atarijookie/cosmo2ex/ce_pico_fdd/readme.md

# CosmosEx pico - floppy drive version

- Raspberry Pi Pico 2 W, network over WiFi
- core 1 streams the floppy data (MFM) to the Atari and captures the written sectors, core 0 does WiFi / host
  communication - the WiFi chip and lwIP run in the background (IRQ) on core 0, core 1 is free for the floppy

## Compiling under Linux

- from the repo root: `firmware/build.sh ce_pico_fdd`, needs just docker - see firmware/README.md
- the result is firmware/out/ce_pico_fdd.uf2

## Compiling under Windows and Arduino env

- install https://github.com/earlephilhower/arduino-pico into Arduino boards via:
> Tools -> Board -> Boards Manager

(The firmware was developed using Raspberry Pi Pico Arduino core version 5.4.2)

- open ce_pico_fdd/ce_pico_fdd.ino

## Arduino env settings

(the Linux build uses the same settings, keep them in sync with FQBN_FDD in firmware/compile.sh)

- board: Raspberry Pi Pico 2W
- CPU architecture: ARM
- debug level: None
- debug port: Disabled (this is only for the debug of the arduino core; debug strings don't use it, see Notes)
- C++ exceptions: disabled
- flash size: 4MB (no FS)
- CPU speed: 150 MHz (the MFM stream and write capture dividers are calculated from the clock, so other speeds keep the timing)
- IP/Bluetooth stack: IPv4 Only
- optimize: Small (-Os) (standard)
- Operating system: None (with FreeRTOS lwIP would run in its own task, and the cores would be shared)
- Profiling: Disabled
- RTTI: Disabled
- Stack Protector: Disabled
- Upload method: Picoprobe/Debugprobe (CMSIS-DAP)
- USB stack: Pico SDK - not "No USB": the firmware doesn't use USB, but with "No USB" the WiFi connection to the host
  stalls (the host gets almost nothing from the device and drops it after 15 s of silence), cause not found yet
- WiFi region: Worldwide

## Front panel

- the display and buttons are on a separate front panel (ce_pico_display, RP2040-Zero), connected over UART on GP16
  (TX) / GP17 (RX) - see ce_pico_display/protocol.md; panel.cpp has the panel logic, panel_uart.cpp the PIO UART
- button on GP1 (to 3.3V through 1k, 4k7 pull-down - instead of the unused debug UART RX, the debug output on GP0
  stays): hold it for 1 s until it beeps and the LED goes light blue, then release it - the release starts the captive
  portal (WiFi setup), or leaves it without saving; a shorter press does nothing. A long press of enter on the front
  panel does the same right at the long press. Not while the portal is scanning the networks, it can't be left then
- browsing the images (image_browser.cpp): left / right on the front panel show the previous / next floppy image in the
  folder of the current one (wraps around at the ends), with its index (`< 123/3720 >`); enter inserts it, 15 s without
  a key goes back to the current image. Same list and order as the prev / next in the web UI: only .st / .msa / .stx, sorted
  case insensitive. The host (ce_cores/fdd/imagelist.cpp) sends the list in pages of 16 names, only after the device
  asks for it (with the panel attached), and sends the page again when images are added / deleted / renamed in the
  folder or the current image changes - the protocol is in image_browser.h. Not for the special images (no folder);
  without an image in the drive it browses FLOPPY_IMAGES_DIR (.env) - e.g. the images from
  atari-st-floppy-image-downloader.

## Built-in floppy

- until the first real image from the host is loaded completely (no WiFi settings yet, joining the WiFi, looking for /
  connecting to the host, loading the image, or the host has no image in the drive), the ST sees a built-in floppy:
  single sided 80 x 9, write protected (writes to it are dropped, never sent to the host)
- also again when the WiFi setup (captive portal) starts while the real image is shown - the host connection is closed
  for it anyway; after the setup the image is loaded again and the ST gets it as after the start
- its executable boot sector shows the device status on the ST, refreshed once a second, and keeps waiting for the
  real image until SPACE is pressed (other keys are ignored); while the WiFi setup runs, it tells how to open the setup
  page;
  A:\CE_FDD.TOS does the same when started from the desktop (e.g. when booting from a hard disk). Once the real image
  is loaded, they show 'The floppy image is ready. Reset your ST to boot from it.'
- the status is also a text file in the root, named after it: SETUP.TXT, NO_WIFI.TXT, WIFI.TXT, HOST.TXT, LOADING.TXT,
  NO_IMAGE.TXT - a disk change is signalled when the name changes, so the desktop shows the new one after Esc
- the boot code reads the status from track 0, sector 10 (outside of the file system, the BPB says 9 sectors per
  track): 'CE2XSTAT', status code, change counter, the text from offset 16
- the tracks are made on the device (builtin_image.cpp) into their own PSRAM area, so the real image is received into
  its usual area meanwhile and the switch happens only when it's complete; track 0 is made again on each status change
- it's made in setup(), before the main loop, which blocks for seconds while joining the WiFi - the ST reads the boot
  sector a few seconds after the power on; a disk change follows, so a ST that read the drive even earlier reads it again
- debug log: 'builtin floppy: ...' lines for the start, each status change and each new track 0; 'core 1: streaming the
  real image now' after the switch; BUILTIN in the floppy status line (FDD_STATUS_LOG)
- testing: BUILTIN_IMAGE_TEST 1 in defs.h shows all the statuses in a loop (sample values, 8 s each, then 8 s without the
  status sector) and never switches to the real image
- the disk content comes from builtin_floppy/: status.s (68000 code of the boot sector and CE_FDD.TOS) and
  make_builtin.py, which assembles it (m68k-atari-mint-as) and writes builtin_floppy_data.h (committed - Arduino can't
  run it) and builtin_floppy/builtin.st (the same disk with a sample status, for an emulator or mtools). Run
  `python3 builtin_floppy/make_builtin.py` after changing them

## Status LED (neopixel)

- LED2 (WS2812C-2020) on the same GP1 as the button, through the AND gate IC6 (74AHCT1G08, 3.3V -> 5V levels); the
  pin is the button input all the time and the PIO output only for the ~0.6 ms of a frame (neopixel_pio.cpp) - that
  works also while the button is held
- the same colors as ce_pico_hdd: orange during init, brighter with each step (setup, core 1 running, joining WiFi,
  looking for the host, connecting to it); green when connected with an image, dim white when connected without one;
  blue while the captive portal runs; light blue while the button is held long enough to release it
- red blinks on error, the count of blinks is the code, then a pause: 1 = PSRAM not working (halted), 2 = no WiFi
  settings and the WiFi setup failed to start (retried every 10 s), 3 = can't join the WiFi (keeps retrying)
- the color is sent only when it changes, on core 0 - nothing while it stays the same, so the floppy streaming
  (core 1) doesn't lose any cycles; after a button press it's sent once again, as the LED saw the press as a long H
- neopixel.cpp - the status and the colors (tested on the host)

## Beeper

- on GP27 (H = on), a buzzer with its own generator - the firmware only switches it on / off, it's on the FDD board
  (not on the front panel), so it works without a panel too
- a 100 us click on every head step (`BEEP_STEP_US` - started in the STEP ISR, only with the motor on, ended by a timer
  alarm on core 1, so a seek is a hum of separate clicks like a real drive, not one long tone), 50 ms when an image is loaded, 100 ms
  when the host connects, 200 ms on a long press of the button, 400 ms when the host is lost
- the click on head step can be switched off (`beepOnStep` in the settings, on by default): the checkbox on the WiFi
  setup page, or 'Beep on every floppy head step' on the floppy page of the web UI - see Device settings below
- beeper.cpp - core 1 owns the pin and ends all the beeps in its loop, core 0 only asks for them

## IKBD (keyboard + mouse)

- the board is in the keyboard -> ST path (SV1): KEYB_TX_ORIG (GP9, from the keyboard) and KEYB_TX (GP8, to the ST) on
  uart1, KEYB_RX (GP18, the ST's commands to the keyboard, only listened to) on a PIO receiver - all 7812 baud
- IKBD disabled, or no connection to the host: the uart IRQ passes the keyboard data straight to the ST (at most ~4 ms
  later), even while the main loop is busy (joining the WiFi, connecting)
- IKBD enabled (`ikbdEnabled` in the settings - on by default, the checkbox on the WiFi setup page, or on the IKBD page
  of the web UI - see Device settings below) and connected to the host's ikbd port: the keyboard data and the ST
  commands go to the host, tagged (0xBB / 0xAA, keep alive 0xEE once a second), what the host sends goes to the ST
- ikbd.cpp, the same protocol as ce_pico_hdd

## WiFi setup (captive portal)

- the FDD scans the WiFi networks, then starts an open AP `cosmo2ex` (192.168.42.1) - connect a phone or PC to it,
  the setup page opens by itself (every DNS name and URL leads to it), or open http://192.168.42.1
- the page has the WiFi name (with the scanned networks offered) and password; an empty password keeps the stored one
  for the same WiFi name, otherwise it means an open network; both max 31 chars, the password at least 8 (WPA2);
  and checkboxes for IKBD (keyboard and mouse via the host) and the beep on head step; with WiFi settings already stored, the page also has
  'Quit WiFi setup without saving' - back to normal operation with the stored settings
- Save stores them to EEPROM (the floppy streaming pauses for the flash write), then the FDD goes back to the normal
  mode and connects with them right away
- without a page request for 5 minutes, the portal ends with the old settings
- with no WiFi settings stored (first start), the portal starts by itself and stays - no timeout, and the long press
  doesn't leave it - until the settings are saved
- the Pico can't be an AP and a station at once - the host connection is down while the portal runs, core 1 keeps
  streaming the current image
- captive_portal.cpp - AP, DNS and web server (arduino-pico WiFi, DNSServer, WebServer); portal_form.cpp - the pages
  and the checks of the entered values (tested on the host)

## Device settings (IKBD, beep on step)

- stored on the device (EEPROM, `Settings_t` - the fields after `ikbdEnabled` get their defaults when stored by older
  firmware, see `SETTINGS_LAYOUT`), changed on the WiFi setup page or in the web UI
- the device reports them in every FW report (heartbeat, byte 12 of its data: DEV_SETTING_* flags), the host (ce_cores)
  stores them as FDD_IKBD_ENABLED / FDD_BEEP_ON_STEP in the device's settings - when they change on the device, and on
  connect (the device's settings are the truth then)
- the web UI writes those settings and asks the core to send them: ATN_DEVICE_SETTINGS (0x08) with the flags; changed
  while the device wasn't connected (FDD_SETTINGS_PENDING) - sent when it connects, the web UI wins then
- the device stores them only when they changed - the flash write pauses the floppy streaming for a moment

## LED color while running

- green by default, can be changed on the web Settings page (color + brightness) - global for all floppy devices
- the host sends it (ATN_LED_COLORS 0x09, R G B) after the FW report on each connect and when changed in the web UI
- stored in EEPROM (`Settings_t.ledRunning` + `ledCheck` - not matching on a new board / after older firmware: the
  default is used), only when it differs from the stored one

## Notes

- debug strings: debug() writes directly to uart0 on GP0 (TX0), 115200 baud. They're on by default, DEBUG_STRINGS 0 in
  defs.h turns them off. Once the 32 byte UART FIFO is full debug() waits (~87 us per char), so don't call it from IRQs
  or the floppy streaming
- crash / reset diagnostics (diag.cpp) on the same UART: at boot the boot count since power on and the reset reasons;
  on a hard fault (also a panic() without a debugger) the core, pc / lr and the fault status, then that core stops -
  find the pc in the .elf of the same build, e.g. arm-none-eabi-addr2line -f -C -e ce_pico_fdd.ino.elf <pc>
- the PIO headers (mfm_write.pio.h, neopixel.pio.h, uart_rx.pio.h) are generated by pioasm and committed, arduino
  doesn't run pioasm - after changing a .pio file, regenerate them with `firmware/pioasm.sh ce_pico_fdd`
- settings are stored with the EEPROM library (flash sector before the last one)
- connecting to WiFi and to the host blocks the core 0 main loop for a few seconds at most - core 1 (floppy) is not affected

## License

Open design, non-commercial license - see the License section of the [main README](../README.md#license).
