atarijookie/cosmo2ex/ce_pico_hdd/readme.md

# CosmosEx pico - HDD version (ACSI or SCSI)

- for the merged board devices/v40_pico_hdd - one PCB, assembled either as ACSI or as SCSI variant
- one firmware for both: on boot it reads the variant strap on GP26 (R125 pull-up = ACSI, R225 pull-down = SCSI)
- based on W6100-EVB-Pico (to simplify soldering)
- the older v40 boards (devices/v40_pico_acsi, devices/v40_pico_scsi) have a different pinout, they need ce_pico_hdd_acsi / ce_pico_hdd_scsi

## Status LED (neopixel)

- orange - initializing, brighter with each step: setup started, bus handling running, waiting for ethernet link + DHCP, got IP, looking for / connecting to host
- green (ACSI) / blue (SCSI) - connected to host, the color shows which variant the board runs
  - both colors (and brightness) can be changed on the web Settings page - global for all devices. The host sends them
    (CMD_LED_COLORS, ACSI R G B + SCSI R G B) after the ACSI config on each connect and when changed; the device stores
    them in EEPROM (TSettings.ledAcsi / ledScsi, own check byte - garbage = defaults) only when they differ
- red blinks - error, the count of blinks is the error code, then a longer pause:
  - 1 - ethernet chip not found (halted)
  - 2 - ethernet cable not connected (keeps retrying)
  - 3 - no IP from DHCP (keeps retrying)
  - 4 - PIO setup failed (halted)

The LED gets updated only between commands, when its color changes. ACSI sends the data on GP9
(IC6 gate held open by R151). SCSI sends it on OUT_LE1 (IC6.A) with OUT_LE2 (IC6.B) as the gate - the firmware never has both
H except for the LED update, so the bus activity doesn't get to the LED. On SCSI the device ignores the bus until it's
connected to the host (the Atari doesn't see the drive till then).

## Network for STinG

`sting_net.cpp` answers the HOSTMOD 7 (`HOSTMOD_RAW_NET`) ACSI / SCSI commands of the STinG driver `CE_ETH.STX` itself,
without the host. It sends / receives raw ethernet frames on W6100 socket 0 (MACRAW), with its own MAC address for STinG,
and does ARP for it. The other sockets (HDD, IKBD, UDP) keep working as before. Protocol and details: [ce_sting_stx_driver/README.md](../ce_sting_stx_driver/README.md).

The MiNTnet driver [CE_ETH.XIF](../ce_mintnet_xif_driver/README.md) uses the same commands in frame mode: whole ethernet frames, ARP is done by MiNT.

## Compiling under Linux

- from the repo root: `make firmware` (or `firmware/build.sh ce_pico_hdd`), needs just docker - see firmware/README.md
- the result is firmware/out/ce_pico_hdd.uf2

## Compiling under Windows and Arduino env

- install https://github.com/earlephilhower/arduino-pico into Arduino boards via:
> Tools -> Board -> Boards Manager

(The firmware was developed using Raspberry Pi Pico Arduino core version 5.4.2)

- symlink the (patched) Ethernet library from third_party/Ethernet into Arduino libraries dir:

> mklink /D "C:\Users\jookie\Documents\Arduino\libraries\Ethernet" "C:\!miro\hobby\github\cosmo2ex\third_party\Ethernet"

## Arduino env settings

(the Linux build uses the same settings, keep them in sync with FQBN in firmware/compile.sh)

- board: Raspberry Pi Pico
- debug level: None
- debug port: disabled
- C++ exceptions: disabled
- flash size: 2MB (no FS)
- CPU speed: 133 MHz
- IP/Bluetooth stack: IPv4 only
- optimize: Small (-Os)
- Operating system: None
- Profiling: Disabled
- RTTI: Disabled
- Stack protection: Disabled
- Upload method: Picoprobe / Debugprobe (CMSIS-DAP)
- USB stack: No USB

## License

Open design, non-commercial license - see the License section of the [main README](../README.md#license).
