atarijookie/cosmo2ex/devices/v40_pico_fdd/fdd_case.stp

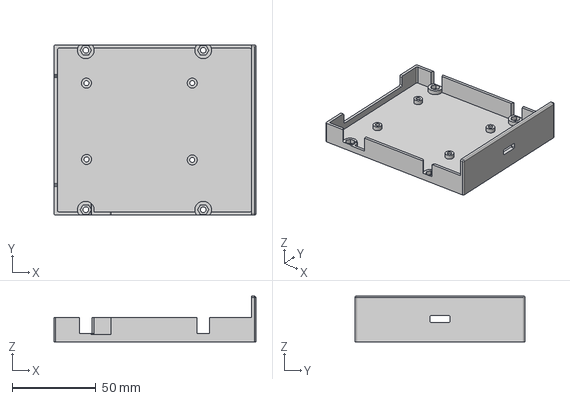
[picture p1: CAD file, 2026-11-12]
devices/v40_pico_fdd/fdd_case.stp
120.5 x 101.6 x 27.4 mm
