atarijookie/cosmo2ex/devices/v40_pico_hdd/hdd_case.stp

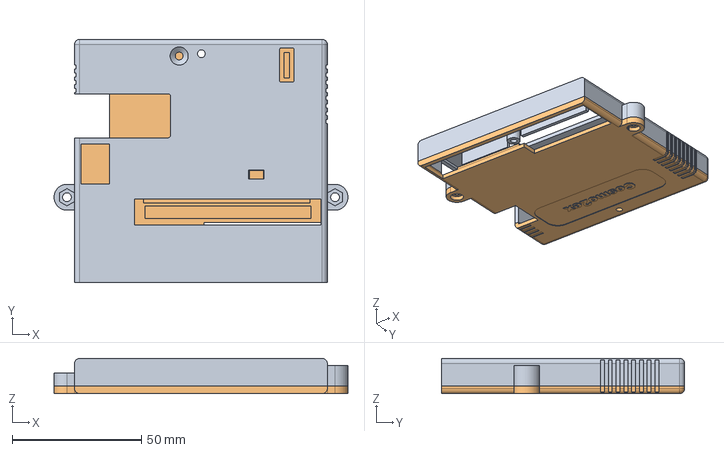
[picture p2: CAD file, 2026-11-12]
devices/v40_pico_hdd/hdd_case.stp
113.6 x 94.0 x 13.6 mm
