atarijookie/cosmo2ex/devices/v40_pico_hdd/hdd_case_back.stl

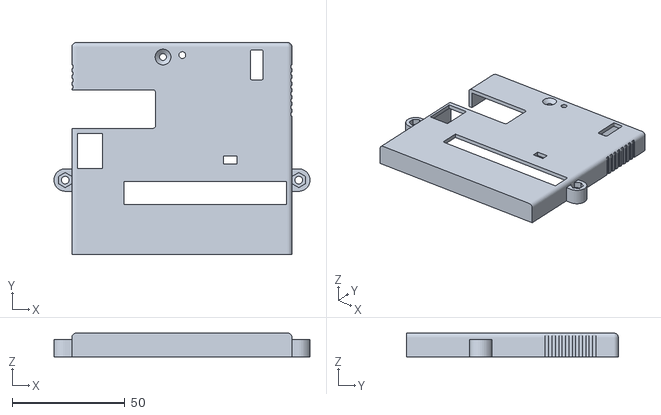
[picture p3: CAD file, 2026-11-12]
devices/v40_pico_hdd/hdd_case_back.stl
113.6 x 94.0 x 10.6
