atarijookie/cosmo2ex/devices/v40_pico_hdd/hdd_case_front.stl

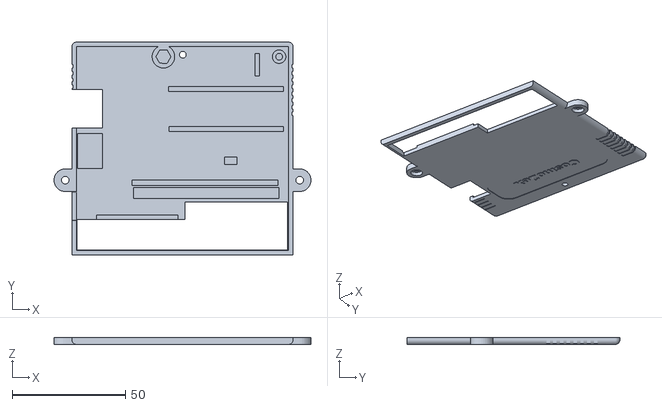
[picture p4: CAD file, 2026-11-12]
devices/v40_pico_hdd/hdd_case_front.stl
113.6 x 94.0 x 3.00
