atarijookie/cosmo2ex/(list of files, cad)

Other CAD files:
devices/v40_pico_fdd/fdd_case.f3d
devices/v40_pico_fdd/fdd_case.stl
devices/v40_pico_hdd/hdd_case.f3d
