atarijookie/cosmo2ex/devices/pico_display_hub75/rp2040zero_display_encoder.brd

## EAGLE design devices/pico_display_hub75/rp2040zero_display_encoder.brd (2026-11-10)

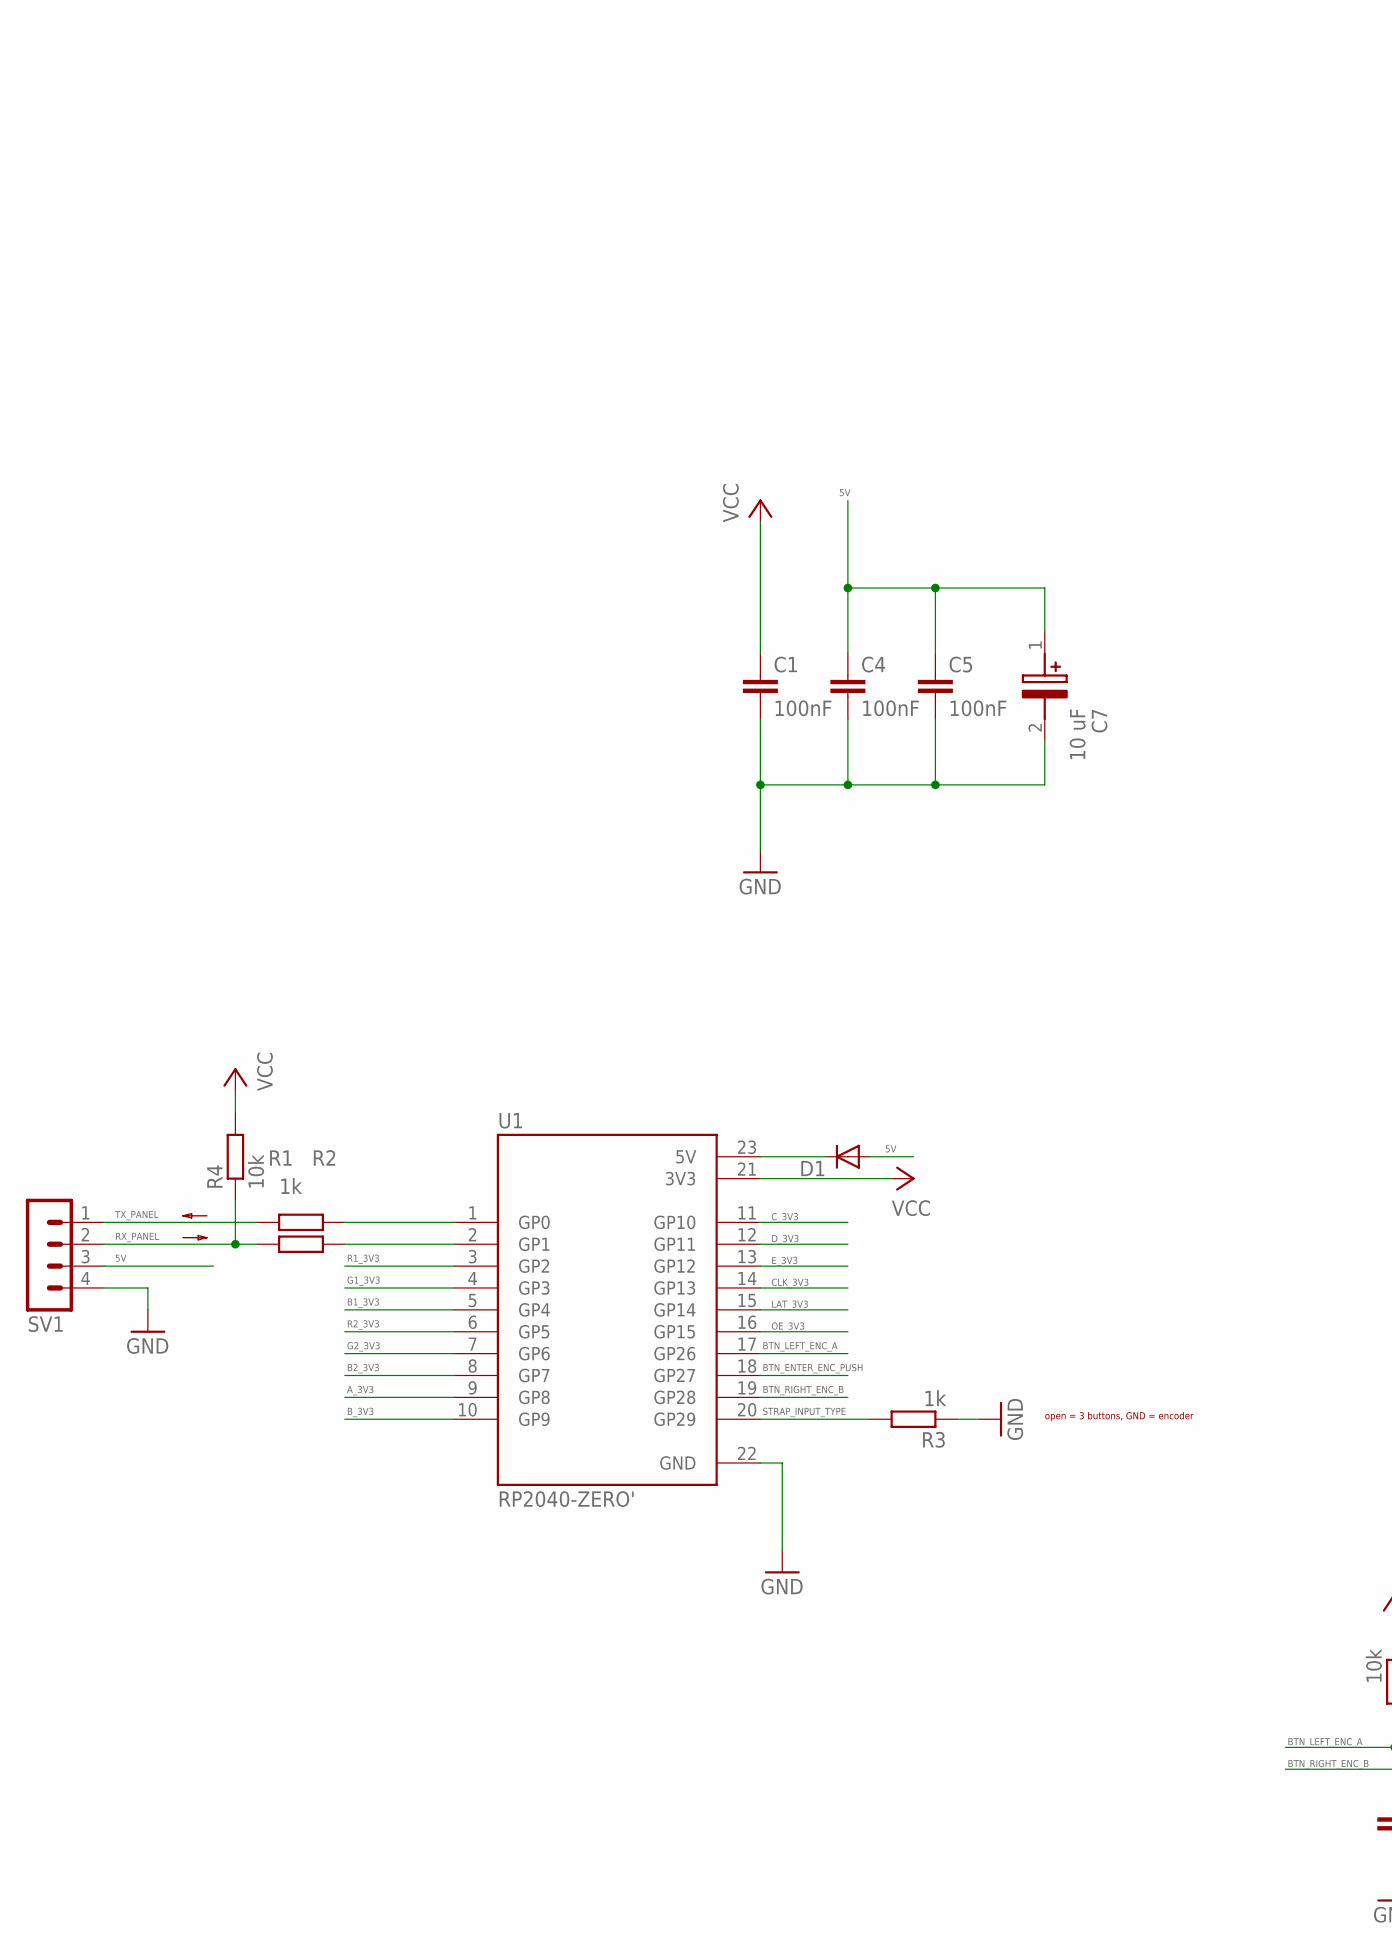
[picture p5: schematic rp2040zero_display_encoder.sch, part in row 1, column 1]

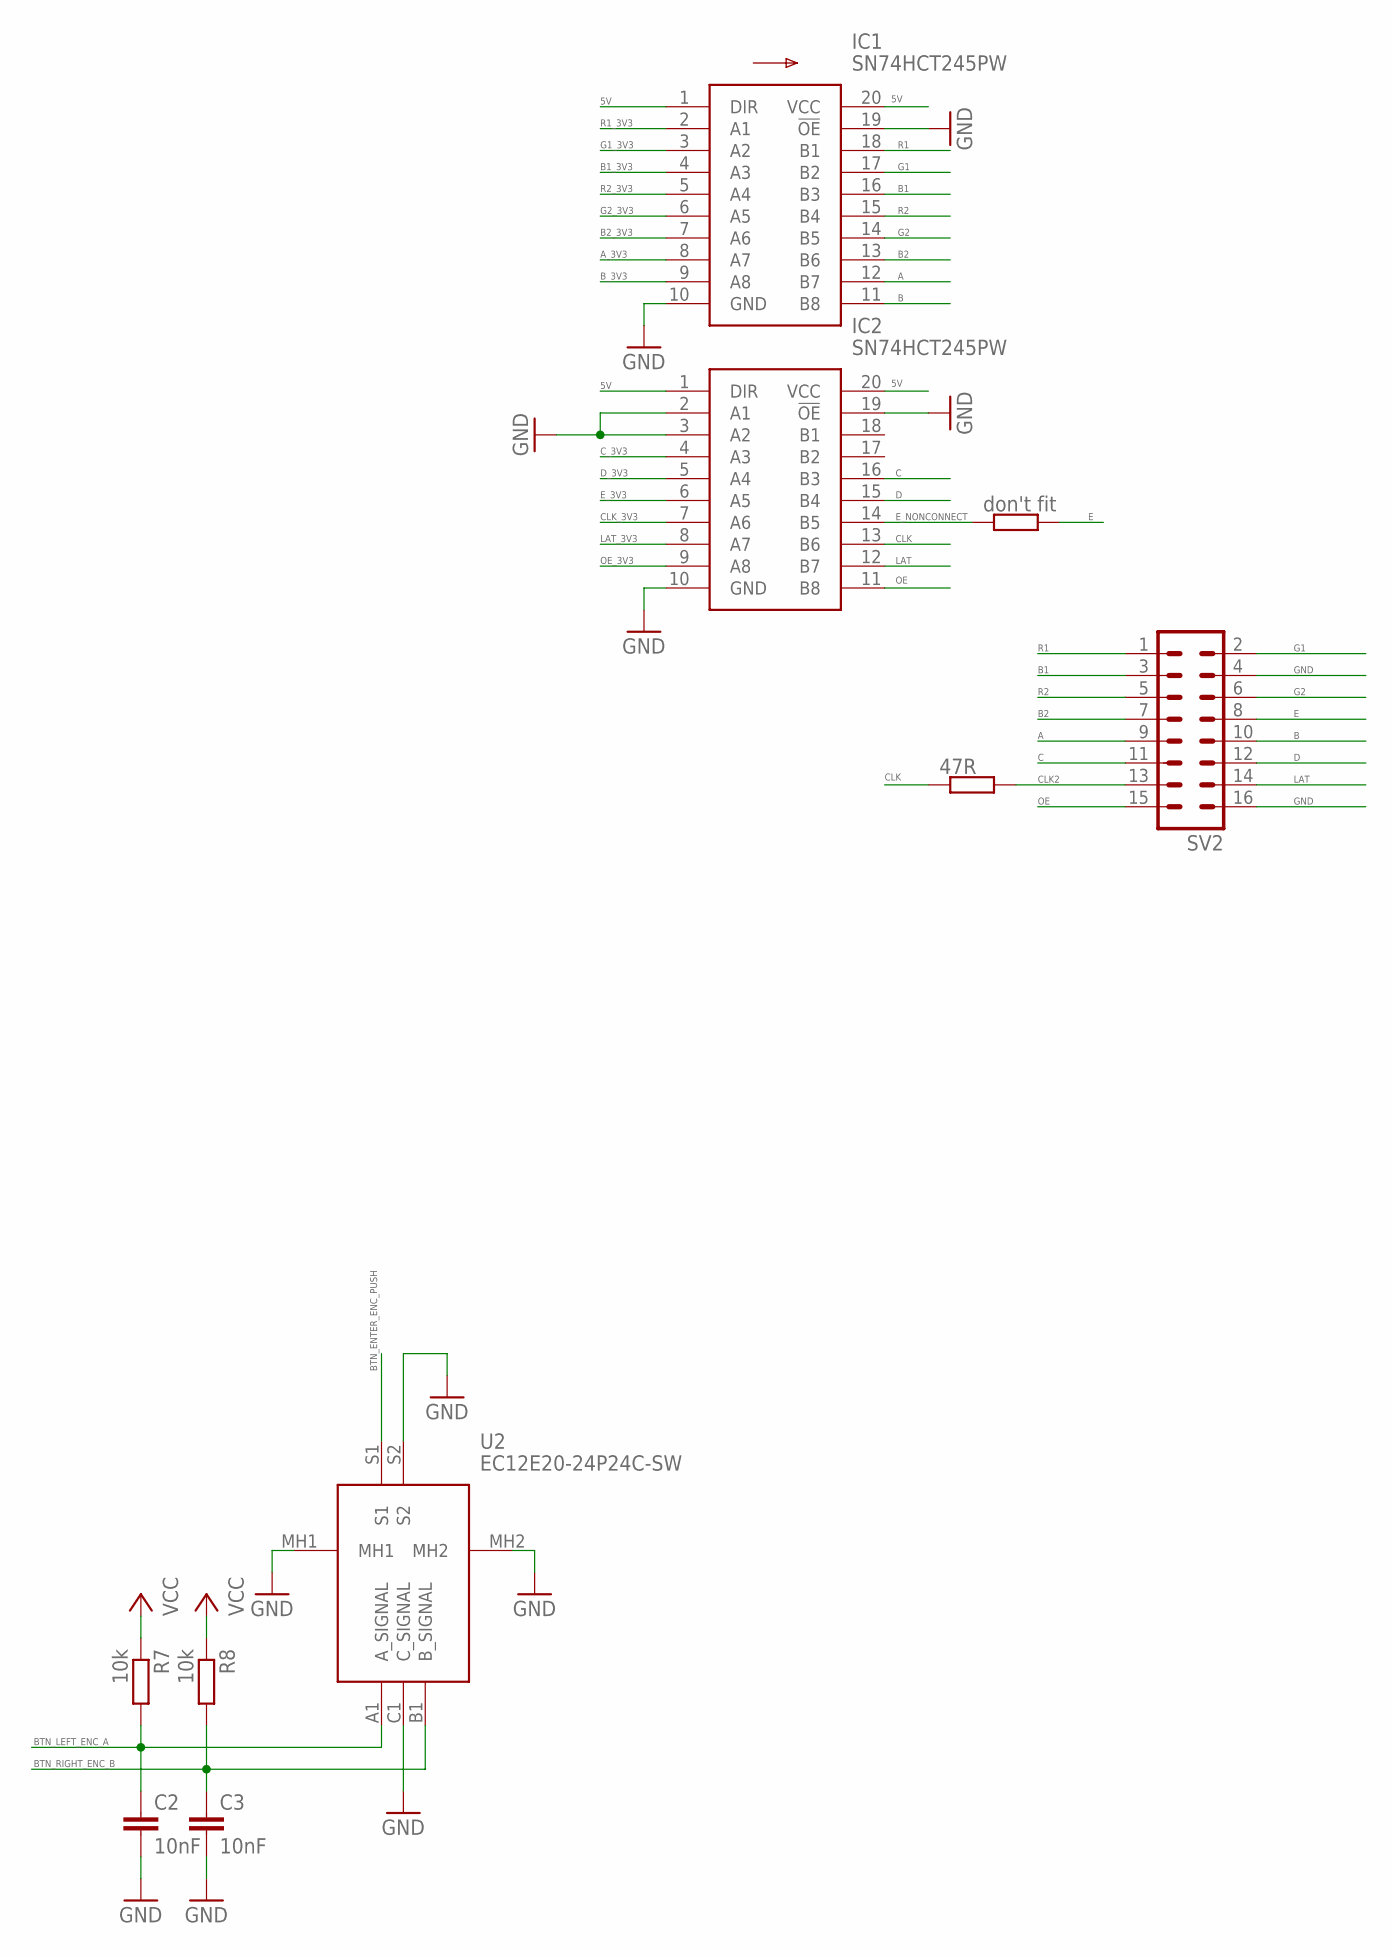
[picture p6: schematic rp2040zero_display_encoder.sch, part in row 1, column 2]

Parts:
C1, C4, C5: 100nF; C0603
C2, C3: 10nF; C0603
C7: 10 uF; CAPPM3528X210N
D1: SK110-DIO; DO214AC
IC1, IC2: SN74HCT245PW; SOP65P640X120-20N
R1, R2, R3: 1k; R0603
R4, R7, R8: 10k; R0603
R5: don't fit; R0603
R6: 47R; R0603
SV1: MA04-1
SV2: ML16
U1: RP2040-ZERO'; MODULE_RP2040-ZERO
U2: EC12E20-24P24C-SW; EC12E2024P24CSW

Connections:
5V: C4.1, C5.1, C7.1 (+), D1.A, IC1.1 (DIR), IC1.20 (VCC), IC2.1 (DIR), IC2.20 (VCC), SV1.3
A: IC1.12 (B7), SV2.9
A_3V3: IC1.8 (A7), U1.9 (GP8)
B: IC1.11 (B8), SV2.10
B1: IC1.16 (B3), SV2.3
B1_3V3: IC1.4 (A3), U1.5 (GP4)
B2: IC1.13 (B6), SV2.7
B2_3V3: IC1.7 (A6), U1.8 (GP7)
BTN_ENTER_ENC_PUSH: U1.18 (GP27), U2.S1
BTN_LEFT_ENC_A: C2.1, R7.2, U1.17 (GP26), U2.A1 (A_SIGNAL)
BTN_RIGHT_ENC_B: C3.1, R8.2, U1.19 (GP28), U2.B1 (B_SIGNAL)
B_3V3: IC1.9 (A8), U1.10 (GP9)
C: IC2.16 (B3), SV2.11
CLK: IC2.13 (B6), R6.1
CLK2: R6.2, SV2.13
CLK_3V3: IC2.7 (A6), U1.14 (GP13)
C_3V3: IC2.4 (A3), U1.11 (GP10)
D: IC2.15 (B4), SV2.12
D_3V3: IC2.5 (A4), U1.12 (GP11)
E: R5.2, SV2.8
E_3V3: IC2.6 (A5), U1.13 (GP12)
E_NONCONNECT: IC2.14 (B5), R5.1
G1: IC1.17 (B2), SV2.2
G1_3V3: IC1.3 (A2), U1.4 (GP3)
G2: IC1.14 (B5), SV2.6
G2_3V3: IC1.6 (A5), U1.7 (GP6)
GND: C1.2, C2.2, C3.2, C4.2, C5.2, C7.2 (-), IC1.10 (GND), IC1.19 (!OE), IC2.2 (A1), IC2.3 (A2), IC2.10 (GND), IC2.19 (!OE), R3.1, SV1.4, SV2.4, SV2.16, U1.22 (GND), U2.C1 (C_SIGNAL), U2.MH1, U2.MH2, U2.S2
LAT: IC2.12 (B7), SV2.14
LAT_3V3: IC2.8 (A7), U1.15 (GP14)
unnamed: R1.2, U1.1 (GP0)
unnamed: R2.2, U1.2 (GP1)
unnamed: D1.C, U1.23 (5V)
OE: IC2.11 (B8), SV2.15
OE_3V3: IC2.9 (A8), U1.16 (GP15)
R1: IC1.18 (B1), SV2.1
R1_3V3: IC1.2 (A1), U1.3 (GP2)
R2: IC1.15 (B4), SV2.5
R2_3V3: IC1.5 (A4), U1.6 (GP5)
RX_PANEL: R2.1, R4.1, SV1.2
STRAP_INPUT_TYPE: R3.2, U1.20 (GP29)
TX_PANEL: R1.1, SV1.1
VCC: C1.1, R4.2, R7.1, R8.1, U1.21 (3V3)

Notes on the sheet:
open = 3 buttons, GND = encoder

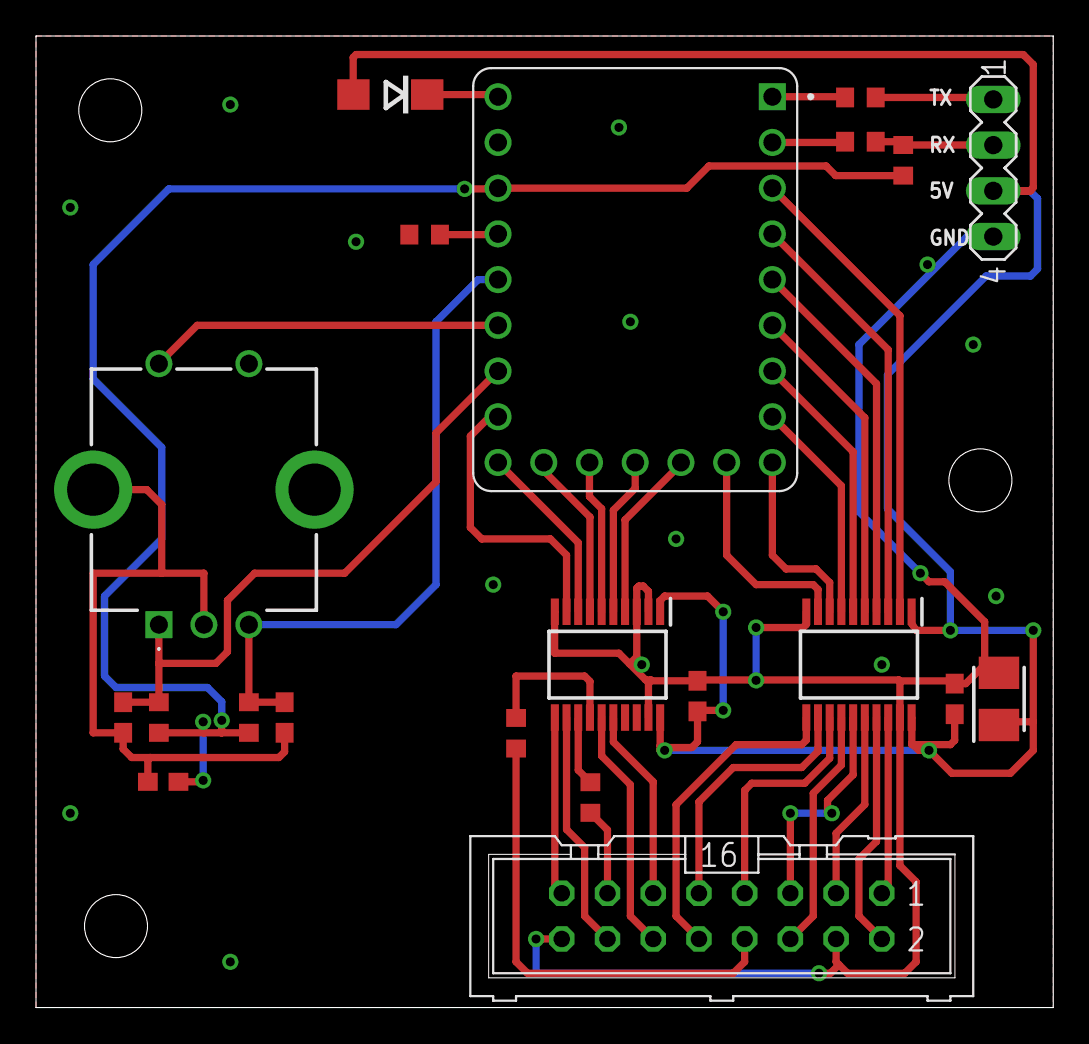
[picture p7: board rp2040zero_display_encoder.brd from above]

Board: 2 copper layers, 56.5 x 54.0 mm, 21 parts (0 on the bottom side), 42 nets.
