atarijookie/cosmo2ex/devices/v40_pico_hdd/ce_hdd_v40.brd

## EAGLE design devices/v40_pico_hdd/ce_hdd_v40.brd (2026-10-31)

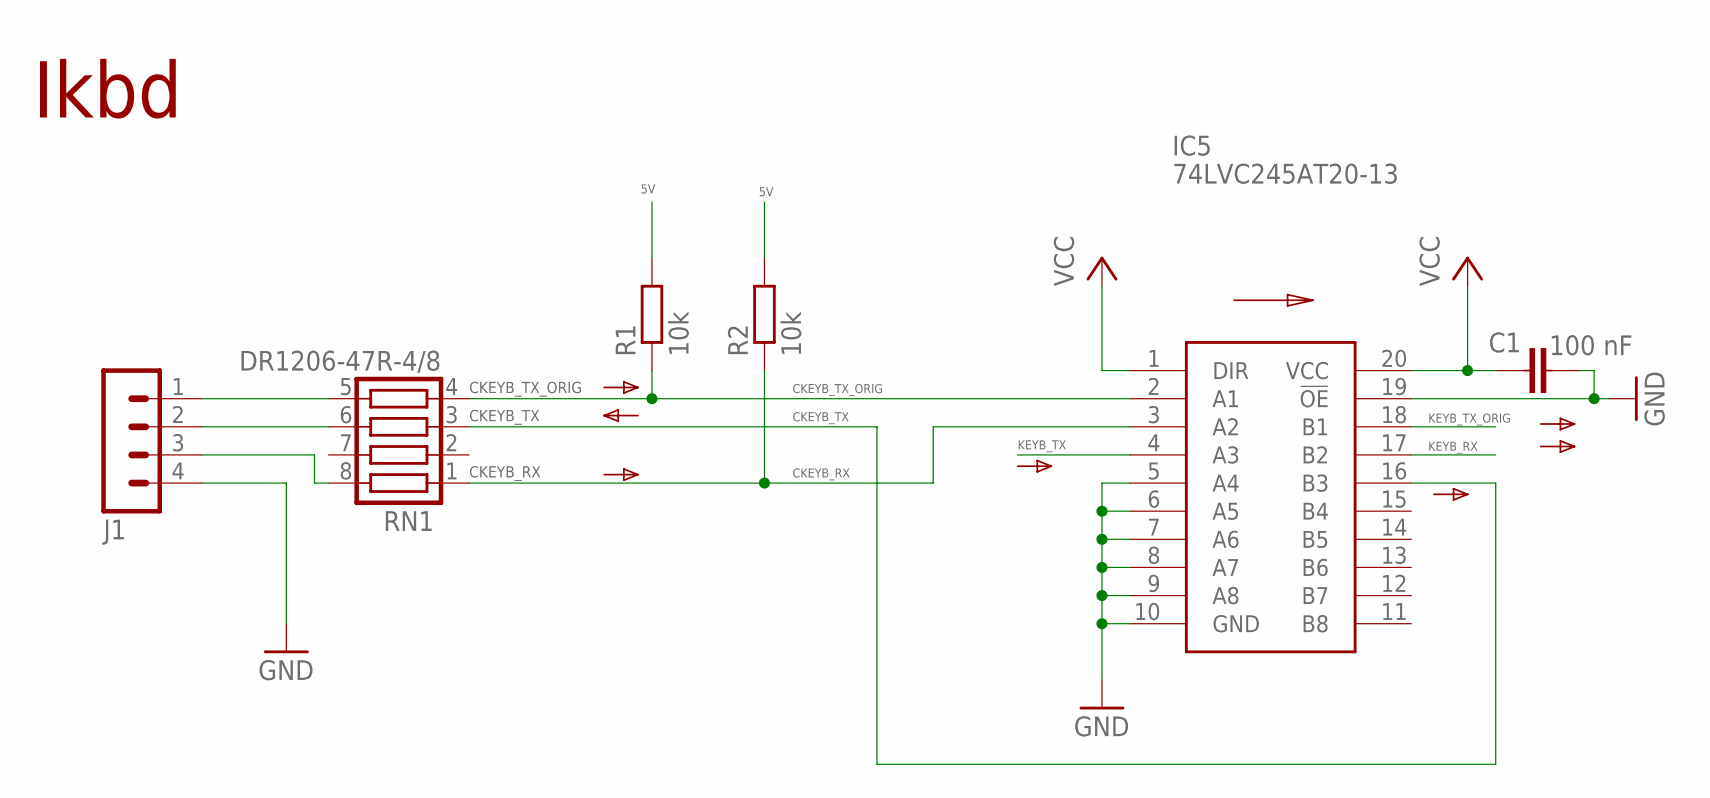
[picture p8: schematic ce_hdd_v40.sch, sheet 1, IKBD part]

Parts:
C1: 100 nF; C0603
IC5: 74LVC245AT20-13; SOP65P640X120-20N
J1: MA04-1
R1, R2: 10k; R0603
RN1: DR1206-47R-4/8; CTS742C083

Connections:
5V: R1.2, R2.2; also elsewhere on the board
CKEYB_RX: IC5.3 (A2), R2.1, RN1.1
CKEYB_TX: IC5.16 (B3), RN1.3
CKEYB_TX_ORIG: IC5.2 (A1), R1.1, RN1.4
GND: C1.1, IC5.5 (A4), IC5.6 (A5), IC5.7 (A6), IC5.8 (A7), IC5.9 (A8), IC5.10 (GND), IC5.19 (!OE), J1.4; also elsewhere on the board
KEYB_RX: IC5.17 (B2); also elsewhere on the board
KEYB_TX: IC5.4 (A3); also elsewhere on the board
KEYB_TX_ORIG: IC5.18 (B1); also elsewhere on the board
unnamed: J1.2, RN1.6
VCC: C1.2, IC5.1 (DIR), IC5.20 (VCC); also elsewhere on the board
ZKEYB_RX: J1.3, RN1.8
ZKEYB_TX_ORIG: J1.1, RN1.5

Notes on the sheet:
Ikbd

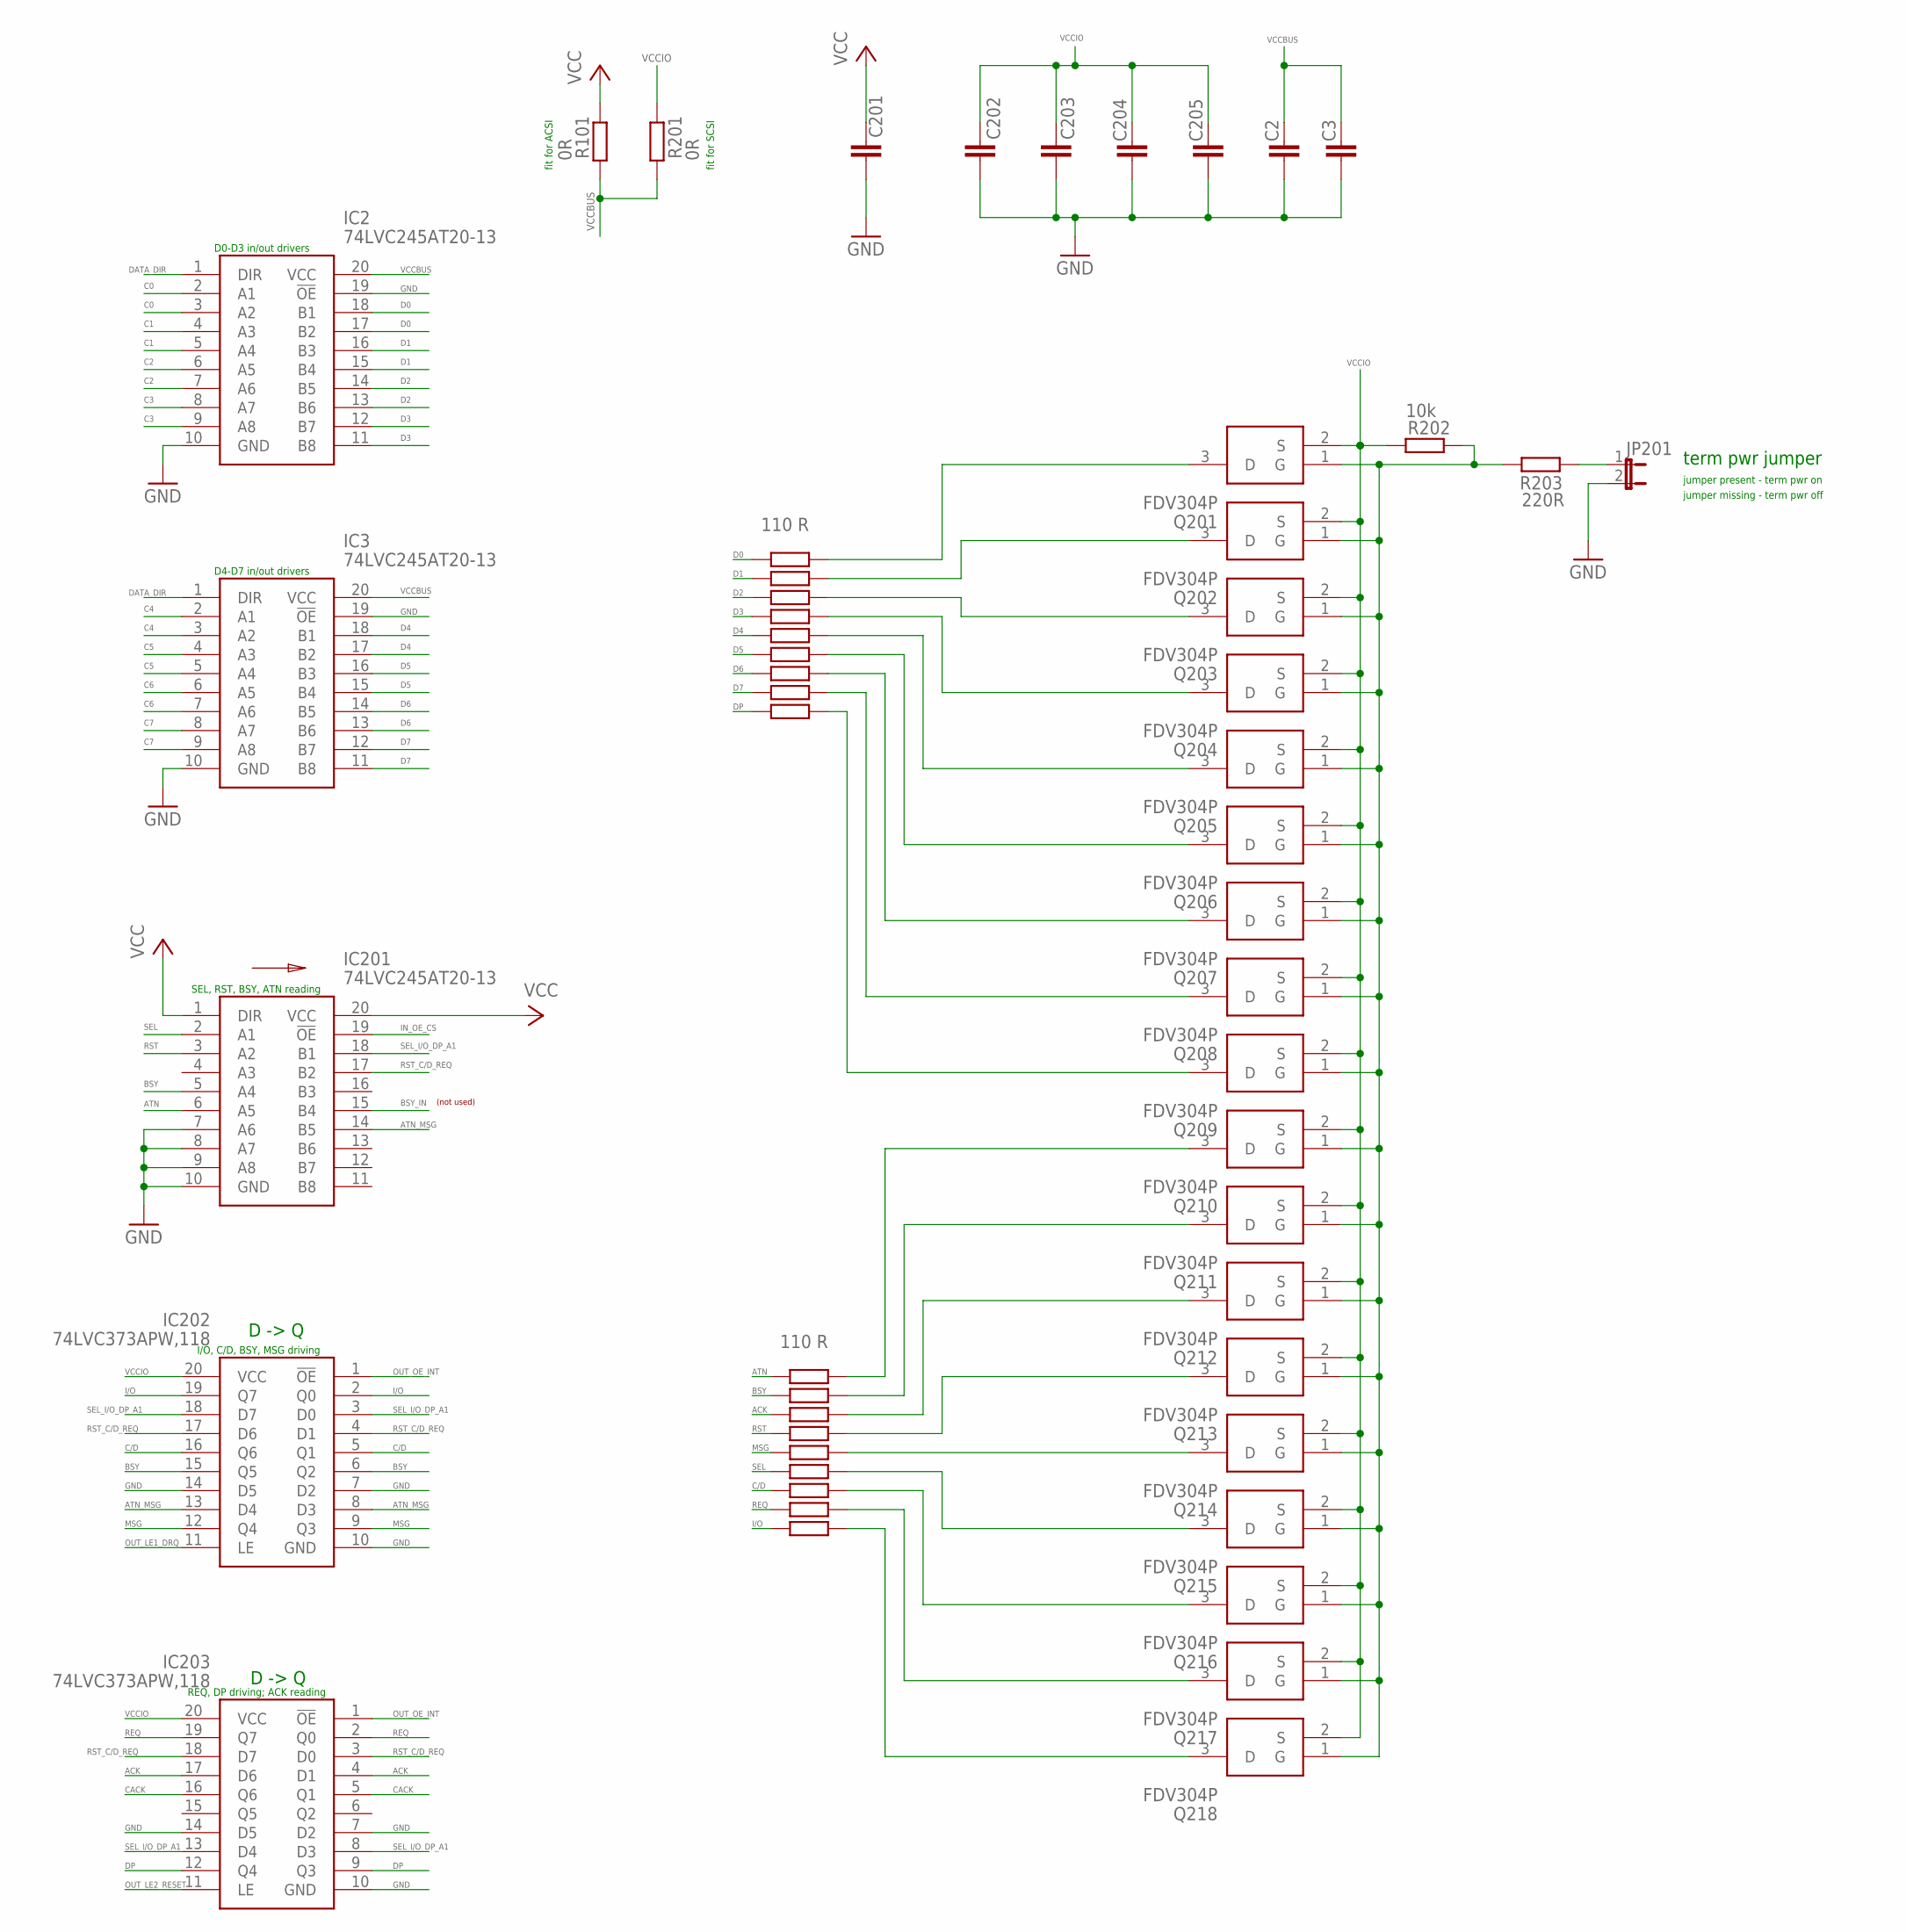
[picture p9: schematic ce_hdd_v40.sch, sheet 2, SCSI drivers and termination]

Parts:
C2, C3, C201, C202, C204, C205: 100 nF; C0603
C203: 1 uF; C0603
IC2, IC3, IC201: 74LVC245AT20-13; SOP65P640X120-20N
IC202, IC203: 74LVC373APW,118; SOP65P640X110-20N
JP201: JP1E; JP1
Q201, Q202, Q203, Q204, Q205, Q206, Q207, Q208, Q209, Q210, Q211, Q212, Q213, Q214, Q215, Q216, Q217, Q218: FDV304P; SOT95P237X112-3N
R101, R201: 0R; R0603
R202: 10k; R0603
R203: 220R; R0603
R204, R205, R206, R207, R208, R209, R210, R211, R212, R213, R214, R215, R216, R217, R218, R219, R220, R221: 110 R; R0603

Connections:
AAAA: Q201.3 (D), R204.1
ACK: IC203.4 (D1), IC203.17 (D6), R215.2; also elsewhere on the board
ATN: IC201.6 (A5), R213.2; also elsewhere on the board
ATN_MSG: IC201.14 (B5), IC202.8 (D3), IC202.13 (D4); also elsewhere on the board
BSY: IC201.5 (A4), IC202.6 (Q2), IC202.15 (Q5), R214.2; also elsewhere on the board
BSY_IN: IC201.15 (B4)
C0: IC2.2 (A1), IC2.3 (A2); also elsewhere on the board
C1: IC2.4 (A3), IC2.5 (A4); also elsewhere on the board
C2: IC2.6 (A5), IC2.7 (A6); also elsewhere on the board
C3: IC2.8 (A7), IC2.9 (A8); also elsewhere on the board
C4: IC3.2 (A1), IC3.3 (A2); also elsewhere on the board
C5: IC3.4 (A3), IC3.5 (A4); also elsewhere on the board
C6: IC3.6 (A5), IC3.7 (A6); also elsewhere on the board
C7: IC3.8 (A7), IC3.9 (A8); also elsewhere on the board
C/D: IC202.5 (Q1), IC202.16 (Q6), R219.2; also elsewhere on the board
CACK: IC203.5 (Q1), IC203.16 (Q6); also elsewhere on the board
D0: IC2.17 (B2), IC2.18 (B1), R204.2; also elsewhere on the board
D1: IC2.15 (B4), IC2.16 (B3), R205.2; also elsewhere on the board
D2: IC2.13 (B6), IC2.14 (B5), R206.2; also elsewhere on the board
D3: IC2.11 (B8), IC2.12 (B7), R207.2; also elsewhere on the board
D4: IC3.17 (B2), IC3.18 (B1), R208.2; also elsewhere on the board
D5: IC3.15 (B4), IC3.16 (B3), R209.2; also elsewhere on the board
D6: IC3.13 (B6), IC3.14 (B5), R210.2; also elsewhere on the board
D7: IC3.11 (B8), IC3.12 (B7), R211.2; also elsewhere on the board
DATA_DIR: IC2.1 (DIR), IC3.1 (DIR); also elsewhere on the board
DP: IC203.9 (Q3), IC203.12 (Q4), R212.2; also elsewhere on the board
GND: C2.2, C3.2, C201.2, C202.2, C203.2, C204.2, C205.2, IC2.10 (GND), IC2.19 (!OE), IC3.10 (GND), IC3.19 (!OE), IC201.7 (A6), IC201.8 (A7), IC201.9 (A8), IC201.10 (GND), IC202.7 (D2), IC202.10 (GND), IC202.14 (D5), IC203.7 (D2), IC203.10 (GND), IC203.14 (D5), JP201.2; also elsewhere on the board
I/O: IC202.2 (Q0), IC202.19 (Q7), R221.2; also elsewhere on the board
IN_OE_CS: IC201.19 (!OE); also elsewhere on the board
MSG: IC202.9 (Q3), IC202.12 (Q4), R217.2; also elsewhere on the board
unnamed: JP201.1, R203.2
unnamed: Q202.3 (D), R205.1
unnamed: Q203.3 (D), R206.1
unnamed: Q204.3 (D), R207.1
unnamed: Q205.3 (D), R208.1
unnamed: Q206.3 (D), R209.1
unnamed: Q207.3 (D), R210.1
unnamed: Q208.3 (D), R211.1
unnamed: Q209.3 (D), R212.1
unnamed: Q210.3 (D), R213.1
unnamed: Q211.3 (D), R214.1
unnamed: Q212.3 (D), R215.1
unnamed: Q213.3 (D), R216.1
unnamed: Q214.3 (D), R217.1
unnamed: Q215.3 (D), R218.1
unnamed: Q216.3 (D), R219.1
unnamed: Q217.3 (D), R220.1
unnamed: Q218.3 (D), R221.1
OUT_LE1_DRQ: IC202.11 (LE); also elsewhere on the board
OUT_LE2_RESET: IC203.11 (LE); also elsewhere on the board
OUT_OE_INT: IC202.1 (!OE), IC203.1 (!OE); also elsewhere on the board
REQ: IC203.2 (Q0), IC203.19 (Q7), R220.2; also elsewhere on the board
RST: IC201.3 (A2), R216.2; also elsewhere on the board
RST_C/D_REQ: IC201.17 (B2), IC202.4 (D1), IC202.17 (D6), IC203.3 (D0), IC203.18 (D7); also elsewhere on the board
SEL: IC201.2 (A1), R218.2; also elsewhere on the board
SEL_I/O_DP_A1: IC201.18 (B1), IC202.3 (D0), IC202.18 (D7), IC203.8 (D3), IC203.13 (D4); also elsewhere on the board
TP_ON: Q201.1 (G), Q202.1 (G), Q203.1 (G), Q204.1 (G), Q205.1 (G), Q206.1 (G), Q207.1 (G), Q208.1 (G), Q209.1 (G), Q210.1 (G), Q211.1 (G), Q212.1 (G), Q213.1 (G), Q214.1 (G), Q215.1 (G), Q216.1 (G), Q217.1 (G), Q218.1 (G), R202.2, R203.1
VCC: C201.1, IC201.1 (DIR), IC201.20 (VCC), R101.2; also elsewhere on the board
VCCBUS: C2.1, C3.1, IC2.20 (VCC), IC3.20 (VCC), R101.1, R201.1
VCCIO: C202.1, C203.1, C204.1, C205.1, IC202.20 (VCC), IC203.20 (VCC), Q201.2 (S), Q202.2 (S), Q203.2 (S), Q204.2 (S), Q205.2 (S), Q206.2 (S), Q207.2 (S), Q208.2 (S), Q209.2 (S), Q210.2 (S), Q211.2 (S), Q212.2 (S), Q213.2 (S), Q214.2 (S), Q215.2 (S), Q216.2 (S), Q217.2 (S), Q218.2 (S), R201.2, R202.1; also elsewhere on the board

Notes on the sheet:
D -> Q
term pwr jumper
jumper present - term pwr on
jumper missing - term pwr off
D0-D3 in/out drivers
D4-D7 in/out drivers
SEL, RST, BSY, ATN reading
I/O, C/D, BSY, MSG driving
REQ, DP driving; ACK reading
(not used)
fit for ACSI
fit for SCSI

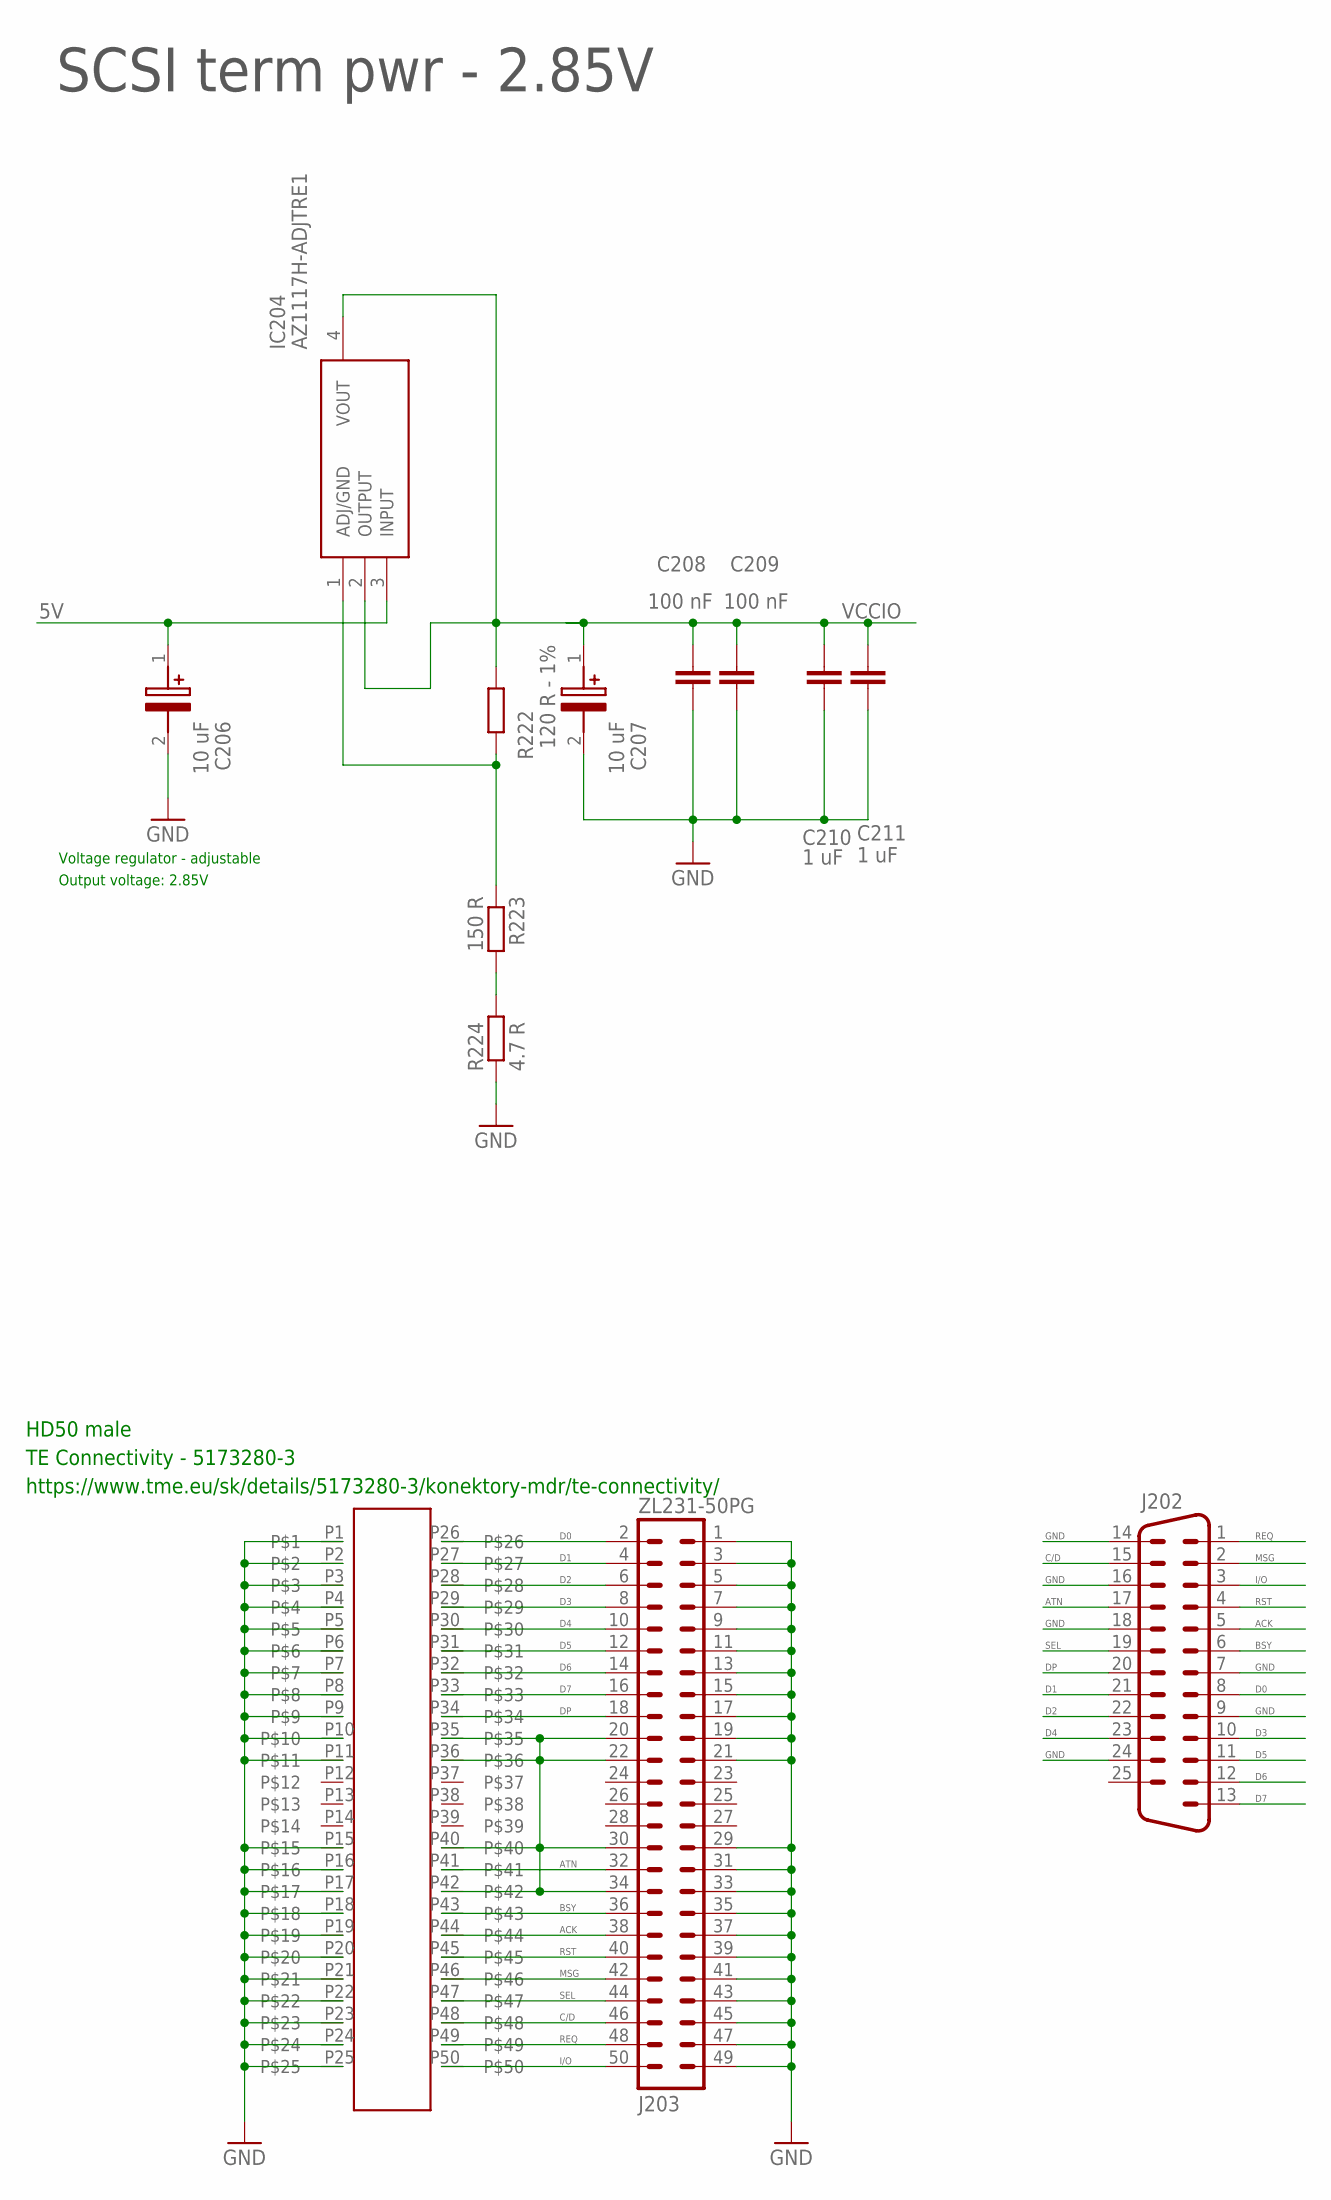
[picture p10: schematic ce_hdd_v40.sch, sheet 3, SCSI connectors]

Parts:
C206, C207: 10 uF; CAPPM3528X210N; MANUFACTURER_PART_NUMBER 293D106X9016B2TE3
C208, C209: 100 nF; C0603
C210, C211: 1 uF; C0603
IC204: AZ1117H-ADJTRE1; SOT230P700X185-4N
J201: TE Connectivity - 5173280-3; HD50_MALE
J202: M25V
J203: ZL231-50PG; ML50
R222: 120 R - 1%; R0603
R223: 150 R; R0603
R224: 4.7 R; R0603

Connections:
5V: C206.1 (+), IC204.3 (INPUT); also elsewhere on the board
ACK: J201.P44, J202.5, J203.38; also elsewhere on the board
ATN: J201.P41, J202.17, J203.32; also elsewhere on the board
BSY: J201.P43, J202.6, J203.36; also elsewhere on the board
C/D: J201.P48, J202.15, J203.46; also elsewhere on the board
D0: J201.P26, J202.8, J203.2; also elsewhere on the board
D1: J201.P27, J202.21, J203.4; also elsewhere on the board
D2: J201.P28, J202.22, J203.6; also elsewhere on the board
D3: J201.P29, J202.10, J203.8; also elsewhere on the board
D4: J201.P30, J202.23, J203.10; also elsewhere on the board
D5: J201.P31, J202.11, J203.12; also elsewhere on the board
D6: J201.P32, J202.12, J203.14; also elsewhere on the board
D7: J201.P33, J202.13, J203.16; also elsewhere on the board
DP: J201.P34, J202.20, J203.18; also elsewhere on the board
GND: C206.2 (-), C207.2 (-), C208.2, C209.2, C210.2, C211.2, J201.P1, J201.P2, J201.P3, J201.P4, J201.P5, J201.P6, J201.P7, J201.P8, J201.P9, J201.P10, J201.P11, J201.P15, J201.P16, J201.P17, J201.P18, J201.P19, J201.P20, J201.P21, J201.P22, J201.P23, J201.P24, J201.P25, J201.P35, J201.P36, J201.P40, J201.P42, J202.7, J202.9, J202.14, J202.16, J202.18, J202.24, J203.1, J203.3, J203.5, J203.7, J203.9, J203.11, J203.13, J203.15, J203.17, J203.19, J203.20, J203.21, J203.22, J203.29, J203.30, J203.31, J203.33, J203.34, J203.35, J203.37, J203.39, J203.41, J203.43, J203.45, J203.47, J203.49, R224.1; also elsewhere on the board
I/O: J201.P50, J202.3, J203.50; also elsewhere on the board
MSG: J201.P46, J202.2, J203.42; also elsewhere on the board
unnamed: R223.2, R224.2
unnamed: IC204.1 (ADJ/GND), R222.2, R223.1
REQ: J201.P49, J202.1, J203.48; also elsewhere on the board
RST: J201.P45, J202.4, J203.40; also elsewhere on the board
SEL: J201.P47, J202.19, J203.44; also elsewhere on the board
VCCIO: C207.1 (+), C208.1, C209.1, C210.1, C211.1, IC204.2 (OUTPUT), IC204.4 (VOUT), R222.1; also elsewhere on the board

Notes on the sheet:
Voltage regulator - adjustable
Output voltage: 2.85V
SCSI term pwr - 2.85V
HD50 male
TE Connectivity - 5173280-3
https://www.tme.eu/sk/details/5173280-3/konektory-mdr/te-connectivity/
