atarijookie/cosmo2ex/devices/v40_pico_hdd/ce_hdd_v40.brd

## EAGLE design devices/v40_pico_hdd/ce_hdd_v40.brd (continued)

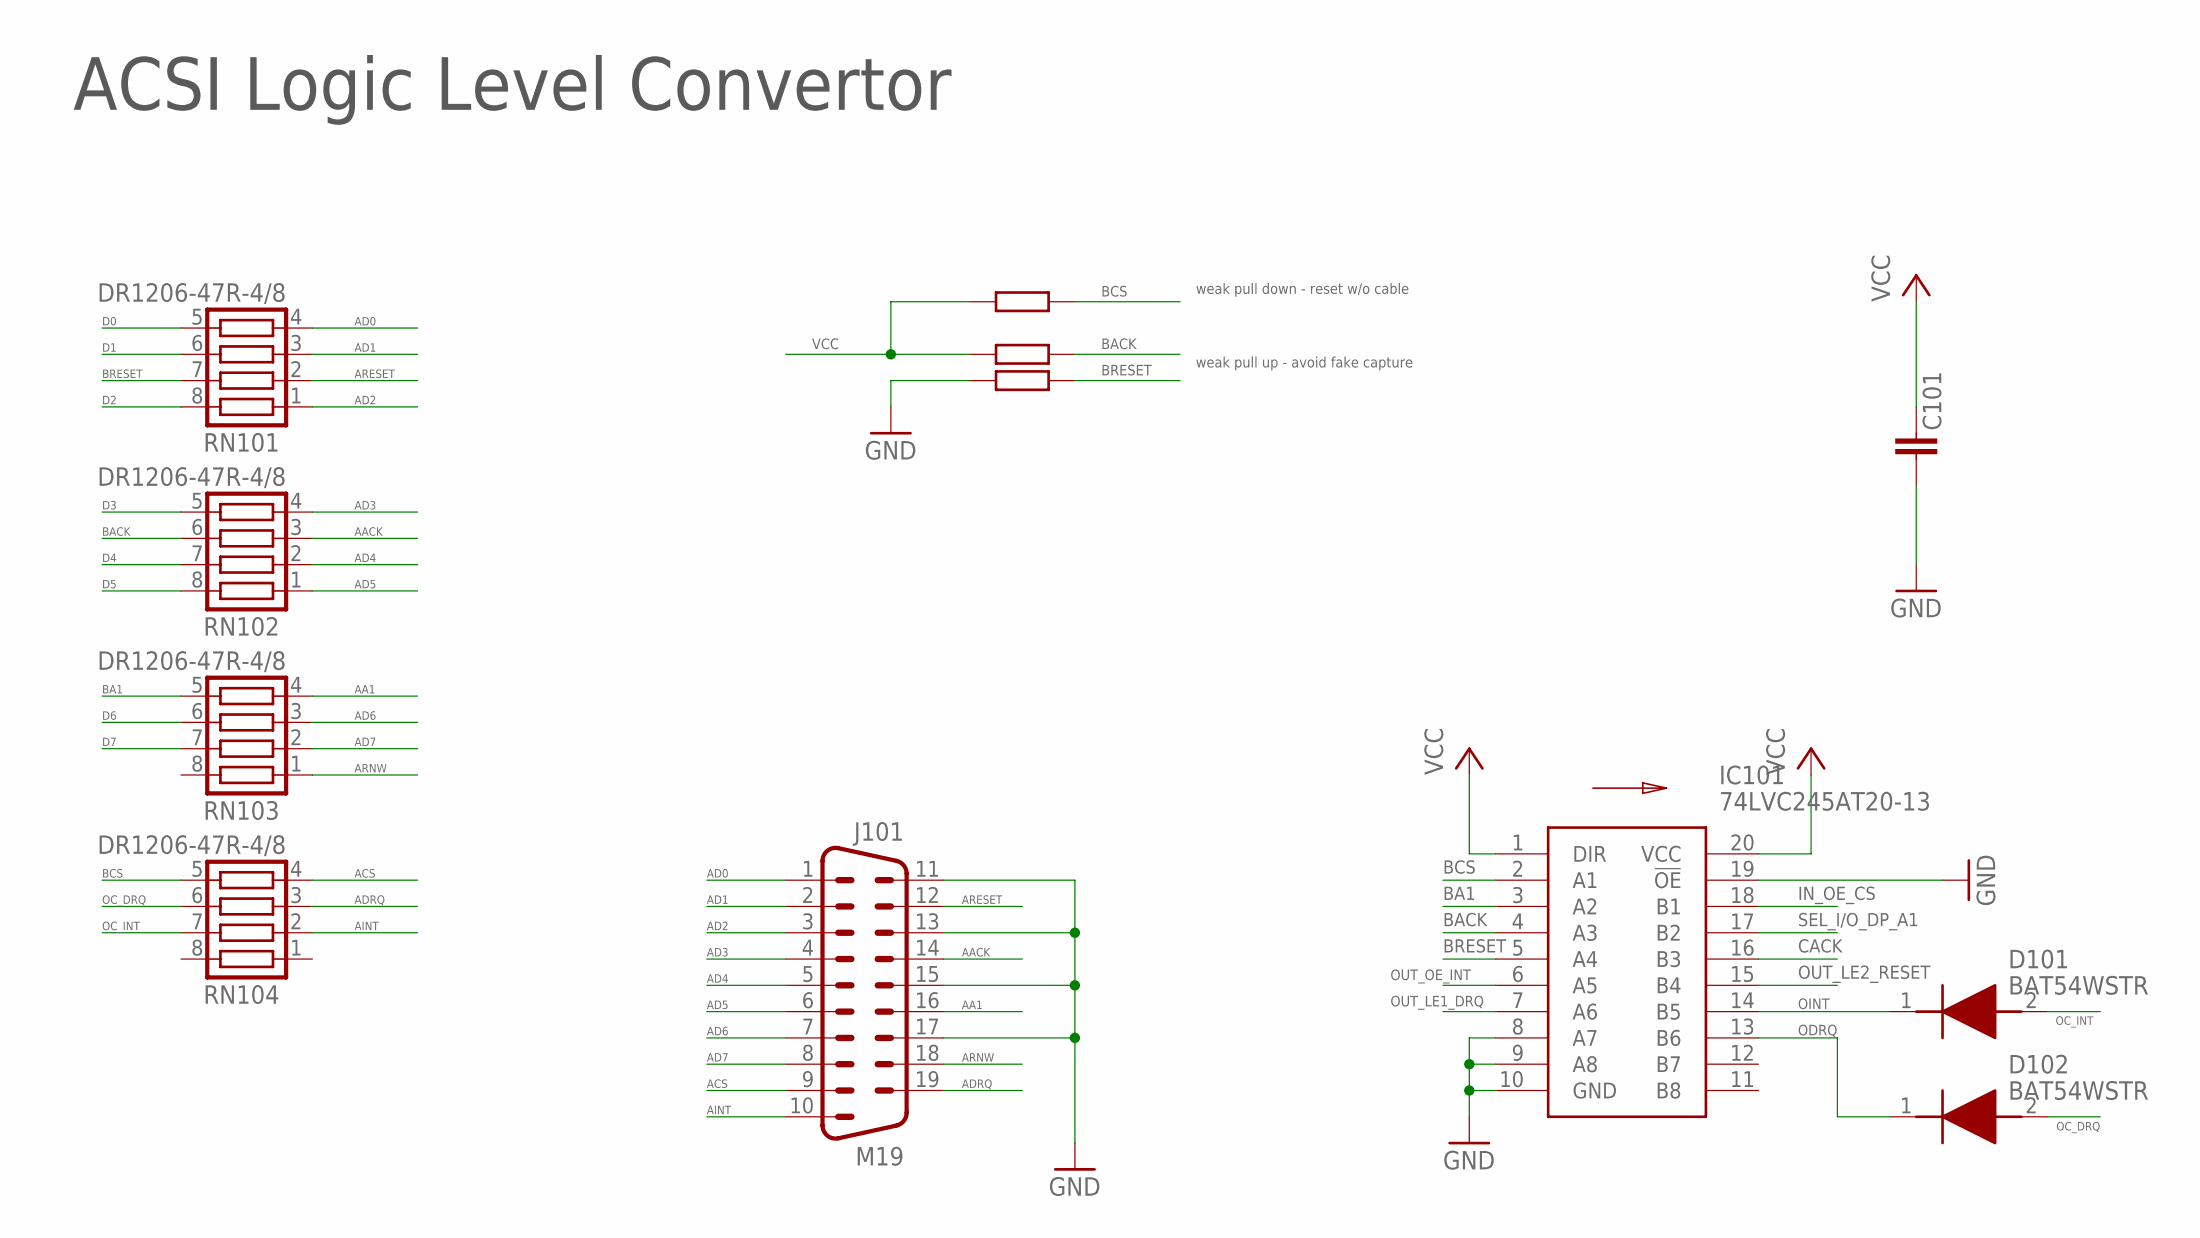
[picture p11: schematic ce_hdd_v40.sch, sheet 4, ACSI driver and connector]

Parts:
C101: 1 uF; C0603
D101: BAT54WSTR; SOD2613X100N
D102: BAT54WSTR; SOD2613X100N; MANUFACTURER_PART_NUMBER BAT54WSTR
IC101: 74LVC245AT20-13; SOP65P640X120-20N
J101: M19
R102, R103, R104: 10k; R0603
RN101, RN102, RN103, RN104: DR1206-47R-4/8; CTS742C083

Connections:
AA1: J101.16, RN103.4
AACK: J101.14, RN102.3
ACS: J101.9, RN104.4
AD0: J101.1, RN101.4
AD1: J101.2, RN101.3
AD2: J101.3, RN101.1
AD3: J101.4, RN102.4
AD4: J101.5, RN102.2
AD5: J101.6, RN102.1
AD6: J101.7, RN103.3
AD7: J101.8, RN103.2
ADRQ: J101.19, RN104.3
AINT: J101.10, RN104.2
ARESET: J101.12, RN101.2
ARNW: J101.18, RN103.1
BA1: IC101.3 (A2), RN103.5
BACK: IC101.4 (A3), R103.2, RN102.6
BCS: IC101.2 (A1), R102.2, RN104.5
BRESET: IC101.5 (A4), R104.2, RN101.7
CACK: IC101.16 (B3); also elsewhere on the board
D0: RN101.5; also elsewhere on the board
D1: RN101.6; also elsewhere on the board
D2: RN101.8; also elsewhere on the board
D3: RN102.5; also elsewhere on the board
D4: RN102.7; also elsewhere on the board
D5: RN102.8; also elsewhere on the board
D6: RN103.6; also elsewhere on the board
D7: RN103.7; also elsewhere on the board
GND: C101.2, IC101.8 (A7), IC101.9 (A8), IC101.10 (GND), IC101.19 (!OE), J101.11, J101.13, J101.15, J101.17, R104.1; also elsewhere on the board
IN_OE_CS: IC101.18 (B1); also elsewhere on the board
OC_DRQ: D102.2 (A), RN104.6
OC_INT: D101.2 (A), RN104.7
ODRQ: D102.1 (K), IC101.13 (B6)
OINT: D101.1 (K), IC101.14 (B5)
OUT_LE1_DRQ: IC101.7 (A6); also elsewhere on the board
OUT_LE2_RESET: IC101.15 (B4); also elsewhere on the board
OUT_OE_INT: IC101.6 (A5); also elsewhere on the board
SEL_I/O_DP_A1: IC101.17 (B2); also elsewhere on the board
VCC: C101.1, IC101.1 (DIR), IC101.20 (VCC), R102.1, R103.1; also elsewhere on the board

Notes on the sheet:
ACSI Logic Level Convertor
weak pull down - reset w/o cable
weak pull up - avoid fake capture

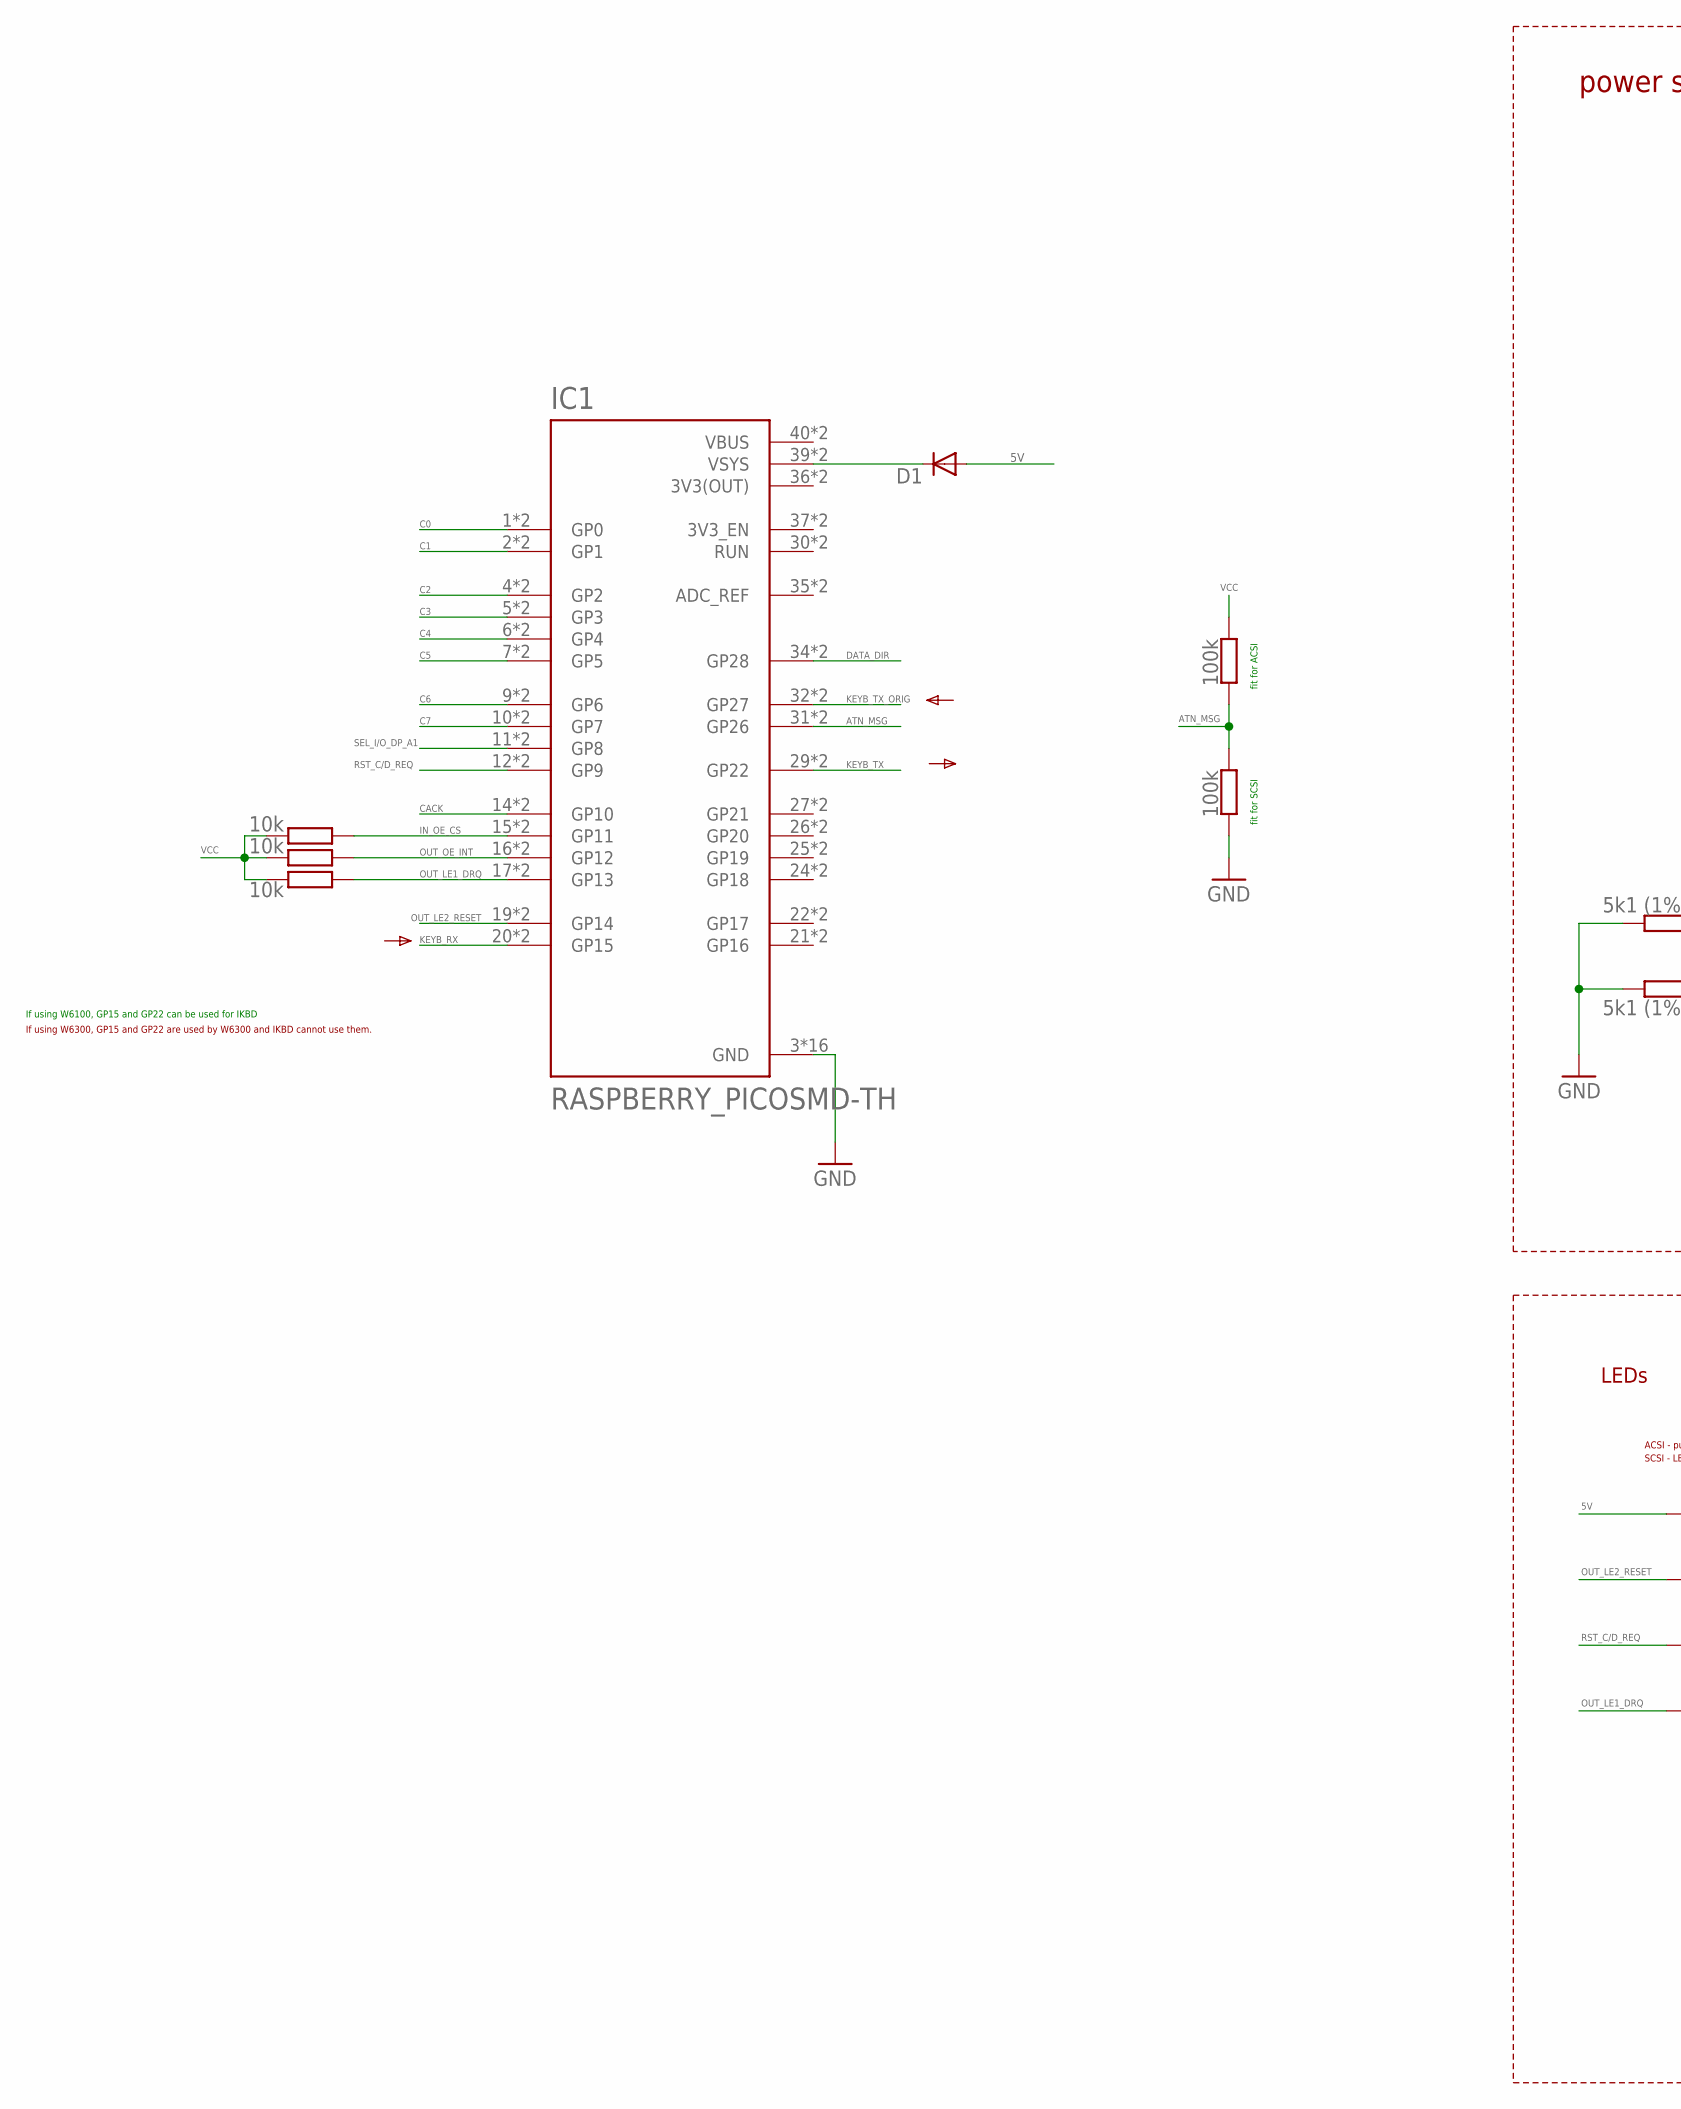
[picture p12: schematic ce_hdd_v40.sch, sheet 5, PICO, power, LEDs, part in row 1, column 1]

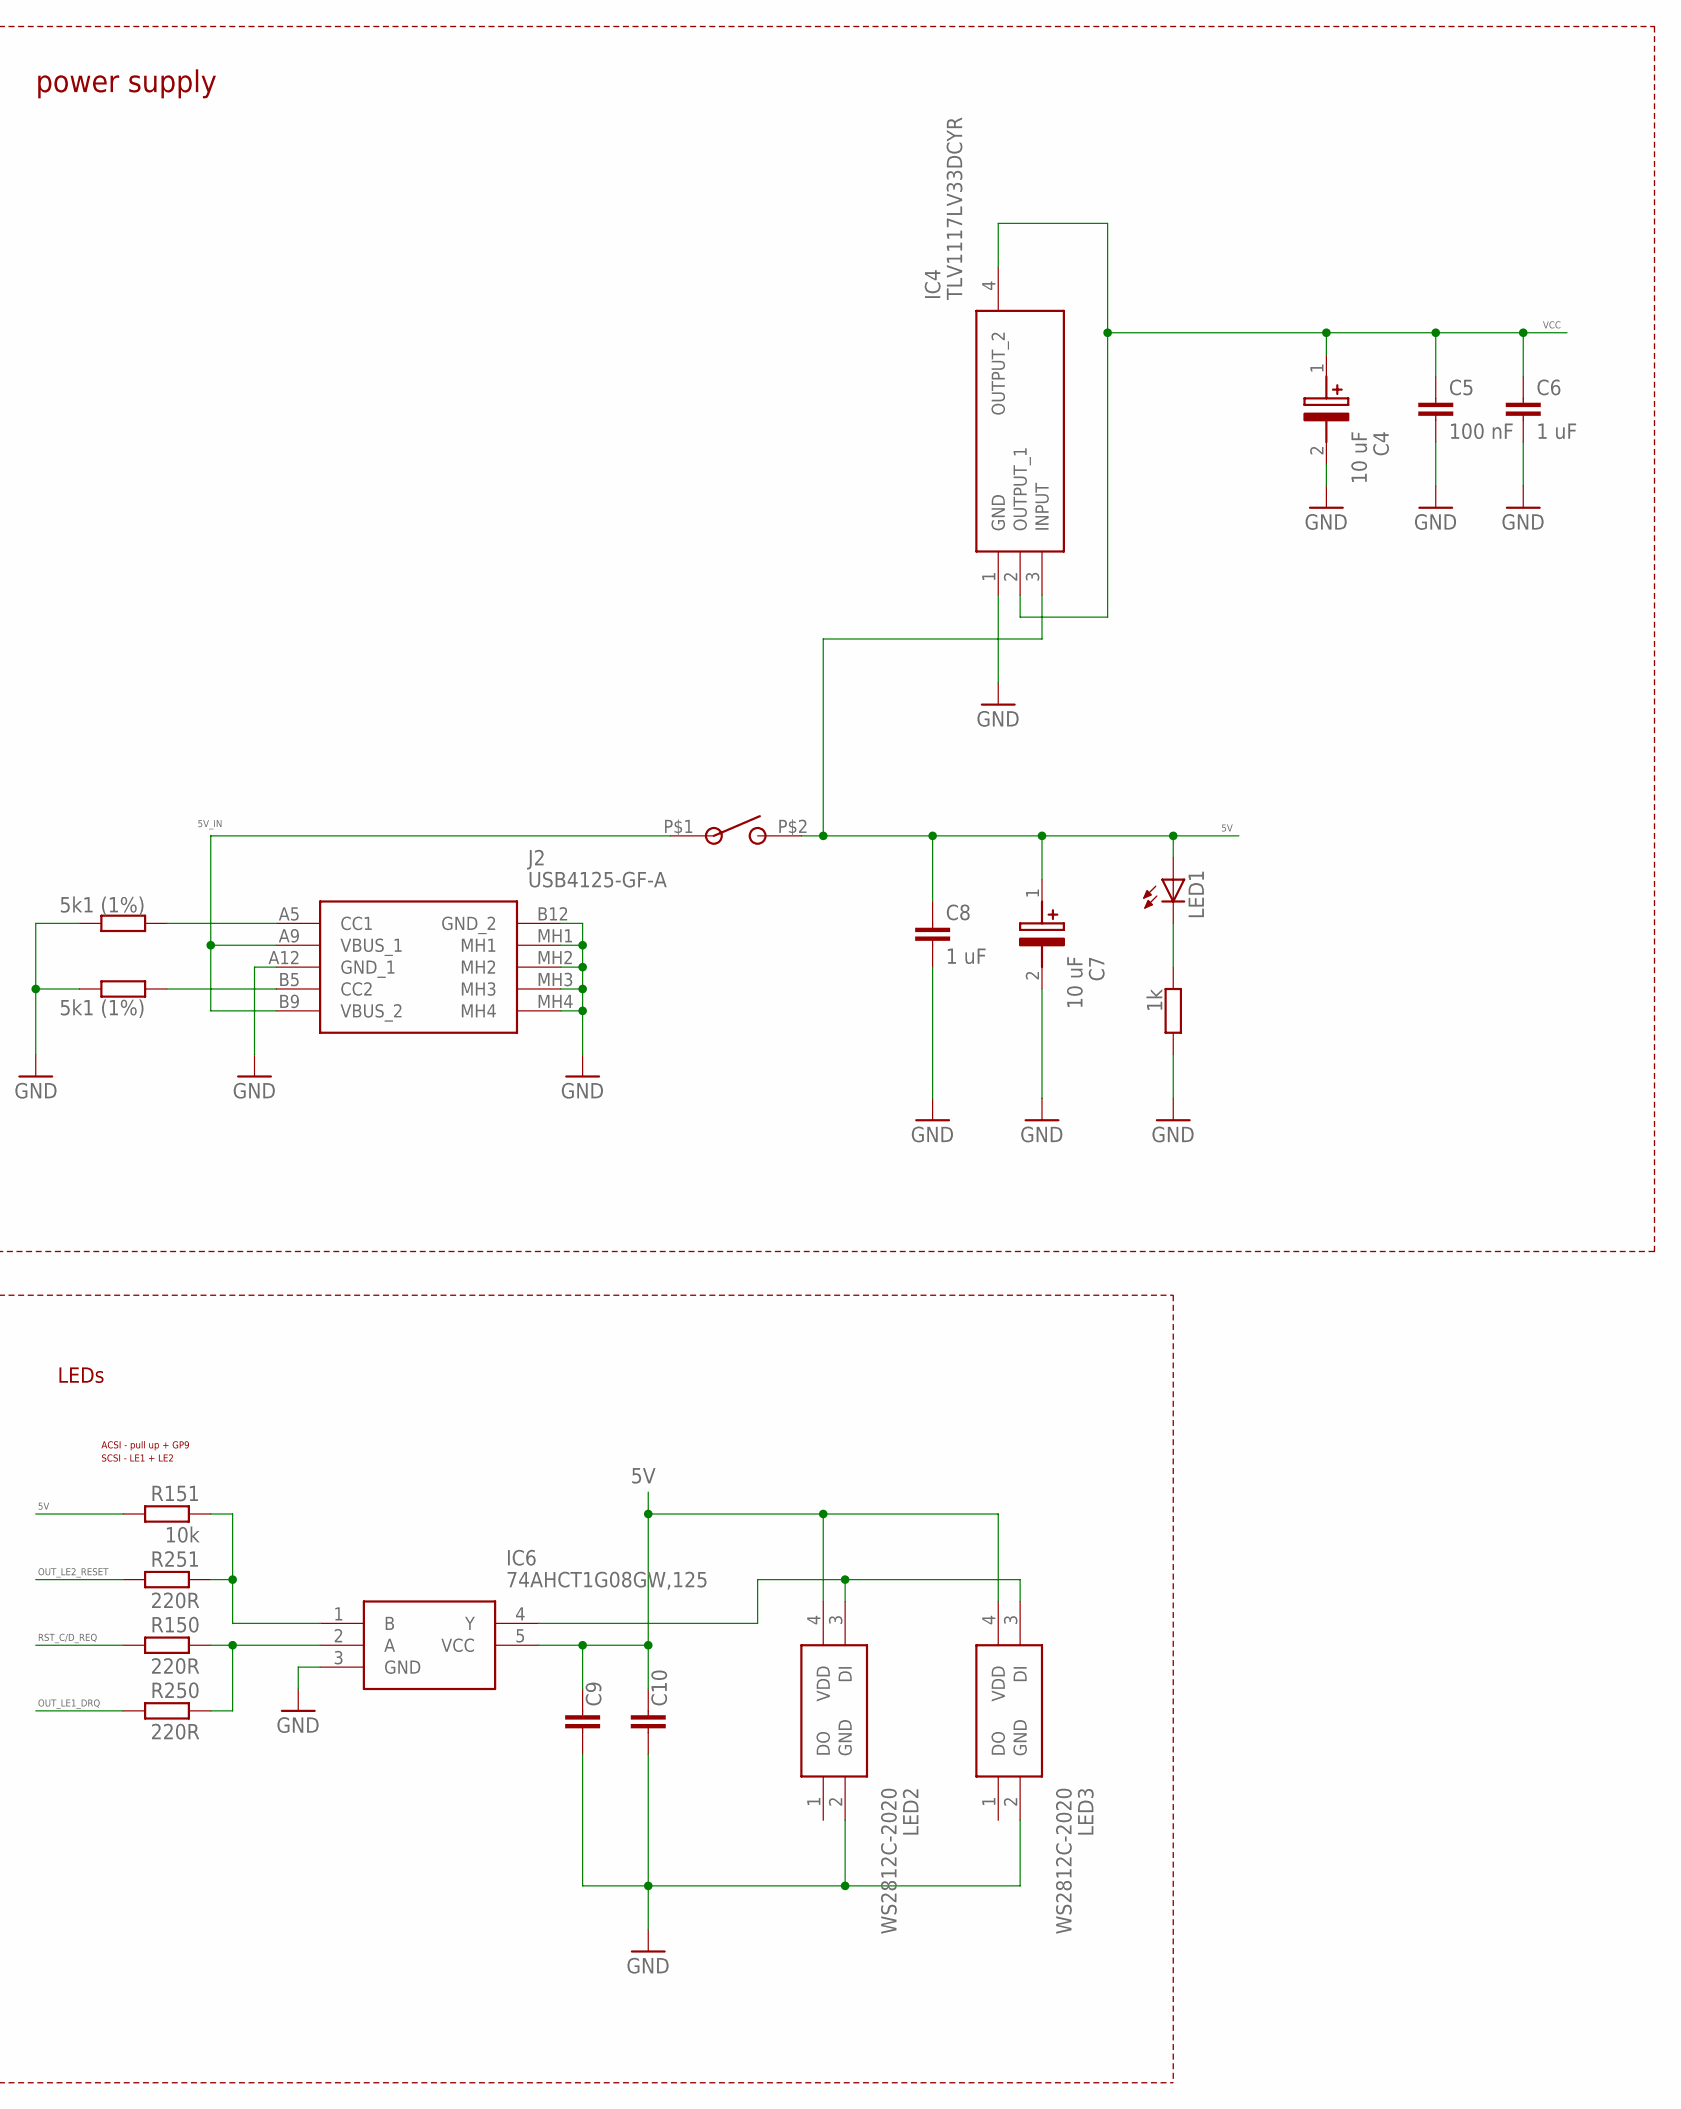
[picture p13: schematic ce_hdd_v40.sch, sheet 5, PICO, power, LEDs, part in row 1, column 2]

Parts:
C4: 10 uF; CAPPM3528X210N; MANUFACTURER_PART_NUMBER 293D106X9016B2TE3
C5, C9, C10: 100 nF; C0603
C6, C8: 1 uF; C0603
C7: 10 uF; CAPPM3528X210N
D1: SK110-DIO; DO214AC
IC1: RASPBERRY_PICOSMD-TH; PICO-PKG
IC4: TLV1117LV33DCYR; SOT230P700X180-4N
IC6: 74AHCT1G08GW,125; SOT65P212X110-5N
J2: USB4125-GF-A; USB4125GFA
LED1: LEDSML0603; SML0603
LED2: WS2812C-2020; WS2812C2020
LED3: WS2812C-2020; WS2812C2020; MANUFACTURER_PART_NUMBER WS2812C-2020
R3, R4: 5k1 (1%); R0603
R5: 1k; R0603
R6, R7, R8, R151: 10k; R0603
R125, R225: 100k; R0603
R150, R250, R251: 220R; R0603
SW1: SMSR-1; SMRS-1

Connections:
3V3(OUT): IC1.36 (3V3(OUT)), IC1.P$36 (3V3(OUT))
5V: C7.1 (+), C8.1, C9.1, C10.1, D1.A, IC4.3 (INPUT), IC6.5 (VCC), LED1.A, LED2.4 (VDD), LED3.4 (VDD), R151.2, SW1.P$2; also elsewhere on the board
5V_IN: J2.A9 (VBUS_1), J2.B9 (VBUS_2), SW1.P$1
ATN_MSG: IC1.31 (GP26), IC1.P$31 (GP26), R125.2, R225.1; also elsewhere on the board
C0: IC1.1 (GP0), IC1.P$1 (GP0); also elsewhere on the board
C1: IC1.2 (GP1), IC1.P$2 (GP1); also elsewhere on the board
C2: IC1.4 (GP2), IC1.P$4 (GP2); also elsewhere on the board
C3: IC1.5 (GP3), IC1.P$5 (GP3); also elsewhere on the board
C4: IC1.6 (GP4), IC1.P$6 (GP4); also elsewhere on the board
C5: IC1.7 (GP5), IC1.P$7 (GP5); also elsewhere on the board
C6: IC1.9 (GP6), IC1.P$9 (GP6); also elsewhere on the board
C7: IC1.10 (GP7), IC1.P$10 (GP7); also elsewhere on the board
CACK: IC1.14 (GP10), IC1.P$14 (GP10); also elsewhere on the board
DATA_DIR: IC1.34 (GP28), IC1.P$34 (GP28); also elsewhere on the board
GND: C4.2 (-), C5.2, C6.2, C7.2 (-), C8.2, C9.2, C10.2, IC1.3 (GND), IC1.8 (GND), IC1.13 (GND), IC1.18 (GND), IC1.23 (GND), IC1.28 (GND), IC1.33 (GND), IC1.38 (GND), IC1.P$3 (GND), IC1.P$8 (GND), IC1.P$13 (GND), IC1.P$18 (GND), IC1.P$23 (GND), IC1.P$28 (GND), IC1.P$33 (GND), IC1.P$38 (GND), IC4.1 (GND), IC6.3 (GND), J2.A12 (GND_1), J2.B12 (GND_2), J2.MH1, J2.MH2, J2.MH3, J2.MH4, LED2.2 (GND), LED3.2 (GND), R3.2, R4.2, R5.2, R225.2; also elsewhere on the board
IN_OE_CS: IC1.15 (GP11), IC1.P$15 (GP11), R6.2; also elsewhere on the board
KEYB_RX: IC1.20 (GP15), IC1.P$20 (GP15); also elsewhere on the board
KEYB_TX: IC1.29 (GP22), IC1.P$29 (GP22); also elsewhere on the board
KEYB_TX_ORIG: IC1.32 (GP27), IC1.P$32 (GP27); also elsewhere on the board
unnamed: J2.B5 (CC2), R4.1
unnamed: J2.A5 (CC1), R3.1
unnamed: IC6.2 (A), R150.1, R250.1
unnamed: IC6.1 (B), R151.1, R251.1
unnamed: LED1.C, R5.1
unnamed: IC6.4 (Y), LED2.3 (DI), LED3.3 (DI)
unnamed: D1.C, IC1.39 (VSYS), IC1.P$39 (VSYS)
OUT_LE1_DRQ: IC1.17 (GP13), IC1.P$17 (GP13), R8.2, R250.2; also elsewhere on the board
OUT_LE2_RESET: IC1.19 (GP14), IC1.P$19 (GP14), R251.2; also elsewhere on the board
OUT_OE_INT: IC1.16 (GP12), IC1.P$16 (GP12), R7.2; also elsewhere on the board
RST_C/D_REQ: IC1.12 (GP9), IC1.P$12 (GP9), R150.2; also elsewhere on the board
SEL_I/O_DP_A1: IC1.11 (GP8), IC1.P$11 (GP8); also elsewhere on the board
VBUS: IC1.40 (VBUS), IC1.P$40 (VBUS)
VCC: C4.1 (+), C5.1, C6.1, IC4.2 (OUTPUT_1), IC4.4 (OUTPUT_2), R6.1, R7.1, R8.1, R125.1; also elsewhere on the board

Notes on the sheet:
power supply
If using W6100, GP15 and GP22 can be used for IKBD
If using W6300, GP15 and GP22 are used by W6300 and IKBD cannot use them.
fit for ACSI
fit for SCSI
LEDs
ACSI - pull up + GP9
SCSI - LE1 + LE2

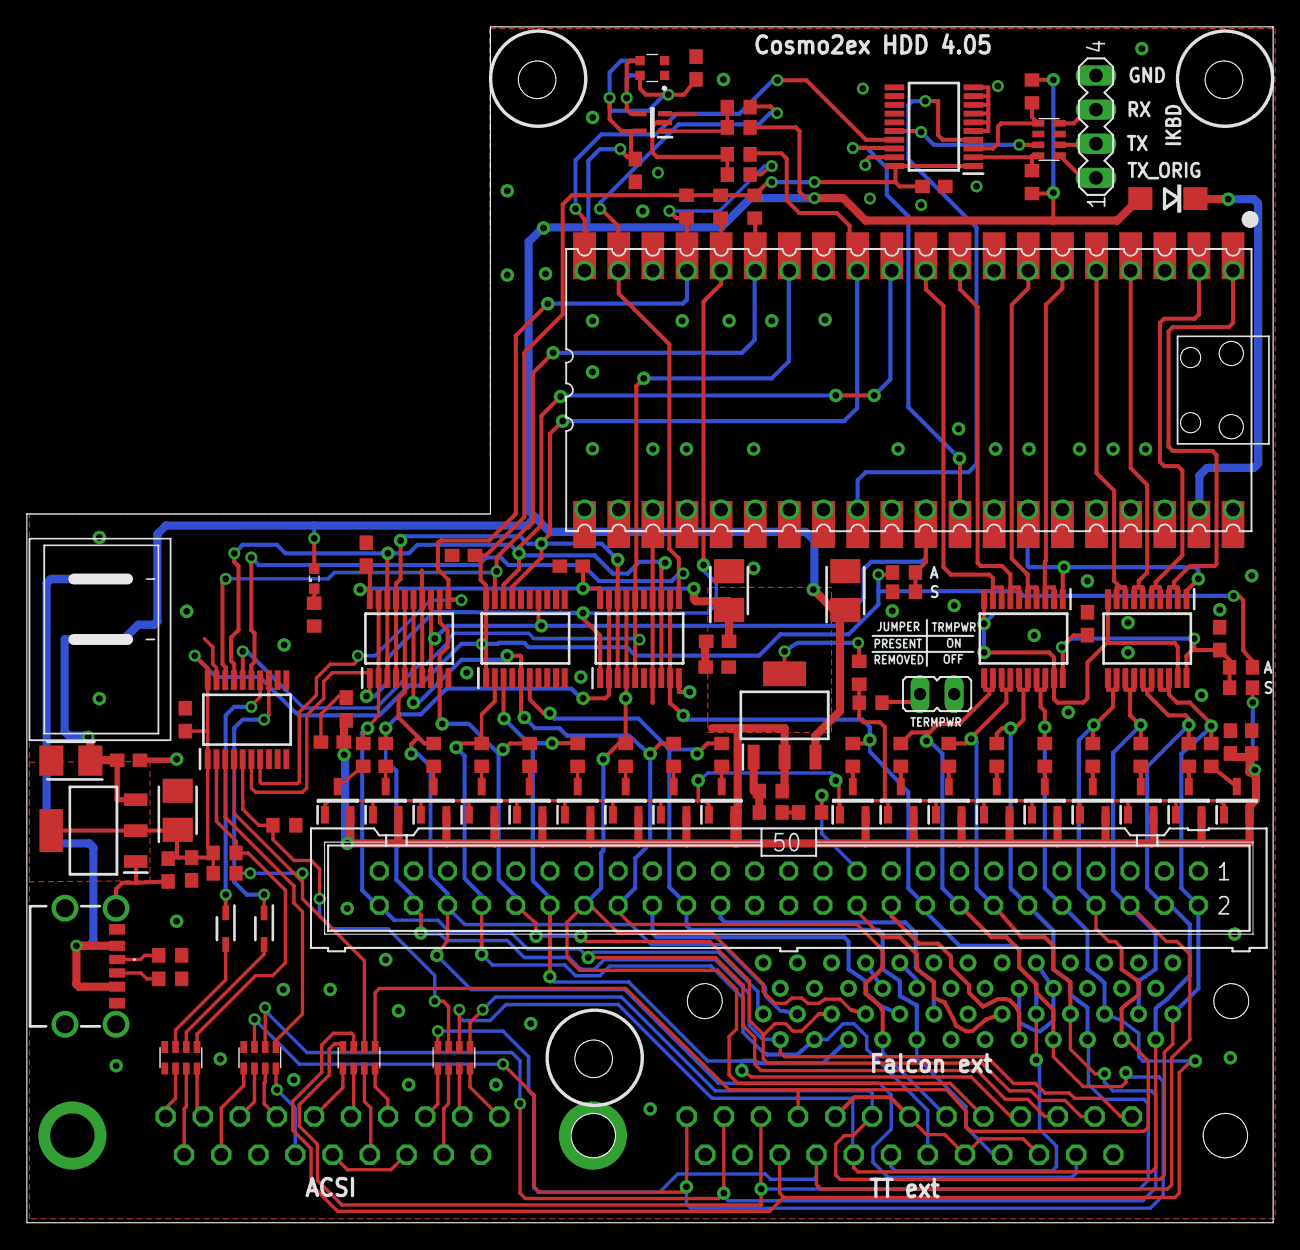
[picture p14: board ce_hdd_v40.brd from above]

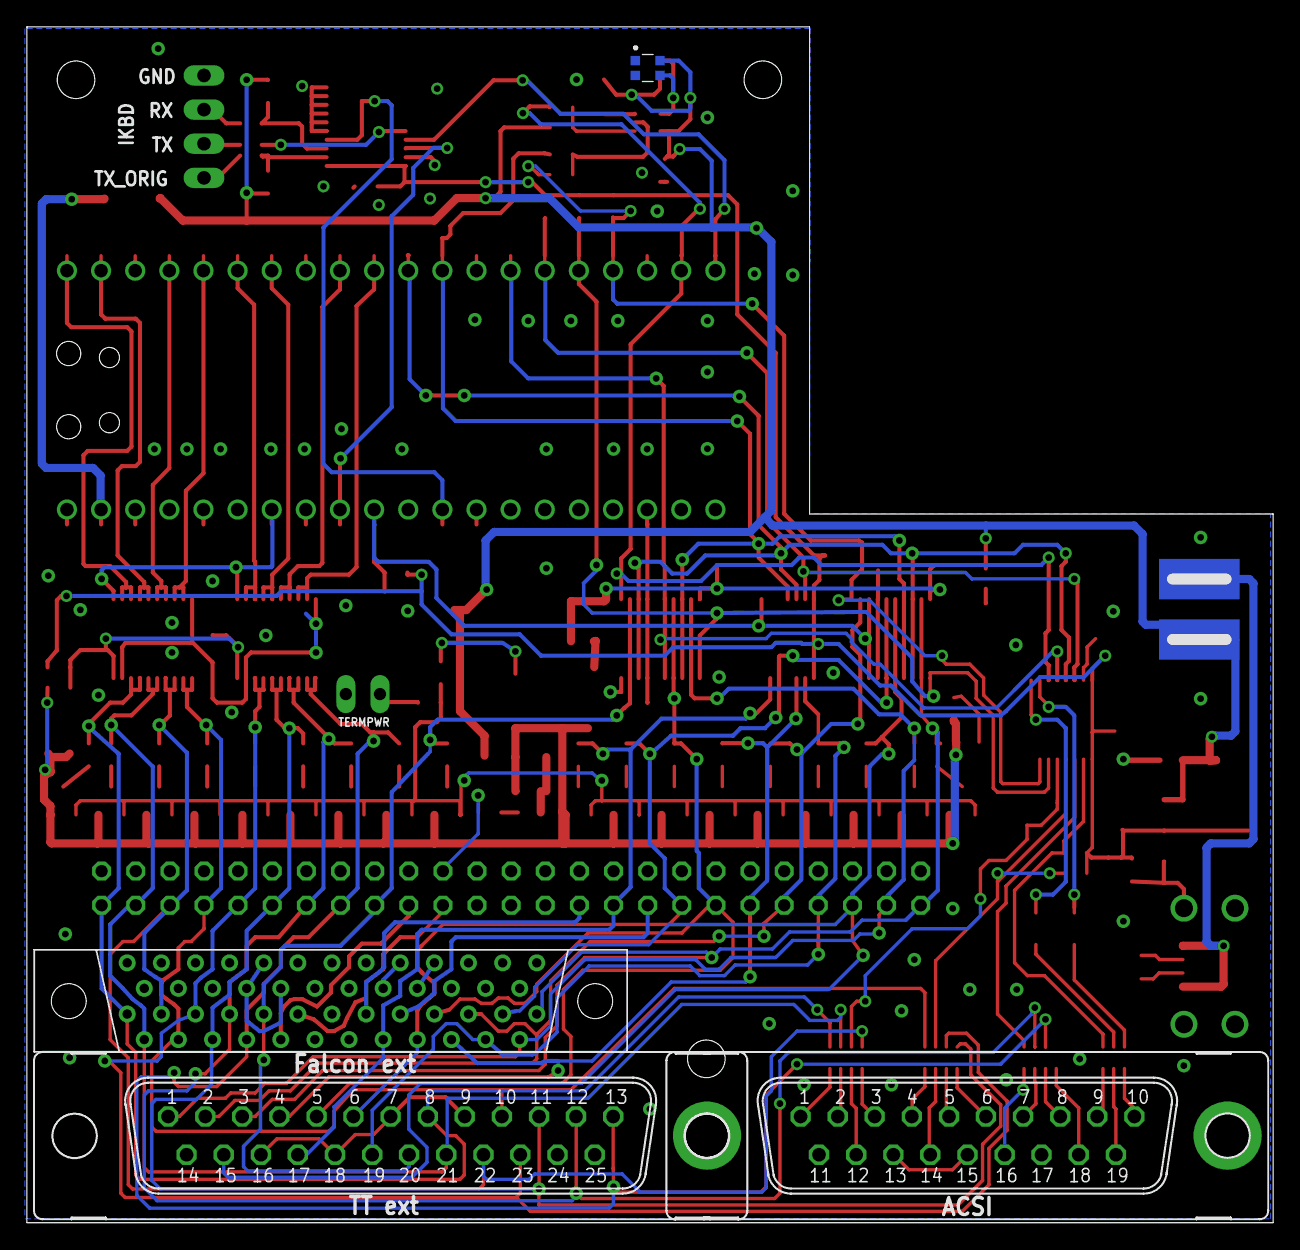
[picture p15: board ce_hdd_v40.brd from below]

Board: 2 copper layers, 92.8 x 89.0 mm, 112 parts (4 on the bottom side), 104 nets.
