atarijookie/cosmo2ex/devices/pico_display/rp2040zero_display_buttons.brd

## EAGLE design devices/pico_display/rp2040zero_display_buttons.brd (2026-10-30)

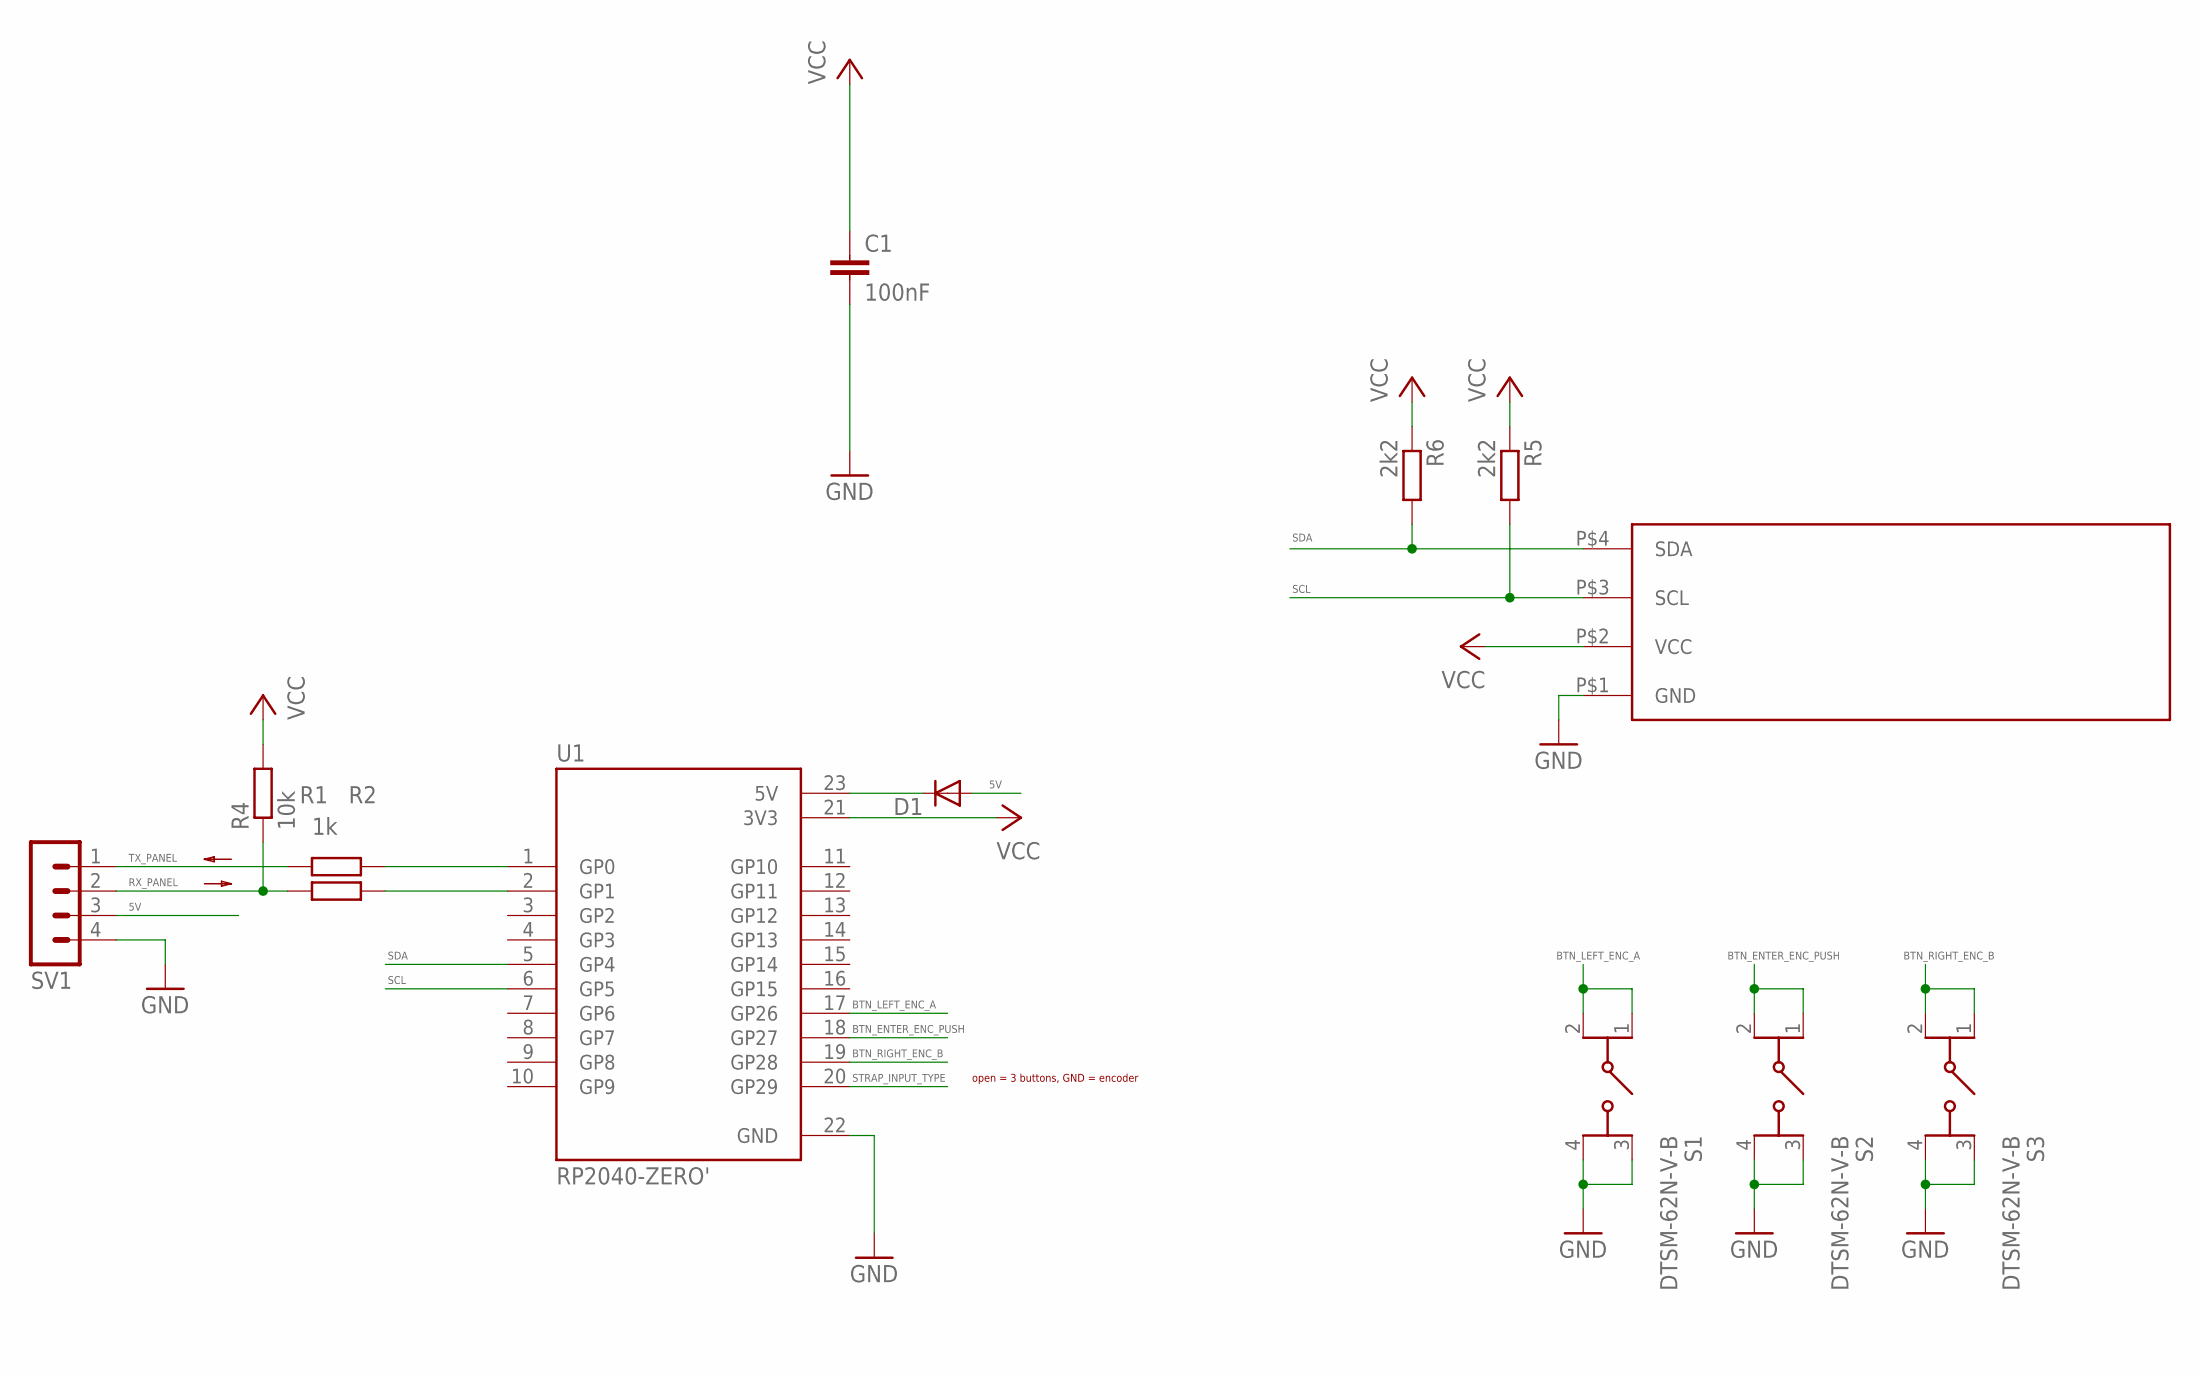
[picture p16: schematic rp2040zero_display_buttons.sch]

Parts:
C1: 100nF; C0603
D1: SK110-DIO; DO214AC
R1, R2: 1k; R0603
R4: 10k; R0603
R5, R6: 2k2; R0603
S1, S2, S3: DTSM-62N-V-B; DTSM62NVB
SV1: MA04-1
U1: RP2040-ZERO'; MODULE_RP2040-ZERO
U$1: OLED; SIP

Connections:
5V: D1.A, SV1.3
BTN_ENTER_ENC_PUSH: S2.1 (COM_1), S2.2 (COM_2), U1.18 (GP27)
BTN_LEFT_ENC_A: S1.1 (COM_1), S1.2 (COM_2), U1.17 (GP26)
BTN_RIGHT_ENC_B: S3.1 (COM_1), S3.2 (COM_2), U1.19 (GP28)
GND: C1.2, S1.3 (NO_1), S1.4 (NO_2), S2.3 (NO_1), S2.4 (NO_2), S3.3 (NO_1), S3.4 (NO_2), SV1.4, U1.22 (GND), U$1.P$1 (GND)
unnamed: R1.2, U1.1 (GP0)
unnamed: R2.2, U1.2 (GP1)
unnamed: D1.C, U1.23 (5V)
RX_PANEL: R2.1, R4.1, SV1.2
SCL: R5.2, U1.6 (GP5), U$1.P$3 (SCL)
SDA: R6.2, U1.5 (GP4), U$1.P$4 (SDA)
STRAP_INPUT_TYPE: U1.20 (GP29)
TX_PANEL: R1.1, SV1.1
VCC: C1.1, R4.2, R5.1, R6.1, U1.21 (3V3), U$1.P$2 (VCC)

Notes on the sheet:
open = 3 buttons, GND = encoder

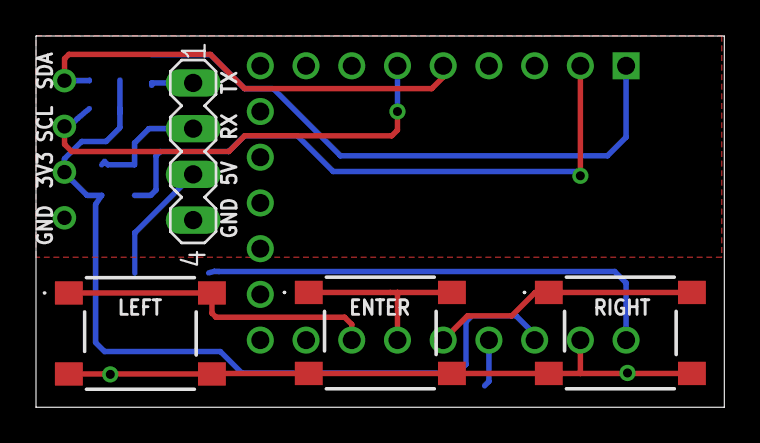
[picture p17: board rp2040zero_display_buttons.brd from above]

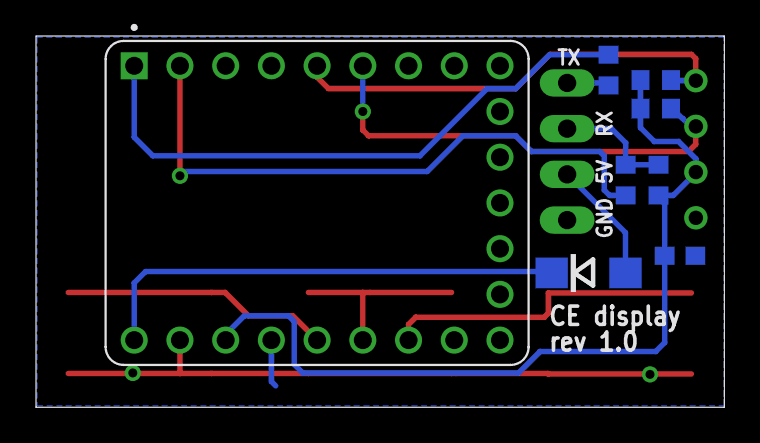
[picture p18: board rp2040zero_display_buttons.brd from below]

Board: 2 copper layers, 38.2 x 20.6 mm, 13 parts (8 on the bottom side), 13 nets.
