atarijookie/cosmo2ex/devices/v40_pico_fdd/ce_fdd_v40.brd

## EAGLE design devices/v40_pico_fdd/ce_fdd_v40.brd (2026-10-30)

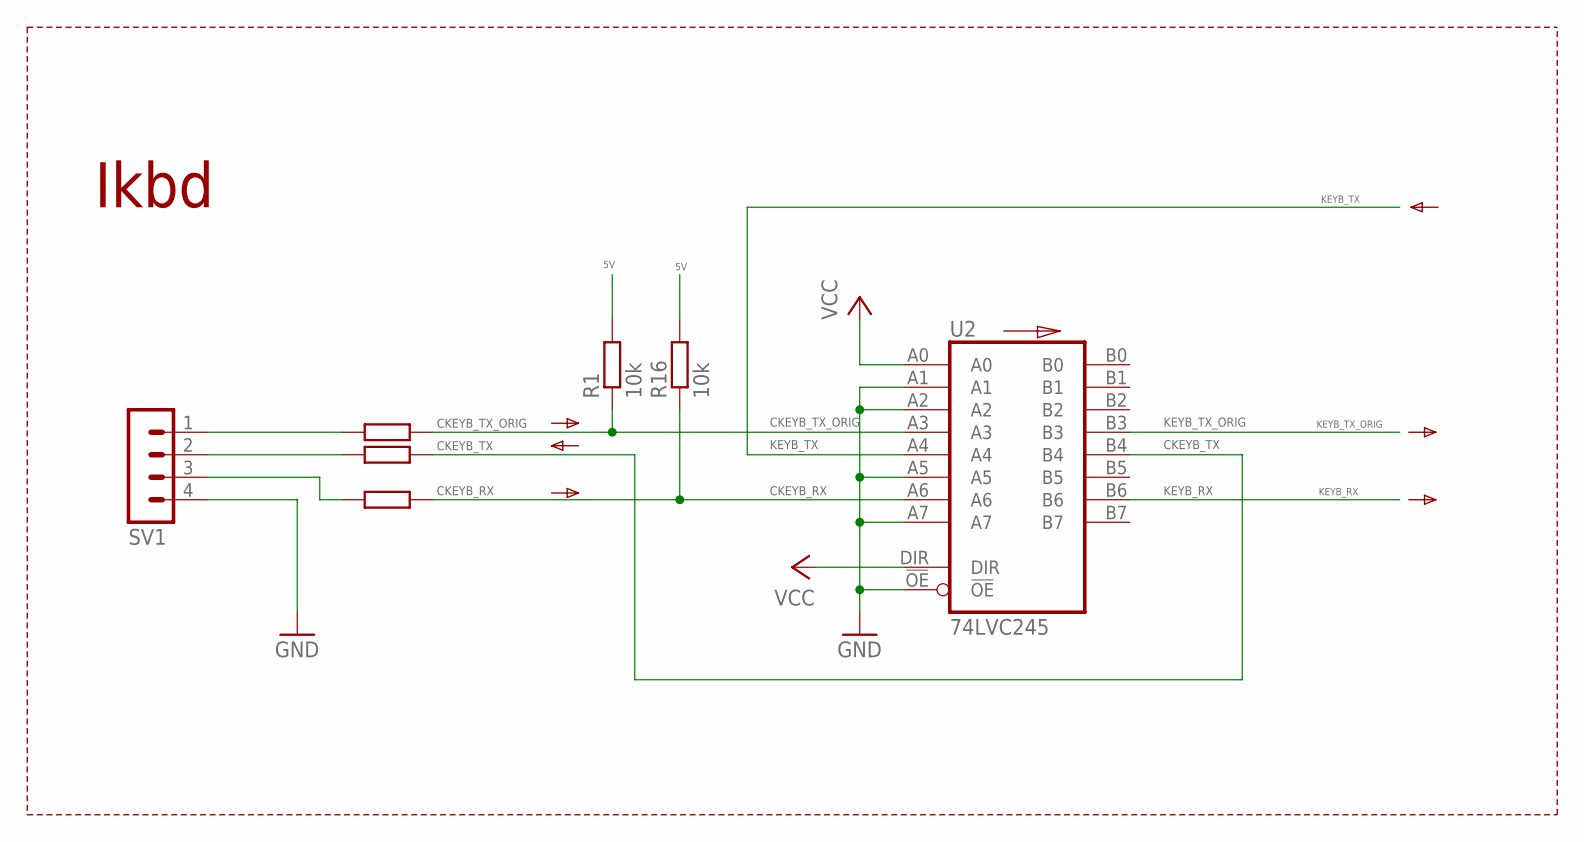
[picture p19: schematic ce_fdd_v40.sch, sheet 1, IKBD part]

Parts:
R1, R16: 10k; R0603
R25, R33, R34: 47R; R0603
SV1: MA04-1
U2: 74LVC245; 74LVC245_TSSOP20

Connections:
5V: R1.2, R16.2; also elsewhere on the board
CKEYB_RX: R16.1, R34.1, U2.A6
CKEYB_TX: R33.1, U2.B4
CKEYB_TX_ORIG: R1.1, R25.1, U2.A3
GND: SV1.4, U2.!OE, U2.A1, U2.A2, U2.A5, U2.A7, U2.GND; also elsewhere on the board
KEYB_RX: U2.B6; also elsewhere on the board
KEYB_TX: U2.A4; also elsewhere on the board
KEYB_TX_ORIG: U2.B3; also elsewhere on the board
unnamed: R33.2, SV1.2
VCC: U2.A0, U2.DIR, U2.VCC; also elsewhere on the board
ZKEYB_RX: R34.2, SV1.3
ZKEYB_TX_ORIG: R25.2, SV1.1

Notes on the sheet:
Ikbd
