atarijookie/cosmo2ex/devices/v40_pico_fdd/ce_fdd_v40.brd

## EAGLE design devices/v40_pico_fdd/ce_fdd_v40.brd (continued)

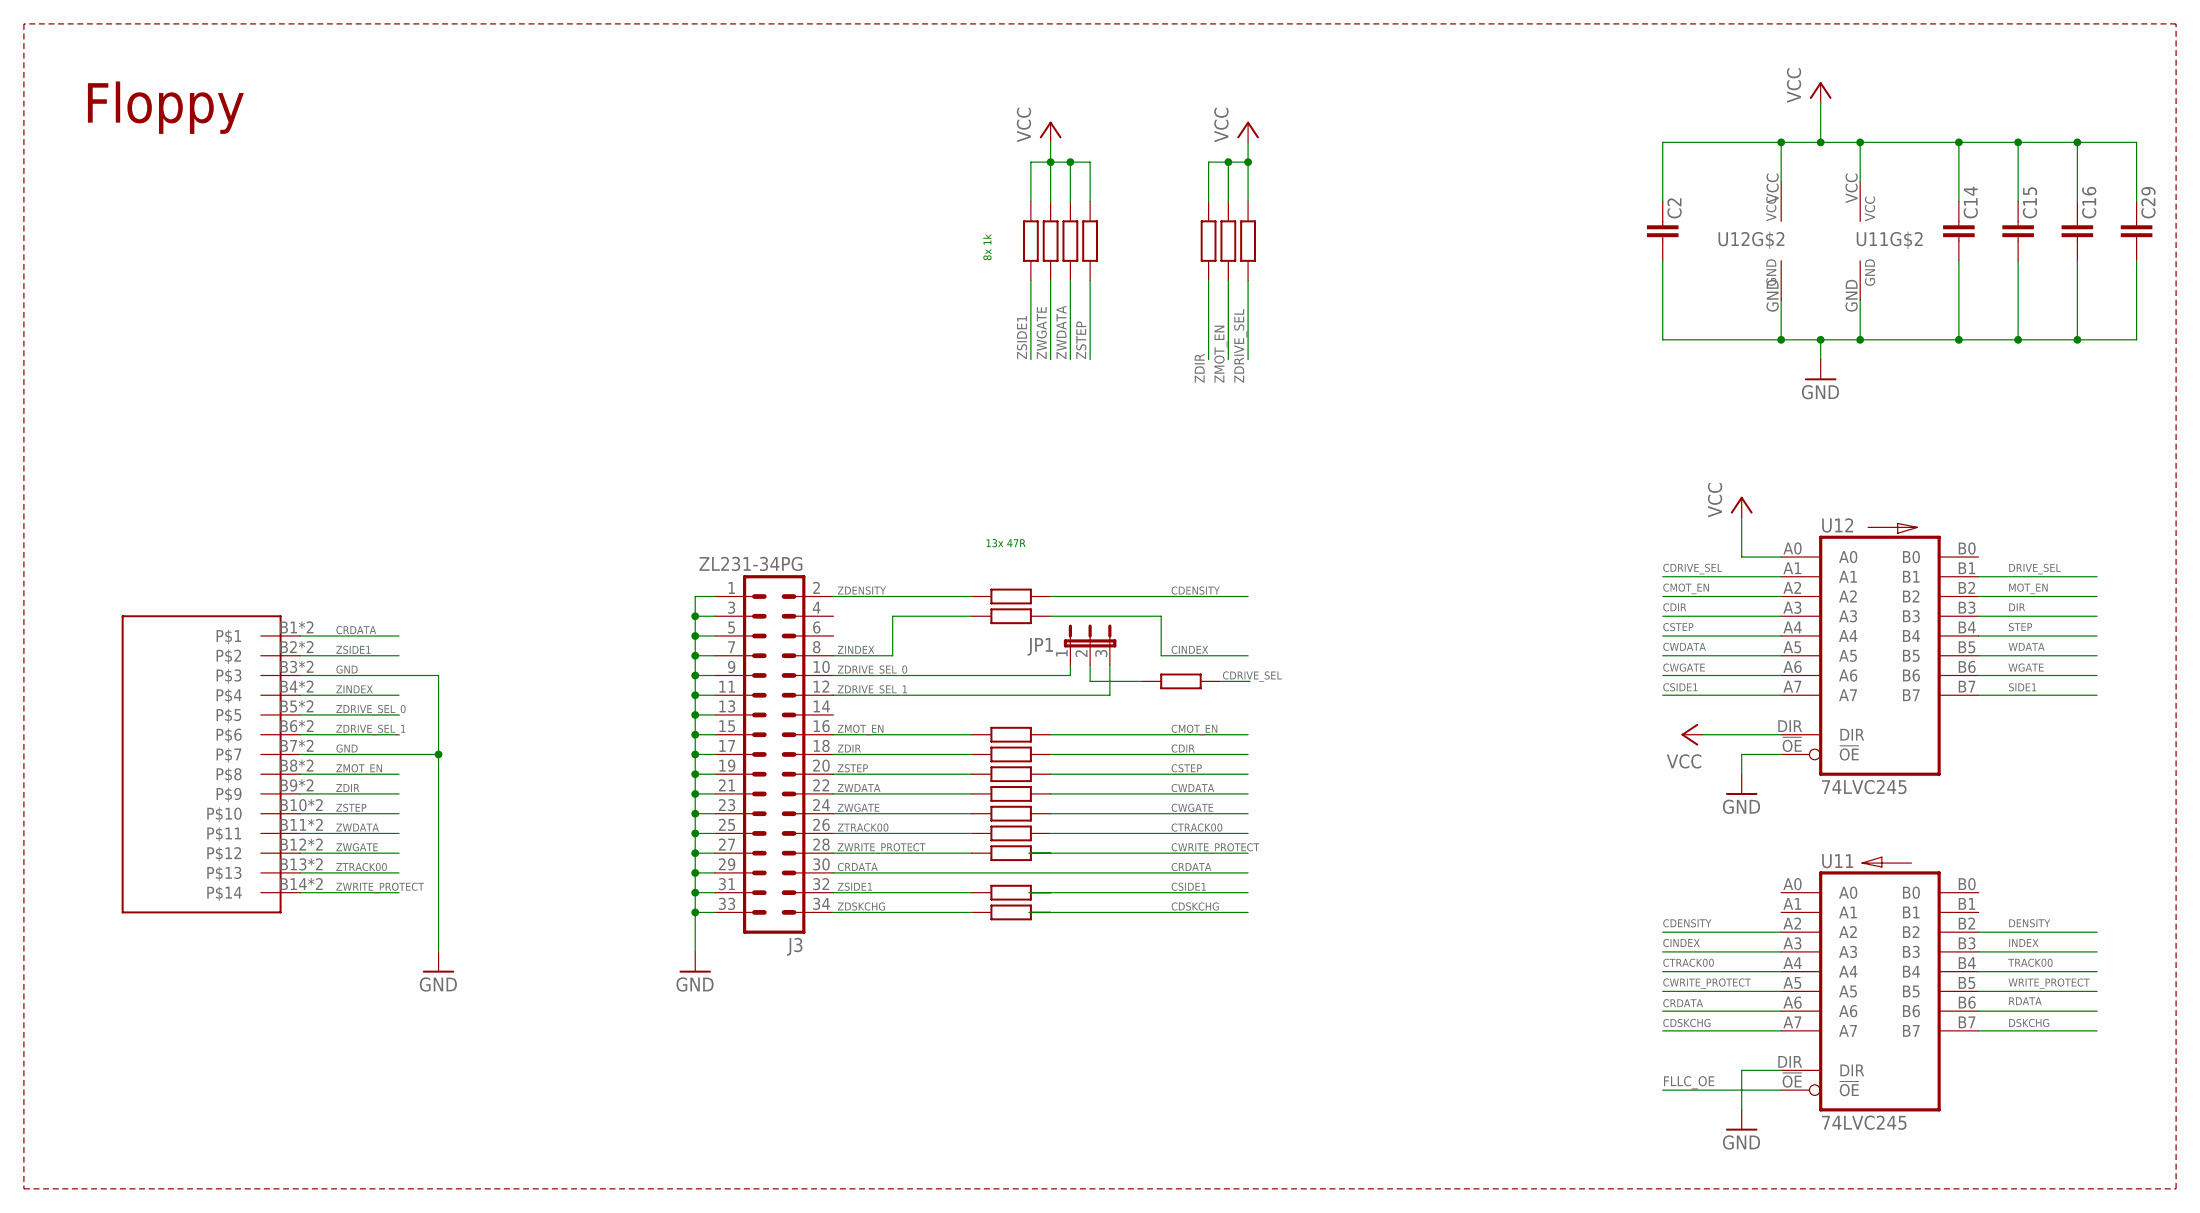
[picture p20: schematic ce_fdd_v40.sch, sheet 2, floppy part]

Parts:
C2, C14, C15, C16, C29: 100 nF; C0603
J3: ZL231-34PG; ML34
JP1: JP2E; JP2
R2, R3, R4, R6, R7, R8, R9, R10, R11, R12, R13, R15: 47R; R0603
R22, R23, R24, R26, R27, R28, R29: 1k; R0603
U11, U12: 74LVC245; 74LVC245_TSSOP20
U$1: DIN14

Connections:
CDENSITY: R2.1, U11.A2
CDIR: R7.1, U12.A3
CDRIVE_SEL: R4.1, U12.A1
CDSKCHG: R15.1, U11.A7
CINDEX: R3.1, U11.A3
CMOT_EN: R6.1, U12.A2
CRDATA: J3.30, U11.A6, U$1.B1, U$1.T1
CSIDE1: R13.1, U12.A7
CSTEP: R8.1, U12.A4
CTRACK00: R11.1, U11.A4
CWDATA: R9.1, U12.A5
CWGATE: R10.1, U12.A6
CWRITE_PROTECT: R12.1, U11.A5
DENSITY: U11.B2; also elsewhere on the board
DIR: U12.B3; also elsewhere on the board
DRIVE_SEL: U12.B1; also elsewhere on the board
DSKCHG: U11.B7; also elsewhere on the board
FLLC_OE: U11.!OE; also elsewhere on the board
GND: C2.2, C14.2, C15.2, C16.2, C29.2, J3.1, J3.3, J3.5, J3.7, J3.9, J3.11, J3.13, J3.15, J3.17, J3.19, J3.21, J3.23, J3.25, J3.27, J3.29, J3.31, J3.33, U11.DIR, U11.GND, U12.!OE, U12.GND, U$1.B3, U$1.B7, U$1.T3, U$1.T7; also elsewhere on the board
INDEX: U11.B3; also elsewhere on the board
MOT_EN: U12.B2; also elsewhere on the board
RDATA: U11.B6; also elsewhere on the board
SIDE1: U12.B7; also elsewhere on the board
STEP: U12.B4; also elsewhere on the board
TRACK00: U11.B4; also elsewhere on the board
VCC: C2.1, C14.1, C15.1, C16.1, C29.1, R22.1, R23.1, R24.1, R26.1, R27.1, R28.1, R29.1, U11.VCC, U12.A0, U12.DIR, U12.VCC; also elsewhere on the board
WDATA: U12.B5; also elsewhere on the board
WGATE: U12.B6; also elsewhere on the board
WRITE_PROTECT: U11.B5; also elsewhere on the board
ZDENSITY: J3.2, R2.2
ZDIR: J3.18, R7.2, R27.2, U$1.B9, U$1.T9
ZDRIVE_SEL: JP1.2, R4.2, R29.2
ZDRIVE_SEL_0: J3.10, JP1.1, U$1.B5, U$1.T5
ZDRIVE_SEL_1: J3.12, JP1.3, U$1.B6, U$1.T6
ZDSKCHG: J3.34, R15.2
ZINDEX: J3.8, R3.2, U$1.B4, U$1.T4
ZMOT_EN: J3.16, R6.2, R28.2, U$1.B8, U$1.T8
ZSIDE1: J3.32, R13.2, R22.2, U$1.B2, U$1.T2
ZSTEP: J3.20, R8.2, R26.2, U$1.B10, U$1.T10
ZTRACK00: J3.26, R11.2, U$1.B13, U$1.T13
ZWDATA: J3.22, R9.2, R24.2, U$1.B11, U$1.T11
ZWGATE: J3.24, R10.2, R23.2, U$1.B12, U$1.T12
ZWRITE_PROTECT: J3.28, R12.2, U$1.B14, U$1.T14

Notes on the sheet:
Floppy
13x 47R
8x 1k

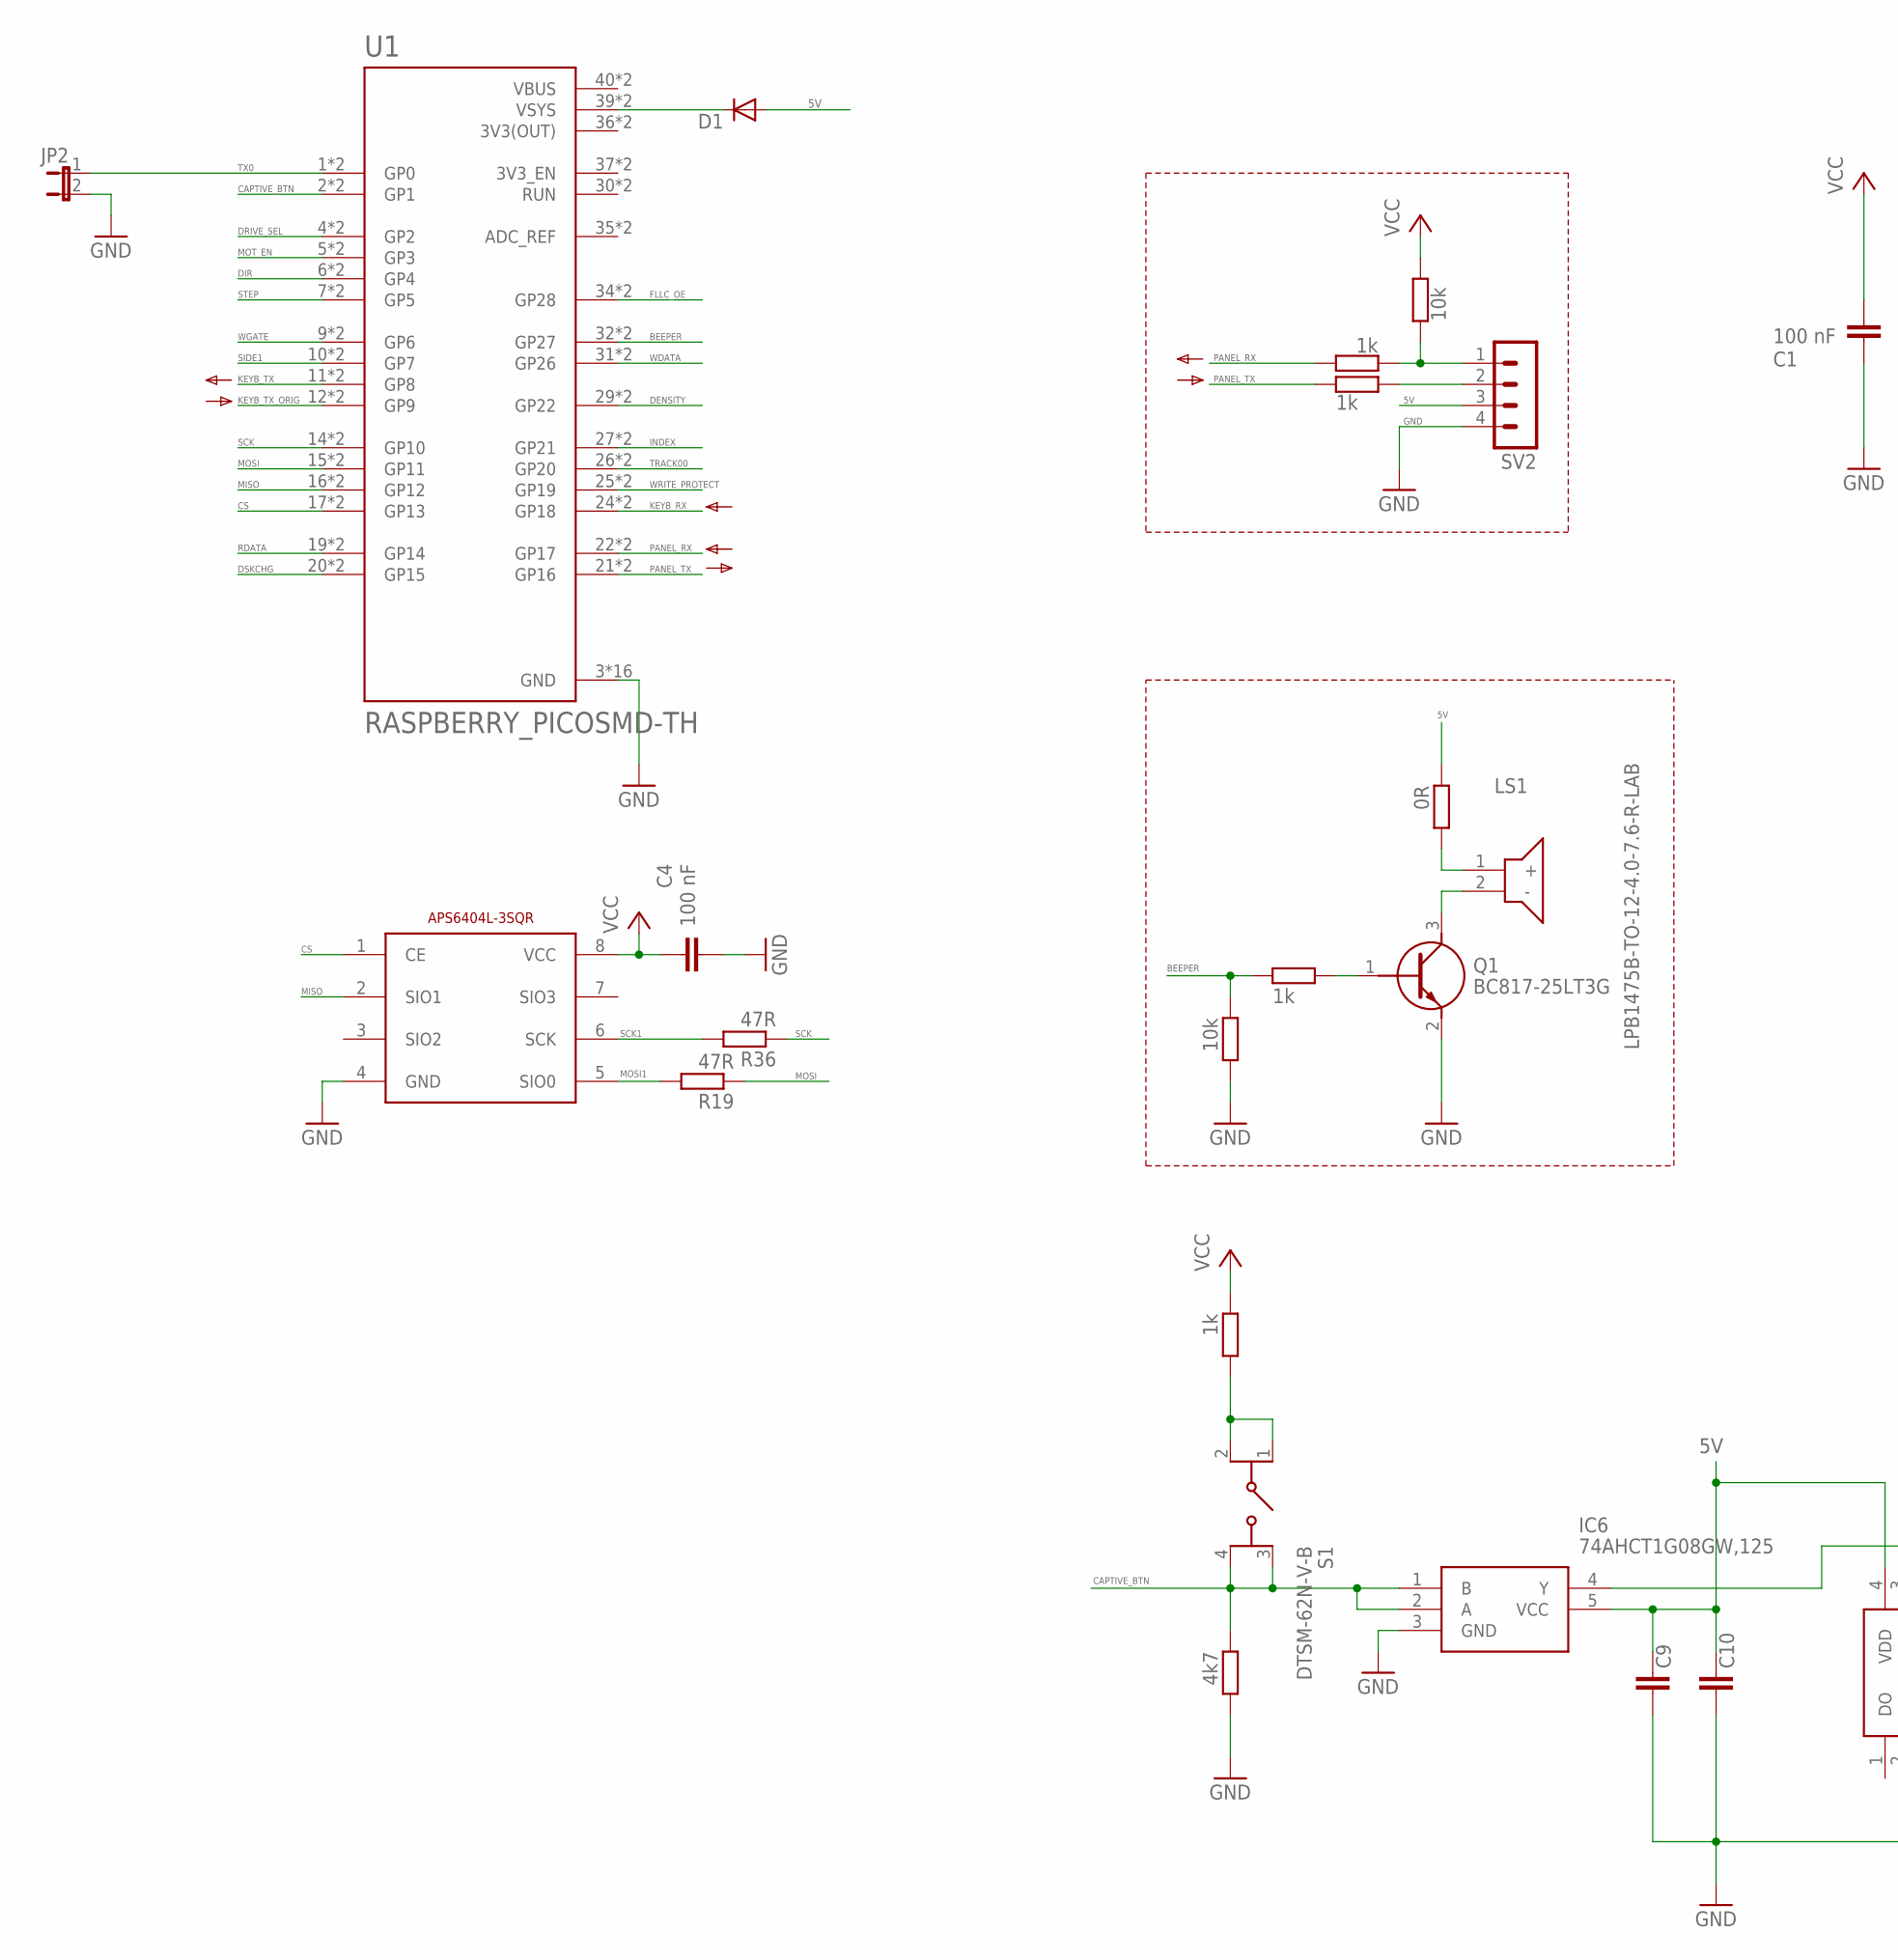
[picture p21: schematic ce_fdd_v40.sch, sheet 3, Front panel, power supply and RPi connection parts, part in row 1, column 1]

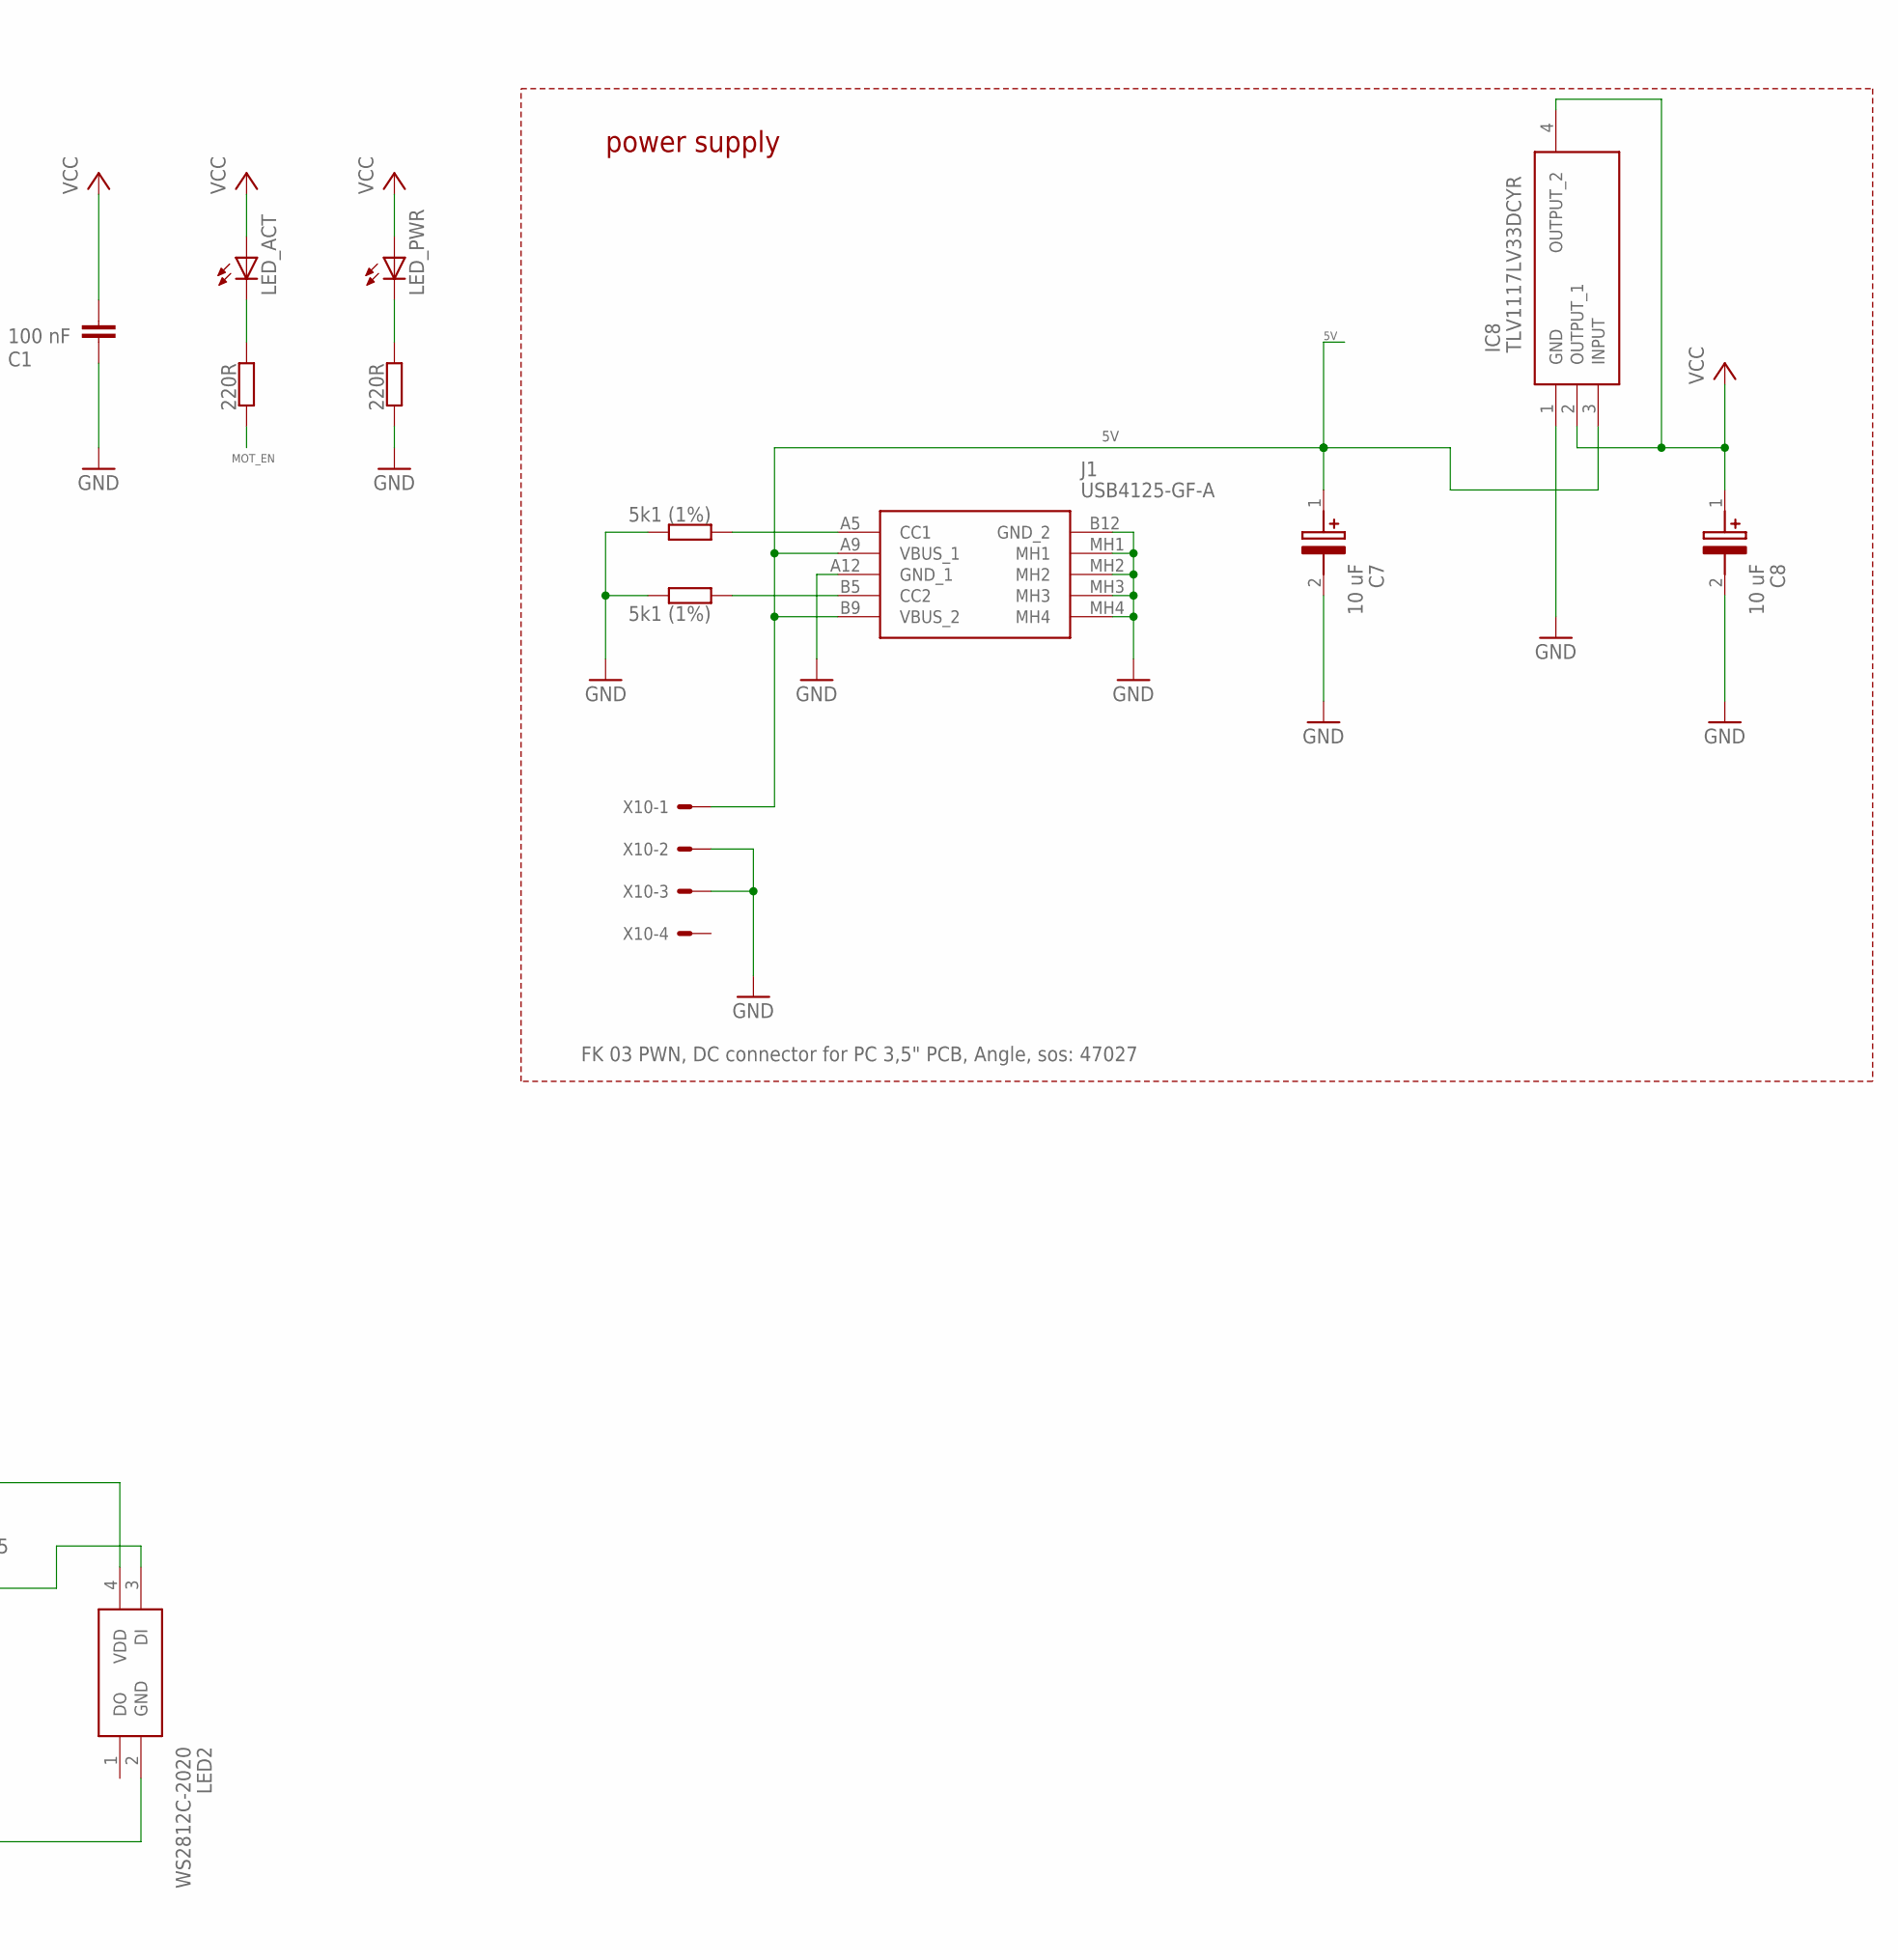
[picture p22: schematic ce_fdd_v40.sch, sheet 3, Front panel, power supply and RPi connection parts, part in row 1, column 2]

Parts:
C1, C4, C9, C10: 100 nF; C0603
C7, C8: 10 uF; CAPPM3528X210N
D1: SK110-DIO; DO214AC
IC6: 74AHCT1G08GW,125; SOT65P212X110-5N
IC8: TLV1117LV33DCYR; SOT230P700X180-4N
J1: USB4125-GF-A; USB4125GFA
JP2: JP1E; JP1
LED2: WS2812C-2020; WS2812C2020
LED_ACT: LEDSML0603; SML0603
LED_PWR: LEDSML0603; SML0603
LS1: LPB1475B-TO-12-4.0-7.6-R-LAB; LPB1475BTO124076RLAB
Q1: BC817-25LT3G; SOT96P237X111-3N
R5: 0R; R0603
R14, R17: 5k1 (1%); R0603
R18, R35: 220R; R0603
R19, R36: 47R; R0603
R20, R30, R32, R37: 1k; R0603
R21, R31: 10k; R0603
R38: 4k7; R0603
S1: DTSM-62N-V-B; DTSM62NVB
SV2: MA04-1
U1: RASPBERRY_PICOSMD-TH; PICO-PKG
U$2: APS6404L-3SQR; SOP-8L
X10: FK 03 PWN, DC connector for PC 3,5" PCB, Angle, s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; 7395-04

Connections:
3V3(OUT): U1.36 (3V3(OUT)), U1.P$36 (3V3(OUT))
5V: C7.1 (+), C9.1, C10.1, D1.A, IC6.5 (VCC), IC8.3 (INPUT), J1.A9 (VBUS_1), J1.B9 (VBUS_2), LED2.4 (VDD), R5.1, SV2.3, X10.1; also elsewhere on the board
BEEPER: R30.1, R31.1, U1.32 (GP27), U1.P$32 (GP27)
CAPTIVE_BTN: IC6.1 (B), IC6.2 (A), R38.1, S1.3 (NO_1), S1.4 (NO_2), U1.2 (GP1), U1.P$2 (GP1)
CS: U1.17 (GP13), U1.P$17 (GP13), U$2.1 (CE)
DENSITY: U1.29 (GP22), U1.P$29 (GP22); also elsewhere on the board
DIR: U1.6 (GP4), U1.P$6 (GP4); also elsewhere on the board
DRIVE_SEL: U1.4 (GP2), U1.P$4 (GP2); also elsewhere on the board
DSKCHG: U1.20 (GP15), U1.P$20 (GP15); also elsewhere on the board
FLLC_OE: U1.34 (GP28), U1.P$34 (GP28); also elsewhere on the board
GND: C1.2, C4.1, C7.2 (-), C8.2 (-), C9.2, C10.2, IC6.3 (GND), IC8.1 (GND), J1.A12 (GND_1), J1.B12 (GND_2), J1.MH1, J1.MH2, J1.MH3, J1.MH4, JP2.2, LED2.2 (GND), Q1.2 (E), R14.2, R17.2, R18.2, R31.2, R38.2, SV2.4, U1.3 (GND), U1.8 (GND), U1.13 (GND), U1.18 (GND), U1.23 (GND), U1.28 (GND), U1.33 (GND), U1.38 (GND), U1.P$3 (GND), U1.P$8 (GND), U1.P$13 (GND), U1.P$18 (GND), U1.P$23 (GND), U1.P$28 (GND), U1.P$33 (GND), U1.P$38 (GND), U$2.4 (GND), X10.2, X10.3; also elsewhere on the board
INDEX: U1.27 (GP21), U1.P$27 (GP21); also elsewhere on the board
KEYB_RX: U1.24 (GP18), U1.P$24 (GP18); also elsewhere on the board
KEYB_TX: U1.11 (GP8), U1.P$11 (GP8); also elsewhere on the board
KEYB_TX_ORIG: U1.12 (GP9), U1.P$12 (GP9); also elsewhere on the board
MISO: U1.16 (GP12), U1.P$16 (GP12), U$2.2 (SIO1)
MOSI: R19.1, U1.15 (GP11), U1.P$15 (GP11)
MOSI1: R19.2, U$2.5 (SIO0)
MOT_EN: R35.2, U1.5 (GP3), U1.P$5 (GP3); also elsewhere on the board
unnamed: J1.B5 (CC2), R14.1
unnamed: J1.A5 (CC1), R17.1
unnamed: Q1.1 (B), R30.2
unnamed: LS1.2 (-), Q1.3 (C)
unnamed: LED_ACT.C, R35.1
unnamed: LED_PWR.C, R18.1
unnamed: LS1.1 (+), R5.2
unnamed: R21.1, R32.1, SV2.1
unnamed: R37.2, SV2.2
unnamed: R20.2, S1.1 (COM_1), S1.2 (COM_2)
unnamed: IC6.4 (Y), LED2.3 (DI)
unnamed: D1.C, U1.39 (VSYS), U1.P$39 (VSYS)
PANEL_RX: R32.2, U1.22 (GP17), U1.P$22 (GP17)
PANEL_TX: R37.1, U1.21 (GP16), U1.P$21 (GP16)
RDATA: U1.19 (GP14), U1.P$19 (GP14); also elsewhere on the board
SCK: R36.1, U1.14 (GP10), U1.P$14 (GP10)
SCK1: R36.2, U$2.6 (SCK)
SIDE1: U1.10 (GP7), U1.P$10 (GP7); also elsewhere on the board
STEP: U1.7 (GP5), U1.P$7 (GP5); also elsewhere on the board
TRACK00: U1.26 (GP20), U1.P$26 (GP20); also elsewhere on the board
TX0: JP2.1, U1.1 (GP0), U1.P$1 (GP0)
VBUS: U1.40 (VBUS), U1.P$40 (VBUS)
VCC: C1.1, C4.2, C8.1 (+), IC8.2 (OUTPUT_1), IC8.4 (OUTPUT_2), LED_ACT.A, LED_PWR.A, R20.1, R21.2, U$2.8 (VCC); also elsewhere on the board
WDATA: U1.31 (GP26), U1.P$31 (GP26); also elsewhere on the board
WGATE: U1.9 (GP6), U1.P$9 (GP6); also elsewhere on the board
WRITE_PROTECT: U1.25 (GP19), U1.P$25 (GP19); also elsewhere on the board

Notes on the sheet:
power supply

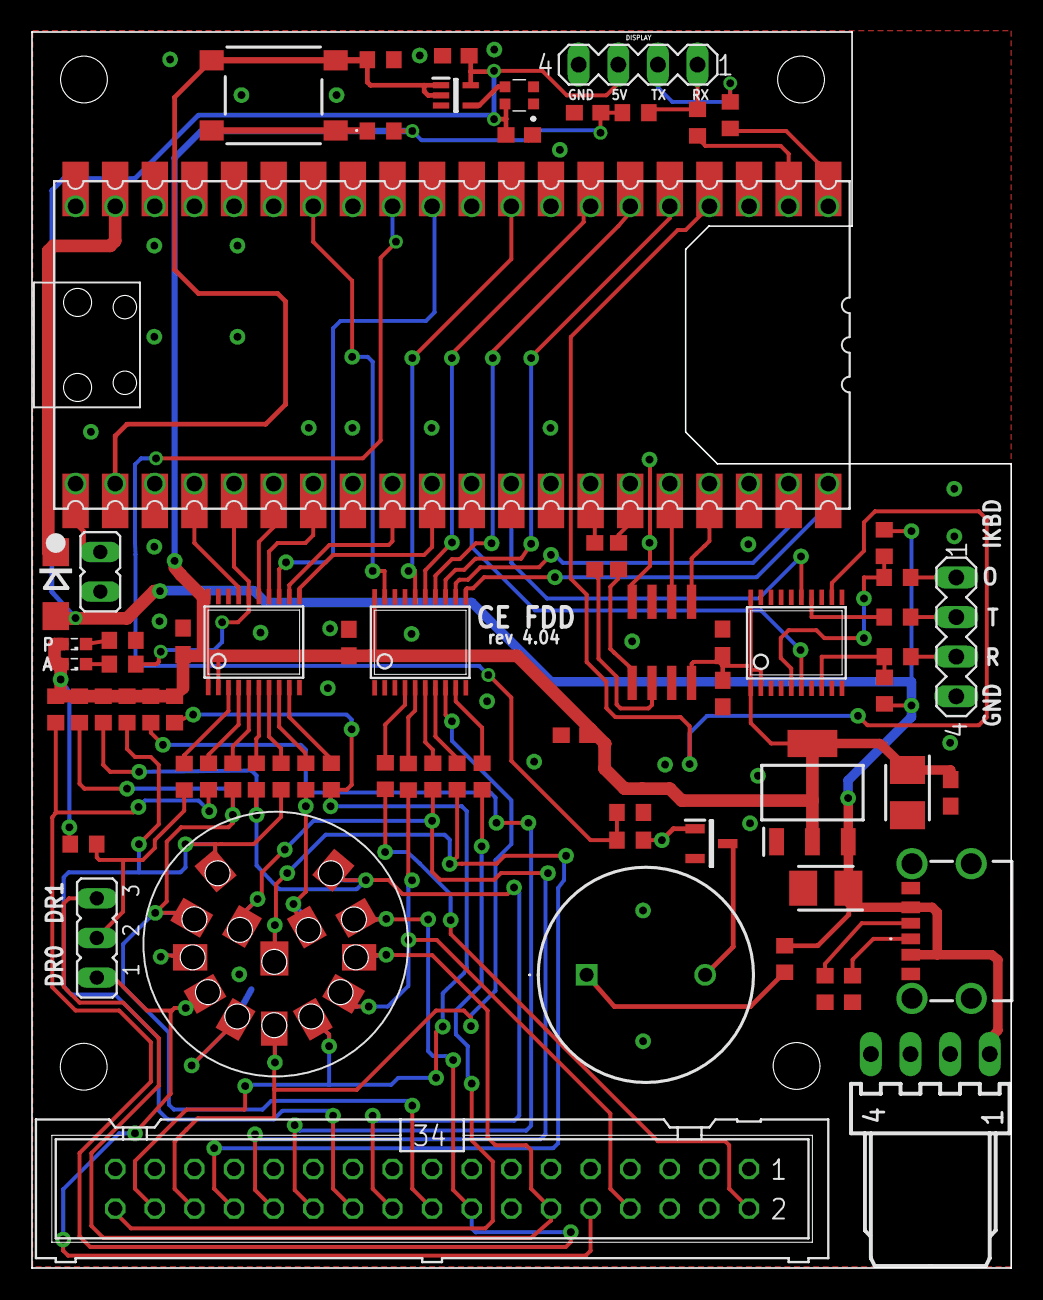
[picture p23: board ce_fdd_v40.brd from above]

Board: 2 copper layers, 62.8 x 79.2 mm, 71 parts (0 on the bottom side), 78 nets.
