atarijookie/cosmo2ex/devices/v40_pico_acsi/ce_acsi_v40.brd

## EAGLE design devices/v40_pico_acsi/ce_acsi_v40.brd (2026-10-16)

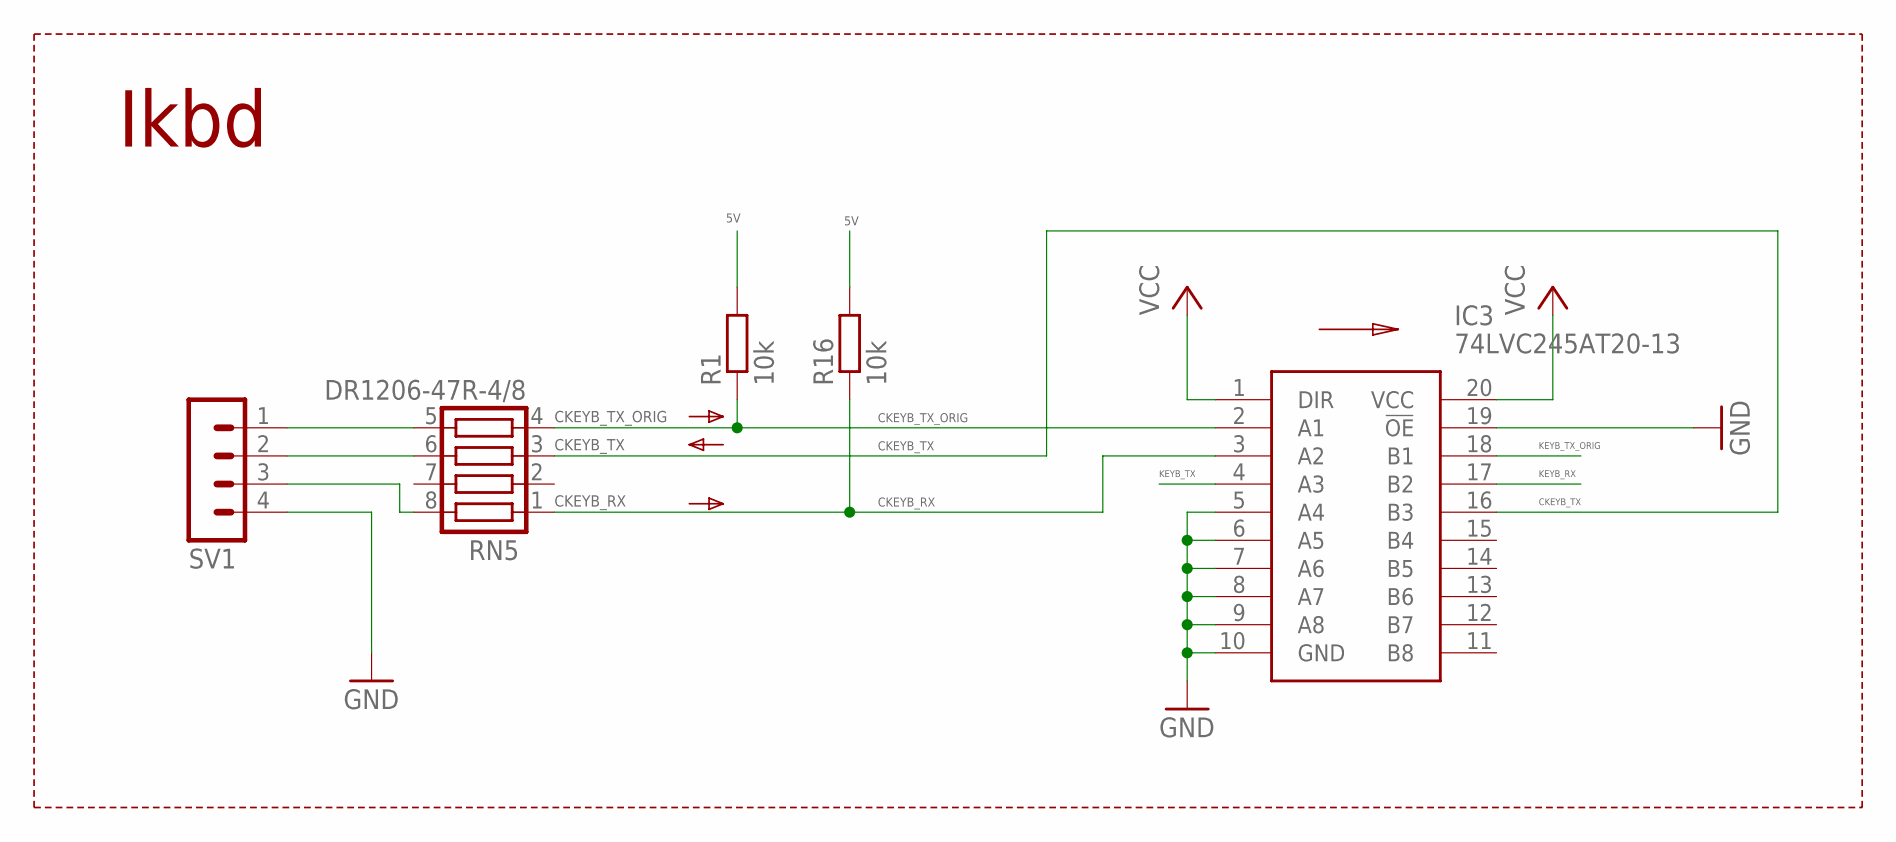
[picture p24: schematic ce_acsi_v40.sch, sheet 1, IKBD part]

Parts:
IC3: 74LVC245AT20-13; SOP65P640X120-20N
R1, R16: 10k; R0603
RN5: DR1206-47R-4/8; CTS742C083
SV1: MA04-1

Connections:
5V: R1.2, R16.2; also elsewhere on the board
CKEYB_RX: IC3.3 (A2), R16.1, RN5.1
CKEYB_TX: IC3.16 (B3), RN5.3
CKEYB_TX_ORIG: IC3.2 (A1), R1.1, RN5.4
GND: IC3.5 (A4), IC3.6 (A5), IC3.7 (A6), IC3.8 (A7), IC3.9 (A8), IC3.10 (GND), IC3.19 (!OE), SV1.4; also elsewhere on the board
KEYB_RX: IC3.17 (B2); also elsewhere on the board
KEYB_TX: IC3.4 (A3); also elsewhere on the board
KEYB_TX_ORIG: IC3.18 (B1); also elsewhere on the board
unnamed: RN5.6, SV1.2
VCC: IC3.1 (DIR), IC3.20 (VCC); also elsewhere on the board
ZKEYB_RX: RN5.8, SV1.3
ZKEYB_TX_ORIG: RN5.5, SV1.1

Notes on the sheet:
Ikbd
