atarijookie/cosmo2ex/devices/v40_pico_acsi/ce_acsi_v40.brd

## EAGLE design devices/v40_pico_acsi/ce_acsi_v40.brd (continued)

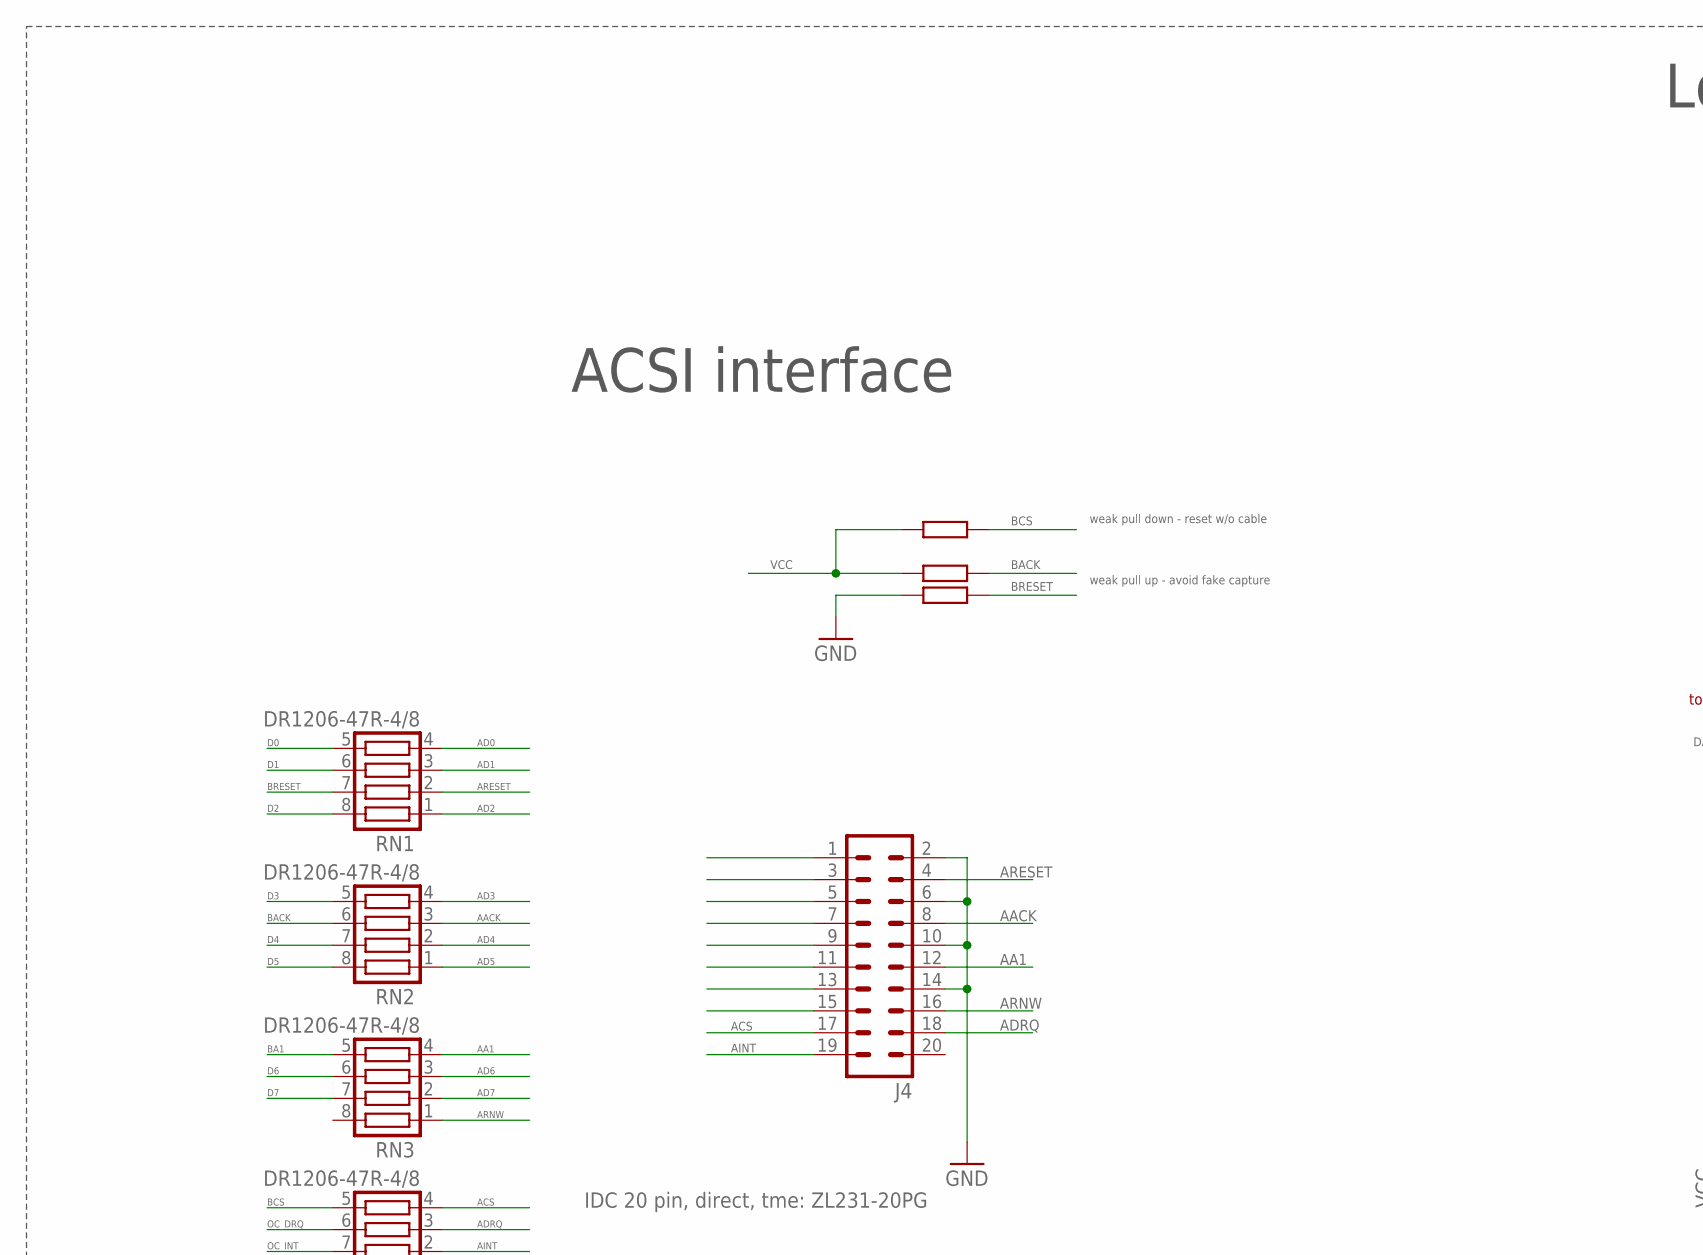
[picture p25: schematic ce_acsi_v40.sch, sheet 2, ACSI part, part in row 1, column 1]

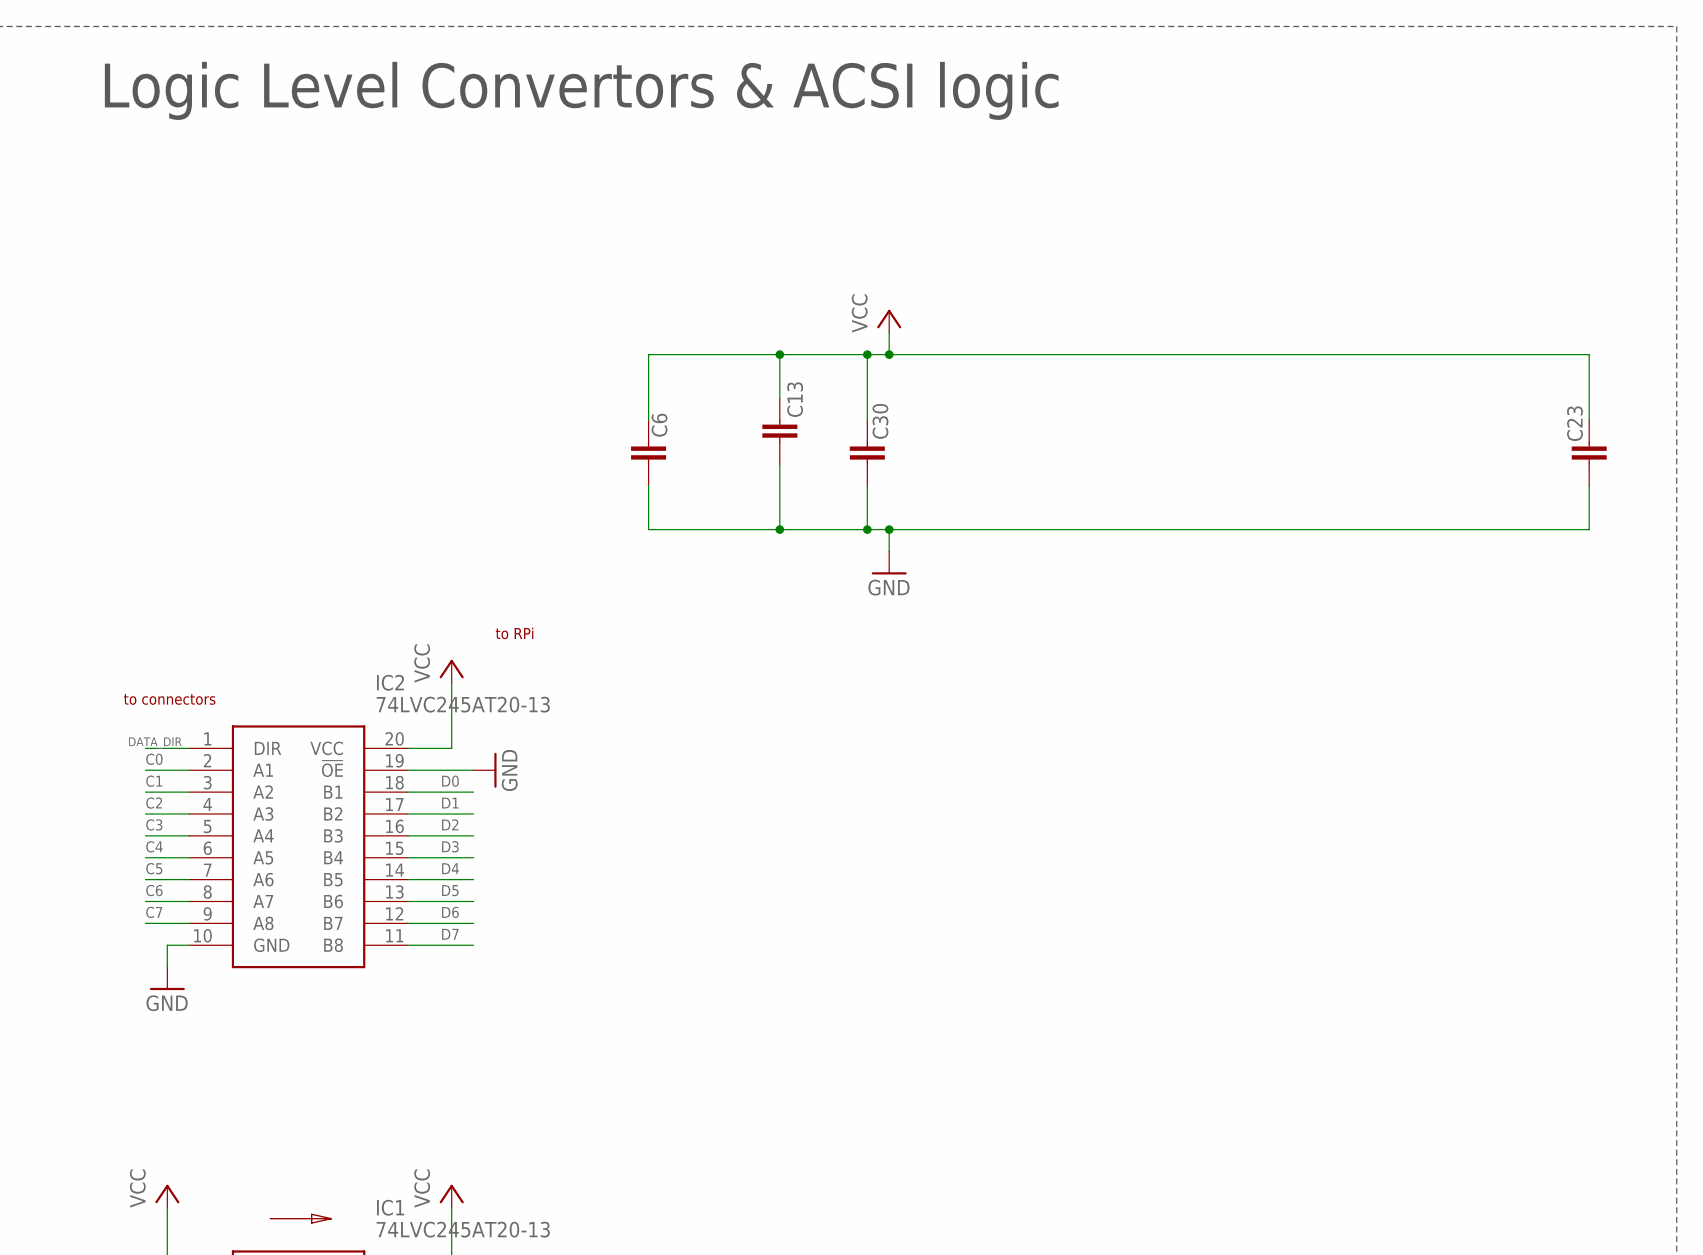
[picture p26: schematic ce_acsi_v40.sch, sheet 2, ACSI part, part in row 1, column 2]

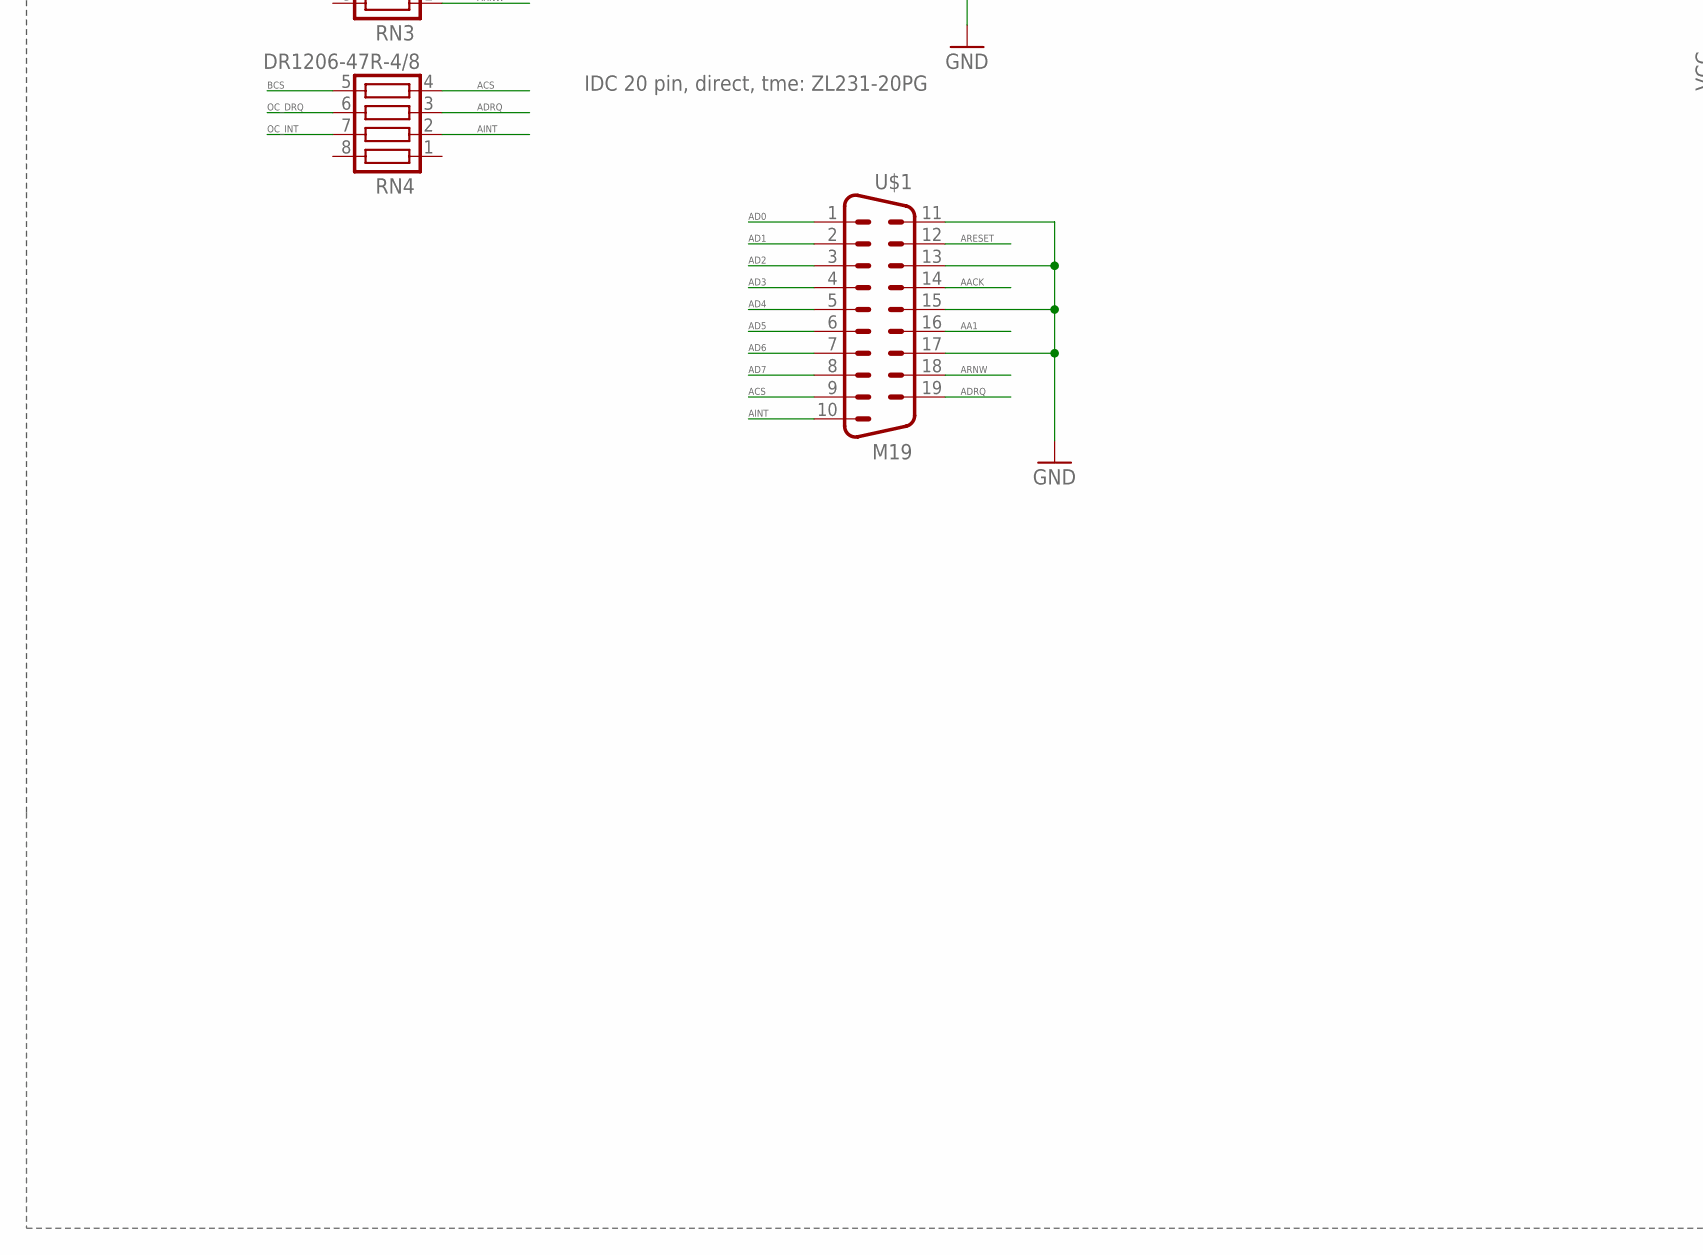
[picture p27: schematic ce_acsi_v40.sch, sheet 2, ACSI part, part in row 2, column 1]

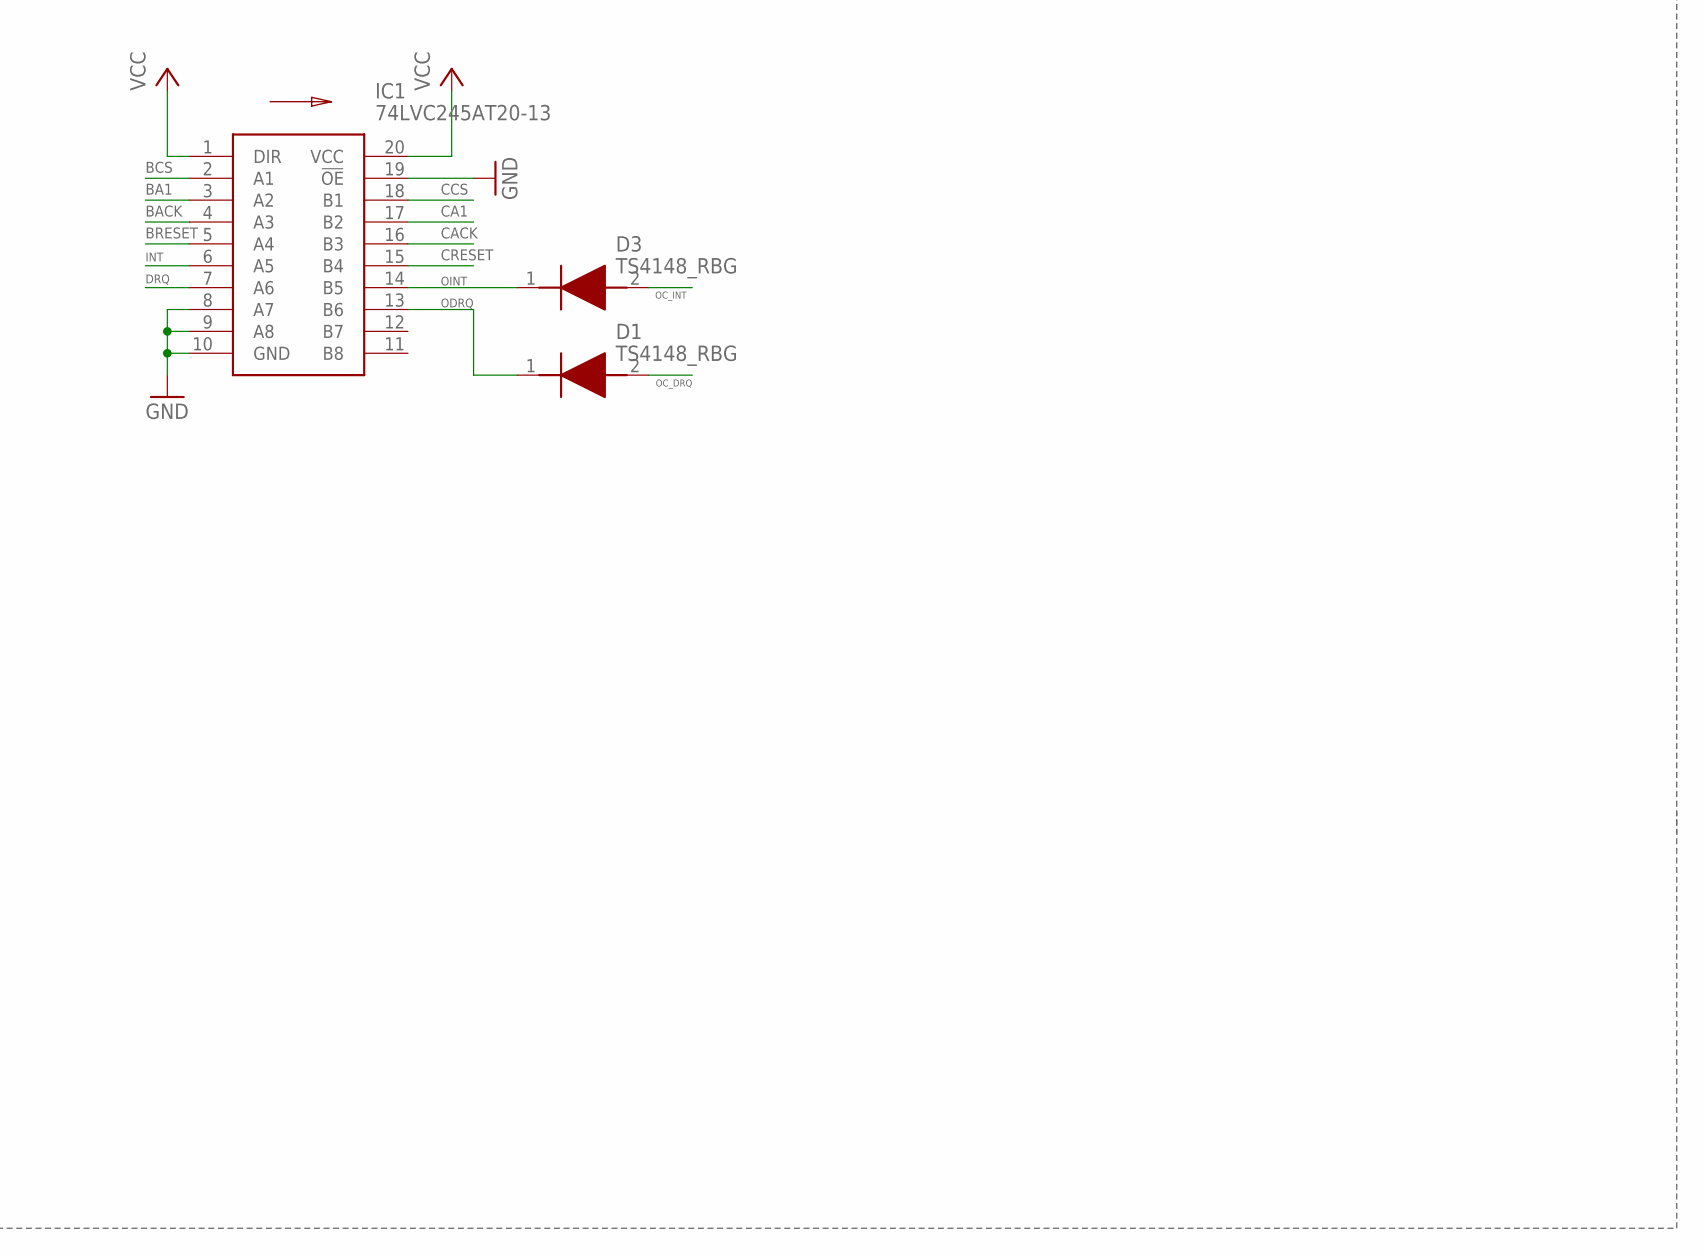
[picture p28: schematic ce_acsi_v40.sch, sheet 2, ACSI part, part in row 2, column 2]

Parts:
C6, C13, C23: 100 nF; C0603
C30: 1 uF; C0805
D1: TS4148_RBG; DIOC2012X85N; MANUFACTURER_PART_NUMBER TS4148 RBG
D3: TS4148_RBG; DIOC2012X85N
IC1, IC2: 74LVC245AT20-13; SOP65P640X120-20N
J4: IDC 20 pin, direct, tme: ZL231-20PG; ML20
R30, R31, R32: 10k; R0603
RN1, RN2, RN3, RN4: DR1206-47R-4/8; CTS742C083
U$1: M19

Connections:
AA1: J4.12, RN3.4, U$1.16
AACK: J4.8, RN2.3, U$1.14
ACS: J4.17, RN4.4, U$1.9
AD0: J4.1, RN1.4, U$1.1
AD1: J4.3, RN1.3, U$1.2
AD2: J4.5, RN1.1, U$1.3
AD3: J4.7, RN2.4, U$1.4
AD4: J4.9, RN2.2, U$1.5
AD5: J4.11, RN2.1, U$1.6
AD6: J4.13, RN3.3, U$1.7
AD7: J4.15, RN3.2, U$1.8
ADRQ: J4.18, RN4.3, U$1.19
AINT: J4.19, RN4.2, U$1.10
ARESET: J4.4, RN1.2, U$1.12
ARNW: J4.16, RN3.1, U$1.18
BA1: IC1.3 (A2), RN3.5
BACK: IC1.4 (A3), R31.2, RN2.6
BCS: IC1.2 (A1), R32.2, RN4.5
BRESET: IC1.5 (A4), R30.2, RN1.7
C0: IC2.2 (A1); also elsewhere on the board
C1: IC2.3 (A2); also elsewhere on the board
C2: IC2.4 (A3); also elsewhere on the board
C3: IC2.5 (A4); also elsewhere on the board
C4: IC2.6 (A5); also elsewhere on the board
C5: IC2.7 (A6); also elsewhere on the board
C6: IC2.8 (A7); also elsewhere on the board
C7: IC2.9 (A8); also elsewhere on the board
CA1: IC1.17 (B2); also elsewhere on the board
CACK: IC1.16 (B3); also elsewhere on the board
CCS: IC1.18 (B1); also elsewhere on the board
CRESET: IC1.15 (B4); also elsewhere on the board
D0: IC2.18 (B1), RN1.5
D1: IC2.17 (B2), RN1.6
D2: IC2.16 (B3), RN1.8
D3: IC2.15 (B4), RN2.5
D4: IC2.14 (B5), RN2.7
D5: IC2.13 (B6), RN2.8
D6: IC2.12 (B7), RN3.6
D7: IC2.11 (B8), RN3.7
DATA_DIR: IC2.1 (DIR); also elsewhere on the board
DRQ: IC1.7 (A6); also elsewhere on the board
GND: C6.2, C13.2, C23.2, C30.2, IC1.8 (A7), IC1.9 (A8), IC1.10 (GND), IC1.19 (!OE), IC2.10 (GND), IC2.19 (!OE), J4.2, J4.6, J4.10, J4.14, R30.1, U$1.11, U$1.13, U$1.15, U$1.17; also elsewhere on the board
INT: IC1.6 (A5); also elsewhere on the board
OC_DRQ: D1.2 (A), RN4.6
OC_INT: D3.2 (A), RN4.7
ODRQ: D1.1 (K), IC1.13 (B6)
OINT: D3.1 (K), IC1.14 (B5)
VCC: C6.1, C13.1, C23.1, C30.1, IC1.1 (DIR), IC1.20 (VCC), IC2.20 (VCC), R31.1, R32.1; also elsewhere on the board

Notes on the sheet:
ACSI interface
to connectors
to RPi
Logic Level Convertors & ACSI logic
weak pull down - reset w/o cable
weak pull up - avoid fake capture

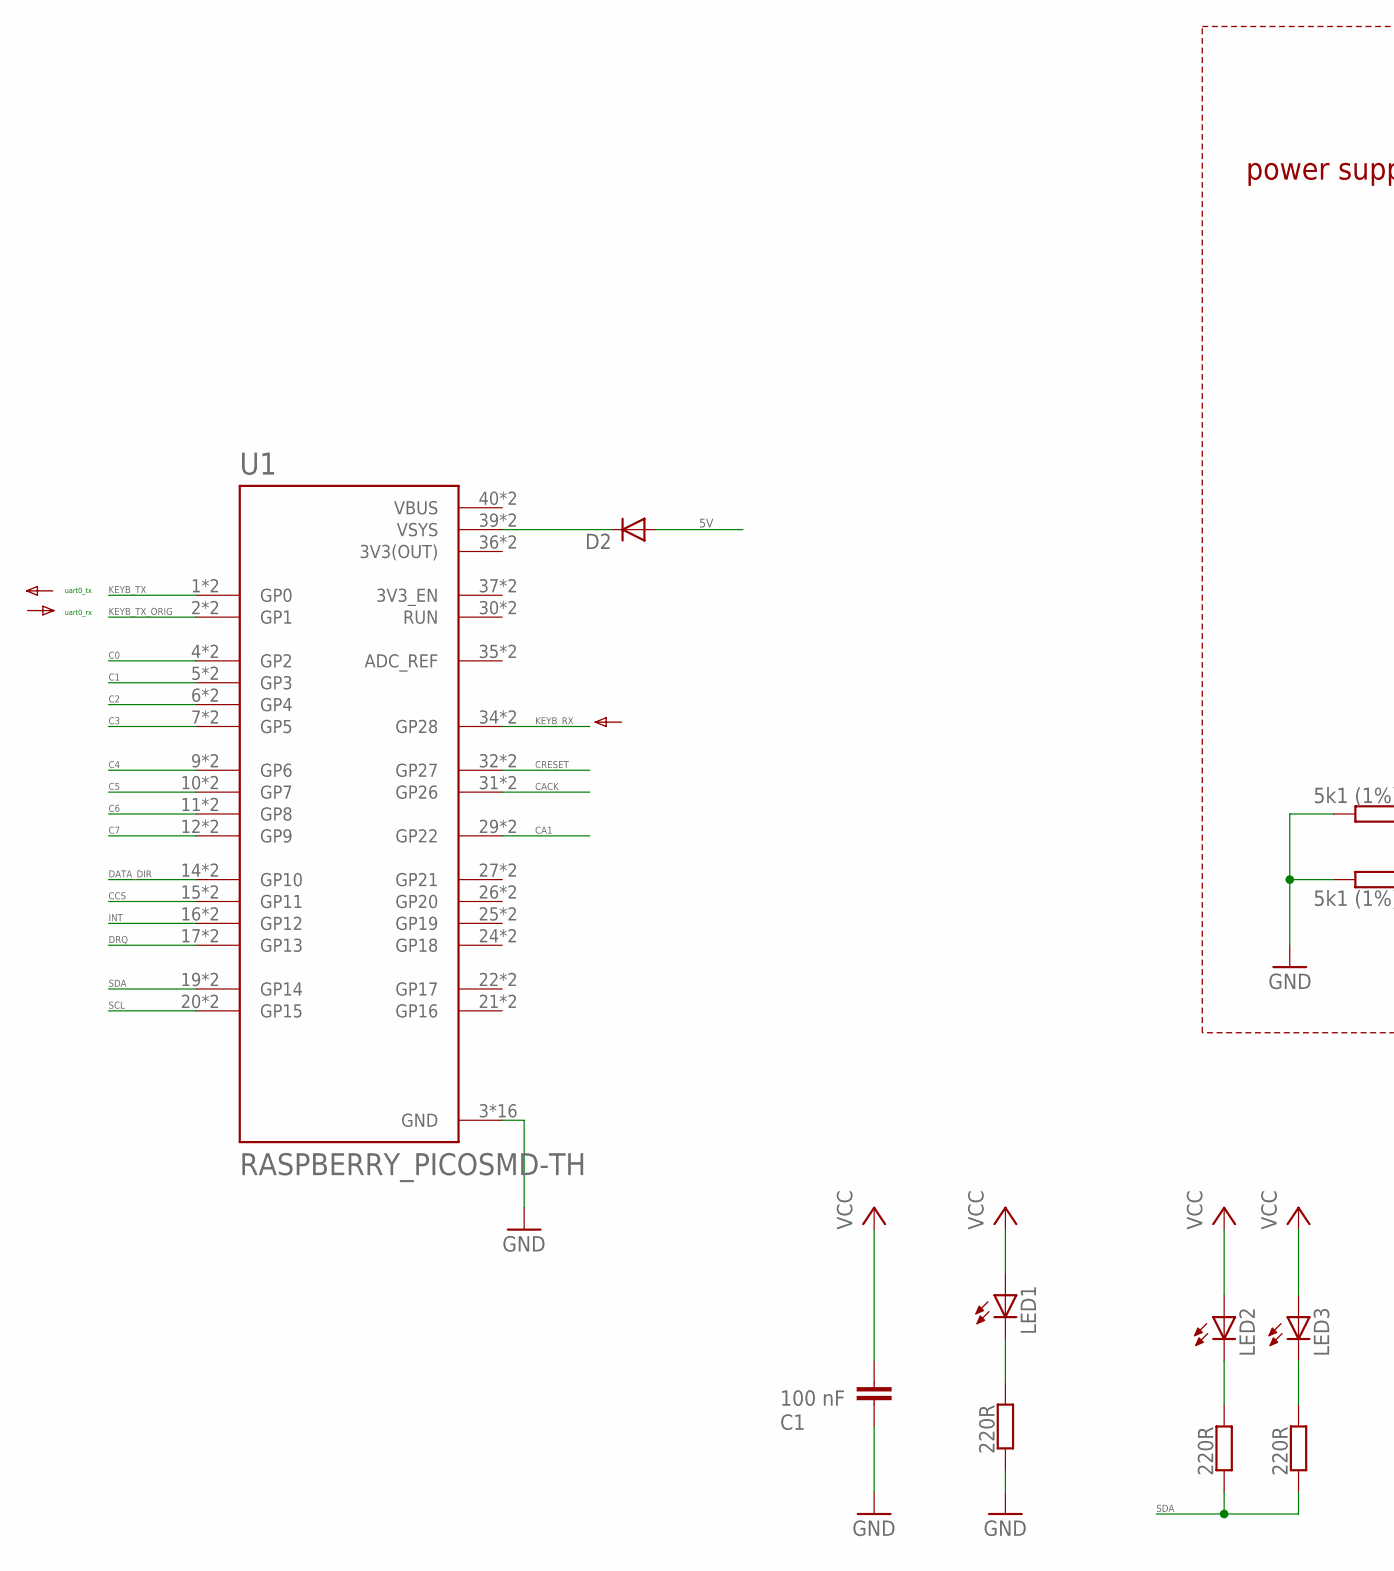
[picture p29: schematic ce_acsi_v40.sch, sheet 3, Front panel, power supply and RPi connection parts, part in row 1, column 1]

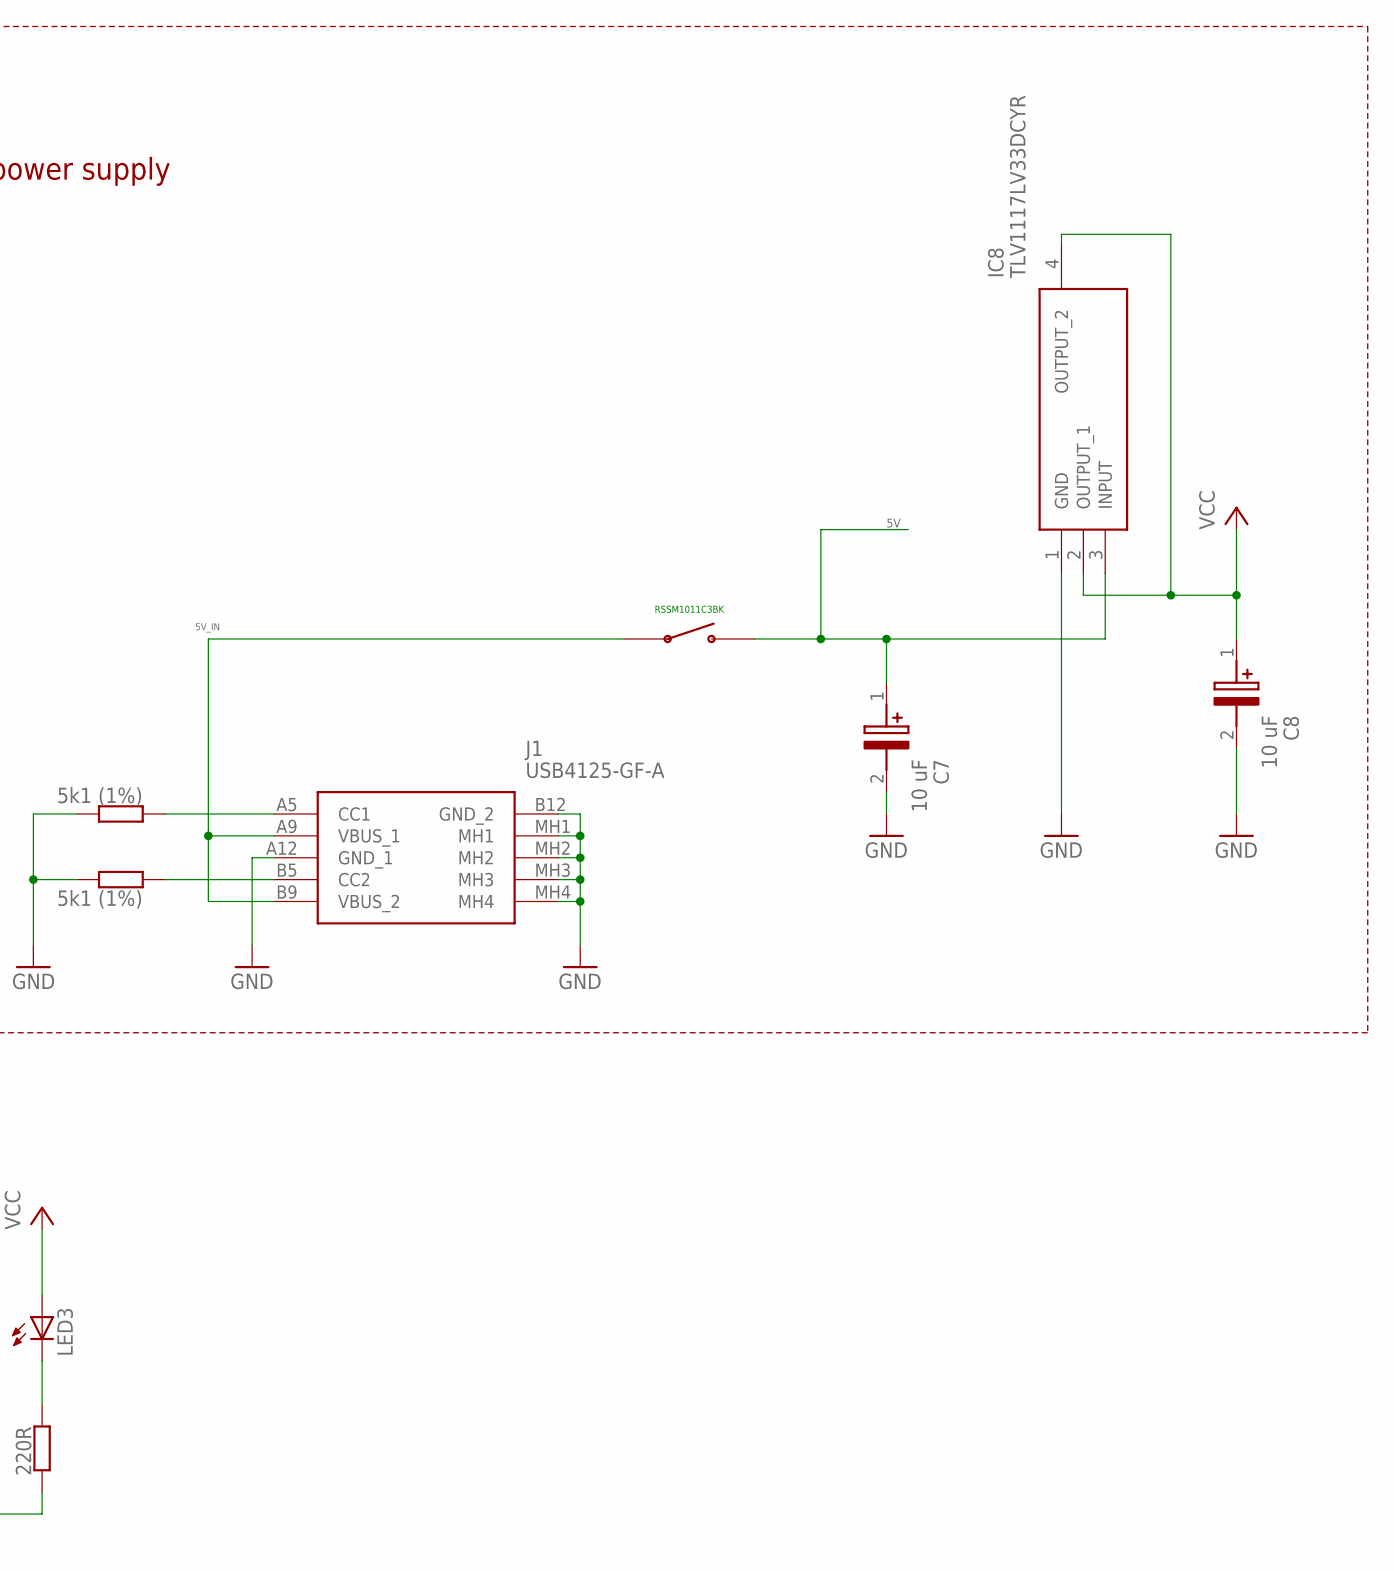
[picture p30: schematic ce_acsi_v40.sch, sheet 3, Front panel, power supply and RPi connection parts, part in row 1, column 2]

Parts:
C1: 100 nF; C0603
C7, C8: 10 uF; CAPPM3528X210N
D2: SK110-DIO; DO214AC
IC8: TLV1117LV33DCYR; SOT230P700X180-4N
J1: USB4125-GF-A; USB4125GFA
LED1, LED2, LED3: LEDSML0603; SML0603
R2, R3, R18: 220R; R0603
R14, R17: 5k1 (1%); R0603
U1: RASPBERRY_PICOSMD-TH; PICO-PKG
U$2: RSSM1011C3BK

Connections:
3V3(OUT): U1.36 (3V3(OUT)), U1.P$36 (3V3(OUT))
5V: C7.1 (+), D2.A, IC8.3 (INPUT), U$2.P$2; also elsewhere on the board
5V_IN: J1.A9 (VBUS_1), J1.B9 (VBUS_2), U$2.P$1
C0: U1.4 (GP2), U1.P$4 (GP2); also elsewhere on the board
C1: U1.5 (GP3), U1.P$5 (GP3); also elsewhere on the board
C2: U1.6 (GP4), U1.P$6 (GP4); also elsewhere on the board
C3: U1.7 (GP5), U1.P$7 (GP5); also elsewhere on the board
C4: U1.9 (GP6), U1.P$9 (GP6); also elsewhere on the board
C5: U1.10 (GP7), U1.P$10 (GP7); also elsewhere on the board
C6: U1.11 (GP8), U1.P$11 (GP8); also elsewhere on the board
C7: U1.12 (GP9), U1.P$12 (GP9); also elsewhere on the board
CA1: U1.29 (GP22), U1.P$29 (GP22); also elsewhere on the board
CACK: U1.31 (GP26), U1.P$31 (GP26); also elsewhere on the board
CCS: U1.15 (GP11), U1.P$15 (GP11); also elsewhere on the board
CRESET: U1.32 (GP27), U1.P$32 (GP27); also elsewhere on the board
DATA_DIR: U1.14 (GP10), U1.P$14 (GP10); also elsewhere on the board
DRQ: U1.17 (GP13), U1.P$17 (GP13); also elsewhere on the board
GND: C1.2, C7.2 (-), C8.2 (-), IC8.1 (GND), J1.A12 (GND_1), J1.B12 (GND_2), J1.MH1, J1.MH2, J1.MH3, J1.MH4, R14.2, R17.2, R18.2, U1.3 (GND), U1.8 (GND), U1.13 (GND), U1.18 (GND), U1.23 (GND), U1.28 (GND), U1.33 (GND), U1.38 (GND), U1.P$3 (GND), U1.P$8 (GND), U1.P$13 (GND), U1.P$18 (GND), U1.P$23 (GND), U1.P$28 (GND), U1.P$33 (GND), U1.P$38 (GND); also elsewhere on the board
INT: U1.16 (GP12), U1.P$16 (GP12); also elsewhere on the board
KEYB_RX: U1.34 (GP28), U1.P$34 (GP28); also elsewhere on the board
KEYB_TX: U1.1 (GP0), U1.P$1 (GP0); also elsewhere on the board
KEYB_TX_ORIG: U1.2 (GP1), U1.P$2 (GP1); also elsewhere on the board
unnamed: J1.B5 (CC2), R14.1
unnamed: J1.A5 (CC1), R17.1
unnamed: LED2.C, R2.1
unnamed: LED3.C, R3.1
unnamed: LED1.C, R18.1
unnamed: D2.C, U1.39 (VSYS), U1.P$39 (VSYS)
SCL: U1.20 (GP15), U1.P$20 (GP15)
SDA: R2.2, R3.2, U1.19 (GP14), U1.P$19 (GP14)
VBUS: U1.40 (VBUS), U1.P$40 (VBUS)
VCC: C1.1, C8.1 (+), IC8.2 (OUTPUT_1), IC8.4 (OUTPUT_2), LED1.A, LED2.A, LED3.A; also elsewhere on the board

Notes on the sheet:
power supply
uart0_rx
uart0_tx
RSSM1011C3BK

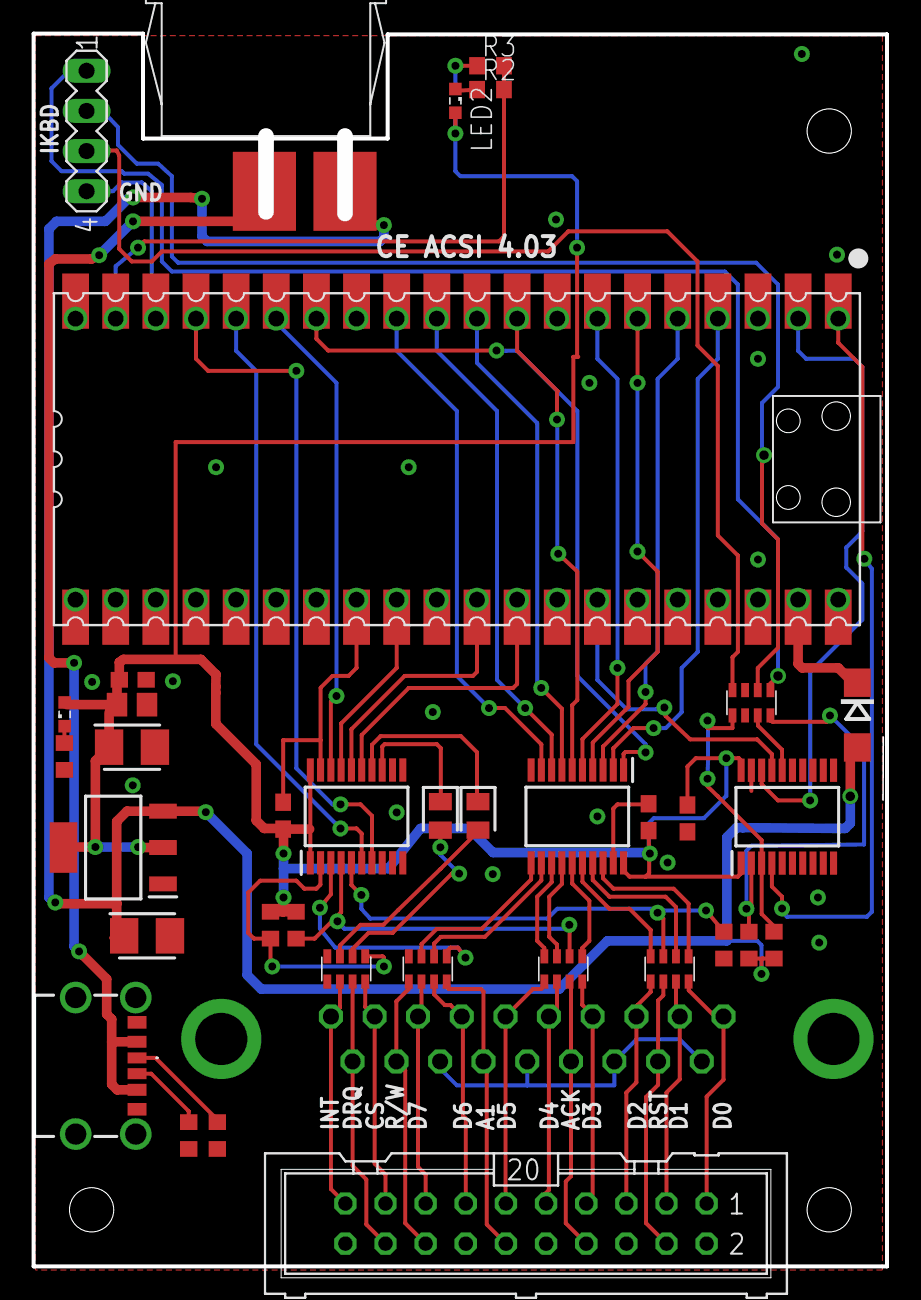
[picture p31: board ce_acsi_v40.brd from above]

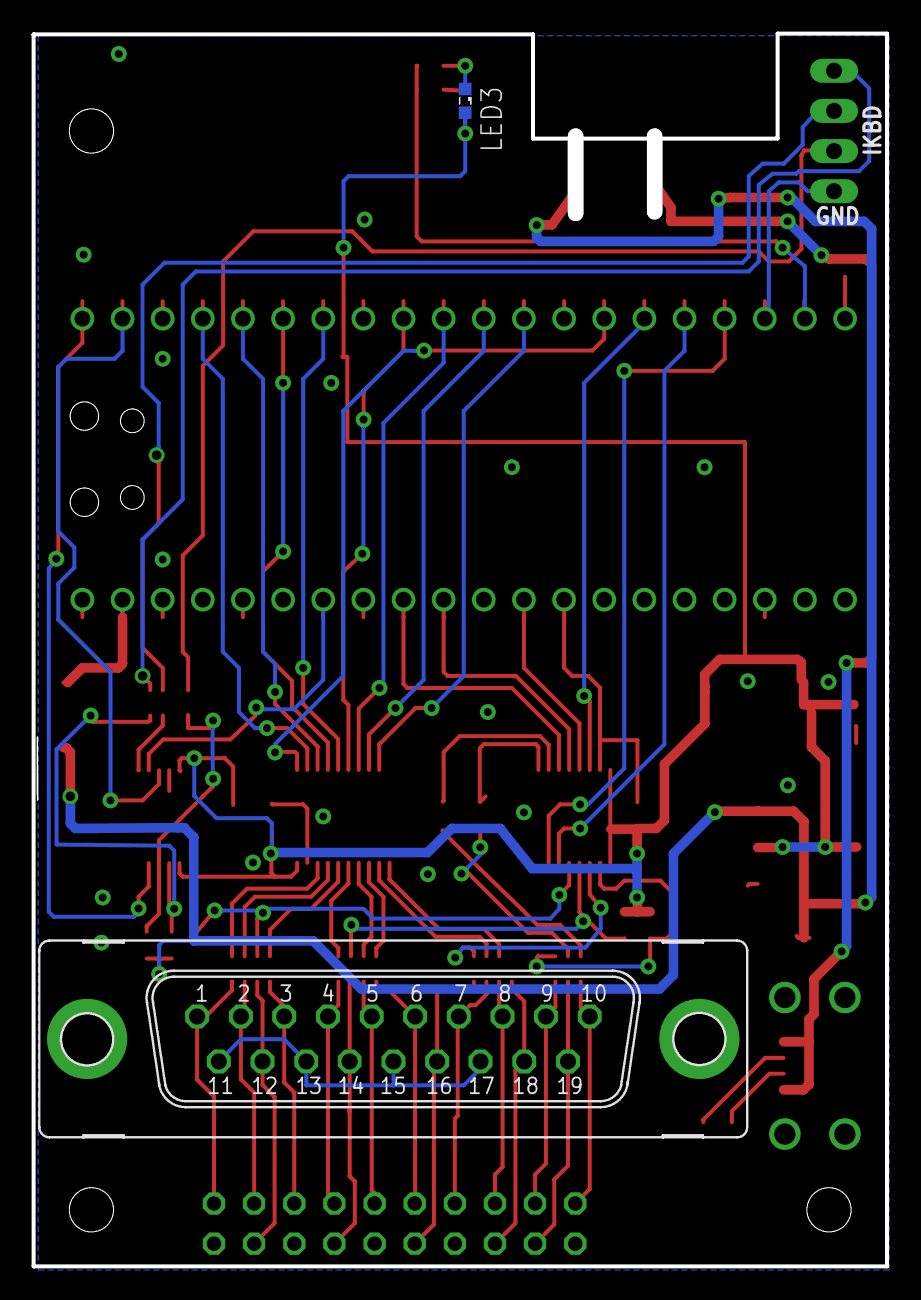
[picture p32: board ce_acsi_v40.brd from below]

Board: 2 copper layers, 54.0 x 78.0 mm, 38 parts (2 on the bottom side), 69 nets.
