atarijookie/cosmo2ex/devices/v40_pico_scsi/ce_scsi_v40.brd

## EAGLE design devices/v40_pico_scsi/ce_scsi_v40.brd (2026-10-16)

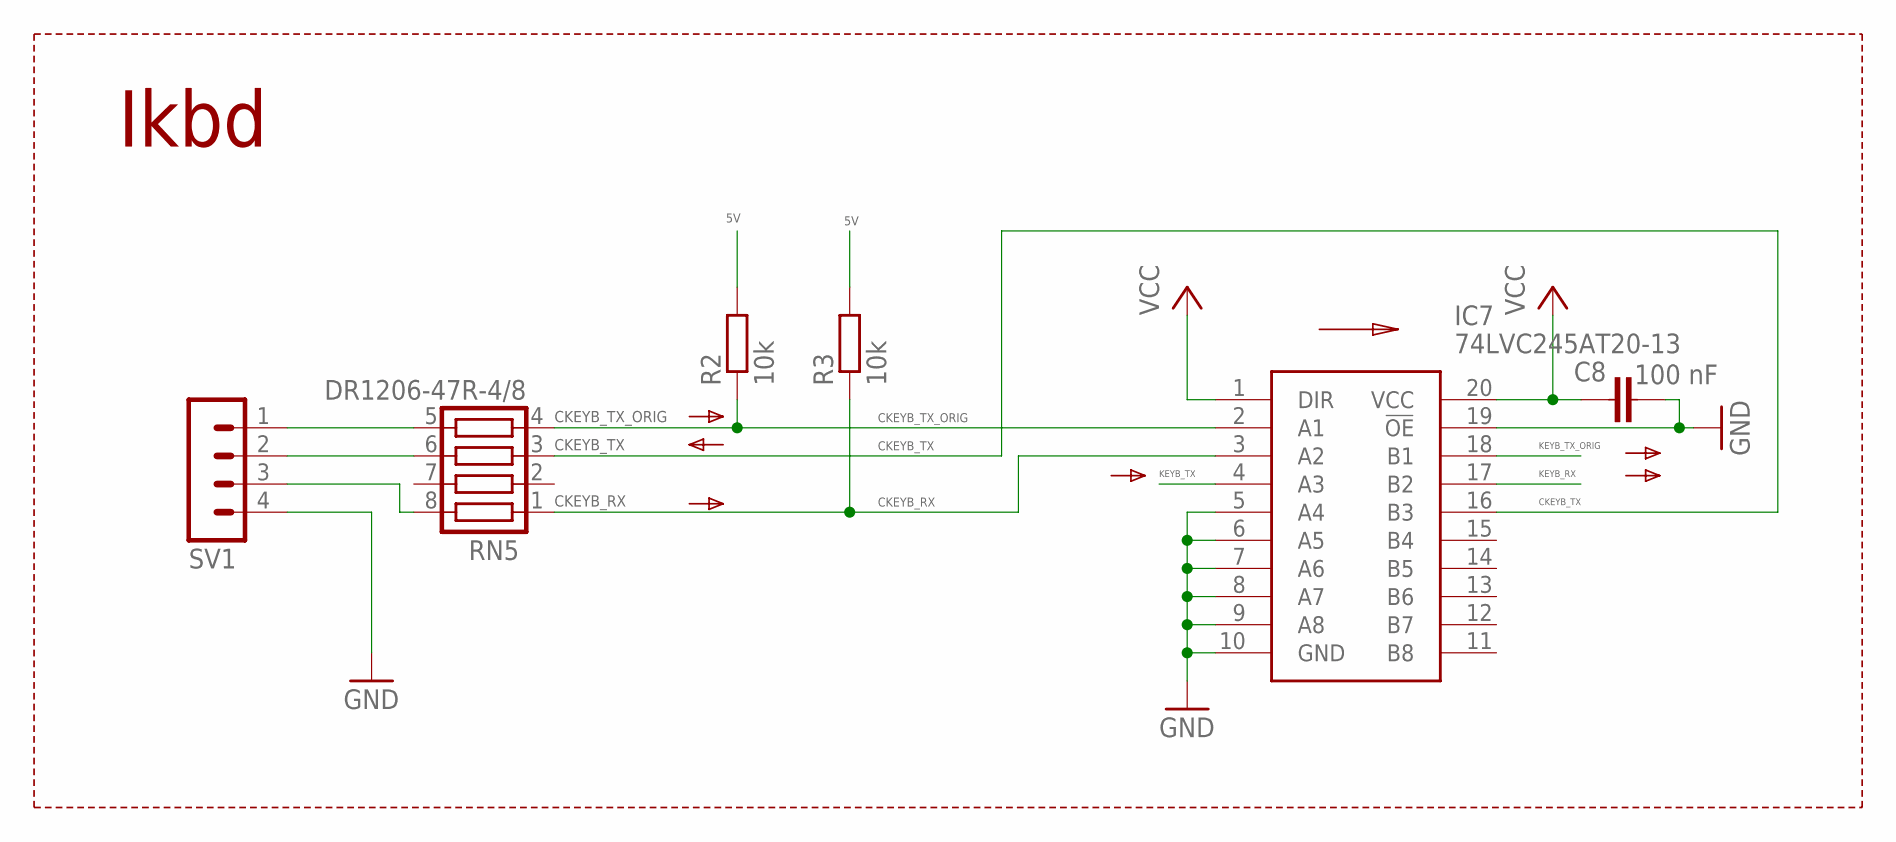
[picture p33: schematic ce_scsi_v40.sch, sheet 1, IKBD part]

Parts:
C8: 100 nF; C0603
IC7: 74LVC245AT20-13; SOP65P640X120-20N
R2, R3: 10k; R0603
RN5: DR1206-47R-4/8; CTS742C083
SV1: MA04-1

Connections:
5V: R2.2, R3.2; also elsewhere on the board
CKEYB_RX: IC7.3 (A2), R3.1, RN5.1
CKEYB_TX: IC7.16 (B3), RN5.3
CKEYB_TX_ORIG: IC7.2 (A1), R2.1, RN5.4
GND: C8.1, IC7.5 (A4), IC7.6 (A5), IC7.7 (A6), IC7.8 (A7), IC7.9 (A8), IC7.10 (GND), IC7.19 (!OE), SV1.4; also elsewhere on the board
KEYB_RX: IC7.17 (B2); also elsewhere on the board
KEYB_TX: IC7.4 (A3); also elsewhere on the board
KEYB_TX_ORIG: IC7.18 (B1); also elsewhere on the board
unnamed: RN5.6, SV1.2
VCC: C8.2, IC7.1 (DIR), IC7.20 (VCC); also elsewhere on the board
ZKEYB_RX: RN5.8, SV1.3
ZKEYB_TX_ORIG: RN5.5, SV1.1

Notes on the sheet:
Ikbd
