atarijookie/cosmo2ex/devices/v40_pico_scsi/ce_scsi_v40.brd

## EAGLE design devices/v40_pico_scsi/ce_scsi_v40.brd (continued)

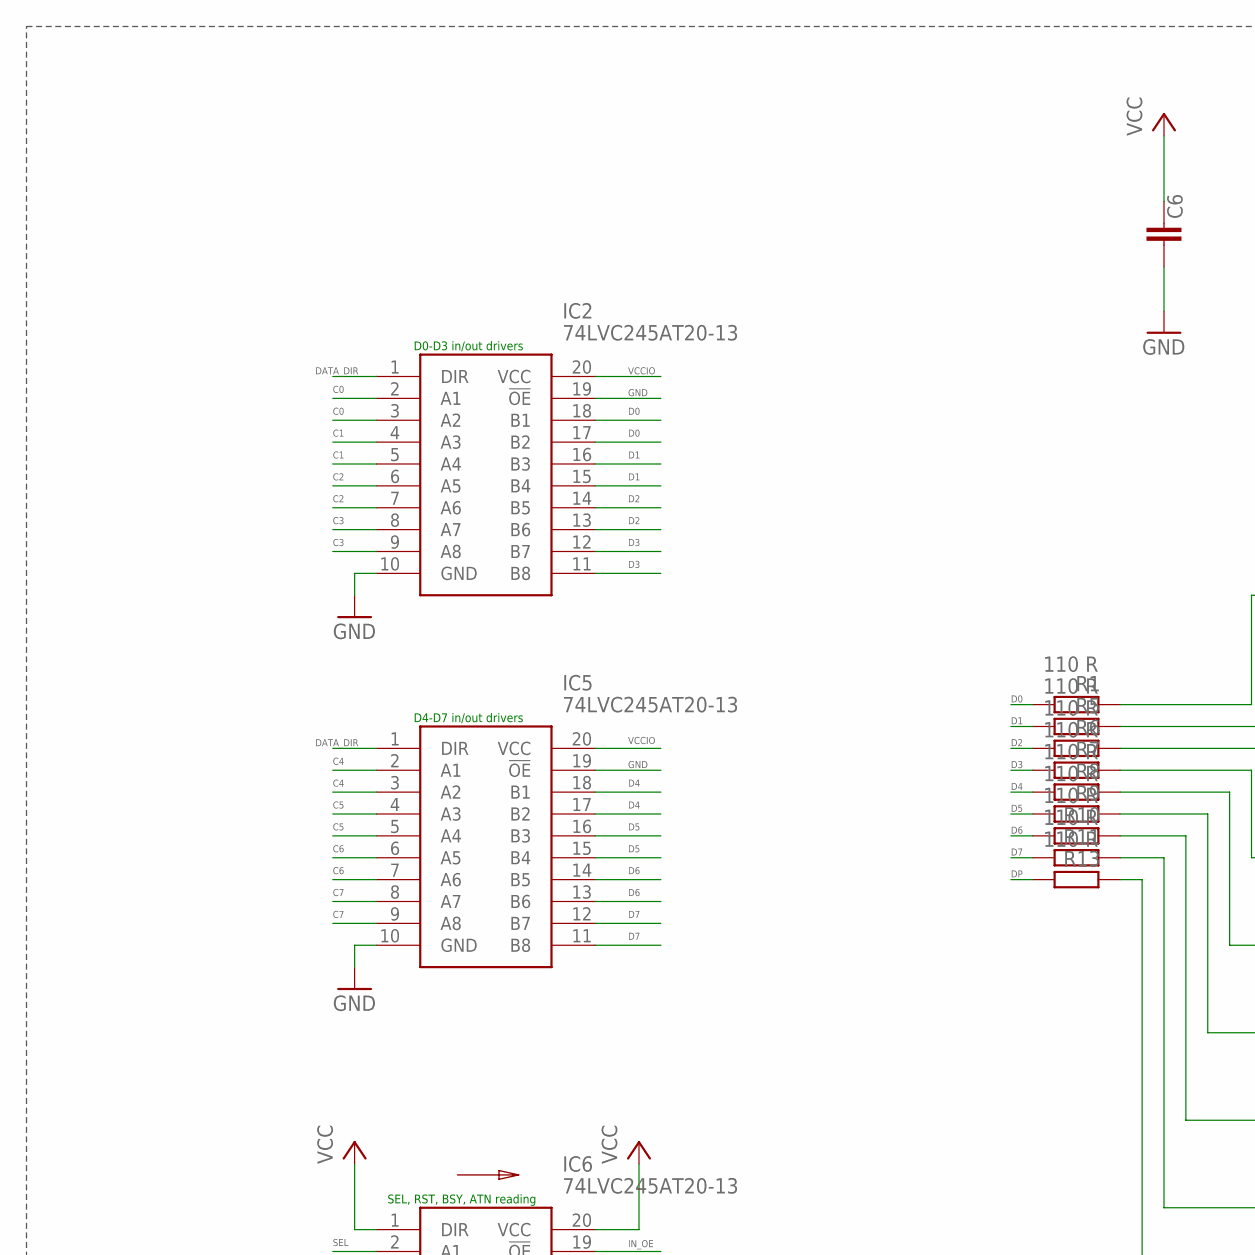
[picture p34: schematic ce_scsi_v40.sch, sheet 2, SCSI drivers, part in row 1, column 1]

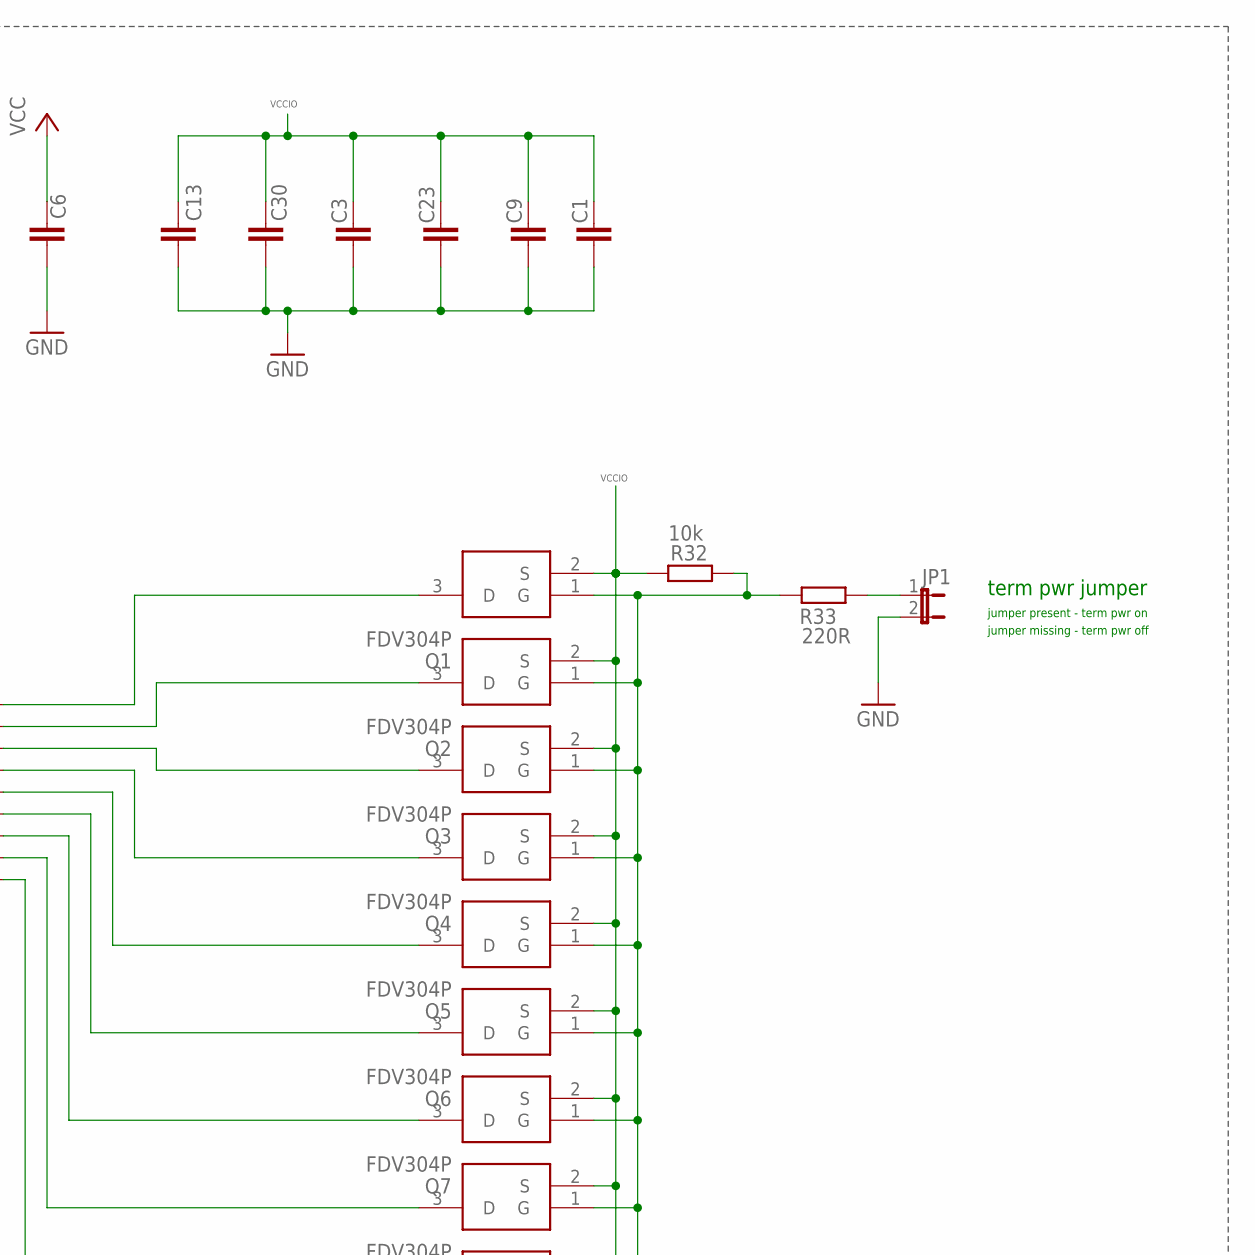
[picture p35: schematic ce_scsi_v40.sch, sheet 2, SCSI drivers, part in row 1, column 2]

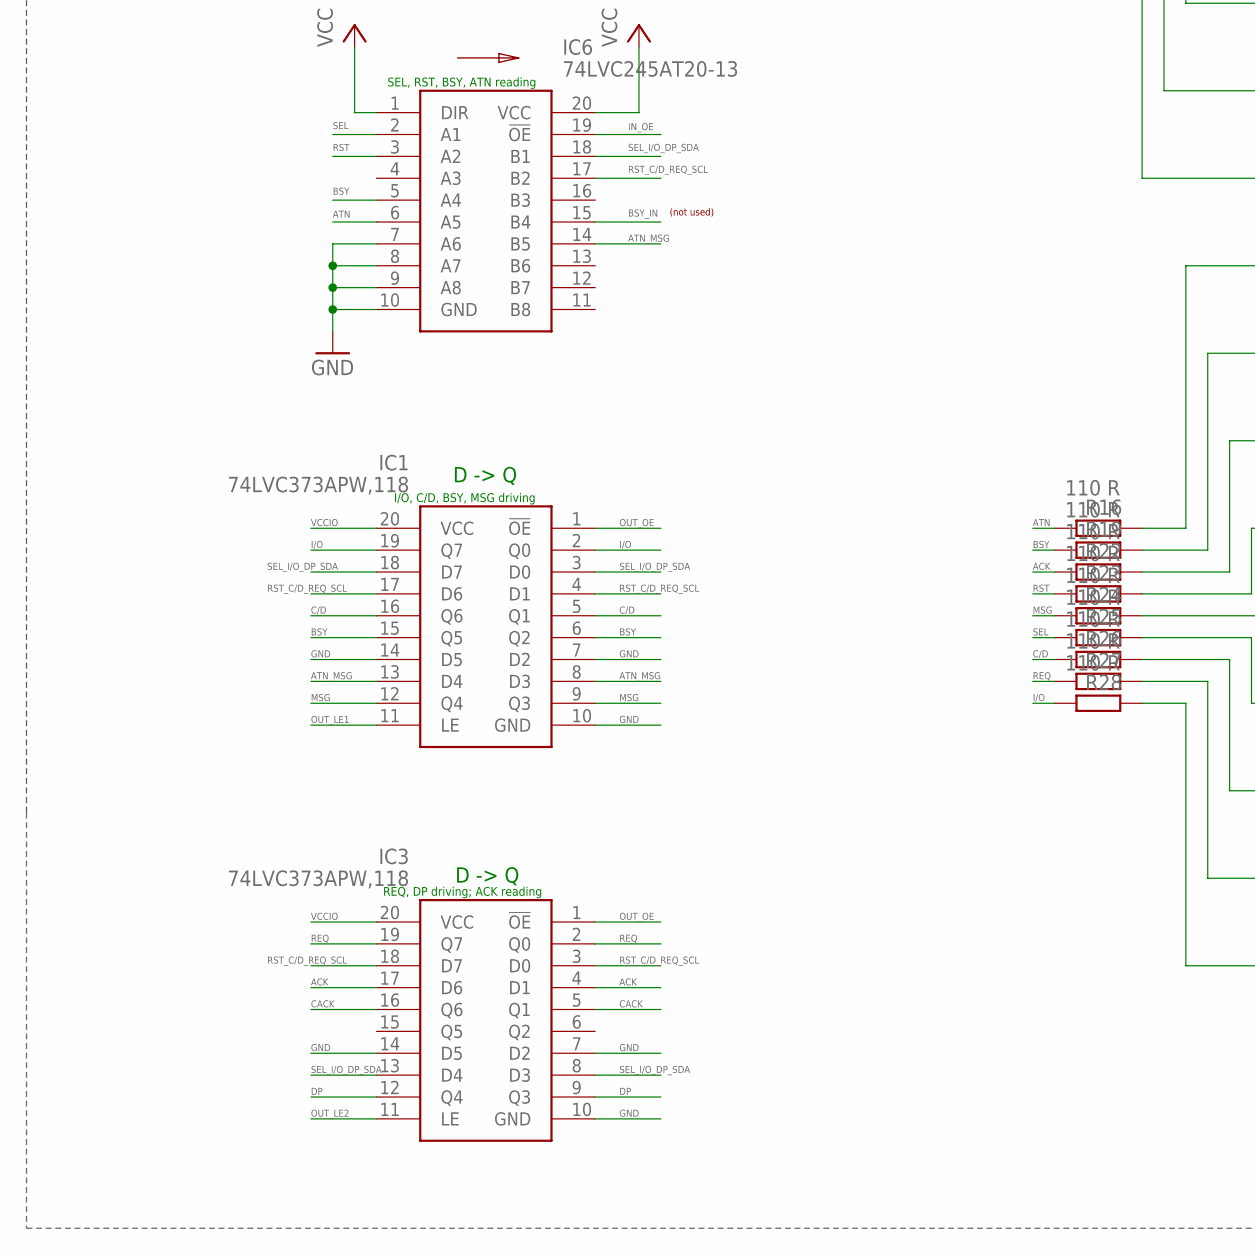
[picture p36: schematic ce_scsi_v40.sch, sheet 2, SCSI drivers, part in row 2, column 1]

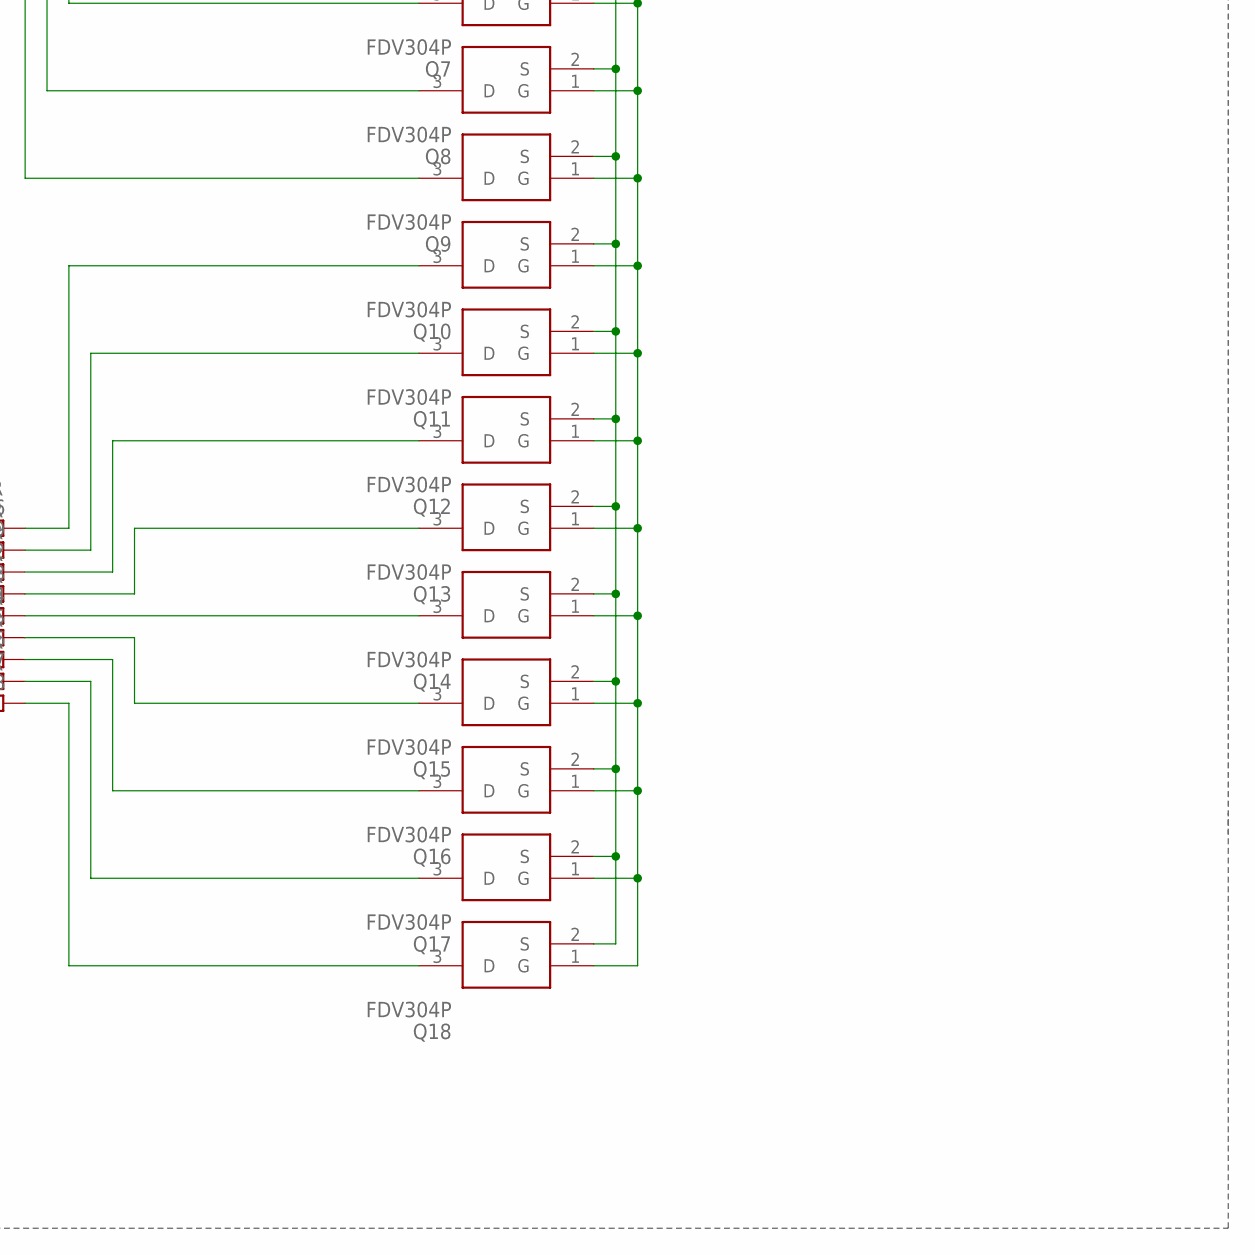
[picture p37: schematic ce_scsi_v40.sch, sheet 2, SCSI drivers, part in row 2, column 2]

Parts:
C1, C3, C6, C9, C13, C23: 100 nF; C0603
C30: 1 uF; C0805
IC1, IC3: 74LVC373APW,118; SOP65P640X110-20N
IC2, IC5, IC6: 74LVC245AT20-13; SOP65P640X120-20N
JP1: JP1E; JP1
Q1, Q2, Q3, Q4, Q5, Q6, Q7, Q8, Q9, Q10, Q11, Q12, Q13, Q14, Q15, Q16, Q17, Q18: FDV304P; SOT95P237X112-3N
R1, R5, R6, R7, R8, R9, R10, R11, R13, R16, R19, R22, R23, R24, R25, R26, R27, R28: 110 R; R0603
R32: 10k; R0603
R33: 220R; R0603

Connections:
AAAA: Q1.3 (D), R1.1
ACK: IC3.4 (D1), IC3.17 (D6), R22.2; also elsewhere on the board
ATN: IC6.6 (A5), R16.2; also elsewhere on the board
ATN_MSG: IC1.8 (D3), IC1.13 (D4), IC6.14 (B5); also elsewhere on the board
BSY: IC1.6 (Q2), IC1.15 (Q5), IC6.5 (A4), R19.2; also elsewhere on the board
BSY_IN: IC6.15 (B4)
C0: IC2.2 (A1), IC2.3 (A2); also elsewhere on the board
C1: IC2.4 (A3), IC2.5 (A4); also elsewhere on the board
C2: IC2.6 (A5), IC2.7 (A6); also elsewhere on the board
C3: IC2.8 (A7), IC2.9 (A8); also elsewhere on the board
C4: IC5.2 (A1), IC5.3 (A2); also elsewhere on the board
C5: IC5.4 (A3), IC5.5 (A4); also elsewhere on the board
C6: IC5.6 (A5), IC5.7 (A6); also elsewhere on the board
C7: IC5.8 (A7), IC5.9 (A8); also elsewhere on the board
C/D: IC1.5 (Q1), IC1.16 (Q6), R26.2; also elsewhere on the board
CACK: IC3.5 (Q1), IC3.16 (Q6); also elsewhere on the board
D0: IC2.17 (B2), IC2.18 (B1), R1.2; also elsewhere on the board
D1: IC2.15 (B4), IC2.16 (B3), R5.2; also elsewhere on the board
D2: IC2.13 (B6), IC2.14 (B5), R6.2; also elsewhere on the board
D3: IC2.11 (B8), IC2.12 (B7), R7.2; also elsewhere on the board
D4: IC5.17 (B2), IC5.18 (B1), R8.2; also elsewhere on the board
D5: IC5.15 (B4), IC5.16 (B3), R9.2; also elsewhere on the board
D6: IC5.13 (B6), IC5.14 (B5), R10.2; also elsewhere on the board
D7: IC5.11 (B8), IC5.12 (B7), R11.2; also elsewhere on the board
DATA_DIR: IC2.1 (DIR), IC5.1 (DIR); also elsewhere on the board
DP: IC3.9 (Q3), IC3.12 (Q4), R13.2; also elsewhere on the board
GND: C1.2, C3.2, C6.2, C9.2, C13.2, C23.2, C30.2, IC1.7 (D2), IC1.10 (GND), IC1.14 (D5), IC2.10 (GND), IC2.19 (!OE), IC3.7 (D2), IC3.10 (GND), IC3.14 (D5), IC5.10 (GND), IC5.19 (!OE), IC6.7 (A6), IC6.8 (A7), IC6.9 (A8), IC6.10 (GND), JP1.2; also elsewhere on the board
I/O: IC1.2 (Q0), IC1.19 (Q7), R28.2; also elsewhere on the board
IN_OE: IC6.19 (!OE); also elsewhere on the board
MSG: IC1.9 (Q3), IC1.12 (Q4), R24.2; also elsewhere on the board
unnamed: JP1.1, R33.2
unnamed: Q2.3 (D), R5.1
unnamed: Q3.3 (D), R6.1
unnamed: Q4.3 (D), R7.1
unnamed: Q5.3 (D), R8.1
unnamed: Q6.3 (D), R9.1
unnamed: Q7.3 (D), R10.1
unnamed: Q8.3 (D), R11.1
unnamed: Q9.3 (D), R13.1
unnamed: Q10.3 (D), R16.1
unnamed: Q11.3 (D), R19.1
unnamed: Q12.3 (D), R22.1
unnamed: Q13.3 (D), R23.1
unnamed: Q14.3 (D), R24.1
unnamed: Q15.3 (D), R25.1
unnamed: Q16.3 (D), R26.1
unnamed: Q17.3 (D), R27.1
unnamed: Q18.3 (D), R28.1
OUT_LE1: IC1.11 (LE); also elsewhere on the board
OUT_LE2: IC3.11 (LE); also elsewhere on the board
OUT_OE: IC1.1 (!OE), IC3.1 (!OE); also elsewhere on the board
REQ: IC3.2 (Q0), IC3.19 (Q7), R27.2; also elsewhere on the board
RST: IC6.3 (A2), R23.2; also elsewhere on the board
RST_C/D_REQ_SCL: IC1.4 (D1), IC1.17 (D6), IC3.3 (D0), IC3.18 (D7), IC6.17 (B2); also elsewhere on the board
SEL: IC6.2 (A1), R25.2; also elsewhere on the board
SEL_I/O_DP_SDA: IC1.3 (D0), IC1.18 (D7), IC3.8 (D3), IC3.13 (D4), IC6.18 (B1); also elsewhere on the board
TP_ON: Q1.1 (G), Q2.1 (G), Q3.1 (G), Q4.1 (G), Q5.1 (G), Q6.1 (G), Q7.1 (G), Q8.1 (G), Q9.1 (G), Q10.1 (G), Q11.1 (G), Q12.1 (G), Q13.1 (G), Q14.1 (G), Q15.1 (G), Q16.1 (G), Q17.1 (G), Q18.1 (G), R32.2, R33.1
VCC: C6.1, IC6.1 (DIR), IC6.20 (VCC); also elsewhere on the board
VCCIO: C1.1, C3.1, C9.1, C13.1, C23.1, C30.1, IC1.20 (VCC), IC2.20 (VCC), IC3.20 (VCC), IC5.20 (VCC), Q1.2 (S), Q2.2 (S), Q3.2 (S), Q4.2 (S), Q5.2 (S), Q6.2 (S), Q7.2 (S), Q8.2 (S), Q9.2 (S), Q10.2 (S), Q11.2 (S), Q12.2 (S), Q13.2 (S), Q14.2 (S), Q15.2 (S), Q16.2 (S), Q17.2 (S), Q18.2 (S), R32.1; also elsewhere on the board

Notes on the sheet:
D -> Q
term pwr jumper
jumper present - term pwr on
jumper missing - term pwr off
D0-D3 in/out drivers
D4-D7 in/out drivers
SEL, RST, BSY, ATN reading
I/O, C/D, BSY, MSG driving
REQ, DP driving; ACK reading
(not used)

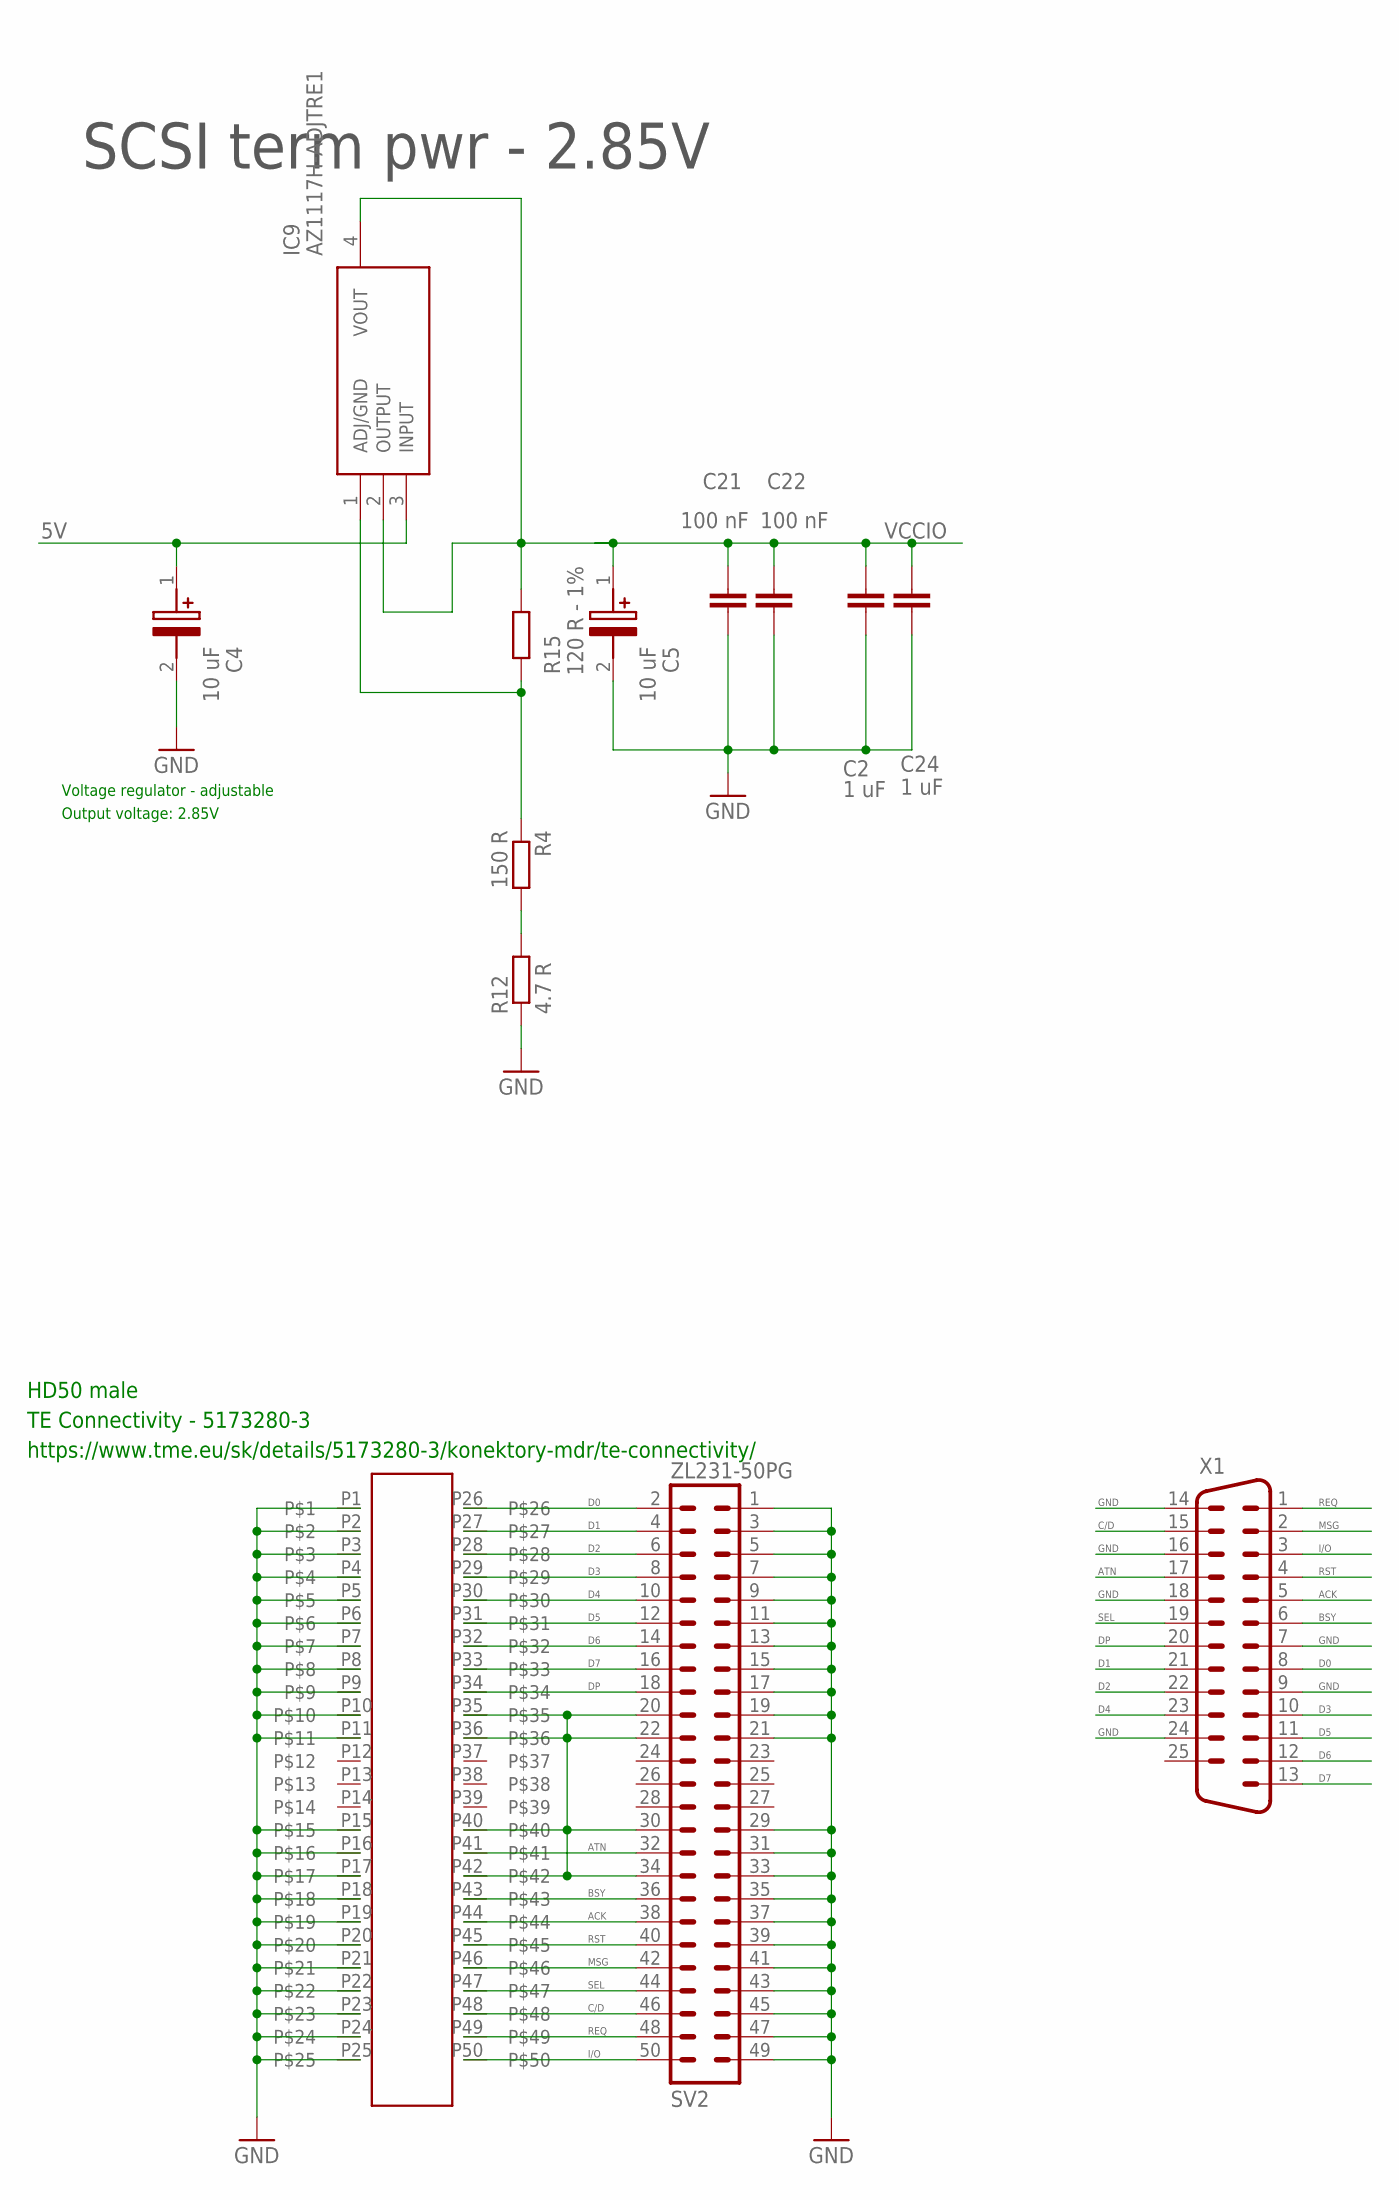
[picture p38: schematic ce_scsi_v40.sch, sheet 3, SCSI connectors]

Parts:
C2, C24: 1 uF; C0805
C4, C5: 10 uF; CAPPM3528X210N; MANUFACTURER_PART_NUMBER 293D106X9016B2TE3
C21, C22: 100 nF; C0603
IC9: AZ1117H-ADJTRE1; SOT230P700X185-4N
R4: 150 R; R0603
R12: 4.7 R; R0603
R15: 120 R - 1%; R0603
SV2: ZL231-50PG; ML50
U$2: TE Connectivity - 5173280-3; HD50_MALE
X1: M25V

Connections:
5V: C4.1 (+), IC9.3 (INPUT); also elsewhere on the board
ACK: SV2.38, U$2.P44, X1.5; also elsewhere on the board
ATN: SV2.32, U$2.P41, X1.17; also elsewhere on the board
BSY: SV2.36, U$2.P43, X1.6; also elsewhere on the board
C/D: SV2.46, U$2.P48, X1.15; also elsewhere on the board
D0: SV2.2, U$2.P26, X1.8; also elsewhere on the board
D1: SV2.4, U$2.P27, X1.21; also elsewhere on the board
D2: SV2.6, U$2.P28, X1.22; also elsewhere on the board
D3: SV2.8, U$2.P29, X1.10; also elsewhere on the board
D4: SV2.10, U$2.P30, X1.23; also elsewhere on the board
D5: SV2.12, U$2.P31, X1.11; also elsewhere on the board
D6: SV2.14, U$2.P32, X1.12; also elsewhere on the board
D7: SV2.16, U$2.P33, X1.13; also elsewhere on the board
DP: SV2.18, U$2.P34, X1.20; also elsewhere on the board
GND: C2.2, C4.2 (-), C5.2 (-), C21.2, C22.2, C24.2, R12.1, SV2.1, SV2.3, SV2.5, SV2.7, SV2.9, SV2.11, SV2.13, SV2.15, SV2.17, SV2.19, SV2.20, SV2.21, SV2.22, SV2.29, SV2.30, SV2.31, SV2.33, SV2.34, SV2.35, SV2.37, SV2.39, SV2.41, SV2.43, SV2.45, SV2.47, SV2.49, U$2.P1, U$2.P2, U$2.P3, U$2.P4, U$2.P5, U$2.P6, U$2.P7, U$2.P8, U$2.P9, U$2.P10, U$2.P11, U$2.P15, U$2.P16, U$2.P17, U$2.P18, U$2.P19, U$2.P20, U$2.P21, U$2.P22, U$2.P23, U$2.P24, U$2.P25, U$2.P35, U$2.P36, U$2.P40, U$2.P42, X1.7, X1.9, X1.14, X1.16, X1.18, X1.24; also elsewhere on the board
I/O: SV2.50, U$2.P50, X1.3; also elsewhere on the board
MSG: SV2.42, U$2.P46, X1.2; also elsewhere on the board
unnamed: R4.2, R12.2
unnamed: IC9.1 (ADJ/GND), R4.1, R15.2
REQ: SV2.48, U$2.P49, X1.1; also elsewhere on the board
RST: SV2.40, U$2.P45, X1.4; also elsewhere on the board
SEL: SV2.44, U$2.P47, X1.19; also elsewhere on the board
VCCIO: C2.1, C5.1 (+), C21.1, C22.1, C24.1, IC9.2 (OUTPUT), IC9.4 (VOUT), R15.1; also elsewhere on the board

Notes on the sheet:
Voltage regulator - adjustable
Output voltage: 2.85V
SCSI term pwr - 2.85V
HD50 male
TE Connectivity - 5173280-3
https://www.tme.eu/sk/details/5173280-3/konektory-mdr/te-connectivity/
