atarijookie/cosmo2ex/devices/v40_pico_scsi/ce_scsi_v40.brd

## EAGLE design devices/v40_pico_scsi/ce_scsi_v40.brd (continued)

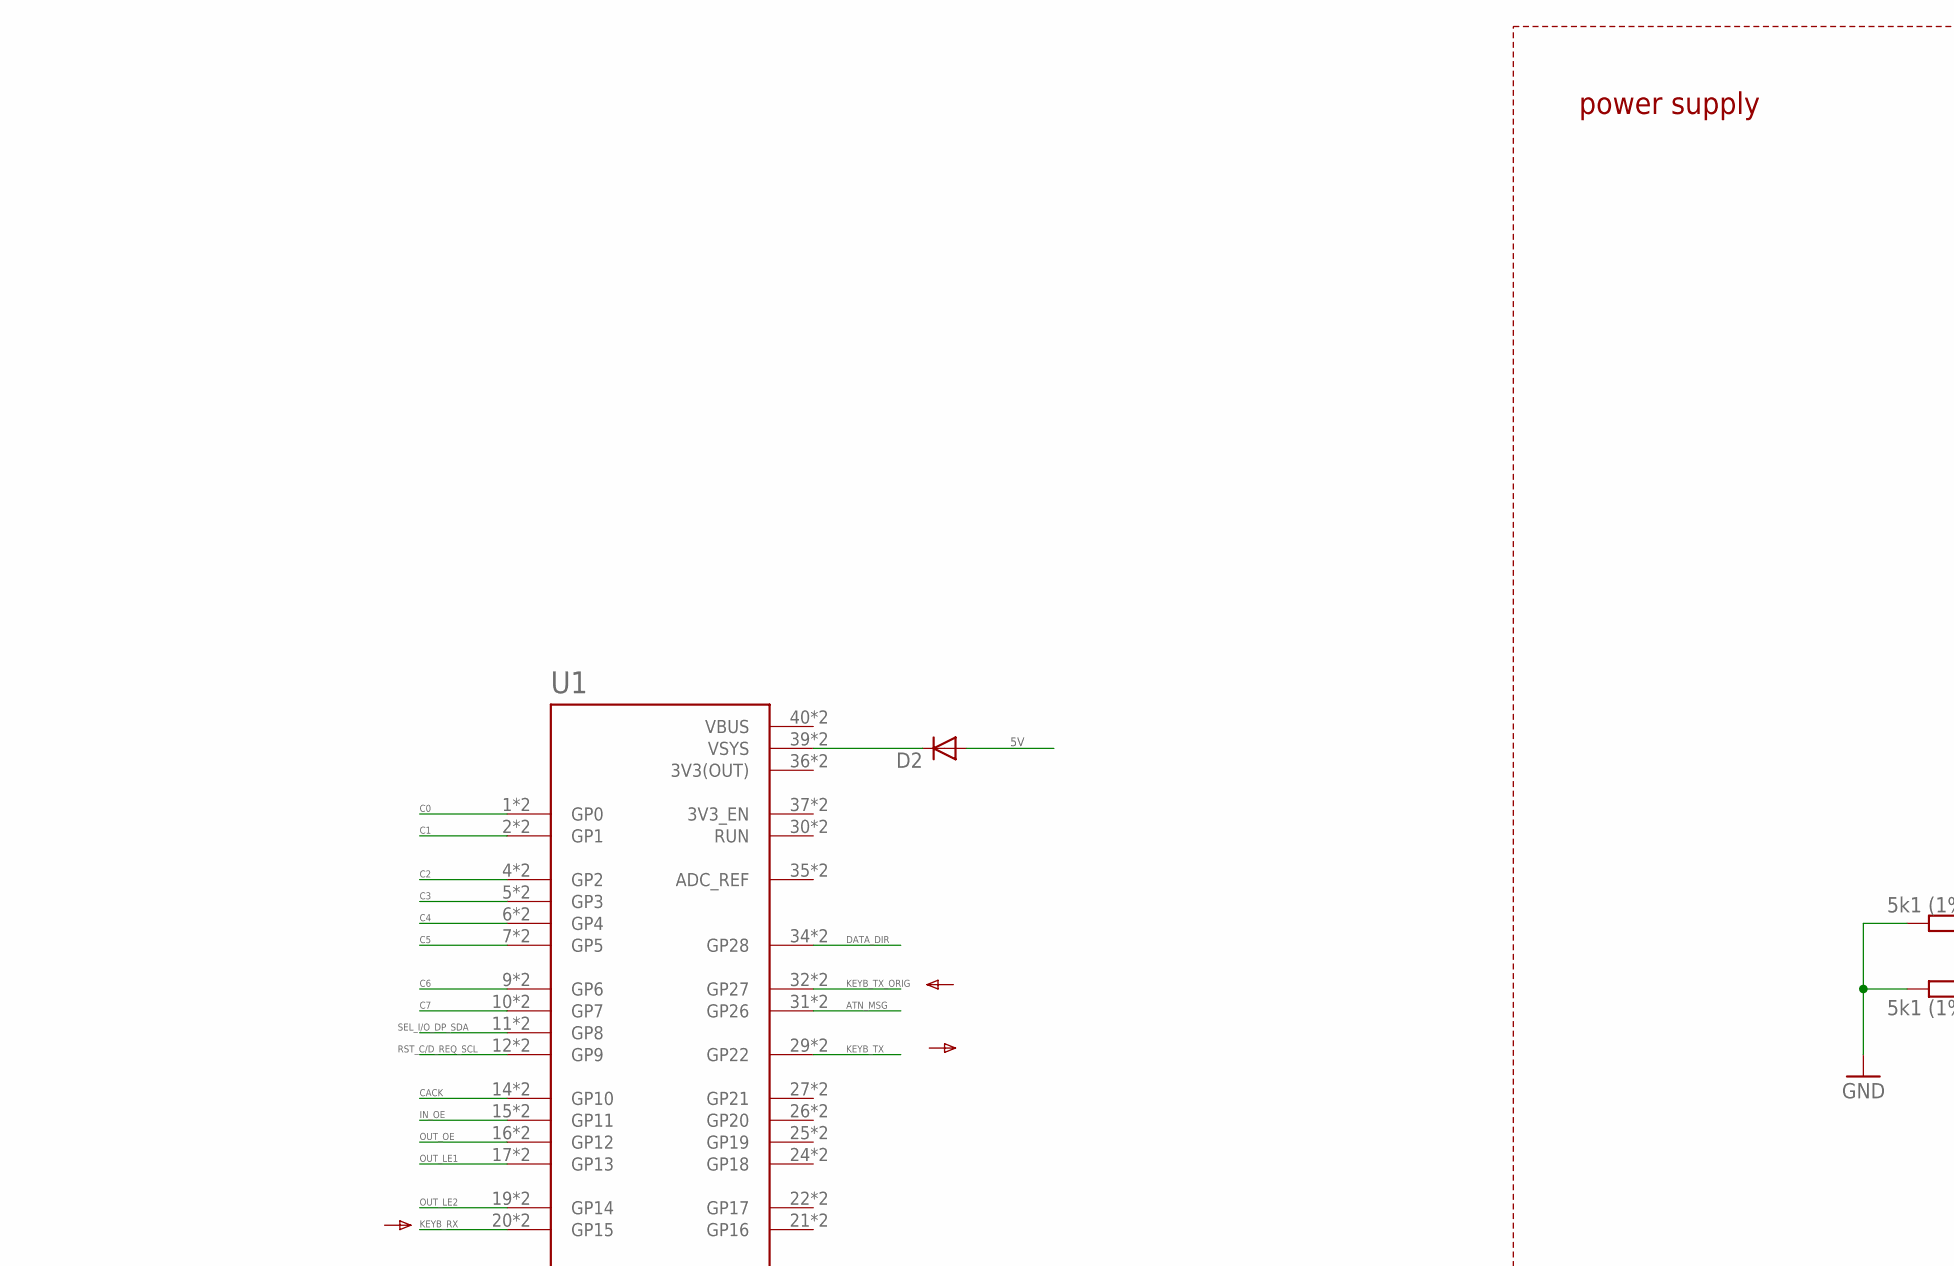
[picture p39: schematic ce_scsi_v40.sch, sheet 4, Front panel, power supply and RPi connection parts, part in row 1, column 1]

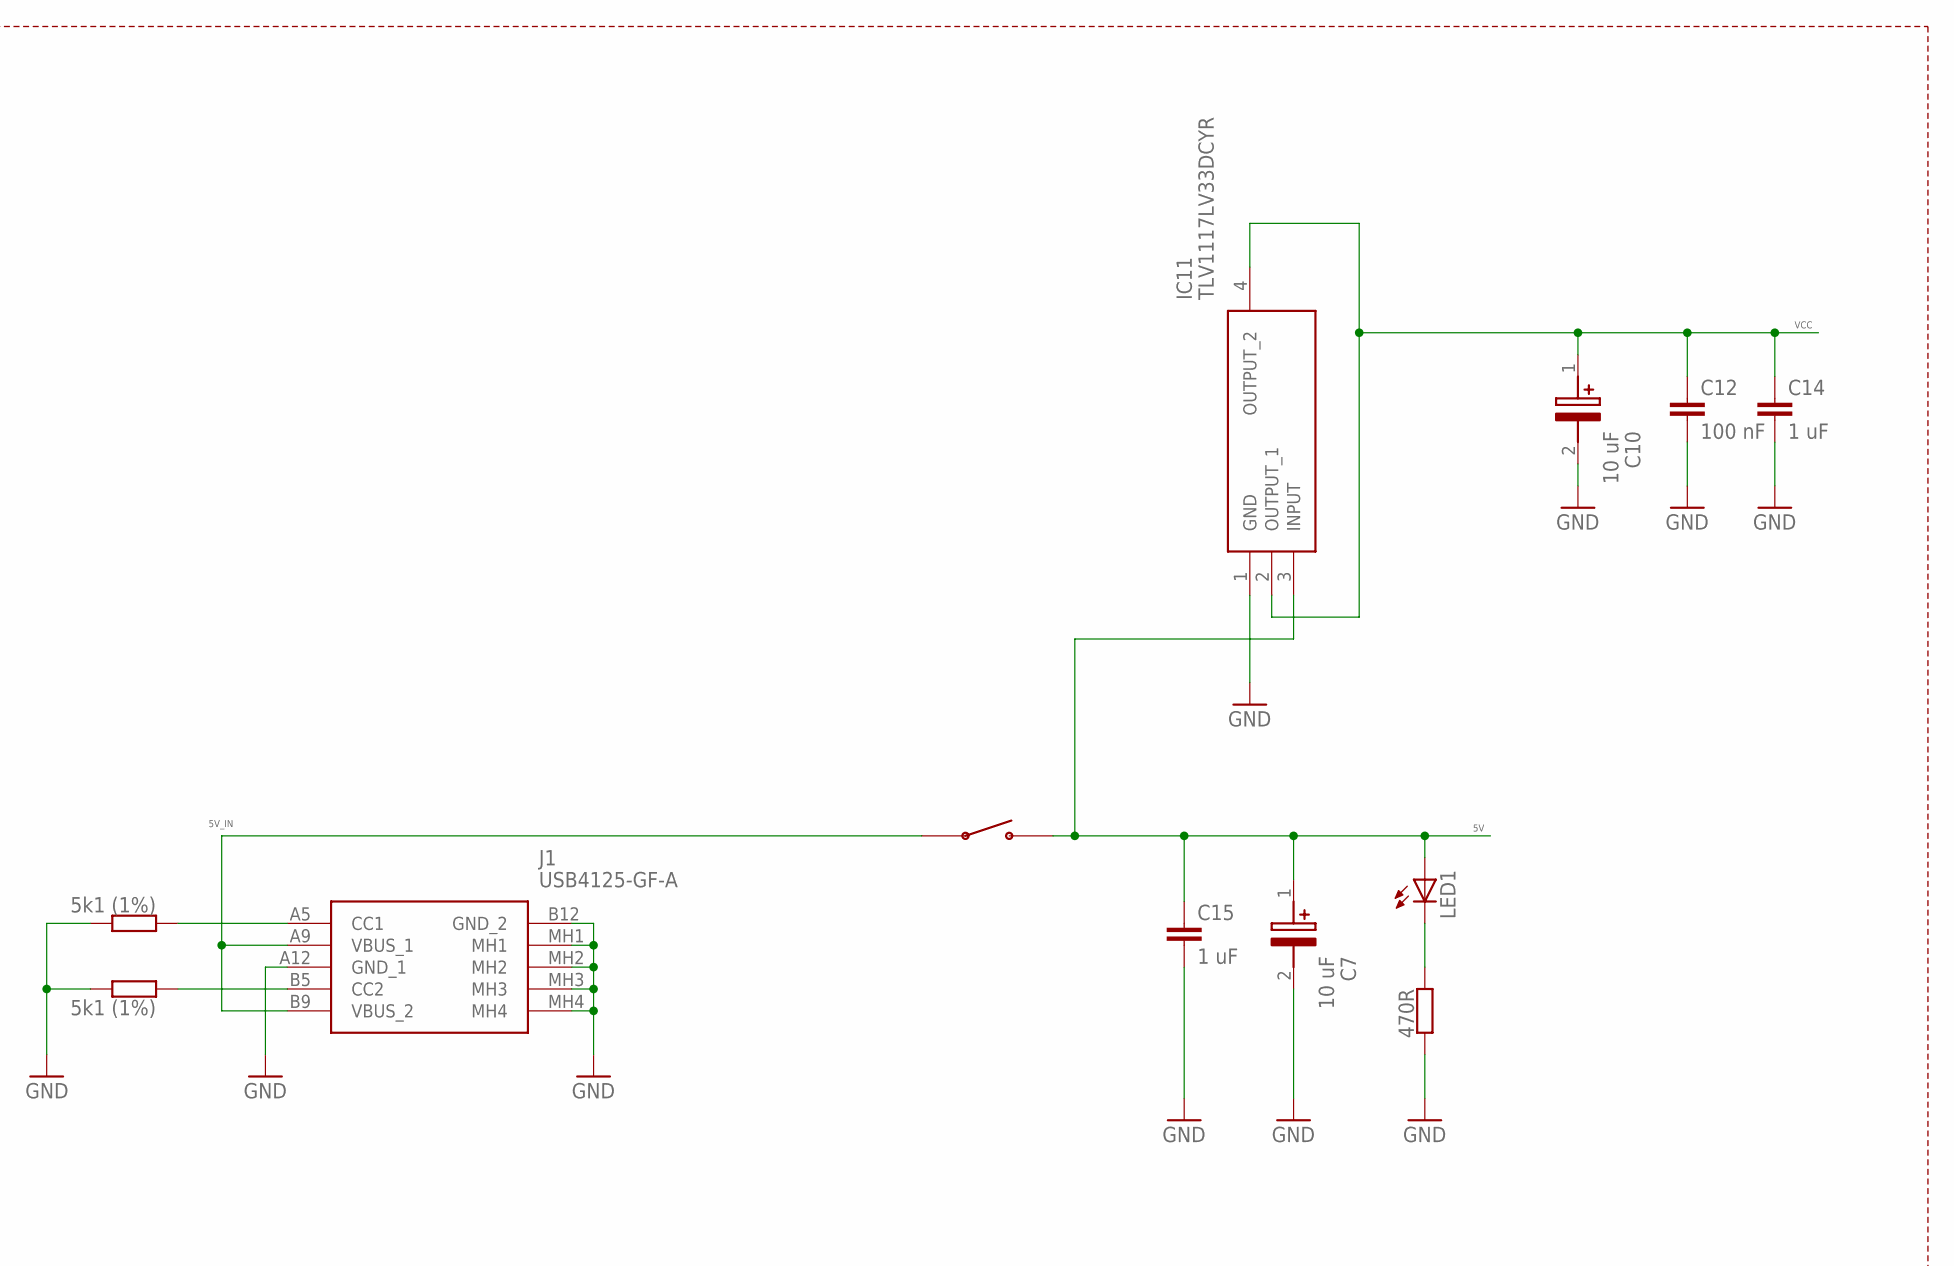
[picture p40: schematic ce_scsi_v40.sch, sheet 4, Front panel, power supply and RPi connection parts, part in row 1, column 2]

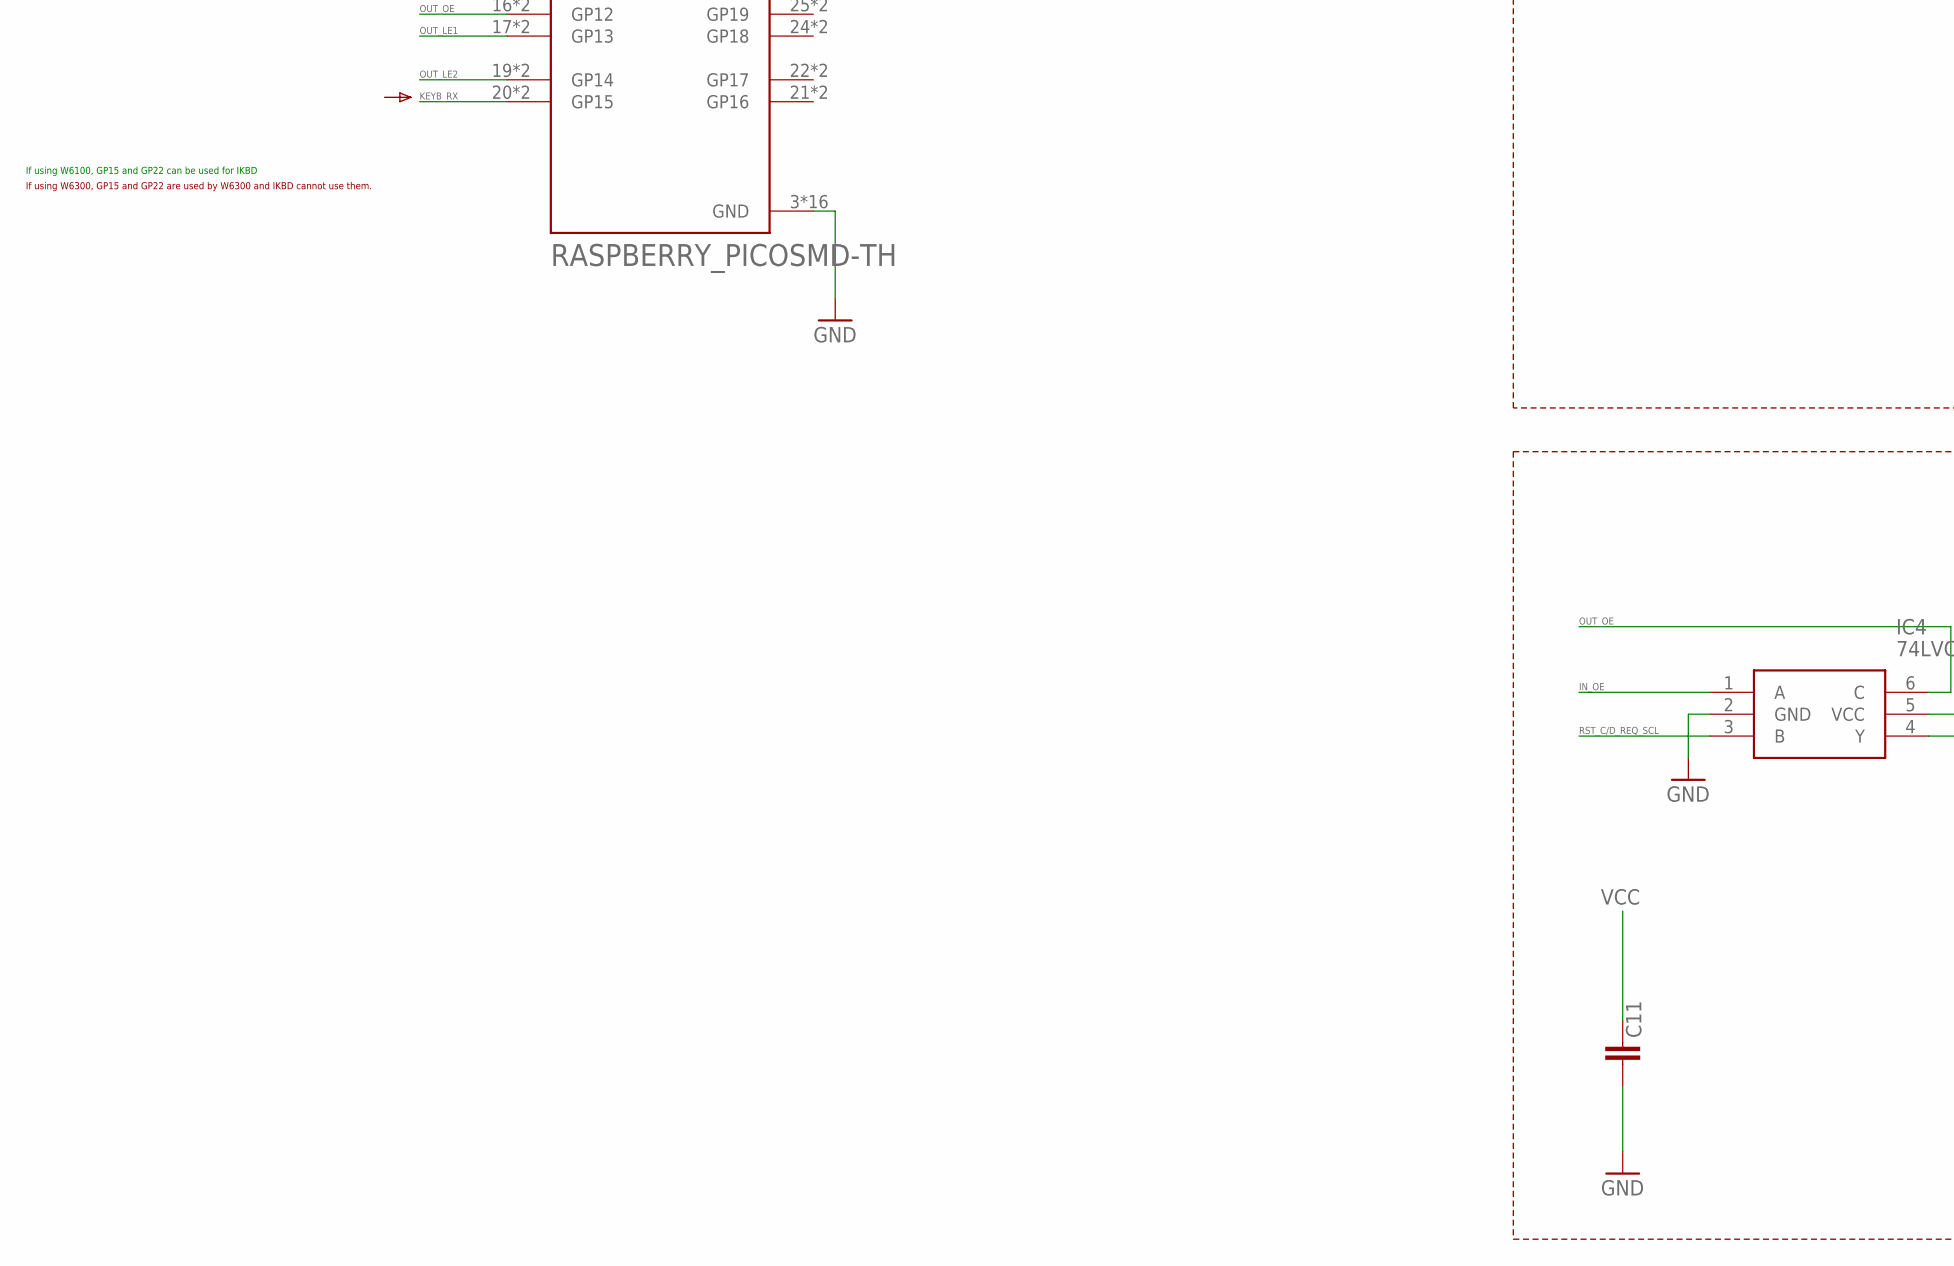
[picture p41: schematic ce_scsi_v40.sch, sheet 4, Front panel, power supply and RPi connection parts, part in row 2, column 1]

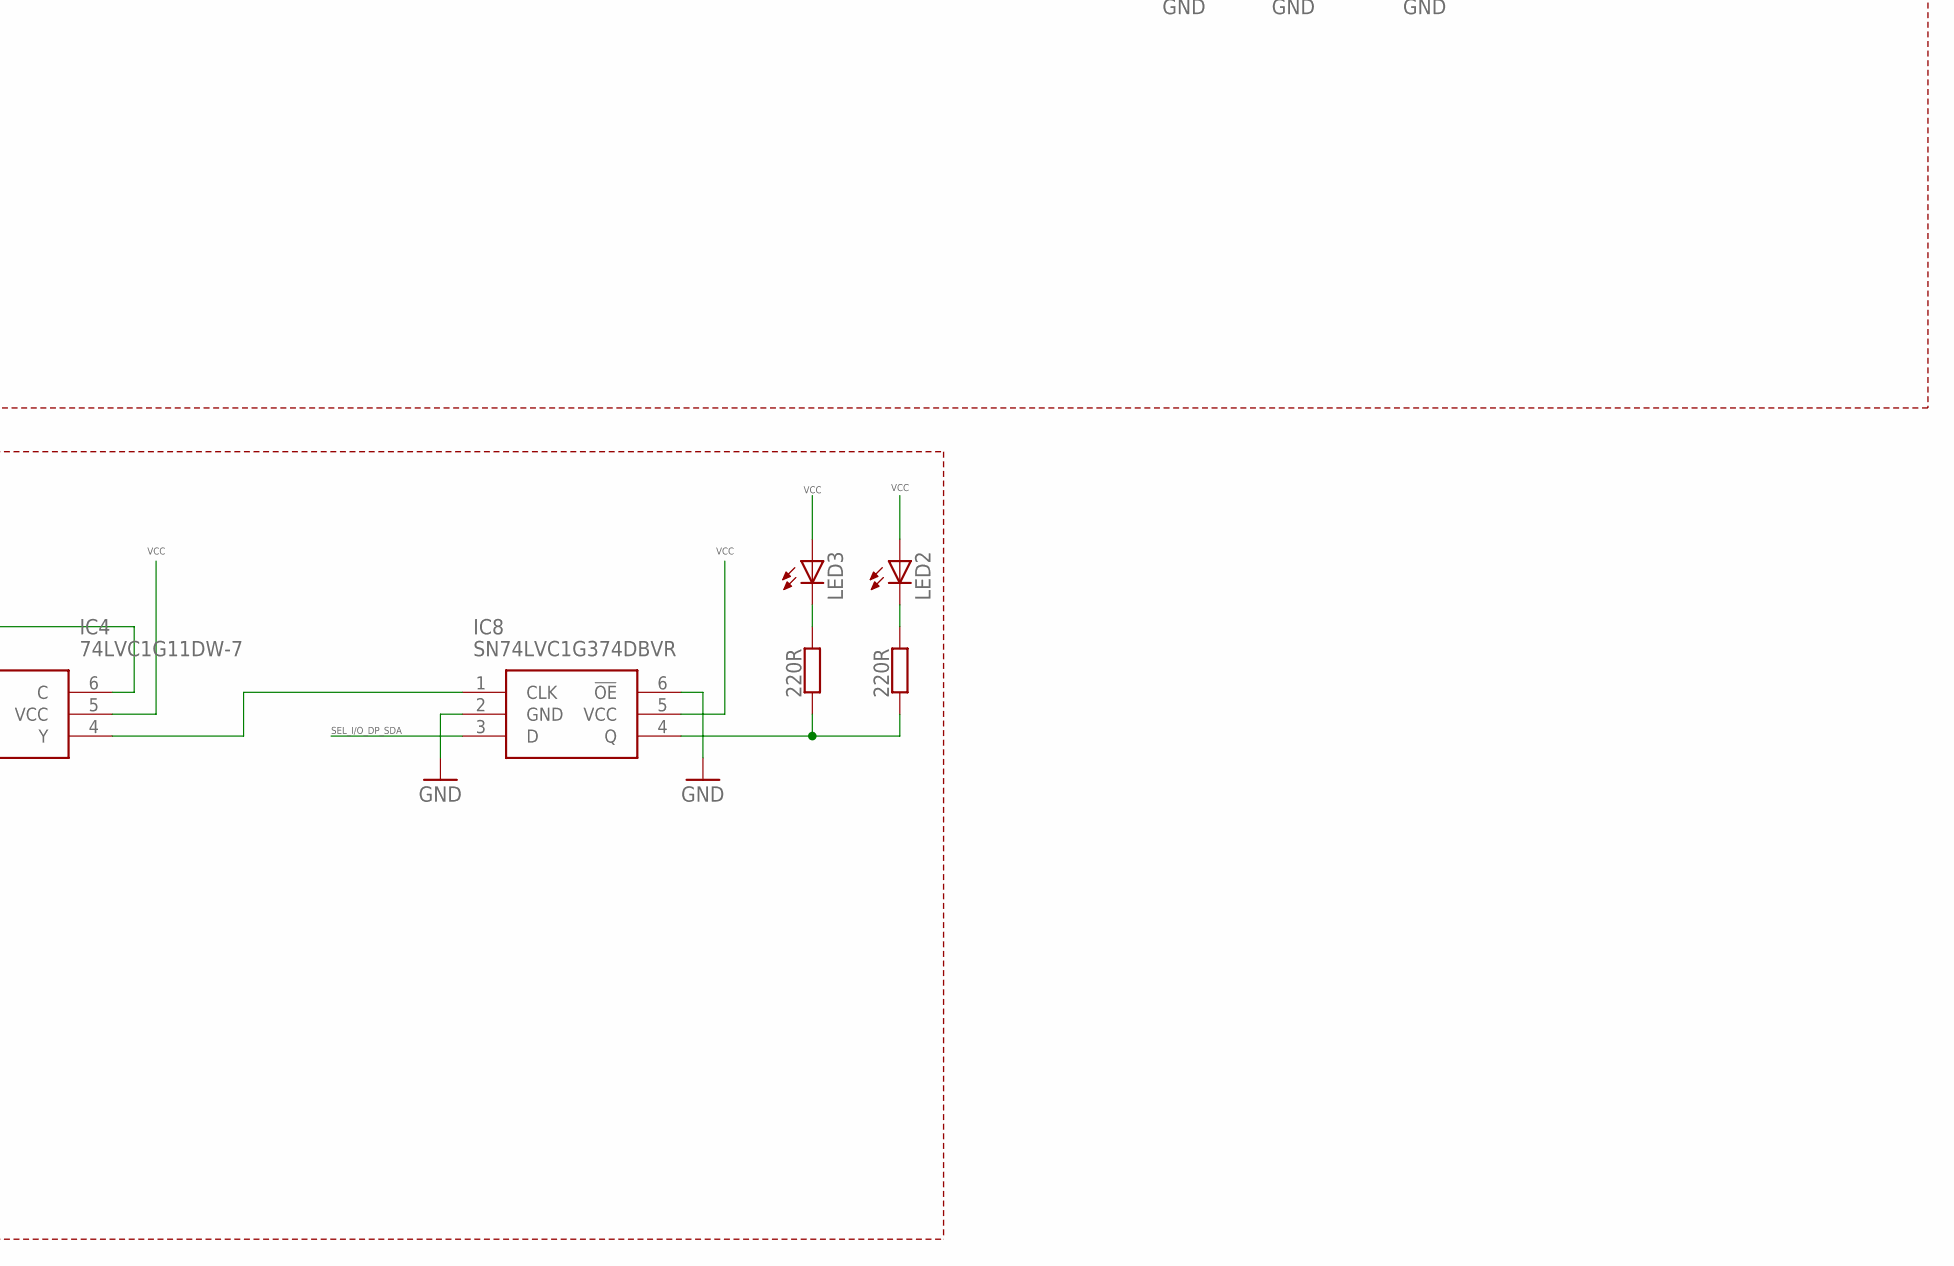
[picture p42: schematic ce_scsi_v40.sch, sheet 4, Front panel, power supply and RPi connection parts, part in row 2, column 2]

Parts:
C7: 10 uF; CAPPM3528X210N
C10: 10 uF; CAPPM3528X210N; MANUFACTURER_PART_NUMBER 293D106X9016B2TE3
C11, C12: 100 nF; C0603
C14, C15: 1 uF; C0805
D2: SK110-DIO; DO214AC
IC4: 74LVC1G11DW-7; SOT65P210X110-6N
IC8: SN74LVC1G374DBVR; SOT95P280X145-6N
IC11: TLV1117LV33DCYR; SOT230P700X180-4N
J1: USB4125-GF-A; USB4125GFA
LED1, LED2, LED3: LEDSML0603; SML0603
R14, R17: 5k1 (1%); R0603
R18: 470R; R0603
R20, R21: 220R; R0603
U1: RASPBERRY_PICOSMD-TH; PICO-PKG
U$1: RSSM1011C3BK

Connections:
3V3(OUT): U1.36 (3V3(OUT)), U1.P$36 (3V3(OUT))
5V: C7.1 (+), C15.1, D2.A, IC11.3 (INPUT), LED1.A, U$1.P$2; also elsewhere on the board
5V_IN: J1.A9 (VBUS_1), J1.B9 (VBUS_2), U$1.P$1
ATN_MSG: U1.31 (GP26), U1.P$31 (GP26); also elsewhere on the board
C0: U1.1 (GP0), U1.P$1 (GP0); also elsewhere on the board
C1: U1.2 (GP1), U1.P$2 (GP1); also elsewhere on the board
C2: U1.4 (GP2), U1.P$4 (GP2); also elsewhere on the board
C3: U1.5 (GP3), U1.P$5 (GP3); also elsewhere on the board
C4: U1.6 (GP4), U1.P$6 (GP4); also elsewhere on the board
C5: U1.7 (GP5), U1.P$7 (GP5); also elsewhere on the board
C6: U1.9 (GP6), U1.P$9 (GP6); also elsewhere on the board
C7: U1.10 (GP7), U1.P$10 (GP7); also elsewhere on the board
CACK: U1.14 (GP10), U1.P$14 (GP10); also elsewhere on the board
DATA_DIR: U1.34 (GP28), U1.P$34 (GP28); also elsewhere on the board
GND: C7.2 (-), C10.2 (-), C11.2, C12.2, C14.2, C15.2, IC4.2 (GND), IC8.2 (GND), IC8.6 (!OE), IC11.1 (GND), J1.A12 (GND_1), J1.B12 (GND_2), J1.MH1, J1.MH2, J1.MH3, J1.MH4, R14.2, R17.2, R18.2, U1.3 (GND), U1.8 (GND), U1.13 (GND), U1.18 (GND), U1.23 (GND), U1.28 (GND), U1.33 (GND), U1.38 (GND), U1.P$3 (GND), U1.P$8 (GND), U1.P$13 (GND), U1.P$18 (GND), U1.P$23 (GND), U1.P$28 (GND), U1.P$33 (GND), U1.P$38 (GND); also elsewhere on the board
IN_OE: IC4.1 (A), U1.15 (GP11), U1.P$15 (GP11); also elsewhere on the board
KEYB_RX: U1.20 (GP15), U1.P$20 (GP15); also elsewhere on the board
KEYB_TX: U1.29 (GP22), U1.P$29 (GP22); also elsewhere on the board
KEYB_TX_ORIG: U1.32 (GP27), U1.P$32 (GP27); also elsewhere on the board
unnamed: J1.B5 (CC2), R14.1
unnamed: J1.A5 (CC1), R17.1
unnamed: IC4.4 (Y), IC8.1 (CLK)
unnamed: IC8.4 (Q), R20.2, R21.2
unnamed: LED1.C, R18.1
unnamed: LED2.C, R20.1
unnamed: LED3.C, R21.1
unnamed: D2.C, U1.39 (VSYS), U1.P$39 (VSYS)
OUT_LE1: U1.17 (GP13), U1.P$17 (GP13); also elsewhere on the board
OUT_LE2: U1.19 (GP14), U1.P$19 (GP14); also elsewhere on the board
OUT_OE: IC4.6 (C), U1.16 (GP12), U1.P$16 (GP12); also elsewhere on the board
RST_C/D_REQ_SCL: IC4.3 (B), U1.12 (GP9), U1.P$12 (GP9); also elsewhere on the board
SEL_I/O_DP_SDA: IC8.3 (D), U1.11 (GP8), U1.P$11 (GP8); also elsewhere on the board
VBUS: U1.40 (VBUS), U1.P$40 (VBUS)
VCC: C10.1 (+), C11.1, C12.1, C14.1, IC4.5 (VCC), IC8.5 (VCC), IC11.2 (OUTPUT_1), IC11.4 (OUTPUT_2), LED2.A, LED3.A; also elsewhere on the board

Notes on the sheet:
power supply
If using W6100, GP15 and GP22 can be used for IKBD
If using W6300, GP15 and GP22 are used by W6300 and IKBD cannot use them.

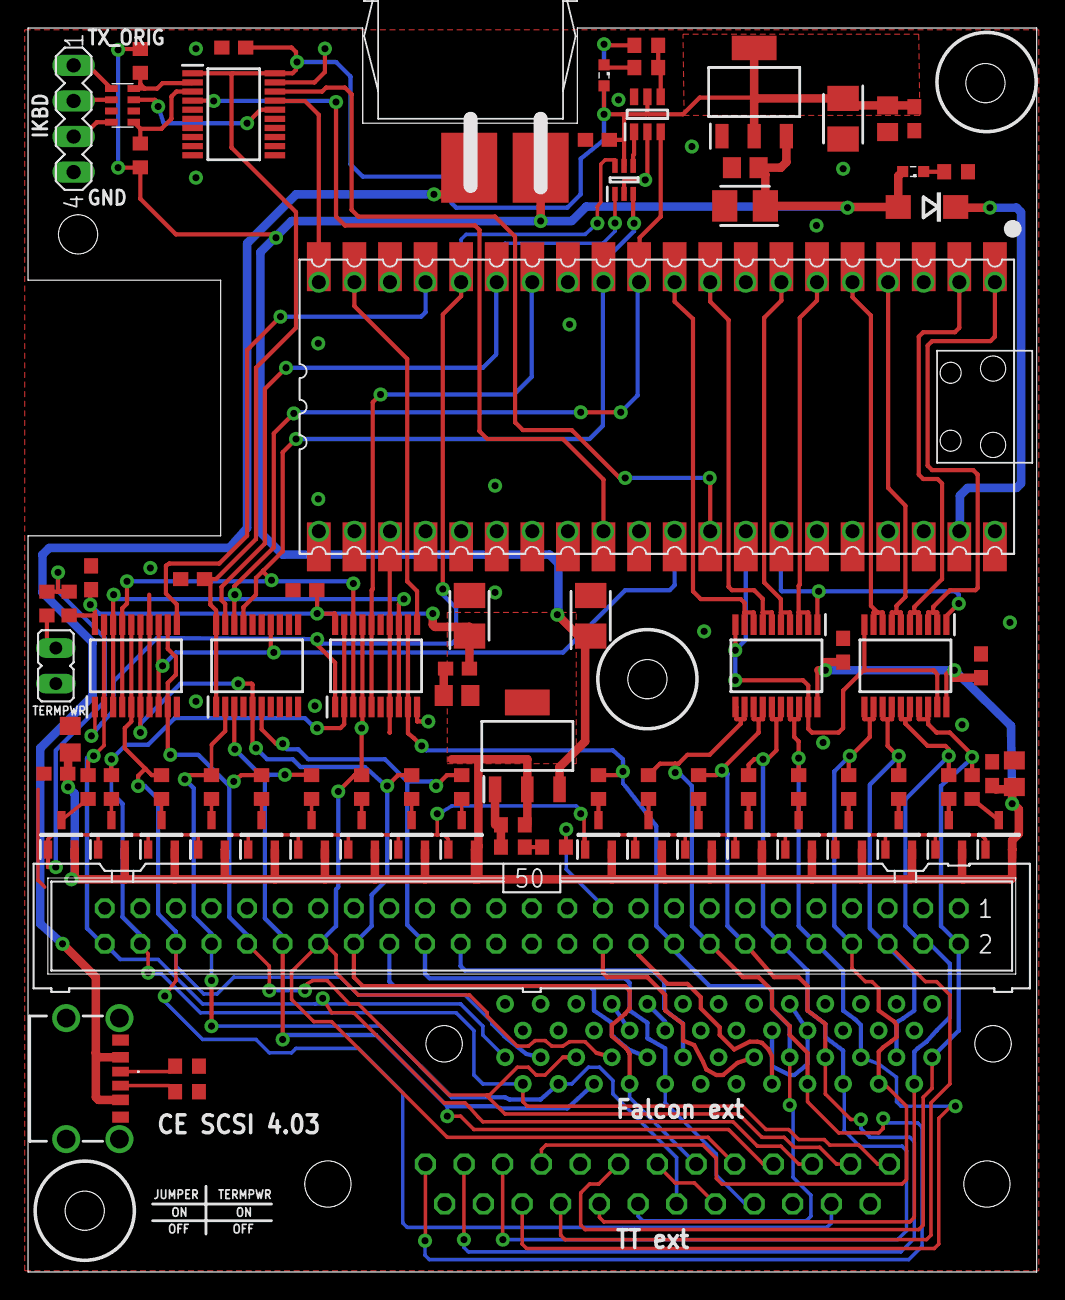
[picture p43: board ce_scsi_v40.brd from above]

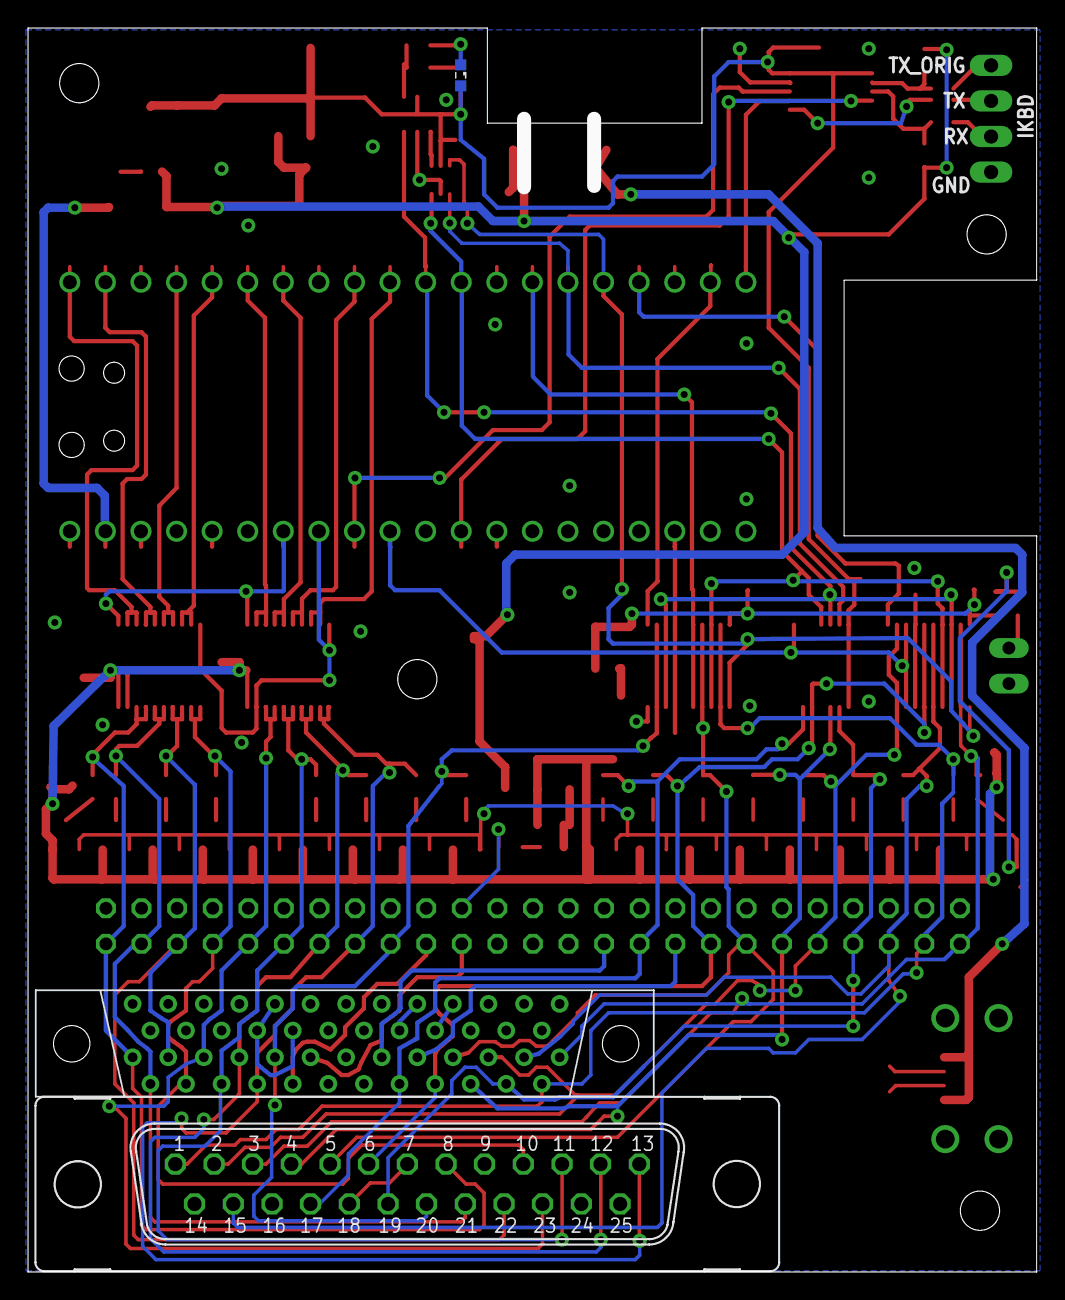
[picture p44: board ce_scsi_v40.brd from below]

Board: 2 copper layers, 72.0 x 88.8 mm, 91 parts (3 on the bottom side), 81 nets.
