atarijookie/cosmo2ex/ce_cores/chipinterface/chipinterface.cpp

#include <string.h>
#include <termios.h>
#include <stdio.h>
#include <stdlib.h>
#include <string.h>
#include <fcntl.h>
#include <string>
#include <unistd.h>
#include <limits.h>
#include <sys/select.h>
#include <sys/socket.h>
#include <sys/ioctl.h>
#include <netinet/in.h>
#include <netinet/tcp.h>
#include <arpa/inet.h>
#include <errno.h>

#include "chipinterface.h"
#include "../misc/utils.h"
#include "../misc/debug.h"
#include "../misc/global.h"
#include "../misc/version.h"
#include "../misc/statusreport.h"
#include "../misc/connecteddevices.h"
#include "../discovery/discovery.h"

ChipInterface::ChipInterface(int whichLogFile, int whichAtnCode, uint32_t whichSyncTagCode, uint16_t portListen)
{
    whichLog = whichLogFile;
    whichAtn = whichAtnCode;
    whichSyncTag = whichSyncTagCode;
    this->portListen = portListen;

    for(int i=0; i<MAX_CLIENTS; i++) {
        clients[i].bufReader.setSyncTag(whichSyncTagCode);
        clients[i].bufReader.setLogFile(whichLogFile);
    }

    fdListen = FD_EMPTY;

    clientsClearAll();

    bufOut = new uint8_t[MFM_STREAM_SIZE];
    bufIn = new uint8_t[MFM_STREAM_SIZE];

    gotAtnId = 0;
    gotAtnCode = 0;
}

ChipInterface::~ChipInterface()
{
    ConnectedDevices::update(this, std::set<std::string>());     // this core has no clients anymore
    delete []bufOut;
    delete []bufIn;
}

bool ChipInterface::createListeningSocket(void)
{
    if(fdListen >= 0) { // if the listening socket seems to be already created, just quit
        return true;
    }

    // open socket
    if ((fdListen = Utils::socketCloexec(AF_INET, SOCK_STREAM, 0)) < 0) {      // CLOEXEC - don't let processes started by system() inherit this socket
        Debug::out(whichLog, LOG_ERROR, "ChipInterface::createListeningSocket - failed to open socket: %s", strerror(errno));
        fdListen = FD_EMPTY;
        return false;
    }

    // SO_REUSEADDR allows bind() while old connections from previous (finished / crashed) instance are still in TIME_WAIT.
    // Don't use SO_REUSEPORT - that would let a 2nd running instance bind the same port and silently steal half of the connections.
    int opt = 1;

    if (setsockopt(fdListen, SOL_SOCKET, SO_REUSEADDR, &opt, sizeof(opt))) {
        Debug::out(whichLog, LOG_ERROR, "ChipInterface::createListeningSocket - setsockopt() failed for SO_REUSEADDR");
    }

    // change the socket into non-blocking
    fcntl(fdListen, F_SETFL, O_NONBLOCK);

    addressListen.sin_family = AF_INET;
    addressListen.sin_addr.s_addr = INADDR_ANY;
    addressListen.sin_port = htons( portListen );

    // bind to address
    if (bind(fdListen, (struct sockaddr *) &addressListen, sizeof(addressListen)) < 0) {
        if(errno == EADDRINUSE) {       // with SO_REUSEADDR this means some other running app is listening on this port
            Debug::out(whichLog, LOG_ERROR, "ChipInterface::createListeningSocket - bind() failed, tcp port %d is used by another running app", portListen);
        } else {
            Debug::out(whichLog, LOG_ERROR, "ChipInterface::createListeningSocket - bind() failed for tcp port %d: %s", portListen, strerror(errno));
        }
        Utils::closeFdIfOpen(fdListen);     // close half-initialized socket, so next call will try again
        return false;
    }

    // mark the socket as a passive socket
    if (listen(fdListen, 5) < 0) {
        Debug::out(whichLog, LOG_ERROR, "ChipInterface::createListeningSocket - listen() failed for tcp port %d: %s", portListen, strerror(errno));
        Utils::closeFdIfOpen(fdListen);     // close half-initialized socket, so next call will try again
        return false;
    }

    Debug::out(whichLog, LOG_INFO, "ChipInterface::createListeningSocket - listening on tcp port: %d", portListen);
    return true;
}

int ChipInterface::acceptSocketIfNeededAndPossible(void)
{
    int idx = clientsGetEmptyIndex();

    // out of empty indexes, don't accept
    if(idx < 0 || idx >= MAX_CLIENTS) {
        return FD_EMPTY;
    }

    ClientInfo* clientInfo = &clients[idx];

    // don't have client socket, try accept()
    struct sockaddr_in addressClient;
    socklen_t addrSize = sizeof(addressClient);

    int newSock = Utils::acceptCloexec(fdListen, (struct sockaddr *) &addressClient, &addrSize);  // CLOEXEC - don't let processes started by system() inherit this socket

    if(newSock < 0) {       // nothing to accept, would block? quit
        return FD_EMPTY;
    }

    struct timeval tv;
    tv.tv_sec = 3;      // 3 seconds timeout
    tv.tv_usec = 0;
    setsockopt(newSock, SOL_SOCKET, SO_RCVTIMEO, (const char*) &tv, sizeof(tv));        // recv() timeout
    setsockopt(newSock, SOL_SOCKET, SO_SNDTIMEO, (const char*) &tv, sizeof(tv));        // send() timeout

    // turn off Nagle's algorithm
    int flag = 1;
    setsockopt(newSock, IPPROTO_TCP, TCP_NODELAY, &flag, sizeof(flag));

    char clientIp[INET_ADDRSTRLEN];
    inet_ntop(AF_INET, &addressClient.sin_addr, clientIp, sizeof(clientIp));
    uint32_t clientIpInt = ntohl(addressClient.sin_addr.s_addr);

    uint8_t mac[6];
    getMacForIp(addressClient.sin_addr.s_addr, mac);    // mac from discovery request (device always does discovery before connecting)

    // got the new client socket now - this also closes older connections of the same device
    clientsStoreOne(clientInfo, newSock, clientIpInt, mac, whichLog == LOGFILE_FDD);

    Debug::out(whichLog, LOG_INFO, "acceptSocketIfNeededAndPossible() - client #%d connected from %s", idx, clientIp);

    if(whichLog == LOGFILE_FDD) {       // floppy chip interface will also log the slot index
        Debug::out(whichLog, LOG_INFO, "acceptSocketIfNeededAndPossible() - client #%d will use floppy slot #%d", idx, clientInfo->floppySlotIndex);
    }

    return idx;
}

bool ChipInterface::ciOpen(void)
{
    return createListeningSocket();
}

void ChipInterface::ciClose(void)
{
    // close sockets
    Utils::closeFdIfOpen(fdListen);

    for(int i=0; i<MAX_CLIENTS; i++) {
       clientsCloseOne(&clients[i]);
    }

    reportConnectedDevices();
}

int ChipInterface::setAllClientFds(fd_set* readfds)
{
    // called from each core's main loop before select() - after any connect / disconnect / mac change of this loop pass
    reportConnectedDevices();

    int maxFd = FD_EMPTY;

    for(int i=0; i<MAX_CLIENTS; i++) {
        int fdClient = clients[i].fdClient;
        if(fdClient != FD_EMPTY) {      // got this client?
            FD_SET(fdClient, readfds);
            maxFd = MAX(fdClient, maxFd);
        }
    }

    return maxFd;
}

// report MACs of all connected clients - clients get closed in many places (send failures, inactivity, reconnects),
// so the whole table is reported instead of tracking each of them
void ChipInterface::reportConnectedDevices(void)
{
    std::set<std::string> macs;

    for(int i=0; i<MAX_CLIENTS; i++) {
        if(clients[i].fdClient == FD_EMPTY) {
            continue;
        }

        std::string mac = ConnectedDevices::macToString(clients[i].mac);
        if(!mac.empty()) {          // mac not known yet? it comes with the FW version packet, reported next time
            macs.insert(mac);
        }
    }

    ConnectedDevices::update(this, macs);
}

bool ChipInterface::actionNeeded(ClientInfo* ci, uint8_t *inBuf)
{
    int bytesAvailable;
    int rv = ioctl(ci->fdClient, FIONREAD, &bytesAvailable);    // how many bytes we can read?

    if(rv < 0 || bytesAvailable <= 0) {                     // ioctl fail or nothing to read? no action needed
        return false;
    }

    // Debug::out(whichLog, LOG_DEBUG, "actionNeeded() - bytesAvailable: %d", bytesAvailable);

    // if waitForAtn() succeeds, it fills 8 bytes of data in buffer
    // ...but then we might need some little more, so let's determine what it was
    // and keep reading as much as needed

    // we might need to wait for ATN multiple times, as there might be ZEROS packet or IKBD packet before we read wanted Hans or Franz packet
    while(sigintReceived == 0) {
        // check for any ATN code waiting from Hans
        bool good = waitForAtn(ci->index, NET_ATN_ANY_ID, ATN_ANY, 0, inBuf);    // which chip wants to communicate? (which chip's stream we should process?)

        if(!good) {                                         // not good? break loop, no action needed
            break;
        }

        //Debug::out(whichLog, LOG_DEBUG, "actionNeeded() - gotAtnId=%d, gotAtnCode=%d", gotAtnId, gotAtnCode);

        if(gotAtnId == NET_ATN_HANS_ID) {                   // for Hans
            if(gotAtnCode == ATN_ACSI_COMMAND) {            // for this command read all ACSI command bytes
                recvFromClient(ci->fdClient, inBuf + 8, 14);
            }

            return true;
        }

        if(gotAtnId == NET_ATN_FRANZ_ID) {                  // for Franz
            return true;
        }

        // if came here, probably weird situation, quit
        Debug::out(whichLog, LOG_DEBUG, "actionNeeded() - weird situation?");
        break;
    }

    // no action needed
    return false;
}

uint8_t ChipInterface::getFWversionHdd(ClientInfo* ci)
{
    return getFWversion(ci, true);
}

uint8_t ChipInterface::getFWversion(ClientInfo* ci, bool hddNotFdd)
{
    #define FW_VER_SIZE     32
    uint8_t bfr[FW_VER_SIZE];

    memset(bfr, 0, FW_VER_SIZE);
    int readCnt = readRestOfData(ci, bfr, FW_VER_SIZE);

    if(readCnt < 12) {
        Debug::out(whichLog, LOG_ERROR, "getFWversion() -- not enough data received: %d", readCnt);
        return 0;
    }

    int year = Utils::bcdToInt(bfr[1]) + 2000;
    int month = Utils::bcdToInt(bfr[2]);
    int day = Utils::bcdToInt(bfr[3]);

    bool macChanged = false;
    if(memcmp(ci->mac, bfr + 6, 6) != 0) {   // mac changed? (e.g. first received)
        memcpy(ci->mac, bfr + 6, 6);         // copy mac address into client's info
        macChanged = true;
    }

    char fwVerStr[64];
    snprintf(fwVerStr, sizeof(fwVerStr), "%d-%02d-%02d", year, month, day);
    StatusReport::storeIpAndFwVer(ci->mac, ci->ipAddr, fwVerStr, bfr[4]);

    // device settings flags - only from firmware that sends them (14 bytes instead of 12)
    ci->deviceSettings = (readCnt >= 13) ? bfr[12] : -1;

    // features changed? store it to settings
    if(ci->features != bfr[4]) {
        ci->features = bfr[4];
        storeDeviceFeatures(ci->mac, bfr[4]);
    }

    Debug::out(whichLog, LOG_DEBUG, "FW: %s, mac: %02X:%02X:%02X:%02X:%02X:%02X, %s", fwVerStr, ci->mac[0], ci->mac[1], ci->mac[2], ci->mac[3], ci->mac[4], ci->mac[5], hddNotFdd ? "HDD" : "FDD");

    // for hdd return xilinx info, for fdd return if mac changed
    return hddNotFdd ? bfr[5] : macChanged;
}

// The device's settings are the truth on connect, and when they change there (captive portal). A change in the web UI
// is sent to the device, which then reports it back - a report still carrying the old value (sent before the device
// got the change) doesn't overwrite the new setting, as it's not a change from what was reported before.
// Changed in the web UI while the device wasn't connected (pending)? Then the web UI wins - sent on connect.
void ChipInterface::fdd_syncDeviceSettings(ClientInfo* ci)
{
    if(ci->deviceSettings < 0 || ci->deviceSettings == ci->deviceSettingsSeen) {   // not reported, or no change
        return;
    }

    bool firstSinceConnect = (ci->deviceSettingsSeen < 0);
    ci->deviceSettingsSeen = ci->deviceSettings;

    Settings s(ci->mac);

    if(firstSinceConnect && s.getBool(FDD_SETTING_PENDING, false)) {
        Debug::out(whichLog, LOG_DEBUG, "fdd_syncDeviceSettings - settings changed in the web UI while the device was away, sending them");
        fdd_sendDeviceSettings(ci);
        return;
    }

    bool ikbd = (ci->deviceSettings & DEV_SETTING_IKBD) != 0;
    bool beep = (ci->deviceSettings & DEV_SETTING_BEEP_ON_STEP) != 0;
    s.setBool(FDD_SETTING_IKBD_ENABLED, ikbd);
    s.setBool(FDD_SETTING_BEEP_ON_STEP, beep);

    Debug::out(whichLog, LOG_DEBUG, "fdd_syncDeviceSettings - device settings stored: ikbd: %d, beep on step: %d", ikbd, beep);
}

bool ChipInterface::fdd_sendDeviceSettings(ClientInfo* ci)
{
    Settings s(ci->mac);
    bool ikbd = s.getBool(FDD_SETTING_IKBD_ENABLED, true);
    bool beep = s.getBool(FDD_SETTING_BEEP_ON_STEP, true);

    uint8_t flags = (ikbd ? DEV_SETTING_IKBD : 0) | (beep ? DEV_SETTING_BEEP_ON_STEP : 0);

    if(!sendHeaderAndDataToChip(ci->fdClient, ATN_DEVICE_SETTINGS, &flags, 1)) {
        Debug::out(whichLog, LOG_WARNING, "fdd_sendDeviceSettings - failed to send, will be sent on next connect");
        return false;
    }

    s.setBool(FDD_SETTING_PENDING, false);
    Debug::out(whichLog, LOG_DEBUG, "fdd_sendDeviceSettings - sent: ikbd: %d, beep on step: %d", ikbd, beep);
    return true;
}

uint32_t ChipInterface::ledColorFromSettings(const char* key, uint32_t defColor)
{
    Settings s;
    std::string str = s.getString(key, "");

    if(str.length() != 6 || str.find_first_not_of("0123456789abcdefABCDEF") != std::string::npos) {
        return defColor;
    }

    uint32_t color = (uint32_t) strtoul(str.c_str(), NULL, 16);
    return (color != 0) ? color : defColor;     // black would look like a dead LED
}

static void storeRgb(uint8_t* bfr, uint32_t color)
{
    bfr[0] = (uint8_t) (color >> 16);
    bfr[1] = (uint8_t) (color >> 8);
    bfr[2] = (uint8_t) color;
}

bool ChipInterface::sendLedColors(ClientInfo* ci, bool hddNotFdd)
{
    if(ci->fdClient == FD_EMPTY) {
        return false;
    }

    uint8_t data[6];
    uint32_t len;
    uint16_t cmd;

    if(hddNotFdd) {
        storeRgb(data,     ledColorFromSettings(LED_COLOR_SETTING_ACSI, LED_COLOR_DEFAULT_ACSI));
        storeRgb(data + 3, ledColorFromSettings(LED_COLOR_SETTING_SCSI, LED_COLOR_DEFAULT_SCSI));
        len = 6;
        cmd = CMD_LED_COLORS;
    } else {
        storeRgb(data,     ledColorFromSettings(LED_COLOR_SETTING_FDD, LED_COLOR_DEFAULT_FDD));
        len = 3;
        cmd = ATN_LED_COLORS;
    }

    if(!sendHeaderAndDataToChip(ci->fdClient, cmd, data, len)) {
        Debug::out(whichLog, LOG_WARNING, "sendLedColors - failed to send");
        return false;
    }

    ci->ledColorsSent = true;
    if(hddNotFdd) {
        Debug::out(whichLog, LOG_DEBUG, "sendLedColors - sent ACSI: %02X%02X%02X, SCSI: %02X%02X%02X", data[0], data[1], data[2], data[3], data[4], data[5]);
    } else {
        Debug::out(whichLog, LOG_DEBUG, "sendLedColors - sent: %02X%02X%02X", data[0], data[1], data[2]);
    }
    return true;
}

void ChipInterface::sendLedColorsIfNotSent(ClientInfo* ci, bool hddNotFdd)
{
    if(!ci->ledColorsSent) {
        sendLedColors(ci, hddNotFdd);
    }
}

void ChipInterface::sendLedColorsToAll(bool hddNotFdd)
{
    for(int i=0; i<MAX_CLIENTS; i++) {
        if(clients[i].fdClient != FD_EMPTY) {
            sendLedColors(&clients[i], hddNotFdd);
        }
    }
}

void ChipInterface::storeDeviceFeatures(uint8_t* mac, uint8_t featureBits)
{
    std::string featureString;

    if(featureBits & DEV_FEATURE_ACSI) featureString += "A";
    if(featureBits & DEV_FEATURE_SCSI) featureString += "S";
    if(featureBits & DEV_FEATURE_FDD) featureString += "F";
    if(featureBits & DEV_FEATURE_IKBD) featureString += "I";

    Debug::out(whichLog, LOG_DEBUG, "storeDeviceFeatures - mac: %02X:%02X:%02X:%02X:%02X:%02X, features: %s", mac[0], mac[1], mac[2], mac[3], mac[4], mac[5], featureString.c_str());

    Settings s(mac);
    s.setString("features", featureString.c_str());
}

bool ChipInterface::getFWversionFdd(ClientInfo* ci)
{
    return getFWversion(ci, false);
}

bool ChipInterface::hdd_sendData_start(int& fdClient, uint32_t totalDataCount, uint8_t scsiStatus, bool withStatus)
{
    if(totalDataCount > 0xffffff) {
        Debug::out(whichLog, LOG_ERROR, "ChipInterface::hdd_sendData_start -- trying to send more than 16 MB, fail");
        return false;
    }

    Utils::store24bits(&bufOut[0], totalDataCount);             // store data size
    bufOut[3] = scsiStatus;                                     // store status

    // transmit this command
    uint8_t cmd = withStatus ? CMD_DATA_READ_WITH_STATUS : CMD_DATA_READ_WITHOUT_STATUS;  // store command - with or without status
    bool good = sendHeaderAndDataToChip(fdClient, cmd, bufOut, 4);

    if(!good) {
        Debug::out(whichLog, LOG_ERROR, "ChipInterface::hdd_sendData_start -- failed to send command to Hans");
    }

    return good;
}

bool ChipInterface::hdd_sendData_transferBlock(int& fdClient, uint8_t *pData, uint32_t dataCount, bool withHeader)
{
    if(withHeader)      // with header? send header and data
    {
        return sendHeaderAndDataToChip(fdClient, CMD_DATA_MARKER, pData, dataCount);
    }

    // without header? send just data
    return sendDataToChip(fdClient, pData, dataCount);
}

bool ChipInterface::hdd_recvData_start(int& fdClient, uint8_t *recvBuffer, uint32_t totalDataCount)
{
    if(totalDataCount > 0xffffff) {
        Debug::out(whichLog, LOG_ERROR, "ChipInterface::hdd_recvData_start() -- trying to send more than 16 MB, fail");
        return false;
    }

    // first send the command and tell Hans that we need WRITE data
    Utils::store24bits(&bufOut[0], totalDataCount);             // store data size
    bufOut[3] = 0xff;                                           // store INVALID status, because the real status will be sent on CMD_SEND_STATUS

    // transmit this command
    bool good = sendHeaderAndDataToChip(fdClient, CMD_DATA_WRITE, bufOut, 4);

    if(!good) {
        Debug::out(whichLog, LOG_ERROR, "ChipInterface::hdd_recvData_start() -- failed to send command to Hans");
    }

    return good;
}

bool ChipInterface::hdd_recvData_transferBlock(int& fdClient, uint8_t *pData, uint32_t dataCount, bool withHeader)
{
    ClientInfo* ci = clientGetByFd(fdClient);
    if(!ci) {
        Debug::out(whichLog, LOG_WARNING, "hdd_recvData_transferBlock() - failed to get client for fdClient: %d", fdClient);
        return false;
    }

    if(withHeader)
    {
        uint8_t inBuf[10];
        bool good = waitForAtn(ci->index, NET_ATN_HANS_ID, ATN_WRITE_MORE_DATA, 1000, inBuf);

        if(!good) {         // failed to get right CMD from Hans? fail
            return false;
        }
    }

    while(dataCount > 0) {
        // request maximum 512 bytes from host
        uint32_t subCount = MIN(dataCount, 512);
        uint32_t gotCount = recvFromClient(fdClient, pData, subCount);

        if(gotCount < subCount) {       // if not all data was received, fail
            return false;
        }

        dataCount -= subCount;  // decreate the data counter
        pData += subCount;      // move in the buffer further
    }

    return true;
}

bool ChipInterface::hdd_sendStatusToHans(int& fdClient, uint8_t statusByte)
{
    Debug::out(whichLog, LOG_DEBUG, "hdd_sendStatusToHans - statusByte: %02x", statusByte);

    bufOut[0] = statusByte;                          // set the command and the statusByte
    bool good = sendHeaderAndDataToChip(fdClient, CMD_SEND_STATUS, bufOut, 1);

    if(!good) {
        Debug::out(whichLog, LOG_ERROR, "hdd_sendStatusToHans - failed to send status to Hans");
    }

    return good;
}

bool ChipInterface::hdd_pioRead(int& fdClient, uint8_t* data, uint32_t len)
{
    if(len > PIO_READ_MAX_LEN) {                    // device waits for at most 64 payload bytes, longer payload would be cut
        Debug::out(whichLog, LOG_ERROR, "hdd_pioRead - %d bytes is more than %d, fail", len, PIO_READ_MAX_LEN);
        return false;
    }

    bool good = sendHeaderAndDataToChip(fdClient, CMD_PIO_READ, data, len);

    if(!good) {
        Debug::out(whichLog, LOG_ERROR, "hdd_pioRead - failed to send to Hans");
    }

    return good;
}

bool ChipInterface::hdd_pioWrite_start(int& fdClient, uint32_t totalDataCount)
{
    if(totalDataCount == 0 || totalDataCount > 0xffffff) {
        Debug::out(whichLog, LOG_ERROR, "hdd_pioWrite_start - bad data count %u, fail", totalDataCount);
        return false;
    }

    Utils::store24bits(&bufOut[0], totalDataCount);
    bufOut[3] = 0;

    bool good = sendHeaderAndDataToChip(fdClient, CMD_PIO_WRITE, bufOut, 4);

    if(!good) {
        Debug::out(whichLog, LOG_ERROR, "hdd_pioWrite_start - failed to send command to Hans");
    }

    return good;
}

/*
    DMA write from ST, but the device takes the data in bursts: firstBurst bytes, then burst bytes each, the burst starts
    every burstPeriodUs. Before the 1st burst it waits startDelayMs. If ST doesn't start sending the data at all, device
    sends timeoutStatus to ST by itself (the ST waits for the status), and the transfer to host is not finished. If ST stops
    sending in the middle (e.g. Signum sends just height / 8 bands of 8 lines), the device fills the rest with zeros
    (blank, as the real printer which can't stop the paper) and the transfer to host finishes normally.

    Payload (big endian):
        0..3    total data count
        4..5    first burst size
        6..7    burst size
        8..11   burst period in us
        12..13  start delay in ms
        14      status byte on timeout
        15      reserved
*/
bool ChipInterface::hdd_recvDataPaced_start(int& fdClient, uint32_t totalDataCount, uint16_t firstBurst, uint16_t burst,
                                            uint32_t burstPeriodUs, uint16_t startDelayMs, uint8_t timeoutStatus)
{
    if(totalDataCount == 0 || totalDataCount > 0xffffff || firstBurst == 0 || burst == 0) {
        Debug::out(whichLog, LOG_ERROR, "hdd_recvDataPaced_start - bad params: total %u, firstBurst %d, burst %d - fail", totalDataCount, firstBurst, burst);
        return false;
    }

    uint8_t bfr[DATA_WRITE_PACED_PAYLOAD_SIZE];
    memset(bfr, 0, sizeof(bfr));

    Utils::storeDword(bfr +  0, totalDataCount);
    Utils::storeWord (bfr +  4, firstBurst);
    Utils::storeWord (bfr +  6, burst);
    Utils::storeDword(bfr +  8, burstPeriodUs);
    Utils::storeWord (bfr + 12, startDelayMs);
    bfr[14] = timeoutStatus;

    bool good = sendHeaderAndDataToChip(fdClient, CMD_DATA_WRITE_PACED, bfr, sizeof(bfr));

    if(!good) {
        Debug::out(whichLog, LOG_ERROR, "hdd_recvDataPaced_start - failed to send command to Hans");
    }

    return good;
}

void ChipInterface::fdd_sendTrackToChip(int& fdClient, int byteCount, uint8_t *encodedTrack)
{
    // Debug::out(whichLog, LOG_DEBUG, "fdd_sendTrackToChip -- byteCount: %d", byteCount);
    sendHeaderAndDataToChip(fdClient, ATN_SEND_TRACK, encodedTrack, byteCount);
}

void ChipInterface::fdd_sendImageParamsToChip(int& fdClient, bool finished, int imgTracks, int imgSides, int imgSectorsPerTrack, std::string fileName, bool readOnly)
{
    uint8_t bfr[64];
    memset(bfr, 0, 64);

    bfr[0] = finished ? 1 : 0;              // 1 for finished sending, 0 for start of sending
    bfr[1] = (uint8_t) imgTracks;
    bfr[2] = (uint8_t) imgSides;
    bfr[3] = (uint8_t) imgSectorsPerTrack;

    int fnameLen = MIN(fileName.length(), 31);
    memcpy(bfr + 4, fileName.c_str(), fnameLen);    // filename, max 31 chars + zero terminator
    bfr[4 + 32] = readOnly ? 1 : 0;                 // the ST should see a write protected disk

    Debug::out(whichLog, LOG_DEBUG, "fdd_sendImageParamsToChip -- finished: %d, tracks: %d, sides: %d, spt: %d, filename: %s", bfr[0], bfr[1], bfr[2], bfr[3], bfr + 4);
    sendHeaderAndDataToChip(fdClient, ATN_SEND_WHOLE_IMAGE, bfr, 4 + 32 + 1);   // 4 bytes param, 32 bytes filename, read only flag
}

uint8_t* ChipInterface::fdd_sectorWritten(ClientInfo* ci, int &side, int &track, int &sector, int &byteCount)
{
    // get all the remaining data
    byteCount = readRestOfData(ci, bufIn, MFM_STREAM_SIZE);

    // get the written sector, side, track number
    sector  = bufIn[1];
    track   = bufIn[0] & 0x7f;
    side    = (bufIn[0] & 0x80) ? 1 : 0;

    // remove the 2 bytes of side + track and sector from count, nothing left if not even those were received
    byteCount = (byteCount > 2) ? (byteCount - 2) : 0;

    return (bufIn + 2);         // return pointer to received written sector (beyond sector / track bytes)
}

bool ChipInterface::waitForAtn(int clientIndex, int atnIdWant, uint8_t atnCodeWant, uint32_t timeoutMs, uint8_t *inBuf)
{
    gotAtnId = 0;
    gotAtnCode = 0;

    BufferedReader* bufReader = &clients[clientIndex].bufReader;
    bufReader->setFd(clients[clientIndex].fdClient);

    // we might need to wait for ATN multiple times, as there might be ZEROS packet or IKBD packet before we read wanted Hans or Franz packet
    while(sigintReceived == 0) {
        // check for any ATN code waiting from Hans
        int atnIdGot = bufReader->waitForAtn(atnCodeWant, timeoutMs);   // which chip wants to communicate? (which chip's stream we should process?)
        uint8_t atnCodeGot = bufReader->getAtnCode();                   // what command does this chip wants us to handle?

        if(atnIdGot == NET_ATN_DISCONNECTED) {         // if buffered reader detected client disconnect, close it and quit
            Debug::out(whichLog, LOG_DEBUG, "waitForAtn() - DISCONNECTED!");

            clientsCloseOne(&clients[clientIndex]);

            return false;
        }

        // it's not ZEROS and not IKBD, but it's NONE? fail
        if(atnIdGot == NET_ATN_NONE_ID) {
            return false;
        }

        //Debug::out(whichLog, LOG_DEBUG, "waitForAtn() - atnIdGot=%d, atnCode=%d", atnIdGot, atnCode);

        // if we got here, it'z not ZEROS, IKDB or NONE, so it's FRANZ or HANS
        memcpy(inBuf, bufReader->getHeaderPointer(), 8); // copy in the header to start of buffer
        bufReader->clear();                              // clear buffered reader after reading data

        //Debug::out(whichLog, LOG_DEBUG, "waitForAtn() - %02X %02X %02X %02X %02X %02X %02X %02X", inBuf[0], inBuf[1], inBuf[2], inBuf[3], inBuf[4], inBuf[5], inBuf[6], inBuf[7]);

        // store which chip wants which command to be handled
        gotAtnId = atnIdGot;
        gotAtnCode = atnCodeGot;

        if(atnIdWant == NET_ATN_ANY_ID) {               // waiting for ANY? then Franz or Hans is fine
            return true;
        }

        // wanted Hans and got Hans, or wanted Franz and got Franz? good
        if(atnIdWant == atnIdGot) {
            return true;
        }

        // if arrived here, no wanted ATN was found
        break;
    }

    // wanted ATN didn't come
    return false;
}

void ChipInterface::storeHeaderToBuffer(uint16_t cmdCode, uint32_t futureDatalen, uint8_t* buffer)
{
    Utils::storeDword(buffer + 0, whichSyncTag);  // 0..3: 0xc050d1c5 [COSmODICS] (4 bytes)
    Utils::storeWord(buffer + 4, cmdCode);        // 4..5: ATN code (2 bytes)
    Utils::storeDword(buffer + 6, futureDatalen); // 6..9: futureDatalen (4 bytes)
}

/*
    Send all the data to client, looping over partial writes.
    On any failure (disconnect, send timeout) the stream would be out of sync
    (receiver expects the rest of the data), so the client gets closed.
*/
bool ChipInterface::sendAll(int& fdClient, const uint8_t* data, uint32_t len)
{
    uint32_t sent = 0;

    while(sent < len) {
        if(fdClient < 0) {                  // no client socket? quit
            return false;
        }

        ssize_t res = send(fdClient, data + sent, len - sent, SEND_NOSIGNAL);

        if(res > 0) {                       // some (or all) bytes sent? continue with the rest
            sent += res;
            continue;
        }

        if(res < 0 && errno == EINTR) {     // interrupted by signal before sending anything? try again
            continue;
        }

        // EPIPE / ECONNRESET = client gone, EAGAIN / EWOULDBLOCK = SO_SNDTIMEO expired
        Debug::out(whichLog, LOG_WARNING, "sendAll() - fdClient %d: sent %d of %d bytes, error: %s",
                   fdClient, sent, len, (res < 0) ? strerror(errno) : "send() returned 0");
        closeClientByFd(fdClient);
        return false;
    }

    return true;
}

bool ChipInterface::sendHeaderToChip(int& fdClient, uint16_t cmdCode, uint32_t futureDatalen)        // send header to chip
{
    if(fdClient < 0) {                      // no client socket? quit
        return false;
    }

    uint8_t head[10];
    storeHeaderToBuffer(cmdCode, futureDatalen, head);
    return sendAll(fdClient, head, 10);     // send header
}

bool ChipInterface::sendDataToChip(int& fdClient, uint8_t* data, uint32_t len)        // send data to chip
{
    return sendAll(fdClient, data, len);    // send data
}

bool ChipInterface::sendHeaderAndDataToChip(int& fdClient, uint16_t cmdCode, uint8_t* data, uint32_t len)        // send header and data to chip
{
    bool good;

    if(len > 512)       // for larger data send using separate write commands
    {
        if(!sendHeaderToChip(fdClient, cmdCode, len))
        {
            Debug::out(whichLog, LOG_DEBUG, "sendHeaderAndDataToChip failed!");
            return false;
        }

        good = sendDataToChip(fdClient, data, len);

        if(!good) {
            Debug::out(whichLog, LOG_DEBUG, "sendHeaderAndDataToChip - good: %d", good);
        }
    }
    else                // for small data first copy data into buffers, then send with one write command
    {
        if(fdClient < 0) {                      // no client socket? quit
            return false;
        }

        uint8_t bfr[522];
        storeHeaderToBuffer(cmdCode, len, bfr);     // store header at start
        memcpy(bfr + 10, data, len);                // copy data after the header

        good = sendAll(fdClient, bfr, len + 10);    // send header and data
    }

    return good;
}

/*
    Receive data from client, up to rest of the data size specified in header,
    respecting maximum length of buffer (maxLen).
*/
uint32_t ChipInterface::recvFromClient(int& fdClient, uint8_t* buf, int maxLen)
{
    int received = 0;                       // total received count

    ClientInfo* ci = clientGetByFd(fdClient);
    if(!ci) {
        Debug::out(whichLog, LOG_WARNING, "recvFromClient() - failed to get client for fdClient: %d", fdClient);
        return 0;
    }

    uint32_t dataSize = ci->bufReader.dataSizeRest();          // get how many bytes we can read from the client to get whole data part
    uint32_t readSize = MIN(dataSize, (uint32_t) maxLen);   // read less if supplied buffer is not large enough, or there isn't as much data as requested

    // TCP can deliver the data in any number of pieces (especially over WiFi), so keep receiving until we have it all.
    // Each recv() waits at most SO_RCVTIMEO (set on accept); the overall deadline stops a sender which trickles data forever.
    Timeout deadline(RECV_FROM_CLIENT_TIMEOUT_MS);

    while(readSize > 0)
    {
        ssize_t bytes = recv(fdClient, buf + received, readSize, 0);    // try to receive the rest

        if(bytes > 0) {                         // on data received
            received += bytes;
            readSize -= bytes;
        } else if(bytes == 0) {                 // peer closed connection - nothing more will come
            Debug::out(whichLog, LOG_DEBUG, "recvFromClient() - connection closed by client, got %d bytes, missing %u", received, readSize);
            break;
        } else if(errno == EINTR) {             // interrupted by signal before receiving anything? just try again
            continue;
        } else {                                // EAGAIN / EWOULDBLOCK = SO_RCVTIMEO expired with no data, or real error
            Debug::out(whichLog, LOG_WARNING, "recvFromClient() - recv() failed after %d bytes, missing %u: %s", received, readSize, strerror(errno));
            break;
        }

        if(readSize > 0 && deadline.expired()) {    // data still missing, but it takes too long? give up
            Debug::out(whichLog, LOG_WARNING, "recvFromClient() - timeout after %d bytes, missing %u", received, readSize);
            break;
        }
    }

    // if(received > 0) {
    //     Debug::out(whichLog, LOG_DEBUG, "recvFromClient(): %d bytes", received);
    //     Debug::outBfr(LOGFILE_HDD, buf, received);
    // }

    ci->bufReader.decreaseDataSize((uint32_t) received);    // decrease the remaining data by the size we have received
    return received;        // return total bytes received
}

void ChipInterface::setFDDconfig(bool setFloppyConfig, FloppyConfig* fddConfig, bool setDiskChanged, bool diskChanged)
{
    // memset(fwResponseBfr, 0, FDD_FW_RESPONSE_LEN);

    // responseStart(FDD_FW_RESPONSE_LEN);                             // init the response struct
    // floppySoundEnabled = fddConfig->soundEnabled;               // store this in instance var for later use

    // if(setFloppyConfig) {                                       // should set floppy config?
    //     // responseAddByte(fwResponseBfr, ( fddConfig->enabled         ? CMD_DRIVE_ENABLED     : CMD_DRIVE_DISABLED) );
    //     // responseAddByte(fwResponseBfr, ((fddConfig->id == 0)        ? CMD_SET_DRIVE_ID_0    : CMD_SET_DRIVE_ID_1) );
    //     // responseAddByte(fwResponseBfr, ( fddConfig->writeProtected  ? CMD_WRITE_PROTECT_ON  : CMD_WRITE_PROTECT_OFF) );
    // }

    // if(setDiskChanged) {
    //     // responseAddByte(fwResponseBfr, ( diskChanged    ? CMD_DISK_CHANGE_ON    : CMD_DISK_CHANGE_OFF) );
    // }
}

void ChipInterface::clientsClearOne(ClientInfo* info)
{
    info->fdClient = FD_EMPTY;
    info->ipAddr = 0;
    memset(info->mac, 0, 6);
    info->floppySlotIndex = FD_EMPTY;
    info->lastMs = 0;
    info->features = 0;
    info->deviceSettings = -1;
    info->deviceSettingsSeen = -1;
    info->ledColorsSent = false;
    info->bufReader.reset();    // drop any partial header / remaining data size from previous connection
}

void ChipInterface::clientsClearAll(void)
{
    for(int i=0; i<MAX_CLIENTS; i++) {
        clients[i].index = i;
        clientsClearOne(&clients[i]);
    }
}

// closes socket if open, then does clientsClearOne()
void ChipInterface::clientsCloseOne(ClientInfo* info)
{
    Utils::closeFdIfOpen(info->fdClient);
    clientsClearOne(info);
}

int ChipInterface::clientsGetEmptyIndex(void)
{
    for(int i=0; i<MAX_CLIENTS; i++) {
        if(clients[i].fdClient == FD_EMPTY) {   // if this slot is empty, return it's index
            return i;
        }
    }

    return FD_EMPTY;        // nothing is empty
}

// Close all other clients of the same device - same IP, or same (known) MAC, e.g. after IP change by DHCP.
// When a device reconnects (e.g. after reboot / power loss), its old connections stay half-open on our side - the device
// didn't close them. It never keeps 2 connections to the same core, so the old ones are dead and can be closed right away
// (instead of waiting for the inactivity timeout). Returns floppy slot of the closed client (FD_EMPTY if none / not FDD).
int ChipInterface::clientsCloseOlderOfDevice(ClientInfo* newInfo, uint32_t ipAddr, uint8_t* mac)
{
    static const uint8_t zeroMac[6] = {0};
    bool macKnown = (memcmp(mac, zeroMac, 6) != 0);
    int  oldFloppySlot = FD_EMPTY;

    for(int i=0; i<MAX_CLIENTS; i++) {
        ClientInfo* ci = &clients[i];

        if(ci == newInfo || ci->fdClient == FD_EMPTY) {        // the new client itself, or empty slot? skip
            continue;
        }

        bool sameIp  = (ci->ipAddr == ipAddr);
        bool sameMac = macKnown && (memcmp(ci->mac, mac, 6) == 0);

        if(!sameIp && !sameMac) {                               // other device? keep it
            continue;
        }

        Debug::out(whichLog, LOG_INFO, "clientsCloseOlderOfDevice - device reconnected (same %s), closing its old client #%d (floppy slot %d)",
                   sameIp ? "IP" : "MAC", i, ci->floppySlotIndex);

        if(oldFloppySlot == FD_EMPTY) {
            oldFloppySlot = ci->floppySlotIndex;                // reconnected device keeps its floppy slot
        }

        clientsCloseOne(ci);
    }

    return oldFloppySlot;
}

// find floppy slot which is not used by any client
int ChipInterface::clientsGetFreeFloppySlot(void)
{
    uint32_t usedSlots = 0;

    for(int i=0; i<MAX_CLIENTS; i++) {
        if(clients[i].fdClient != FD_EMPTY && clients[i].floppySlotIndex != FD_EMPTY) {    // this client has a floppy slot, add its bit to usedSlots
            usedSlots |= (1 << clients[i].floppySlotIndex);
        }
    }

    for(int i=0; i<MAX_CLIENTS; i++) {
        if((usedSlots & (1 << i)) == 0) {       // floppy slot i not used, return it
            return i;
        }
    }

    Debug::out(whichLog, LOG_ERROR, "clientsGetFreeFloppySlot - no free floppy slot found");
    return FD_EMPTY;
}

void ChipInterface::clientsStoreOne(ClientInfo* info, int newSock, uint32_t ipAddr, uint8_t* mac, bool isFdd)
{
    Debug::out(whichLog, LOG_DEBUG, "clientsStoreOne - client %d - storing fdClient: %d, ipAddr: %08x, isFdd: %d", info->index, newSock, ipAddr, isFdd);

    // for every core (HDD / FDD / IKBD): old connections of this device are dead now - close them
    int oldFloppySlot = clientsCloseOlderOfDevice(info, ipAddr, mac);

    info->fdClient = newSock;
    info->lastMs = Utils::getCurrentMs();
    info->ipAddr = ipAddr;
    memcpy(info->mac, mac, 6);
    info->deviceSettings = -1;          // the new connection reports them again - and they're the truth then
    info->deviceSettingsSeen = -1;
    info->ledColorsSent = false;        // the new connection gets them again

    if(isFdd) {         // floppy: reconnected device keeps its slot, new device gets a free one
        info->floppySlotIndex = (oldFloppySlot != FD_EMPTY) ? oldFloppySlot : clientsGetFreeFloppySlot();
    } else {            // hdd or ikbd: just use 0 here
        info->floppySlotIndex = 0;
    }
}

void ChipInterface::clientsDisconnectInactive(void)
{
    uint32_t now = Utils::getCurrentMs();

    for(int i=0; i<MAX_CLIENTS; i++) {
        if(clients[i].fdClient == FD_EMPTY) {      // no client at this index? skip
            continue;
        }

        // there hasn't been any data from this client for some time? close connection
        uint32_t diff = now - clients[i].lastMs;

        if(diff > 15000) {
            clientsCloseOne(&clients[i]);

            Debug::out(whichLog, LOG_INFO, "disconnected inactive client #%i", i);
        }
    }
}

int ChipInterface::getFdListen(void)
{
    return fdListen;
}

ClientInfo* ChipInterface::clientGetByIndex(int index)
{
    if(index < 0 || index >= MAX_CLIENTS) {
        return NULL;
    }

    return &clients[index];
}

ClientInfo* ChipInterface::clientGetByFd(int fdClient)
{
    for(int i=0; i<MAX_CLIENTS; i++) {
        if(clients[i].fdClient == fdClient) {     // found matching fd? return pointer
            return &clients[i];
        }
    }

    return NULL;    // not found, return null
}

ClientInfo* ChipInterface::clientsGetOneByFloppySlot(int floppySlotIndex)     // get by floppy slot
{
    if(floppySlotIndex < 0) {           // invalid slot (e.g. FD_EMPTY)? would match empty clients, so don't search
        return NULL;
    }

    for(int i=0; i<MAX_CLIENTS; i++) {
        if(clients[i].fdClient == FD_EMPTY) {                   // no client at this index? skip
            continue;
        }

        if(clients[i].floppySlotIndex == floppySlotIndex) {     // found matching floppy slot index? return pointer
            return &clients[i];
        }
    }

    return NULL;    // not found, return null
}

ClientInfo* ChipInterface::clientsGetOneByMac(uint8_t* mac)     // get by mac
{
    static const uint8_t zeroMac[6] = {0};
    if(memcmp(mac, zeroMac, 6) == 0) {  // all-zero mac means unknown mac, would match empty clients or clients without mac yet
        return NULL;
    }

    for(int i=0; i<MAX_CLIENTS; i++) {
        if(clients[i].fdClient == FD_EMPTY) {           // no client at this index? skip
            continue;
        }

        if(memcmp(clients[i].mac, mac, 6) == 0) {       // found matching mac? return pointer
            return &clients[i];
        }
    }

    return NULL;    // not found, return null
}

void ChipInterface::dropRestOfData(ClientInfo* ci, uint8_t* buffer, uint32_t bufferSize)
{
    memset(buffer, 0, bufferSize);
    int readSize = MIN(ci->bufReader.dataSizeRest(), bufferSize);
    recvFromClient(ci->fdClient, buffer, readSize);
}

int ChipInterface::readRestOfData(ClientInfo* ci, uint8_t* buffer, uint32_t bufferSize)
{
    memset(buffer, 0, bufferSize);
    int readSize = MIN(ci->bufReader.dataSizeRest(), bufferSize);
    return recvFromClient(ci->fdClient, buffer, readSize);
}

void ChipInterface::ikbdUartWriteToAll(uint8_t* bfr, int len)
{
    for(int i=0; i<MAX_CLIENTS; i++) {
        if(clients[i].fdClient == FD_EMPTY) {      // client not connected here? skip it
            continue;
        }

        sendAll(clients[i].fdClient, bfr, len);     // send it, client gets closed on failure
    }
}

void ChipInterface::closeClientByFd(int& fdClient)
{
    Debug::out(whichLog, LOG_INFO, "client fdClient %d disconnected", fdClient);

    ClientInfo* ci = clientGetByFd(fdClient);
    if(ci) {
        clientsCloseOne(ci);
    }

    fdClient = FD_EMPTY;
}
