atarijookie/cosmo2ex/ce_cores/chipinterface/chipinterface.h

#ifndef __CHIPINTERFACE_H__
#define __CHIPINTERFACE_H__

#include <stdint.h>
#include <sys/socket.h>
#include <netinet/in.h>
#include <string>

#include "chipinterfacedefs.h"
#include "bufferedreader.h"
#include "../misc/settings.h"

typedef struct {
    int         index;
    int         fdClient;           // tcp socket fd
    uint32_t    ipAddr;             // client's IP addr
    uint8_t     mac[6];             // client's mac addr
    uint8_t     features;           // DEV_FEATURE_ bits
    int         deviceSettings;     // DEV_SETTING_* bits from the last FW report, -1 = not reported (older firmware)
    int         deviceSettingsSeen; // deviceSettings already handled by fdd_syncDeviceSettings(), -1 = none since connect
    bool        ledColorsSent;      // LED colors sent on this connection (sendLedColors())
    int         floppySlotIndex;    // which floppy slot this IP is using
    uint32_t    lastMs;             // value of getCurrentMs() when was last time anything was received from this client

    BufferedReader bufReader;
} ClientInfo;

#define RECV_FROM_CLIENT_TIMEOUT_MS     3000    // max time to receive one block of data from client

// per-device settings of the FDD device, shared with the webserver (webserver/fdd.go)
#define FDD_SETTING_IKBD_ENABLED        "FDD_IKBD_ENABLED"
#define FDD_SETTING_BEEP_ON_STEP        "FDD_BEEP_ON_STEP"
#define FDD_SETTING_PENDING             "FDD_SETTINGS_PENDING"     // 1 = changed in the web UI, not sent to the device yet

// neopixel colors while running - global settings shared with the webserver (webserver/settings.go), RGB hex "rrggbb";
// the defaults are the same as in the devices (ce_pico_hdd / ce_pico_fdd neopixel.cpp)
#define LED_COLOR_SETTING_ACSI          "LED_COLOR_ACSI"
#define LED_COLOR_SETTING_SCSI          "LED_COLOR_SCSI"
#define LED_COLOR_SETTING_FDD           "LED_COLOR_FDD"
#define LED_COLOR_DEFAULT_ACSI          0x003000        // green
#define LED_COLOR_DEFAULT_SCSI          0x000040        // blue
#define LED_COLOR_DEFAULT_FDD           0x003000        // green

class ChipInterface
{
public:
    ChipInterface(int whichLogFile, int whichAtnCode, uint32_t whichSyncTagCode, uint16_t portListen);
    virtual ~ChipInterface();

    // not copyable - owns buffers and socket fds, a copy would free / close them twice
    ChipInterface(const ChipInterface&) = delete;
    ChipInterface& operator=(const ChipInterface&) = delete;

    // this return CHIP_IF_V1_V2 or some other
    int chipInterfaceType(void);

    //----------------
    // chip interface initialization and deinitialization - e.g. open GPIO, or open socket, ...
    bool ciOpen(void);
    void ciClose(void);

    int getFdListen(void);

    //----------------
    // if following function returns true, some command is waiting for action in the inBuf and hardNotFloppy flag distiguishes hard-drive or floppy-drive command
    bool actionNeeded(ClientInfo* ci, uint8_t *inBuf);
    void dropRestOfData(ClientInfo* ci, uint8_t* buffer, uint32_t bufferSize);

    // to handle FW version
    uint8_t getFWversion(ClientInfo* ci, bool hddNotFdd);
    uint8_t getFWversionHdd(ClientInfo* ci);
    bool getFWversionFdd(ClientInfo* ci);

    // FDD device settings (beep on step, device IKBD): the device keeps them (EEPROM, its captive portal), the web UI
    // changes them in the per-device settings (FDD_SETTING_* keys) and asks the FDD core to send them to the device.
    void fdd_syncDeviceSettings(ClientInfo* ci);    // after a FW report: store the device's settings when they changed there
    bool fdd_sendDeviceSettings(ClientInfo* ci);    // send the stored settings to the device, clears the pending flag

    // LED colors (global settings from the web UI) to the device: HDD gets ACSI + SCSI color (CMD_LED_COLORS), FDD its
    // color (ATN_LED_COLORS). The device stores them only when they differ from what it has.
    bool sendLedColors(ClientInfo* ci, bool hddNotFdd);
    void sendLedColorsIfNotSent(ClientInfo* ci, bool hddNotFdd);   // once per connection - after the FW report
    void sendLedColorsToAll(bool hddNotFdd);                        // changed in the web UI
    static uint32_t ledColorFromSettings(const char* key, uint32_t defColor);   // 0xRRGGBB, default if missing / invalid

    //----------------
    // HDD: READ/WRITE functions for large (>1 MB) block transfers (Scsi::readSectors(), Scsi::writeSectors()) and also by the convenient functions above

    bool hdd_sendData_start(int& fdClient, uint32_t totalDataCount, uint8_t scsiStatus, bool withStatus);
    bool hdd_sendData_transferBlock(int& fdClient, uint8_t *pData, uint32_t dataCount, bool withHeader = true);

    bool hdd_recvData_start(int& fdClient, uint8_t *recvBuffer, uint32_t totalDataCount);
    bool hdd_recvData_transferBlock(int& fdClient, uint8_t *pData, uint32_t dataCount, bool withHeader = true);

    bool hdd_sendStatusToHans(int& fdClient, uint8_t statusByte);

    // HDD: ACSI only, for the SLM laser printer (hdd/slm/)
    bool hdd_pioRead(int& fdClient, uint8_t* data, uint32_t len);          // send bytes to ST with CS / INT handshake (len 0: no bytes, device just goes to waiting for next command)
    bool hdd_pioWrite_start(int& fdClient, uint32_t totalDataCount);       // get bytes from ST with CS / INT handshake, receive them with hdd_recvData_transferBlock()
    bool hdd_recvDataPaced_start(int& fdClient, uint32_t totalDataCount, uint16_t firstBurst, uint16_t burst,
                                 uint32_t burstPeriodUs, uint16_t startDelayMs, uint8_t timeoutStatus);    // DMA write in bursts, receive with hdd_recvData_transferBlock()

    //----------------
    // FDD: all you need for handling the floppy interface
    void fdd_sendTrackToChip(int& fdClient, int byteCount, uint8_t *encodedTrack);    // send encodedTrack to chip for MFM streaming
    uint8_t* fdd_sectorWritten(ClientInfo* ci, int &side, int &track, int &sector, int &byteCount);
    void fdd_sendImageParamsToChip(int& fdClient, bool finished, int imgTracks, int imgSides, int imgSectorsPerTrack, std::string fileName, bool readOnly);

    void setFDDconfig(bool setFloppyConfig, FloppyConfig* fddConfig, bool setDiskChanged, bool diskChanged);

    // the following ones are called from FloppyThread
    void clientsDisconnectInactive(void);
    ClientInfo* clientsGetOneByFloppySlot(int floppySlotIndex);     // get by floppy slot
    ClientInfo* clientsGetOneByMac(uint8_t* mac);                   // get by mac
    ClientInfo* clientGetByFd(int clientFd);
    ClientInfo* clientGetByIndex(int index);                        // get by client index

    void closeClientByFd(int& clientFd);

    int readRestOfData(ClientInfo* ci, uint8_t* buffer, uint32_t bufferSize);
    bool sendHeaderToChip(int& fdClient, uint16_t cmdCode, uint32_t futureDatalen);                // send header to chip
    bool sendDataToChip(int& fdClient, uint8_t* data, uint32_t len);                               // send data to chip
    bool sendHeaderAndDataToChip(int& fdClient, uint16_t cmdCode, uint8_t* data, uint32_t len);    // send header and data to chip
    void storeHeaderToBuffer(uint16_t cmdCode, uint32_t futureDatalen, uint8_t* buffer);

    int setAllClientFds(fd_set* readfds);
    void reportConnectedDevices(void);      // MACs of connected clients to ConnectedDevices, done by setAllClientFds() too
    int acceptSocketIfNeededAndPossible(void);

    // ikbd related
    void ikbdUartWriteToAll(uint8_t* bfr, int len);

private:
    int whichLog;
    int whichAtn;
    uint32_t whichSyncTag;
    uint16_t portListen;

    int fdListen;                       // socket for listen()
    ClientInfo clients[MAX_CLIENTS];

    struct sockaddr_in addressListen;

    uint8_t *bufOut;
    uint8_t *bufIn;

    uint8_t  gotAtnId;      // which chip wants to talk? Franz, Hans?
    uint8_t  gotAtnCode;    // which command code chips sends?

    bool createListeningSocket(void);
    uint32_t recvFromClient(int& fdClient, uint8_t* buf, int maxLen);     // receives all requested data (up to timeout), less only on timeout / disconnect / error
    bool sendAll(int& fdClient, const uint8_t* data, uint32_t len);   // send all bytes or close client

    bool waitForAtn(int clientIndex, int atnIdWant, uint8_t atnCodeWant, uint32_t timeoutMs, uint8_t *inBuf);

    //-----------
    void clientsClearOne(ClientInfo* info);     // clear data structure of one clients
    void clientsClearAll(void);                 // clear data structure of all clients
    void clientsCloseOne(ClientInfo* info);     // closes socket if open, then does clientsClearOne()
    int  clientsGetEmptyIndex(void);
    int  clientsCloseOlderOfDevice(ClientInfo* newInfo, uint32_t ipAddr, uint8_t* mac);    // returns floppy slot of closed client, or FD_EMPTY
    int  clientsGetFreeFloppySlot(void);
    void clientsStoreOne(ClientInfo* info, int newSock, uint32_t ipAddr, uint8_t* mac, bool isFdd);

    void storeDeviceFeatures(uint8_t* mac, uint8_t featureBits);
};

#endif
