atarijookie/cosmo2ex/ce_cores/ikbd/ikbd.h

// vim: shiftwidth=4 softtabstop=4 tabstop=4 expandtab
#ifndef _IKBD_H_
#define _IKBD_H_

#include <termios.h>
#include "linuxinput.h"

#include <bitset>

#include "ikbd_defs.h"
#include "cyclicbuff.h"
#include "../chipinterface/chipinterfacedefs.h"     // MAX_CLIENTS
#include "keybjoys.h"
#include "keytranslator.h"

//#define SPYIKBD

#define INPUT_EVENT_MAX_SIZE    32          // >= sizeof(input_event) and sizeof(js_event)

struct libevdev;

// USB keyboard / mouse / joystick attached to this machine, see inputdevices.h
typedef struct {
    char    devPath[256];
    int     fd;
    struct libevdev *evdev;                 // keyboard / mouse: libevdev of fd (for grab), NULL otherwise

    uint8_t partial[INPUT_EVENT_MAX_SIZE];  // part of event received so far - a read can return less than whole event
    int     partialLen;
} TInputDevice;

void inputDevClose(TInputDevice& dev);      // close the device (fd and libevdev), see inputdevices.cpp

#define JOYAXIS             8
#define JOYBUTTONS          12

// count of key to check for key combination
#define KBD_KEY_COUNT   256

#define UARTMARK_STCMD      0xAA
#define UARTMARK_KEYBDATA   0xBB
#define UARTMARK_ALIVE      0xEE

typedef struct {
    int axis[JOYAXIS];
    int button[JOYBUTTONS];

    int lastDir;
    int lastBtn;

    int lastDirAndBtn;
} TJoystickState;

void *ikbdThreadCode(void *ptr);
class ChipInterface;

// state which belongs to one connected device (one ST) - its data stream and its link to the ST
struct IkbdClientState {
    CyclicBuff  receivedData;           // raw tagged data from device
    CyclicBuff  stCommands;             // ST -> IKBD command bytes
    CyclicBuff  keyboardData;           // original keyboard -> ST bytes
    CyclicBuff  pausedOutput;           // data for ST queued while ST paused the output

    int         ceIkbdMode;             // SOLO, or INJECT when this ST has its own (original) keyboard sending data
    bool        outputEnabled;          // false after ST sent PAUSE OUTPUT, until any other command

    void reset(void) {
        receivedData.init();
        stCommands.init();
        keyboardData.init();
        pausedOutput.init();
        ceIkbdMode      = CE_IKBDMODE_SOLO;
        outputEnabled   = true;
    }
};

extern TInputDevice ikbdDevs[INTYPE_COUNT];

class Ikbd
{
public:
    Ikbd(ChipInterface* ciIkbd);

    void loadSettings(void);
    void reloadSettings(void);                      // settings changed (web UI) - release keyboard joysticks, load, resend joysticks

    void findDevices(void);                         // open all attached keyboard / mouse / joysticks we don't have yet
    void deviceAttached(const char *devNode);       // use this device if it's keyboard / mouse / joystick we don't have yet
    void deviceRemoved(const char *devNode);        // close it if it's ours, and look for another one instead
    void closeDevs(void);

    int getFdByIndex(int index);
    void deinitDev(int index);

    void processMouse(input_event *ev);
    void processKeyboard(input_event *ev, bool skipKeyboardTranslation);
    void processJoystick(js_event *jse, int joyNumber);
    void markInputMouseEventTime(void);                     // mouse event came from the input socket (see inputsocket.h)
    void setInputJoysticks(bool joy0, bool joy1);           // joysticks of apps on the input socket

    int processReceivedCommands(bool skipKeyboardTranslation, int fdUartRead);     // returns bytes read, 0 = nothing now, -1 = connection closed / broken

    void clientConnected(int clientIndex);      // new device in this client slot - start with clean state

private:
    ChipInterface* ciIkbd;

    enum JoystickState {
        Disabled,
        EnabledInMouseMode, // joy1 direction works but its button is mapped as mouse; joy0 is treated as mouse
        Enabled // joy1 and joy0 are treated as joysticks
    };

    IkbdClientState clientState[MAX_CLIENTS];  // per device (ST) state
    IkbdClientState noClientState;              // used when not processing data of any client
    IkbdClientState *cur;                       // state of the client whose data is being processed now
    int             curClientIndex;             // index of that client, -1 = none (output then goes to all clients)

    int     mouseBtnNow;
    int     mouseMode;
    bool    mouseEnabled;
    bool    mouseY0atTop;
    int     mouseAbsBtnAct;


    bool    firstJoyIs0;                    // if true, port 0 and port 1 are swapped for all joysticks (USB, keyboard, real Atari) - applied when sending
    bool    mouseWheelAsArrowsUpDown;       // if true, mouse wheel up / down will be translated to arrow up / down
    bool    keybJoy0;                       // if true, specific keys will act as joy 0
    bool    keybJoy1;                       // if true, specific keys will act as joy 1

    // this is basically all keys which are used for the hotswap, perhaps
    // it should be made a bit more flexible, for different key combinations
    int     leftShiftsPressed;  // how many LEFT SHIFTs are pressed (1x for PC, 1x for Atari)
    int     rightShiftsPressed; // how many RIGHT SHIFTs are pressed (1x for PC, 1x for Atari)
    int     ctrlsPressed;       // how many C[ON]TR[O]Ls are pressed (2x for PC, 1x for Atari)
    int     f11sPressed;        // HELP on Atari, F11 on PC
    int     f12sPressed;        // UNDO on Atari, F12 on PC
    bool    waitingForHotkeyRelease;

    KeybJoyKeys     keyJoyKeys;
    KeyTranslator   keyTranslator;

    struct {
        int        threshX, threshY;
        int        accX, accY;          // movement not reported yet (below threshold)
    } relMouse;

    struct {
        int        x,y;
        int        maxX, maxY;
        int        scaleX, scaleY;
        int        fracX, fracY;        // movement not turned into position yet (below scale)
        uint8_t    buttons;
    } absMouse;

    struct {
        uint8_t deltaX;
        uint8_t deltaY;
        int     accX, accY;             // movement not turned into cursor keys yet
    } keycodeMouse;

    bool            gotInputMouseEvent;         // some mouse event came from the input socket...
    uint32_t        lastInputMouseEventTime;    // ...at this time - mouse counts as present for 10 s after that
    bool            inputJoy[2];                // apps on the input socket send events of joystick 0 / 1

    int             joystickMode;
    TJoystickState  joystick[2];
    JoystickState   joystickState;


    uint8_t            specialCodeLen[10];
    uint8_t            stCommandLen[256];

    std::bitset<KBD_KEY_COUNT> pressedKeys;
    bool            keyboardExclusiveAccess;    // true when keyboard / mouse are grabbed (other programs don't get their events)

    // keys of keyboard joysticks which are held now: [joy][KJ_UP .. KJ_BUTTON]
    enum { KJ_UP, KJ_DOWN, KJ_LEFT, KJ_RIGHT, KJ_BUTTON, KJ_COUNT };
    bool            keybJoyHeld[2][KJ_COUNT];

    void initDevs(void);
    void initJoystickState(TJoystickState *joy);
    void fillKeyTranslationTable(void);
    void addToTable(int pcKey, int stKey, int humanKey=0);
    void fillSpecialCodeLengthTable(void);
    void fillStCommandsLengthTable(void);

    void resetInternalIkbdVars(void);
    void sendJoyButtonsInMouseMode(void);
    void sendJoyState(int joyNumber, int dirTotal);
    int  joyPort(int joyNumber);                // Atari port (0 / 1) on which joystick[joyNumber] is reported now (firstJoyIs0 swaps)
    void sendAllJoyStates(void);                // report current state of both joysticks (after swapping ports)
    void sendBothJoyReport(void);
    void mouseMoved(int dx, int dy);                    // USB mouse movement, dy > 0 = down
    void sendRelMousePackets(int dx, int dy);           // relative packet(s) with current buttons, split to fit -128..127
    uint8_t mouseButtonsWithJoy(void);                  // mouse buttons + joystick fire buttons acting as mouse buttons
    void sendKeyPress(uint8_t stKey);                   // make + break code
    void sendMousePosAbsolute(uint8_t absButtons);
    void fixAbsMousePos(void);

    void processStCommands(void);
    void processGetCommand(uint8_t getCmd);
    void processKeyboardData(bool skipKeyboardTranslation);

    bool gotUsbMouse(void);
    bool gotUsbKeyboard(void);
    bool gotUsbJoy1(void);
    bool gotUsbJoy2(void);

    void handlePcKeyAsKeybJoy(int joyNumber, int pcKey, int eventValue);
    bool handleStKeyAsKeybJoy(uint8_t val);
    void handleKeyAsKeybJoy  (bool pcNotSt, int joyNumber, int pcKey, bool keyDown);
    bool handleHotkeys(int pcKey, bool pressed, bool skipKeyboardTranslation);

    void toggleKeyboardExclusiveAccess(void);
    bool grabExclusiveAccess(int index);    // index: INTYPE_KEYBOARD / INTYPE_MOUSE, true if grabbed
    void releaseExclusiveAccess(int index);

    void dumpBuffer(bool fromStNotKeyboard);

    void resetHotkeyState(void);

    // all data for ST goes through here: to the client being processed, otherwise (USB input) to all clients
    void sendToSt(const uint8_t* bfr, int len);
    void sendToClient(int clientIndex, const uint8_t* bfr, int len);
};

#endif
