atarijookie/cosmo2ex/ce_pico_hdd/bridge_scsi.cpp

// SCSI variant of the bridge (see bridge.cpp for the common functions calling these)

#include "defs.h"
#include "bridge.h"
#include "utils.h"
#include "neopixel.h"

#include "scsi_write.pio.h"
#include "scsi_read.pio.h"

extern uint8_t brStat; // status from bridge

static PIO pioScsiWrite, pioScsiRead;
static uint smScsiWrite, smScsiRead;
static uint offsetScsiWrite, offsetScsiRead;

uint16_t byteWithParity[256];

static void PIO_read(uint8_t val);

// prefill the table with bytes inverted, extended with parity
static void prefillBytesWithParityTable(void)
{
    for(int i=0; i<256; i++) {
        uint16_t valPar = i;
        uint8_t parity = __builtin_parity(i);

        if(!parity) {           // if odd parity, then set parity bit
            valPar |= 0x100;
        }

        byteWithParity[i] = (~valPar) & 0x1ff;
    }
}

bool isAtnAsserted(void)
{
    int lvlOutLe2 = gpio_get_out_level(PIN_OUT_LE2);    // get the current output level of PIN_OUT_LE2
    gpio_put(PIN_OUT_LE2, 0);                           // put LE2 to L, so changing shared phase / handshake pins doesn't put out false req out

    int dirAtn = gpio_get_dir(PIN_ATN_MSG);             // get pin direction
    gpio_set_dir(PIN_ATN_MSG, GPIO_IN);                 // set as input (so it won't drive the pin to some last level, but read actual ATN instead)

    int lvlInOe = gpio_get_out_level(PIN_IN_OE);        // get the current output level of PIN_IN_OE
    gpio_put(PIN_IN_OE, 0);                             // enable input chip

    bool res = BIT_IS_L(PIN_ATN_MSG);                   // see if ATN is L

    gpio_put(PIN_IN_OE, lvlInOe);                       // restore previous output level of PIN_IN_OE
    gpio_set_dir(PIN_ATN_MSG, dirAtn);                  // restore directions
    gpio_put(PIN_OUT_LE2, lvlOutLe2);                   // restore previous output level of PIN_OUT_LE2

    return res;
}

// False until connected to host (scsiStartListening()), stays true then. Till then the bus is ignored: the input chip stays disabled
// and RST_CD_REQ is driven L, so the device doesn't react to the bus (e.g. floating lines without TERMPWR) before it can serve it.
static bool scsiListening = false;

// for reset / selection phases
static void setScsiPhaseForSelection(void)
{
    // don't drive control signals
    gpio_put(PIN_OUT_OE, 1);

    // LE2 back to L (transfer modes leave it H) - the latch outputs are disabled here anyway, so the ACK passed through IC203
    // can't be read in this phase; this keeps the neopixel gate (OUT_LE1 AND OUT_LE2) closed by both inputs
    gpio_put(PIN_OUT_LE2, 0);

    // SEL, RST, ATN as inputs
    gpio_set_dir_in_masked((1 << PIN_SEL_IO_DP_DS) | (1 << PIN_RST_CD_REQ_CP) | (1 << PIN_ATN_MSG));

    // SEL, RST, ATN controlled by SIO
    gpio_set_function(PIN_SEL_IO_DP_DS, GPIO_FUNC_SIO);
    gpio_set_function(PIN_RST_CD_REQ_CP, GPIO_FUNC_SIO);
    gpio_set_function(PIN_ATN_MSG, GPIO_FUNC_SIO);

    if(!scsiListening) {            // not listening yet - input chip disabled, neopixel pin L
        gpio_put(PIN_IN_OE, 1);
        gpio_put(PIN_RST_CD_REQ_CP, 0);
        gpio_set_dir(PIN_RST_CD_REQ_CP, GPIO_OUT);
        return;
    }

    // now we can enable input chip
    gpio_put(PIN_IN_OE, 0);
}

void scsiStartListening(void)
{
    scsiListening = true;
    setScsiPhaseForSelection();
}

// for most of the phases (except reset / selection)
static void setScsiPhaseForTransfer(int newPhase)
{
    gpio_put(PIN_IN_OE, 1);     // disable input chip
    gpio_put(PIN_OUT_LE2, 0);   // put LE2 to L, so changing shared phase / handshake pins doesn't put out false req out

    // I/O, C/D, MSG controlled by SIO to set these phase controls
    gpio_set_function(PIN_SEL_IO_DP_DS, GPIO_FUNC_SIO);
    gpio_set_function(PIN_RST_CD_REQ_CP, GPIO_FUNC_SIO);
    gpio_set_function(PIN_ATN_MSG, GPIO_FUNC_SIO);

    // I/O, C/D, MSG as outputs
    gpio_set_dir_out_masked((1 << PIN_SEL_IO_DP_DS) | (1 << PIN_RST_CD_REQ_CP) | (1 << PIN_ATN_MSG));

    // put DP and REQ to H, capture them in L using latch (by LE2 going to L afterwards)
    gpio_put_masked((1 << PIN_SEL_IO_DP_DS) | (1 << PIN_RST_CD_REQ_CP), (1 << PIN_SEL_IO_DP_DS) | (1 << PIN_RST_CD_REQ_CP));    // DP and REQ to H
    gpio_put(PIN_OUT_LE2, 1);       // store DP and REQ from D to Q
    busy_wait_at_least_cycles(10);
    gpio_put(PIN_OUT_LE2, 0);       // latch enable, that means hold the signals

    uint32_t bits = 0;
    switch(newPhase)
    {
        // case MODE_RESET:     // same as SELECTION
        case MODE_SCSI_SELECTION:   bits = (1 << PIN_SEL_IO_DP_DS) | (1 << PIN_RST_CD_REQ_CP) | (1 << PIN_ATN_MSG); break;
        case MODE_CMD:              bits = (1 << PIN_SEL_IO_DP_DS) |                             (1 << PIN_ATN_MSG); break;
        case MODE_MSG_OUT:          bits = (1 << PIN_SEL_IO_DP_DS)                                                 ; break;
        case MODE_DMA_READ:         bits =                            (1 << PIN_RST_CD_REQ_CP) | (1 << PIN_ATN_MSG); break;
        case MODE_DMA_WRITE:        bits = (1 << PIN_SEL_IO_DP_DS) | (1 << PIN_RST_CD_REQ_CP) | (1 << PIN_ATN_MSG); break;
        case MODE_STATUS:           bits =                                                        (1 << PIN_ATN_MSG); break;
        case MODE_MSG_IN:           bits =                                                                         0;           break;
    }

    gpio_put_masked((1 << PIN_SEL_IO_DP_DS) | (1 << PIN_RST_CD_REQ_CP) | (1 << PIN_ATN_MSG), bits);       // set the bits L or H
    gpio_put(PIN_OUT_LE1, 1);       // store I/O, C/D, MSG from D to Q
    busy_wait_at_least_cycles(10);
    gpio_put(PIN_OUT_LE1, 0);       // latch enable, that means hold the signals

    // put DP and REQ to H after using them for phase setting, but no need to latch them (no LE2 cycle)
    gpio_put_masked((1 << PIN_SEL_IO_DP_DS) | (1 << PIN_RST_CD_REQ_CP), (1 << PIN_SEL_IO_DP_DS) | (1 << PIN_RST_CD_REQ_CP));    // DP and REQ to H

    gpio_put(PIN_OUT_OE, 0);        // enable output chip
}

static void setScsiPhase(int newPhase, bool force)
{
    static int currentPhase = MODE_UNKNOWN;

    if(!force && newPhase == currentPhase) {    // no mode change? just quit
        return;
    }
    currentPhase = newPhase;

    bool driveControls = (newPhase != MODE_RESET) && (newPhase != MODE_SCSI_SELECTION);

    // for reset / selection, turn off outputs, change pins to inputs, enable input chip and quit
    if(!driveControls) {
        setScsiPhaseForSelection();
    } else {
        setScsiPhaseForTransfer(newPhase);
    }
}

static void setDataDirection(uint8_t sendNotRecv, PIO pio, uint sm)
{
    // if output from mcu, set OUT_OE to L before switching mcu pins directions
    if (sendNotRecv == DIR_SEND) {
        BIT_SET(PIN_DATA_DIR);
    }

    if(sendNotRecv == DIR_SEND) {   // outputs?
        gpio_set_dir_out_masked(SCSI_DATA_PINS_MASK);
    } else {                        // inputs!
        gpio_set_dir_in_masked(SCSI_DATA_PINS_MASK);
    }

    if(pio != NULL) {
        int dirs = (sendNotRecv == DIR_SEND) ? (SCSI_DATA_PINS_MASK | (1 << PIN_RST_CD_REQ_CP)) : (1 << PIN_RST_CD_REQ_CP);
        pio_sm_set_pins_with_mask(pio, sm, (1 << PIN_RST_CD_REQ_CP), (1 << PIN_RST_CD_REQ_CP));
        pio_sm_set_pindirs_with_mask(pio, sm, dirs, SCSI_DATA_PINS_MASK | (1 << PIN_RST_CD_REQ_CP));
    }

    int pio_data_pins[10] = {PIN_D0, PIN_D1, PIN_D2, PIN_D3, PIN_D4, PIN_D5, PIN_D6, PIN_D7, PIN_SEL_IO_DP_DS, PIN_RST_CD_REQ_CP};
    for (int i = 0; i < 10; i++) {
        if(pio != NULL) {           // got pio, pin handled by PIO
            pio_gpio_init(pio, pio_data_pins[i]);
        } else {                    // no pio, pin handled by SIO
            gpio_set_function(pio_data_pins[i], GPIO_FUNC_SIO);
        }
    }

    // if input to mcu, set OUT_OE to H after switching mcu pins directions
    if (sendNotRecv == DIR_RECV) {
        BIT_CLR(PIN_DATA_DIR);
    }
}

void scsiPioConfigAll(void)
{
    bool success;

    success = pio_claim_free_sm_and_add_program_for_gpio_range(&scsi_write_program, &pioScsiWrite, &smScsiWrite, &offsetScsiWrite, PIN_D0, 11, true);
    if(!success) { debug("Failed to claim PIO SM 1\n"); haltWithError(LED_ERR_PIO); }
    scsi_write_program_init(pioScsiWrite, smScsiWrite, offsetScsiWrite);

    success = pio_claim_free_sm_and_add_program_for_gpio_range(&scsi_read_program, &pioScsiRead, &smScsiRead, &offsetScsiRead, PIN_D0, 11, true);
    if(!success) { debug("Failed to claim PIO SM 2\n"); haltWithError(LED_ERR_PIO); }
    scsi_read_program_init(pioScsiRead, smScsiRead, offsetScsiRead);

    prefillBytesWithParityTable();
}

int scsiPioConfig(int newMode, bool force)
{
    static int currentMode = MODE_UNKNOWN;
    int oldMode = currentMode;

    if(!force && newMode == currentMode) {    // no mode change? just quit
        return oldMode;
    }
    currentMode = newMode;

    // all state machines to halt
    pio_sm_set_enabled(pioScsiWrite, smScsiWrite, false);
    pio_sm_set_enabled(pioScsiRead, smScsiRead, false);

    setScsiPhase(newMode, force);

    PIO whichPio = NULL;
    uint whichSm = 0;
    uint whichOffset = 0;

    switch(newMode)
    {
        // pasive modes (just watching bus)
        // case MODE_RESET:         // same as SELECTION
        case MODE_SCSI_SELECTION:
            break;

        // write modes
        case MODE_CMD:
        case MODE_DMA_WRITE:
        case MODE_MSG_OUT:
            whichPio = pioScsiWrite;
            whichSm = smScsiWrite;
            whichOffset = offsetScsiWrite;
            break;

        // read modes
        case MODE_DMA_READ:
        case MODE_STATUS:
        case MODE_MSG_IN:
            // readInProgressCount = 0;        // no read bytes in progress

            whichPio = pioScsiRead;
            whichSm = smScsiRead;
            whichOffset = offsetScsiRead;
            break;

        default:            // unknown mode - leave both state machines halted and release the bus, as in selection
            debug("pioConfig - unknown mode %d\n", newMode);
            setScsiPhase(MODE_SCSI_SELECTION, true);
            setDataDirection(DIR_RECV, NULL, 0);
            return oldMode;
    }

    // data direction RECV for CMD and WRITE, data direction SEND for READ and STATUS
    uint8_t sendNotRecv = (newMode == MODE_DMA_READ || newMode == MODE_STATUS || newMode == MODE_MSG_IN) ? DIR_SEND : DIR_RECV;
    setDataDirection(sendNotRecv, whichPio, whichSm);

    // if we're in the reset mode, don't enable any PIO SM
    if(newMode == MODE_RESET || newMode == MODE_SCSI_SELECTION) {
        return oldMode;
    }

    // for other modes we need to put LE2 to H, so that the DP + REQ + ACK signals are transparently passed out of device without latch
    gpio_put(PIN_OUT_LE2, 1);

    // restart state machine, clear FIFOs, enable state machine
    pio_sm_restart(whichPio, whichSm);
    pio_sm_clear_fifos(whichPio, whichSm);

    // pio_sm_restart() doesn't touch PC and X - after an aborted transfer (timeout) the program would continue where it stopped,
    // e.g. scsi_write in wait4L with REQ L and the old byte count. So jump to the start, with side-set 1 to keep REQ released.
    pio_sm_exec(whichPio, whichSm, pio_encode_jmp(whichOffset) | pio_encode_sideset(1, 1));     // .side_set 1 in scsi_write / scsi_read

    pio_sm_set_enabled(whichPio, whichSm, true);

    return oldMode;
}

uint8_t isSelectionHappening(void)
{
    if(!scsiListening) {                    // input chip disabled - SEL and RST can't be read
        return false;
    }

    scsiPioConfig(MODE_SCSI_SELECTION, false);

    if(BIT_IS_L(PIN_RST_CD_REQ_CP)) {      // no new cmd bytes when RESET is L
        return false;
    }

    return BIT_IS_L(PIN_SEL_IO_DP_DS);     // the SELECTION is happening, when SEL is L
}

// get selection byte
uint8_t getSelectionByte(void)
{
    uint8_t val;

    timeoutStart();             // start the timeout timer
    brStat = E_OK;              // init bridge status to E_OK

    while(BIT_IS_L(PIN_SEL_IO_DP_DS) && !hasTimedOut)          // while SEL pin is asserted and it's not timeout yet
    {
        uint8_t selectedIds = ((uint8_t) ~(gpio_get_all()));    // get all data bits

        for (int i = 0; i < 8; i++)
        {
            int bit = (1 << i);

            if ((selectedIds & bit) && (settings.enabledIDs & bit))    // if the bit #i set and is this ID enabled?
            {
                return i;   // return this ID
            }
        }
    }

    return 0xff;            // this device was not selected
}

// get next CMD byte from ST -- with setting INT to LOW and waiting for CS
uint8_t scsiPIO_write(void)
{
    pio_sm_put(pioScsiWrite, smScsiWrite, 0);      // write N-1 count of bytes to write here

    while(1)
    {
        if(hasTimedOut) {       // on timeout
            brStat = E_TimeOut; // set the bridge status
            return 0;
        }

        // on rx fifo has data
        if(!pio_sm_is_rx_fifo_empty(pioScsiWrite, smScsiWrite)) {
            break;
        }
    }

    uint8_t val = ((uint8_t) (pio_sm_get(pioScsiWrite, smScsiWrite) >> 24));
    val = ~val;     // invert data
    return val;
}

// send status byte to host, and on SCSI also to MSG IN byte
void scsiStatusAndMsgRead(uint8_t scsiStatusByte)
{
    // if we didn't have bridge timeout, we can try to send STATUS byte
    if (brStat != E_TimeOut)
    {
        scsiPioConfig(MODE_STATUS, false);
        PIO_read(scsiStatusByte);

        if(brStat == E_TimeOut) {
            debug("TO on STATUS\n");
        }
    }

    // if we didn't have bridge timeout, we can try to send MSG IN
    if (brStat != E_TimeOut)
    {
        scsiPioConfig(MODE_MSG_IN, false);
        PIO_read(0);

        if(brStat == E_TimeOut) {
            debug("TO on MSG_IN\n");
        }
    }

    scsiResetBridge();           // put BSY, C/D, I/O in released states
}

static void PIO_read(uint8_t val)
{
    uint32_t valPar = byteWithParity[val];
    pio_sm_put_blocking(pioScsiRead, smScsiRead, valPar);     // write status byte to TX FIFO, the transfer will start

    // wait for data to be transfered
    while(1)
    {
        if(hasTimedOut) {       // on timeout
            brStat = E_TimeOut; // set the bridge status
            return;
        }

        // nothing in TX fifo? pins idle? we're done
        if(pio_sm_is_tx_fifo_empty(pioScsiRead, smScsiRead)) {
            uint32_t allPins = gpio_get_all();

            if((allPins & SCSI_HANDSHAKE_PINS_MASK) == SCSI_HANDSHAKE_PINS_MASK) {    // both handshake pins are H?
                break;
            }
        }
    }

    brStat = E_OK;
}

void scsiDMA_read_waitForEnd(void)
{
    // wait while read is still in progress (from FIFO to Atari)
    while(1) {
        // nothing in TX fifo and handshake pins are idle? we're done
        if(pio_sm_is_tx_fifo_empty(pioScsiRead, smScsiRead)) {
            uint32_t allPins = gpio_get_all();

            if((allPins & SCSI_HANDSHAKE_PINS_MASK) == SCSI_HANDSHAKE_PINS_MASK) {    // both handshake pins are H?
                return;
            }
        }

        if(hasTimedOut) {       // on timeout
            debug("DMA_read_waitForEnd T/O\n");
            brStat = E_TimeOut; // set the bridge status
            return;
        }
    }
}

void scsiDMA_read(uint8_t val)
{
    uint32_t valPar = byteWithParity[val];

    // wait for TX fifo not full, so we can put the current value in
    while(1) {
        // READ TX FIFO not full, we can push to fifo
        if(!pio_sm_is_tx_fifo_full(pioScsiRead, smScsiRead)) {
           pio_sm_put(pioScsiRead, smScsiRead, valPar);
           return;
        }

        if(hasTimedOut) {       // on timeout
            debug("DMA_read T/O\n");
            brStat = E_TimeOut; // set the bridge status
            return;
        }
    }
}

// Like scsiDMA_read() for each byte, but in one loop running from RAM - see acsiDMA_readBlock()
void __not_in_flash_func(scsiDMA_readBlock)(const uint8_t* bfr, uint32_t cnt)
{
    // FIFO registers directly - the pio_sm_*() inline functions might end up as calls to flash with opt=Small
    PIO pio = pioScsiRead;
    io_wo_32 *txf = &pio->txf[smScsiRead];
    const uint32_t txFull = 1u << (PIO_FSTAT_TXFULL_LSB + smScsiRead);

    uint32_t i = 0;

    while(i < cnt) {
        // TX FIFO not full, we can push to fifo
        if(!(pio->fstat & txFull)) {
            *txf = byteWithParity[bfr[i]];
            i++;
            continue;
        }

        if(hasTimedOut) {       // on timeout
            debug("DMA_read T/O\n");
            brStat = E_TimeOut; // set the bridge status
            return;
        }
    }
}

void scsiDMA_write_startWithCount(uint32_t transfersCount)
{
    if(transfersCount == 0) {   // PIO program would get 0xffffffff and wait for 4 G bytes with DRQ / REQ active
        return;
    }

    pio_sm_put(pioScsiWrite, smScsiWrite, transfersCount - 1);        // write N-1 count of bytes to write here
}

uint8_t scsiDMA_write(void)
{
    while(1)
    {
        if(hasTimedOut) {       // on timeout
            brStat = E_TimeOut; // set the bridge status
            return 0;
        }

        // on rx fifo has data
        if(!pio_sm_is_rx_fifo_empty(pioScsiWrite, smScsiWrite)) {
            break;
        }
    }

    uint8_t val = ((uint8_t) (pio_sm_get(pioScsiWrite, smScsiWrite) >> 24));
    val = ~val;
    return val;
}

// Like scsiDMA_write() for each byte, but in one loop running from RAM - see acsiDMA_readBlock()
void __not_in_flash_func(scsiDMA_writeBlock)(uint8_t* bfr, uint32_t cnt)
{
    PIO pio = pioScsiWrite;
    io_ro_32 *rxf = &pio->rxf[smScsiWrite];
    const uint32_t rxEmpty = 1u << (PIO_FSTAT_RXEMPTY_LSB + smScsiWrite);

    for(uint32_t i = 0; i < cnt; i++) {
        while(pio->fstat & rxEmpty) {   // wait for byte from ST
            if(hasTimedOut) {           // on timeout
                brStat = E_TimeOut;     // set the bridge status
                return;
            }
        }

        bfr[i] = ~((uint8_t) (*rxf >> 24));     // invert data
    }
}

void scsiResetBridge(void)
{
    scsiPioConfig(MODE_SCSI_SELECTION, true);
    brStat = E_OK; // set bridge status to OK
}


// SCSI neopixel: IC6 = OUT_LE1 (data) AND OUT_LE2 (gate). The rest of the firmware never has both H - LE1 is pulsed only with
// LE2 L (setScsiPhaseForTransfer()), LE2 is H only in transfer modes with LE1 L, and both are L between commands. So the frame is
// sent between commands: LE2 H opens the gate, LE1 sends the reset + bits + latch time, LE2 L closes the gate. The latches are
// transparent meanwhile and catch garbage, but their outputs are disabled (OUT_OE H) and setScsiPhaseForTransfer() latches
// everything again before enabling them. The bus pins and the input chip aren't touched, but the bus isn't watched meanwhile
// (~1 ms), a SEL from the initiator just waits for us (selection timeout is 250 ms). Doesn't use the PIO, so it works also
// when halted on failed PIO setup.
void scsiNeopixelOutput(uint32_t grb)
{
    gpio_put(PIN_OUT_OE, 1);                    // latch outputs disabled (already are between commands)
    gpio_put(PIN_OUT_LE1, 0);                   // data L
    gpio_put(PIN_OUT_LE2, 1);                   // open the gate - data is L already
    sleep_us(NEOPIXEL_RESET_US);                // reset before the frame

    neopixelSendFrame(PIN_OUT_LE1, grb);

    sleep_us(NEOPIXEL_RESET_US);                // keep L, so the neopixel latches the new color
    gpio_put(PIN_OUT_LE2, 0);                   // close the gate while the data is still L
}
