atarijookie/cosmo2ex/(commit log)

2026-10-14 chipinterface: fix socket, stream-sync and timing bugs from review - sockets: select() timeout, partial sends, bind/listen failure -> exit 1, drop SO_REUSEPORT, CLOEXEC; reset reader on disconnect, c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
2026-10-15 couple of fixes to main, other instance checks, etc.
2026-10-16 added devices hw into repo (they are not finished yet)
2026-10-16 added container for building arduino pico firmwares and also building the firmwares
2026-10-16 pico tests and fixes
2026-10-18 Phase 1 — Portable IPC (do on Linux first)
2026-10-18 Phase 2 — Get rid of hardcoded paths and shell commands
2026-10-19 Phase 3 — #ifdef the Linux-only features + libudev for hid in ikbd
2026-10-19 Phase 4 — Cygwin build of ce_cores
2026-10-19 Phase 5 — macOS build
2026-10-21 pcb tidying up
2026-10-22 created merged hdd code for both acsi and scsi, now with neopixel led
2026-10-22 ce_pico_fdd ported from ms vsc to arduino env
2026-10-23 added using of pico display with buttons
2026-10-23 added pico based display with buttons
2026-10-23 updates to beeper - now on main fdd board, updates to panel connectors
2026-10-23 changed button, added neopixel to fdd
2026-10-24 floppy image browsing and inserting from device
2026-10-26 added display version with encoder instead of buttons
2026-10-26 added support for setting the display orientation upside down by 10s press of button
2026-10-28 webserver shows not connected devices as gray, device status updated immediatelly after connect
2026-10-28 added log level setting via web, deleting device settings, fixed windows build to at least do something, added windows cross-build from linux
2026-10-31 on SCSI the neopixel uses different pico pins
2026-10-31 hdd pcb has now different led connections for scsi and for acsi
2026-10-31 fix for TT DMA not aligned to longword - was causing crashes. also private supervisor stack in custom gemdos and bios functions
2026-11-02 SLM printer support into ACSI version of HDD
2026-11-02 SLM printouts now visible via browser
2026-11-02 grab mouse in web now forwards wheel up/down, shows button pressed
2026-11-02 modifications to ethernet library, so that the socket 0 stays free (only that one is for MACRAW)
2026-11-02 added STiNG driver (STX) for cosmo2ex
2026-11-03 renamed driver folder, removed .st and .zip, updated documentation
2026-11-06 added mintnet xif driver for cosmo2ex
2026-11-07 pico fdd - Arduino port cleanup, USB removed, captive portal can be quit without saving, captive portal button does beep after a second so user knows when to let go
2026-11-09 new data format between cores and pico_fdd. Added ce_floppy_gen to create test images of different geometries. Webserver can now create and insert empty floppy image.
2026-11-09 android app for floppy switching added, also added remote input page into fdd device web
2026-11-09 pico_display shows message at start, turns neopixel led to green when init ok
2026-11-09 added built-in floppy image that shows status of floppy device when floppy not read yet
2026-11-10 displayadded pcb for hub
2026-11-12 added 3D cases for fdd and hdd devices
2026-11-14 READY / RUNNING state on devices, shown by shining LED, now can be configured via web
